giandcdalcorso11-coder/GDC-CNC-2D/documento-sessione-cnc-2d.md

# Documento di Sessione — CNC 2D Plotter

**Versione:** 115
**Ultimo aggiornamento:** 2026-11-14 15:02

## Regole di co-editing

Questo documento è scritto da **tre sessioni Claude Code in parallelo**: una sul fronte **meccanica/firmware**, una sul fronte **contenuti e serie social**, e (dal 2026-10-29) una sul fronte **stampe: i disegni e i file SVG che l'utente manda in stampa** (magneti della lavagna d'allenamento, per ora). Ogni sessione può lavorare sul proprio branch: la regola vale comunque, perché le voci si fondono. Per non perdere voci a vicenda:

1. **`git fetch` e rebase prima di scrivere, push subito dopo.** Non lasciare modifiche locali non pushate: la finestra di collisione è tutta lì.
2. **Marca la voce di storico con il fronte di lavoro**, es. `### [2026-09-26 17:48] (meccanica) …`; il fronte della terza sessione è `(stampe)`. Due sessioni diverse sono due voci diverse: la regola "una voce per sessione" non impone di fonderle.
3. **Le note dei singoli Step si appendono in fondo al proprio Step**, quindi non collidono mai finché le due sessioni lavorano su Step diversi.
4. **Se la Versione va in conflitto**, chi risolve mette `max(A, B) + 1` e tiene **entrambe** le voci, ordinate per data decrescente. Mai scartarne una.
5. Gli unici punti di contesa reali sono **le due righe di testata** e **la prima riga dopo `## Storico sessioni`**. Tutto il resto è partizionato per costruzione.

## Vision

Macchina CNC 2D per disegno/plotter, con:
- Assi X/Y motorizzati (NEMA17 modello 17HS4023 + driver A4988)
- Asse Z tramite servomotore per alzare/abbassare la penna
- Controllo firmware via ESP32 con FluidNC
- Invio G-code via Wi-Fi (WebUI di FluidNC), senza necessità di cavo USB durante il disegno
- In prospettiva, un software "stile slicer" per convertire SVG/immagini in G-code e caricarlo sulla macchina

## Pipeline

### Convenzioni valide per tutta la pipeline

**Nomi degli assi (dal 2026-10-15).** Secondo la convenzione cartesiana del
foglio, decisa dall'utente:

| Asse | Che cosa è | Sul foglio | Staffa | Motore |
|---|---|---|---|---|
| **X** | la trave del portale: ci corre sopra il carrello che porta la penna | sinistra → destra | staffa LL, 550 | **STEP D4 · DIR D26** |
| **Y** | le due rotaie di base: ci scorre sopra tutto il portale | basso → alto | staffe TT, 2 × 400 | **STEP D25 · DIR D33** |

**I pin in questa tabella sono stati corretti il 2026-10-19**, e prima di quella
data erano scambiati: vedi la nota in Step 2. I *nomi* e il loro significato
fisico non sono cambiati — la trave è sempre stata X — era sbagliato solo
l'abbinamento ai pin. Verifica a vista, se un giorno tornasse il dubbio:
**un movimento su X muove il carrello lungo la trave, non tutto il portale.**

**Attenzione leggendo il resto del documento:** tutte le voci dello storico e
tutte le note anteriori al 2026-10-15 usano la nomenclatura precedente, in cui
X e Y erano **scambiati** rispetto a questa tabella. Non sono state riscritte —
le voci passate non si toccano. Quando una nota vecchia dice "corsa X 242,475"
intende la corsa del portale sulle rotaie di base, che oggi si chiama Y.

**Nomi delle staffe (dal 2026-10-12).** **Staffa TT** = le due rotaie da 400.
**Staffa LL** = la trave del portale da 550.

**Nomi delle due applicazioni (dal 2026-10-15).** Il progetto ne ha due, con
ruoli diversi, e non si sostituiscono a vicenda:

- **GDC CNC 2D SLICER** — l'applicazione vera: la webapp dello Step 4 (`webui/`)
  più la configurazione FluidNC che la esegue (`firmware/fluidnc/`). Importa il
  disegno, genera il G-code, comanda la macchina
- **Pannello di controllo manuale GDC CNC 2D** — lo strumento di collaudo dello
  Step 1.1 (`firmware/cnc2d_dashboard/`): frecce, un giro di pignone, slider del
  servo, log, OTA. Serve a montare e diagnosticare, non a disegnare

La cartella e il file dello sketch restano `cnc2d_dashboard`: l'IDE Arduino
esige che cartella e sketch abbiano lo stesso nome e non accetta spazi, quindi
il nome esteso vive nel titolo della pagina e nei README, non nel filesystem.

**Come si provano i controlli (dal 2026-11-02).** *Un controllo va provato
rompendo il codice di proposito.* Se mutando la riga che quel controllo
dovrebbe proteggere il controllo non si accende, non è un controllo: è una
decorazione, e si scopre il giorno in cui serviva. Lo strumento è
`webui/tools/rompi.py`, che muta un sorgente per volta, ricompone la pagina,
lancia il collaudo e pretende la riga KO giusta. La regola si è precisata tre
volte, e le tre precisazioni valgono quanto la regola:

- **[2026-11-03] Anche le mutazioni invecchiano.** Quando il difetto che una
  mutazione simulava diventa il comportamento giusto, si *toglie* la mutazione
  e se ne scrive una che rompe la cosa nuova. Non si piega il controllo.
- **[2026-11-07] Una mutazione può toccare più punti.** Quando la cosa da
  rompere è difesa in due posti che devono dire la stessa cosa, romperne uno
  solo lascia il programma corretto: simula un difetto che non è un difetto.
- **[2026-11-07] Una mutazione che non può cambiare il comportamento misura
  sé stessa, non il controllo.** Due casi visti: un difetto non raggiungibile
  (si toglie la mutazione e si scrive nel codice *perché* quella riga resta
  com'è), e un banco che non può vedere la differenza — il vetro finto del
  telecomando disegna blocchi al posto delle lettere, quindi «3» e «4» sono
  identici per costruzione, e quello che lì si può guardare è la larghezza.
- **[2026-11-08] Anche un controllo può passare guardando la cosa
  sbagliata**, ed è l'altra metà della regola: una mutazione non vista
  accusa il controllo, non sempre sé stessa. Tre casi nello stesso giorno, e
  tutti e tre davano la risposta giusta **per caso**. *Il testo che compare
  due volte:* il controllo cercava «un foglio 210 × 297 mm» in un messaggio
  che scrive la misura in due frasi, quindi passava anche cancellandone una
  — si cerca la frase intera. *La scena che si appoggia a un avanzo:* il
  disegno stava sul PRIMO foglio, e il ripiego del codice rotto era proprio
  l'angolo del primo — si sposta la scena sul secondo. *La scena dove il
  difetto non può manifestarsi:* due livelli su fogli diversi, dove la
  selezione si sostituisce comunque, quindi anche il codice rotto rispondeva
  «uno» — servono due livelli dello stesso foglio. E una quarta, sull'altro
  versante: **riscrivere l'ancora di una mutazione può svuotarla**. Quando il
  codice intorno cambia, l'ancora va rimirata sullo *stesso difetto*, non
  sulla riga più somigliante.
- **[2026-11-14] Il gesto che si prova può riparare il difetto mentre lo
  prova.** Un doppio clic sono due clic, e il PRIMO cambia lo stato: cliccando
  un foglio lo si rende quello in uso, quindi al momento della mira il foglio
  in uso *era* diventato quello del disegno e i due sistemi di riferimento
  tornavano a coincidere — la mutazione che rimetteva il difetto restava non
  vista. La scena giusta vuole il foglio del disegno **misurato**, cioè fermo,
  così il clic non lo rende quello in uso. Vale per ogni gesto composto: prima
  di scrivere la scena, chiedersi che cosa cambia il primo pezzo del gesto.
- **[2026-11-14] Una mutazione va puntata sul controllo che PUÒ vederla**, e
  non sul controllo che parla della stessa cosa. Due su tre, lo stesso giorno:
  quella sul conteggio a mano dei due clic guardava la scena del foglio
  misurato, dove il `dblclick` vero arriva comunque; quella sul guardiano
  guardava una scena con un disegno solo, dove girare «al livello di sotto»
  torna sullo stesso livello. Entrambe dicevano «non vista» accusando il
  controllo, ed entrambe avevano ragione: era l'abbinamento a essere sbagliato.
  Quando una mutazione non si vede, la prima domanda non è «il controllo è
  cieco?» ma «questa scena può manifestare questo difetto?».

**Il repository GitHub si chiama `GDC-CNC-2D`** (rinominato dall'utente il
2026-10-15; GitHub non accetta spazi nei nomi e li sostituisce con trattini).
Non ha rotto nessun link: GitHub Pages non è attivo su questo repository,
l'applicazione è servita dall'ESP32 sulla rete locale, e GitHub redirige
automaticamente il vecchio URL. L'unico modo di rompere la redirezione è
creare un giorno un altro repository chiamato `CNC-2D` sullo stesso account.

### Step 1 — Bring-up alimentazione e logica ESP32

**Stato:** completato

**Obiettivo:** ESP32 funzionante e alimentabile sia da USB che da batteria, con GPIO verificati

**Decisioni progettuali:**
- Ramo alimentazione logica (5V, ESP32) separato dal ramo 24V dei motori
- **Una spina sola per tutta la macchina: 12 V / 3 A, due 7805 indipendenti.** Supera sia il ramo a 24 V sia la batteria 18650. Il mattone (DVE DSA-36W-12, 36 W) alimenta direttamente i VMOT dei due driver e, attraverso **due L7805CV separati**, il 5 V della logica e il 5 V del servo. Il punto non è il numero di regolatori: è che **i due 5 V non si possono tirare giù a vicenda**, perché ciascuno ha 7 V di margine e oltre 60 dB di reiezione. Un interruttore unico sui 12 V, a monte di tutto. Bilancio: picco ~2,15 A sui 3 A disponibili. **Alternative scartate:** un solo regolatore condiviso (è la configurazione che ha causato il brownout del servo); uno switching LM2596 (più efficiente e sarà l'upgrade, ma non ce l'aveva e due lineari separati sono elettricamente più puliti di uno switching condiviso); alimentazione separata del servo da una seconda presa, rifiutata dall'utente — una macchina si accende con una spina
- **Il 18650 e il modulo di ricarica escono dal progetto.** Hanno fatto il loro lavoro nel bring-up dei LED. Per motori e servo non reggono: il modulo dà ~1 A dichiarato con protezione che interviene prima, mentre il solo servo chiede 700 mA di spunto (1,4 A per un MG90S) e il boost ne tira 1,6 dalla cella per darne 1 in uscita
- **La breadboard resta il circuito definitivo, ma solo per i segnali.** Decisione dell'utente, con tre eccezioni concordate: i due 7805 coi loro condensatori vanno su millefori saldata (sono la parte più calda e con più corrente, e non cambieranno mai più); il ramo 12 V di potenza va su morsetti a vite (un contatto di breadboard è dato per ~1 A e lì ne passano fino a 2); la breadboard va fissata meccanicamente e i cavi ancorati con fascette. Il motivo delle eccezioni è la vibrazione: il portale accelera a 0,3 g sulla stessa tavola, e un contatto a frizione che diventa intermittente sulla linea STEP dà **passi persi**, cioè un difetto che si va a cercare nella meccanica dove non c'è
- Batteria 18650 + modulo boost/carica 5V Type-C (supporta "discharge while charging", quindi utilizzabile anche mentre è in carica)
- Interruttore SPST inserito solo sulla linea 5V+ verso il pin VIN dell'ESP32 (non sulla batteria), per non interrompere la ricarica quando la macchina è spenta
- GND comune tra guida breadboard, modulo batteria ed ESP32, verificato in continuità

**Criterio di completamento:** LED collegato a D2 lampeggia correttamente sia alimentato da USB sia da batteria+interruttore

**Note (cronologia dello step):**
- [2026-09-19] Verificati componenti hardware (batteria NASTIMA 12V, motori 17HS4023, driver A4988, alimentatore 24V riciclato da striscia LED) tramite confronto con i link Amazon e datasheet
- [2026-09-19] Test ESP32 standalone via USB-C con sketch Blink su D2 (GPIO2) e resistenza 220 ohm — riuscito
- [2026-09-19] Aggiunto modulo batteria 18650 (boost 5V + carica Type-C) e interruttore sulla linea 5V+ verso VIN — testato e funzionante
- [2026-09-26] **L'alimentatore non è più il 24 V recuperato dalla striscia LED**, ma un DVE DSA-36W-12: **12 V, 3 A, 36 W**. Supera il dato del 2026-09-19. Nota importante sulle conseguenze: a corrente impostata uguale, **la tensione di alimentazione non cambia né la coppia né la temperatura dei motori**, perché l'A4988 è un driver a corrente controllata — la tensione decide solo quanto in fretta la corrente sale, quindi conta alle alte velocità. Bilancio a 12 V con tre motori a 0,6 A: 0,28 A ciascuno, 0,85 A in totale, ~14 W su 36 disponibili (28% della corrente). L'unico punto in cui i 12 V stringono è il collegamento di due motori in serie su un solo driver: 6,0 V dei 12 se ne vanno fra caduta resistiva, induttanza e forza controelettromotrice, contro i 3,0 V di un motore per driver

#### Step 1.1 — Dashboard web di controllo e test

**Stato:** completato

**Obiettivo:** dashboard web autonoma ospitata direttamente sull'ESP32, raggiungibile dalla rete Wi-Fi di casa, con un controllo di test sul LED e configurazione Wi-Fi senza dover ricompilare/riflashare

**Decisioni progettuali:**
- Web server nativo (`WebServer.h`, incluso nel core ESP32) invece di `ESPAsyncWebServer`, per non richiedere librerie esterne da installare
- Credenziali Wi-Fi salvate in NVS (`Preferences`) e configurabili da una tab dedicata nella dashboard; fallback automatico ad Access Point di emergenza (`CNC-2D-Setup`) se la connessione alla rete salvata fallisce, così la pagina resta sempre raggiungibile per correggerle
- mDNS (`cnc2d.local`) per raggiungere la dashboard senza dipendere dall'IP assegnato dal router
- Frecce direzionali presenti in UI ma non collegate a nessuna funzione, in previsione del controllo assi X/Y (Step 2)
- Tab "Codice" lasciata come placeholder: in futuro servirà per caricare direttamente un file G-code dal browser (non per compilare sketch — l'ESP32 non può compilare C++ da solo), da attivare dopo aver validato motori (Step 2) e servo/pen-lift (Step 3)

**Criterio di completamento:** dashboard raggiungibile da browser sulla rete di casa, pulsante centrale che accende/spegne il LED su D2 in tempo reale, funzionamento verificato sia con ESP32 alimentato da USB sia da batteria+interruttore

**Note (cronologia dello step):**
- [2026-09-19] Implementato sketch `firmware/cnc2d_dashboard/cnc2d_dashboard.ino` con web server, pagina a 3 tab (Controllo, Wi-Fi, Codice), salvataggio credenziali Wi-Fi su NVS e fallback ad AP di emergenza
- [2026-09-19] Bug: errore di compilazione "unterminated raw string" — causato da copia-incolla manuale del codice in un nuovo sketch anziché apertura diretta del file `.ino`, con probabile perdita dell'ultima riga di chiusura della stringa raw; risolto scaricando il file raw direttamente da GitHub
- [2026-09-19] Test completo riuscito: provisioning Wi-Fi di casa dalla tab dedicata, dashboard raggiungibile su `http://cnc2d.local`, LED su D2 controllato correttamente sia da alimentazione USB sia da batteria 18650+interruttore
- [2026-09-20] Aggiunti alla dashboard: 2 nuovi LED di stato (verde su D18, giallo su D19) con pulsanti dedicati Rosso/Giallo/Verde sotto le frecce (il pulsante centrale del joystick è stato disabilitato, non usa più il LED); supporto ArduinoOTA per aggiornare il firmware via Wi-Fi dopo il primo upload USB; tab "Log" che mostra in tempo reale gli stessi messaggi del Serial Monitor (utile perché il Serial Monitor via USB non è più disponibile quando si aggiorna via OTA)
- [2026-09-20] Frecce sinistra/destra collegate al motore X (STEP/DIR/ENABLE): click singolo = un passo, pressione prolungata = rotazione continua non bloccante; aggiunti pulsanti "Giro completo ←/→" (200 passi) per test rapido — dettagli del cablaggio e del debug nello Step 2
- [2026-09-20] Rifattorizzato il motore della dashboard: il movimento non è più eseguito dentro l'handler HTTP (che bloccava per 3 secondi affamando `server.handleClient()` e l'OTA) ma da una coda di passi servita in `loop()`, prima e dopo `handleClient()`; DIR impostato una sola volta a inizio movimento con tempo di assestamento invece che a ogni impulso; aggiunta rampa di accelerazione opzionale sui primi 40 passi
- [2026-09-20] Aggiunta tab "Motore": intervallo tra i passi regolabile da browser (300 µs – 200 ms), numero di passi, rampa on/off, abilitazione diretta del driver e sezione "Test pin" che forza STEP/DIR/EN a un livello fisso per poterli misurare col multimetro. Ogni movimento registra nel log i passi effettivamente emessi, così si distingue subito un problema firmware da uno elettrico
- [2026-10-12] **Bug: il servo non si muove e la scheda si spegne**
  **Sintomo:** a ogni comando del servo il LED rosso dell'ESP32 e quello del modulo di ricarica si spegnevano per un istante; il servo non si muoveva affatto. I LED comandati dalla dashboard funzionavano, quindi scheda e rete erano sane. Con l'ESP32 spostato su alimentatore da muro il sintomo cambiava: la scheda restava accesa, il servo **vibrava** e i LED del modulo batteria lampeggiavano in continuazione
  **Causa:** il servo e la logica condividevano il 5 V del modulo 18650. Lo spunto del servo (700 mA, 1,4 A per un MG90S) faceva collassare quel ramo; l'ESP32 andava in brownout e, resettandosi, smetteva di generare il PWM — quindi il servo non arrivava mai in posizione. Nella seconda configurazione il collasso restava sul solo ramo servo e si vedeva per quello che era: **protezione che scatta e riparte in ciclo** (*hiccup mode*), con il servo alimentato a singhiozzo
  **Fix applicato:** due L7805CV separati dai 12 V, uno per la logica e uno per il servo. **Confermato dall'utente: tutti i test passano.** Il percorso diagnostico è costato due giorni perché l'alimentazione era stata classificata come causa poco probabile (vedi voce di storico del 2026-10-13)
- [2026-10-13] **Mancano i condensatori ceramici e per ora si va avanti così.** Montati solo gli elettrolitici. Funziona, ma l'elettrolitico alle alte frequenze non c'è: senza un ceramico vicino ai piedini il 7805 può oscillare nei MHz, e il sintomo non è un guasto netto — è riscaldamento inspiegabile, rumore sul 5 V, qualche reset a caso. Da aggiungere: **100 nF su IN e su OUT di ogni regolatore**, più uno in parallelo ai 100 µF sul VMOT di ogni driver

### Step 2 — Bring-up driver A4988 e motori (X/Y)

**Stato:** completato

**Obiettivo:** un motore NEMA17 pilotato correttamente da un driver A4988 tramite ESP32, poi due motori in parallelo

**Decisioni progettuali:**
- Vref target ~0.5-0.56V per 0.7A per fase (corrente nominale reale del 17HS4023, non 1.0A come inizialmente indicato da una fonte esterna consultata)
- Alimentazione di potenza: alimentatore switching DC **12V/3A** (DVE DSA-36W-12). Sostituisce l'alimentatore riciclato dalla striscia LED RGB, che si è rivelato inutilizzabile (vedi bug sotto). 12V sono ampiamente sufficienti per il plotter e fanno scaldare molto meno il driver rispetto a 24V
- **Condensatore elettrolitico 100 µF / 50 V obbligatorio tra VMOT e GND del driver**, il più vicino possibile al modulo: senza, i picchi induttivi generati dalle bobine a ogni commutazione distruggono l'A4988 (è la causa della perdita dei primi due moduli)
- Collaudo di accettazione di ogni nuovo modulo A4988 prima di alimentarlo: continuità tra STEP, DIR, EN e GND deve essere **muta** su tutti e tre. Venti secondi che smascherano subito un ingresso in corto
- Pin driver: STEP su D4, DIR su D26 (era D16), ENABLE su D27 (era D17) — spostati da D16/D17 per un problema di instabilità non ancora confermato con certezza (vedi bug nello storico sessioni)
- Bobine motore identificate via continuità: bobina 1 = fili rosso+blu, bobina 2 = fili nero+verde; mappate sul driver rispettivamente su 1A/1B e 2A/2B (l'assegnazione "1"/"2" rispetto ai colori è invertita rispetto al primo tentativo ma elettricamente corretta, non causa malfunzionamenti — cambia solo il verso di rotazione)
- Alimentatore 24V riciclato da striscia LED RGB: verificato con multimetro che il filo bianco è il vero 24V+ e il filo rosso è il GND (contro-intuitivo rispetto al colore); i fili blu e verde sono ridondanti (stesso nodo del bianco) e isolati, non utilizzati
- Scheda "Nano Terminal Adapter" (pensata per Arduino Nano) riadattata come morsettiera generica per i collegamenti di potenza (24V e fili motore), sfruttando il fatto che è puramente passiva (screw terminal + header pin sullo stesso nodo) — alternativa scartata: morsetti a vite dedicati, non disponibili al momento
- Velocità di step di partenza volutamente prudente (senza rampa di accelerazione) per il primo test, da aumentare più avanti con una rampa vera

**Criterio di completamento:** rotazione controllata e affidabile di entrambi i motori tramite comandi step/dir dall'ESP32

**Note (cronologia dello step):**
- [2026-09-20] Cablaggio completo del driver A4988 (logica + potenza) e del motore X, con verifica pin ENABLE tramite conteggio sull'etichettatura reale del modulo (foto)
- [2026-09-20] Bug: primo driver A4988 non muoveva il motore
  Sintomo: nessuna reazione del motore a "Giro completo" né alle frecce, solo un leggero ronzio; bloccato con forza al tatto (normale per uno stepper abilitato, non diagnostico da solo)
  Causa: sospetto danneggiamento del chip driver (probabile durante le prove di cablaggio in tensione) — tutti i controlli di continuità su STEP/DIR/ENABLE/VDD/RESET-SLEEP/VMOT/GND risultati corretti
  Fix applicato: sostituito con un secondo modulo A4988 di scorta — con il nuovo modulo il motore ha iniziato a muoversi (parzialmente), confermando che il primo era guasto
- [2026-09-20] Bug: Vref bloccato a 0,20V sul secondo modulo, il potenziometro sembrava non avere effetto
  Sintomo: valore instabile e comunque fermo a 0,20V (target 0,50–0,56V) girando il trimmer
  Causa: misura instabile a causa del motore collegato durante la prova (rumore/carico sul riferimento)
  Fix applicato: misurato Vref a motore scollegato — tarato correttamente a 0,55V
- [2026-09-20] Bug: il motore gira solo con passi singoli, non con pressione prolungata né con "Giro completo"
  Sintomo: ogni click singolo produce un piccolo movimento pulito senza perdere passi; in sequenza continua il motore non si muove (con solo un leggero ronzio) oppure avanza a scatti di circa 1/5 di giro senza completare la rotazione
  Causa: individuata con un test del "wiggle" — muovendo il filo che collega ENABLE (D17) durante il funzionamento, il motore si mette a girare; il problema persiste anche sostituendo il filo con uno nuovo o cambiando i fori della breadboard, e la continuità elettrica su quel filo risulta comunque corretta a riposo. Causa non ancora confermata con certezza: si sospetta un comportamento specifico dei pin GPIO16/GPIO17 (usati per DIR/ENABLE), che su alcune varianti di modulo ESP32 con PSRAM (WROVER) sono riservati e non utilizzabili come GPIO liberi — dalla foto del modulo (etichettato solo "ESP-32", nessuna scritta "WROVER" visibile) non è stato possibile confermare con certezza se questo sia il caso
  Fix applicato: non ancora confermato — spostati DIR (D16→D26) ed ENABLE (D17→D27) su pin sicuramente liberi da questo vincolo su qualunque variante ESP32; il test dopo lo spostamento non è ancora stato riportato a fine sessione — **da riprendere nella prossima sessione**
- [2026-09-20] Il bug sopra è stato **risolto**: lo spostamento su D26/D27 non c'entrava nulla e l'ipotesi PSRAM/WROVER era sbagliata. La causa reale era l'alimentatore di potenza (vedi bug successivo). I pin sono stati comunque lasciati su D26/D27, che vanno benissimo
- [2026-09-20] Bug: alimentatore di potenza inutilizzabile — **causa radice di tutta la sessione**
  Sintomo: tensione su VMOT del driver oscillante tra 1 V e 20 V invece che ferma; coppia di tenuta debolissima (l'albero si girava con due dita, mentre a 0,69 A/fase dovrebbe essere immobile); passi singoli occasionalmente corretti, rotazione continua mai
  Causa: l'alimentatore riciclato è un **controller per strisce LED RGB**, non un alimentatore DC. Dei 4 fili, il bianco è il +24V comune e rosso/verde/blu sono le tre uscite di canale, cioè MOSFET pilotati in PWM. Usare il filo rosso come massa significava alimentare il driver attraverso un interruttore che si apriva e chiudeva continuamente. Verificato misurando sotto carico su tutti e tre i canali: instabili tutti
  Fix applicato: sostituito con un alimentatore switching DC 12V/3A, misurato stabile a 12,2 V. **Confermato**
- [2026-09-20] Bug: secondo driver A4988 con ingresso STEP in corto verso massa
  Sintomo: dopo aver risolto l'alimentazione, l'albero era finalmente duro e il test ENABLE rispondeva, ma nessun comando produceva movimento e il motore restava in silenzio assoluto. Misurando il pin STEP sul driver si leggeva sempre 0 V pur avendo continuità verso D4
  Causa: individuata dividendo il nodo STEP in due metà e misurandole separatamente — lato ESP32 muto (GPIO4 sano), lato driver in corto a 0,2 Ω, e sfilando il modulo la breadboard tornava muta. L'ingresso STEP era quindi in corto **dentro il chip**, inchiodato a 0 V. Danno provocato dallo stesso alimentatore RGB
  Fix applicato: sostituito con il terzo modulo A4988, collaudato prima dell'installazione con il test di continuità STEP/DIR/EN verso GND. **Confermato**
- [2026-09-20] Motore X funzionante: Vref tarato a 0,54 V sul nuovo modulo, test ENABLE corretto (albero bloccato con spunta, libero senza) e movimento comandato dalla dashboard riuscito
- [2026-09-21] Sweep di velocità completato su tutta la gamma disponibile fino a 500 passi/s: nessuna banda di risonanza, nessun microstepping necessario per la stabilità
- [2026-09-21] Secondo asse cablato: driver Y con STEP su D25 e DIR su D33, ENABLE condiviso con X su D27. Al primo avvio il motore Y girava da solo senza controllo — causa: D25/D33 non erano ancora configurati come uscite nel firmware e, restando ingressi flottanti, raccoglievano rumore che il driver interpretava come impulsi di STEP. Risolto portando i pin STEP a livello basso come prima istruzione di `setup()`
- [2026-09-21] **Step chiuso:** entrambi gli assi pilotati correttamente, singolarmente e in contemporanea
- [2026-10-12] **Microstep confermati 1/16 da un dato dell'utente**, non più per ipotesi: MS1, MS2 e MS3 sono ponticellati insieme e portati a VCC, e sulla tabella dell'A4988 tutti e tre alti = sedicesimo di passo. Quindi **33,953 passi/mm** è il numero vero, e il default della dashboard era già giusto
- [2026-10-12] **Dashboard riscritta per la trasmissione reale.** Tre cambiamenti strutturali: (a) i passi non escono più da `loop()` ma da un **timer hardware a 20 kHz** con accumulatore a virgola fissa — con i microstep attivi la frequenza sale a qualche migliaio di impulsi al secondo e `server.handleClient()` può bloccare il loop per centinaia di millisecondi, cioè buchi nel treno di impulsi; (b) l'interfaccia parla in **millimetri** (velocità 1÷100 mm/s, distanza in mm) invece che in passi, e il pulsante "360°" diventa "1 giro" = 94,2478 mm calcolati dai microstep impostati; (c) due pulsanti eseguono **quadrato da 40 mm e cerchio R20** come macchina a stati non bloccante, movimenti di penna compresi, replicando i file in `gcode/test/`. Aggiunto anche uno slider dell'angolo servo dal vivo nella tab Controllo
- [2026-10-12] **Bug: lo sketch non compila, "variable or field 'setDir' declared void"**
  **Sintomo:** errori a catena su tutte le funzioni che prendono `Motor&` o `DemoStep&`, indicando righe di definizione scritte correttamente e con la struct dichiarata cinquanta righe più su
  **Causa:** l'IDE Arduino genera da solo i prototipi di tutte le funzioni e li inserisce **subito prima della prima funzione del file**, con una direttiva `#line` che fa riportare l'errore alla riga della definizione originale. Spostando le costanti della trasmissione in cima, la prima funzione era diventata `stepsPerMm()`, che sta sopra `struct Motor`: i prototipi generati nominavano un tipo non ancora dichiarato. Nelle versioni precedenti funzionava **per caso**, perché la prima funzione era `logMsg()`, che sta sotto la struct
  **Fix applicato:** `Motor` e `DemoStep` spostate in una sezione "Tipi" in cima al file, prima di qualunque funzione, col commento che spiega perché non stanno vicino al codice che le usa. **Confermato: compila e gira.** Il controllo di sintassi fatto qui con g++ non poteva vedere l'errore per costruzione, perché g++ non inietta prototipi — il controllo è stato esteso emulando quel passaggio, e validato al contrario facendogli riprodurre l'errore sulla versione vecchia
- [2026-10-12] **Rampa del servo in firmware** (`servoGoTo` + `serviceServo`): invece di saltare all'angolo richiesto il servo ci arriva di N gradi ogni 10 ms, con N impostabile da 0 (salto secco) a 10. Serve contro il brownout — un servo che vede un errore grande parte alla corrente di stallo — ma **non sostituisce l'alimentazione**: abbassa il picco, non il consumo totale. Come diagnosi era decisiva, come cura no, ed è andata così. Le prove d'insieme ora aspettano che la penna sia **arrivata** invece di un ritardo fisso
- [2026-10-19] **BUG MIO: i pin dei due assi erano scambiati dal 2026-10-15, e l'ho scoperto solo perché l'utente ha provato le frecce.**

  **Sintomo:** con la pulsantiera della dashboard, le frecce destra/sinistra muovevano la testina **in alto e in basso** sul foglio, e le frecce su/giù la muovevano **a destra e sinistra**. La mappatura tastiera→asse è giusta (←→ chiamano `x`, ↑↓ chiamano `y`): sbagliato era quale motore fosse `x`.
  **Causa:** il 2026-10-15, applicando il rinominamento degli assi chiesto dall'utente, ho scambiato i quattro `#define` dei pin. Ma andavano sistemati i **nomi**, non l'abbinamento nome↔pin, che era già giusto. All'origine c'è una mia descrizione sbagliata: avevo scritto che "il driver su GPIO 4/26 è quello del portale e quello su 25/33 è quello della trave", quando è il contrario, e poi ho "corretto" i pin per farli combaciare con la descrizione sbagliata. L'utente me l'aveva anche detto, nello stesso messaggio del 2026-10-15: *"non è necessario che cambi nulla nel firmware vecchio, le 4 frecce spostano i carrelli nella direzione corretta"*. Non ne ho tenuto conto.
  **Fix applicato:** `STEP_X_PIN`/`DIR_X_PIN` tornano a D4/D26 e `STEP_Y_PIN`/`DIR_Y_PIN` a D25/D33, nella dashboard, in `cnc2d-config.yaml` e nelle etichette dell'interfaccia. Corretta anche la tabella delle convenzioni in cima a questo documento. **Verificato che compila, non ancora provato sulla macchina**: la conferma è che la freccia destra muova il carrello lungo la trave.
  **Nota sul tempismo:** le chiavi NVS (`invX`, `feedX`, `rampX`, `mmRevX`…) sono legate al **nome** dell'asse, quindi questo scambio le ri-punta sull'altro motore. Capita nel momento più economico possibile — niente è ancora tarato e i due assi hanno gli stessi valori di default — ma dopo il flash vanno ricontrollate le spunte "inverti direzione" e le velocità per asse.

- [2026-10-19] **La dashboard misura: posizione per asse e taratura del rapporto per asse.** Due aggiunte, chieste dall'utente per poter fare le misure degli assi **oggi**, senza aspettare il modulo penna — osservazione sua e giusta: i pignoni sulle cremagliere sono definitivi, quindi corsa e rapporto non cambiano più. (a) **Posizione**: `posSteps` per asse, contato nell'ISR col segno della direzione *logica* (quella delle frecce, non del livello del pin DIR, così la freccia destra fa salire il numero anche con `invert` attivo), tenuto in passi e non in millimetri perché un accumulatore in float perderebbe risoluzione dopo qualche migliaio di passi. Mostrato in mm in un riquadro nella tab Controllo con tre pulsanti di azzeramento. Il segno si imposta **dentro la sezione critica** di `startMoveSteps` e non in `setDir()`: su un asse in rotazione continua, fra `setDir()` e la sezione critica l'ISR conterebbe qualche passo col segno vecchio. (b) **Taratura**: `mmPerRev` diventa un campo per asse, salvato in NVS (`mmRevX`/`mmRevY`), con una rotta che lo ricava da comandato/misurato. Rifiuta risultati fuori da 60÷130 mm/giro, perché a quel punto non è un ritiro di stampa ma un errore di battitura, e azzera la posizione dopo il salvataggio, perché contava in passi col rapporto vecchio
- [2026-10-19] **`stepsPerMm()` non esiste più come valore globale**: è `stepsPerMm(m)`, una per asse. Chiudeva un debito aperto il 2026-10-15 ("due passi/mm, uno per asse, non uno globale"), e toccava sei punti del codice — fra cui `demoGoTo`, che ora converte i due assi separatamente, altrimenti il quadrato di prova uscirebbe rettangolo appena i due rapporti divergono. Verificato con la compilazione sintattica (il compilatore trova tutti i siti di chiamata per costruzione: zero errori = zero siti dimenticati). **Non provato sulla macchina**
- [2026-10-19] **La taratura del rapporto si fa disegnando, non misurando il movimento del carrello.** Obiezione dell'utente, ed è fondata: inseguire un carrello col calibro contro un riferimento improvvisato dà due o tre decimi di incertezza, cioè proprio l'ordine di grandezza da misurare, mentre una linea disegnata sta ferma, è piana e il calibro ci appoggia le ganasce come vuole lui. *Annulla l'ordine "prima il rapporto, poi la corsa" scritto poche ore prima*: le corse si fanno col DRO adesso, il rapporto si fa col modulo penna montato
- [2026-10-19] **Perché serve comunque un metro esterno, e il DRO non basta mai.** `corsa letta = passi / 33,953` e `passi = denti percorsi × 20`, quindi `corsa letta = denti percorsi × 4,71239` **sempre**, qualunque sia il passo vero della cremagliera. Il ritiro di stampa si cancella per costruzione: la macchina conta denti e li converte col passo nominale. Nessuna misura fatta *dentro* la macchina può rivelare l'errore di scala
- [2026-10-19] **Il metodo per cancellare la larghezza del tratto:** si disegnano due linee parallele a interasse comandato 100 mm (che sta in un calibro da 150), si misura **esterno-esterno** `E` e **interno-interno** `I`, e l'interasse vero è `(E + I) / 2` — la larghezza del pennarello si elide esattamente perché una lettura la somma e l'altra la sottrae. A ±0,05 mm di lettura su 100 mm comandati l'incertezza è lo 0,05%
- [2026-10-19] **Alternativa statica, se servisse un numero prima della penna:** `mm per giro = 20 × passo della cremagliera`, **esattamente** — ogni ingranamento avanza di un passo di cremagliera e il ritiro del pignone non c'entra. Si misura il passo da fermo col metodo delle due spine già scritto in `misure/primo-asse.md`: su 30 passi (141 mm) l'incertezza è lo 0,035%. Limite: la cremagliera Y è in due pezzi giuntati, quindi la misura dà il passo *locale* — che per i passi/mm è il numero giusto, perché la giunzione aggiunge uno scalino di posizione e non un errore di scala
- [2026-10-13] **I motori rallentano mentre si muove il servo, e non è un problema.** Lo stack Wi-Fi maschera le interruzioni per brevi istanti durante il traffico HTTP, quindi qualche tick del timer salta. Ma il contatore dei passi scala **solo quando un impulso esce davvero**: un tick saltato allunga il tempo, non toglie un passo. **Costa tempo, non posizione** — e quindi non invalida la taratura dei passi/mm, che si misura in distanza. Sparisce comunque da sé: nella macchina vera la penna si muove solo a carrelli fermi, ed è il G-code a imporlo

### Step 3 — Configurazione FluidNC

**Stato:** **completato** (riconciliato il 2026-11-08). La macchina esegue e disegna, anche a lungo: versi dei due assi corretti, quote Z negative verificate, origine manuale rodata, programmi caricati e lanciati. Il criterio — quadrato e cerchio col movimento coordinato dei due assi — è passato da settimane. Le due cose che tenevano aperto questo step non ci sono più: il **blocco delle stampe lunghe** è curato dallo streaming riga per riga del SLICER sul WebSocket (dal 2026-10-25; la vecchia regola «i lunghi si lanciano dalla seriale» era un rimedio, e non serve più), e **`max_rate_mm_per_min`**, segnato il 2026-10-19 come «da rivedere al rialzo» perché valeva 2000, nel `config.yaml` è **8000**. `soft_limits: false` non è una dimenticanza ma la conseguenza dell'azzeramento manuale (nessun finecorsa), scritta in `firmware/fluidnc/README.md`: la protezione dall'uscita dall'area è a carico dell'interfaccia

**Obiettivo:** FluidNC installato e configurato come firmware definitivo della macchina, con movimento coordinato X/Y e pen-lift sul servo

**Decisioni progettuali:**
- **FluidNC è il firmware definitivo**, lo sketch `cnc2d_dashboard` retrocede a strumento di collaudo hardware. Motivo: interpolazione coordinata, pianificazione dell'accelerazione fra segmenti e interpretazione del G-code sono settimane di lavoro già risolte e collaudate su migliaia di macchine
- **Pen-lift come asse Z vero** tramite il tipo motore `rc_servo`, non tramite l'uscita PWM dello spindle con M3/M5. Supera la decisione originale dello Step 3: trattare la penna come un asse permette al generatore di G-code di gestirla come un movimento qualsiasi
- **Microstepping 1/16** (MS1/MS2/MS3 a VDD su entrambi i driver): a passo intero la risoluzione sarebbe di circa 0,2 mm per passo, uno scalino visibile a occhio sul tratto. A 1/16 si scende attorno ai 0,02 mm. Il valore esatto di `steps_per_mm` dipende dal pignone scelto (vedi Step 5) e va comunque tarato sulla macchina
- **Nessun azzeramento automatico**: niente finecorsa di riferimento, l'origine si imposta a mano con `G92 X0 Y0`. Conseguenza: `soft_limits` resta disattivo, perché FluidNC lo consente solo su macchina azzerata, e la protezione contro le uscite dall'area passa all'interfaccia web
- **Driver mai disabilitati** (`idle_ms: 255`): con l'azzeramento manuale, un asse che si ammorbidisce e viene spostato a mano farebbe perdere la posizione senza che nessuno se ne accorga. Annulla l'idea, discussa e poi scartata, di un auto-spegnimento dei driver dopo inattività
- **Due pulsanti di emergenza** su D13/D14 nell'angolo in basso a sinistra, configurati come finecorsa rigidi: in teoria non vengono premuti mai, se succede FluidNC ferma tutto e va in allarme. Cablati normalmente aperti verso massa — accettabile per un backstop, da rivedere con microswitch veri
- **LED di stato come `user_outputs`**, comandati dall'interfaccia web con M62/M63: verde = tutto bene, giallo = attenzione (non calibrato, posizione non attendibile, in pausa), rosso = errore
- **Azzeramento sui due pulsanti d'angolo, `soft_limits` attivi e `must_home` vero.** Supera la decisione "nessun azzeramento automatico" presa il 2026-09-21. I due pulsanti su D13/D14 esistono già e sono cablati: aggiungendo un blocco `homing` per asse diventano **anche** riferimenti di azzeramento, e questo sblocca `soft_limits`, cioè il **rifiuto dei movimenti fuori area nel pianificatore** invece che nell'interfaccia. Costo in componenti: zero, è una modifica al YAML. Il motivo per cui conta: un limite che vive solo nella UI non è una protezione ma un suggerimento — un comando battuto a mano nella console di FluidNC, un file malformato o un bug nel generatore lo scavalcano. La ripetibilità di un pulsante a cupola è scarsa (±1 mm), ma per la **sicurezza** basta che sia conservativo, non preciso: la dispersione sposta il disegno sul foglio, il margine copre l'incidente. Microswitch veri (±0,03) restano l'upgrade
- **I limiti stanno in due posti diversi perché sono due cose diverse.** Le **corse meccaniche** sono proprietà della macchina e vivono in FluidNC (`max_travel_mm`); il **foglio** è proprietà del lavoro e vive nell'app (`paper` + `sheetOrigin`); il **margine di sicurezza** è un numero proprio, esplicito ed editabile, e il limite effettivo (`corsa − margine`) è calcolato e mostrato, mai salvato. Applicazione della regola già scritta in `webui/js/settings.js`: "due posti in cui scrivere lo stesso numero sono due posti che prima o poi si contraddicono". Azzerando in un angolo basta **un numero per asse** invece di min e max, che è anche la convenzione di FluidNC
- **Il riferimento va sul metallo, il margine nel software.** Parcheggiare "a circa 2÷3 cm dal fondo" a occhio fa diventare l'errore di parcheggio un errore di margine: si crede di essere a 25 mm e si è a 12. Si va in battuta su qualcosa di fisico (errore zero per definizione) e il margine lo sottrae il firmware. Corollario: **i limiti sopravvivono al riavvio, il riferimento no** — un passo-passo senza encoder non può sapere se qualcuno ha spostato il carrello mentre era spento. Serve uno stato `NON AZZERATA` in cui sono permessi solo jog relativi a passo limitato, e nessun movimento assoluto né esecuzione di file

**Criterio di completamento:** la macchina disegna un quadrato e un cerchio con movimento coordinato dei due assi, verificabile a vista sui motori anche senza struttura montata

**Note (cronologia dello step):**
- [2026-09-21] Scritta la configurazione di partenza `firmware/fluidnc/cnc2d-config.yaml` con la mappa dei pin già validata. Restano da tarare `steps_per_mm`, `max_travel_mm` e gli estremi dell'impulso del servo, tutti dipendenti dalla meccanica
- [2026-09-21] Installazione FluidNC avviata dal web installer (`installer.fluidnc.com`, richiede Chrome o Edge perché usa WebSerial). Scelte: versione **v4.1.0** (ultima non pre-release), processore **esp32** (DevKit WROOM-32 a 30 pin), variante **wifi** (l'unica con WebUI), tipo **fresh-install**, interfaccia **WebUI-2** — scelta fra le tre disponibili perché è quella su cui è costruita la documentazione del wiki, e se ne può installare una sola
- [2026-09-21] Da verificare alla prima accensione: la configurazione è stata scritta sullo schema FluidNC 3.x, mentre la versione installata è la 4.1.0. Eventuali nomi di campo cambiati vengono segnalati dal validatore all'avvio
- [2026-09-21] **Lo schema 4.1.0 ha accettato la configurazione scritta sul 3.x senza una sola modifica.** Il dubbio segnalato nella nota precedente è risolto: nessun nome di campo è cambiato fra le due versioni per i costrutti che usiamo
- [2026-09-21] Attivazione della configurazione: il pulsante "Seleziona configurazione" del browser dei file non ha avuto effetto, si è dovuto usare `$Config/Filename=cnc2d-config.yaml` dal terminale. Il comando di modifica a runtime `$/axes/shared_stepper_disable_pin=...` non restituisce nulla sulla 4.1.0, quindi le correzioni alla configurazione si applicano ricaricando il file e riavviando con `$Bye`
- [2026-09-21] WiFi configurato in modalità STA, hostname `cnc2d`, raggiungibile su `http://cnc2d.local` e `http://192.168.1.11`. Da qui in avanti l'installer non serve più: si lavora dalla WebUI-2
- [2026-09-21] LED verificati funzionanti con `M62 P0/P1/P2` e `M63 P0/P1/P2` (P0 verde gpio.18, P1 giallo gpio.19, P2 rosso gpio.2). La variante immediata M64/M65 non è stata necessaria. Il canale per legare le spie allo stato della macchina è quindi disponibile
- [2026-09-21] Microstepping 1/16 verificato su entrambi gli assi: 40 mm comandati (3200 microscatti con `steps_per_mm: 80`) producono un giro esatto dell'albero. A passo intero ne avrebbero prodotti sedici, quindi il test è inequivocabile a occhio. Ponticelli realizzati a catena RST→MS3→MS2→MS1, sfruttando il fatto che RST è già a VDD ed è adiacente a MS3: tre ponticelli cortissimi per driver, nessun filo lungo
- [2026-09-21] **Step completato**: quadrato da 40 mm e cerchio da raggio 20 mm eseguiti correttamente, con ritorno alle coordinate di partenza. Il criterio di completamento è soddisfatto
- [2026-10-06] **`steps_per_mm` nella configurazione è sbagliato di 2,36×, ed è il primo numero da correggere.** `cnc2d-config.yaml` porta ancora `steps_per_mm: 80` con il commento "vale per cinghia GT2 + puleggia 20 denti". La macchina non ha più cinghie: con pignone e cremagliera m1.5 z=20 il giro vale `π · m · z = 94,2478` mm (= 20 denti × passo 4,7124), e con 200 passi × 16 microstep fa **33,953 passi/mm**. Finché quel numero è sbagliato ogni limite inserito è sbagliato dello stesso fattore — si scrive "300 mm di corsa" e la macchina ne percorre 707 — e nessun pannello può intercettarlo, perché il pannello parla in mm e il mm è falso. Il criterio di completamento dello step resta soddisfatto (quadrato e cerchio verificati a vista sui motori), ma le quote erano 2,36× quelle comandate
- [2026-10-19] **`steps_per_mm` corretto nel file: 80 → 33,953.** Il bug era registrato il 2026-10-06 e il numero giusto era già scritto in quella nota; non è stato trovato ora, è stato finalmente applicato. Nel frattempo la dashboard usava il valore giusto (`stepsPerMm()` lo calcola da `MM_PER_REV = π·1,5·20`), quindi le prove di movimento riuscite non lo hanno mai esercitato: il numero sbagliato stava solo nel ramo FluidNC, che non è mai partito. Aggiunto nel file il perché, le varianti per 1/8 e 1/32, e il fatto che dopo la taratura X e Y **non** saranno uguali
- [2026-10-19] **I finecorsa non sono montati, e non si montano per ora** (informazione dell'utente). Questo **rimanda la decisione sull'azzeramento** presa in precedenza: niente blocco `homing:`, `must_home` resta falso, `soft_limits` resta falso. **Discrepanza da segnalare:** la nota del 2026-09-21 diceva "due pulsanti di emergenza su D13/D14 ... cablati normalmente aperti verso massa", quindi il documento li dava per esistenti. Non lo sono. La nota vecchia resta come è, questa la corregge
- [2026-10-19] **Tolti dal file i due `limit_neg_pin` e messo `hard_limits: false`.** Dichiarare un ingresso di finecorsa su un pin senza niente attaccato è **peggio** che non dichiararlo: il pull-up interno dell'ESP32 è da decine di kΩ, quindi il pin resta in alta impedenza e un disturbo captato dai cavi dei motori può farlo leggere come premuto. Sintomo che si sarebbe visto: allarme e stop a metà disegno, senza causa apparente e non riproducibile. Le righe sono commentate nel file, con scritto cosa riattivare il giorno che i microswitch arrivano
- [2026-10-19] **CORSE DEFINITIVE, stabilite dall'utente: X 257,532 e Y 243,041.** Lo scarto di 5 mm fra le due tornate su Y non era imbardata del portale: l'utente era stato **volutamente più conservativo** nella seconda. L'ipotesi dell'imbardata che avevo avanzato è quindi da ritirare — resta un'ipotesi aperta per il test delle diagonali, ma qui non c'entrava. Sono **misure di estremo**, prese per sapere dove non andare, e l'uso previsto sta ben dentro con margini abbondanti: non vanno ritoccate quando il rapporto sarà tarato
- [2026-10-19] **Controprova geometrica delle corse, e torna.** La previsione del 2026-09-26, calcolata dai denti delle cremagliere per il passo nominale, dava 256,613 per il carrello sulla trave e 242,475 per il portale sulle rotaie. Misurate: 257,532 e 243,041, cioè **+0,36% e +0,23%**. Due strade indipendenti che convergono entro quattro decimi di percento
- [2026-10-19] **L'A4 resta fuori, e l'utente conferma che non è un requisito** ("lavoreremo con dei margini abbondanti"). Conferma la decisione del 2026-09-26. Con 257,5 × 243,0 mancano 54 mm su Y per l'A4 verticale e 39,5 su X per l'orizzontale; l'A5 ci sta comodo in entrambi gli orientamenti anche con 5 mm di margine per lato (area utile 247,5 × 233,0). **La macchina è una A5**, e i preset del foglio vanno progettati così
- [2026-10-19] **Corse rimisurate dopo la correzione dei pin, e la ripetibilità dei due assi è molto diversa.** Seconda tornata: **X 257,532** e **Y 243,041**. Contro la prima: X scarta di **−1,090 mm (−0,42%, 37 passi)**, Y di **−5,007 mm (−2,02%, 170 passi)**. Entrambe più corte della prima volta, il che è il verso atteso: il contatore conta i passi **comandati**, quindi spingere contro il fine corsa gonfia il numero (il motore slitta, il contatore no), e la prima tornata era quella esplorativa. Si tengono quindi le **minori**, che sono anche le conservative: sovrastimare una corsa è l'errore pericoloso. **Ma il 2% su Y resta troppo**, e c'è un'ipotesi specifica: Y è il portale su **due rotaie con un motore solo da un lato**, quindi può imbardare, e il punto in cui "arriva in fondo" dipende da quanto è storto quando ci arriva. X, che è un carrello su una trave sola, non ha niente da storcere — ed è l'asse che ripete entro il millimetro. Se l'ipotesi regge, è lo stesso difetto che si misurerà col test delle due diagonali
- [2026-10-19] **CONSEGUENZA DA SAPERE SUBITO: l'A4 non ci sta, in nessun orientamento.** Con 257,5 × 243,0 di corsa: A4 verticale (210 × 297) manca di **54 mm su Y**, A4 orizzontale (297 × 210) manca di **39,5 mm su X**. **L'A5 ci sta comodo in entrambi gli orientamenti**, anche togliendo 5 mm di margine per lato (area utile 247,5 × 233,0). Dove sarebbe l'eventuale recupero: X consuma **292,5 mm** di una trave da 550, Y solo **157 mm** di rotaie da 400 — quindi i 39,5 mm che servono all'A4 orizzontale andrebbero cercati sull'asse X, guardando cosa occupa quei 292 mm. Da decidere se vale la pena: l'alternativa è prendere atto che la macchina è una A5, e progettare la tab Impostazioni e i preset del foglio di conseguenza
- [2026-10-19] **PRIME CORSE MISURATE sulla macchina montata, col nuovo DRO della dashboard: 248,048 mm e 258,622 mm.** **Attenzione all'attribuzione:** sono state misurate *prima* della correzione dei pin, quindi quello che il pannello chiamava X era il motore D25/D33, cioè il portale sulle rotaie, che adesso si chiama Y. I due numeri vanno quindi letti **scambiati**: **corsa X (carrello sulla trave) = 258,622** e **corsa Y (portale sulle rotaie) = 248,048**. Il che torna anche fisicamente: la trave è tagliata a 550 e dà più corsa delle rotaie da 400. Prima della correzione sembrava il contrario, ed era un indizio che non avevo raccolto. Misurate portando ciascun asse a un estremo, azzerando, e andando all'altro estremo (entrambe negative perché il verso percorso era quello negativo; conta il modulo). **Sono provvisorie**: il rapporto non è ancora tarato, quindi sono calcolate col nominale 33,953 passi/mm. Non vanno rifatte, però — l'errore è puramente moltiplicativo, quindi basterà riscalarle per `mmPerRev_tarato / 94,2478` quando la taratura ci sarà. In passi sono 8781 sulla trave e 8422 sulle rotaie, e quelli non cambiano qualunque cosa succeda ai nomi
- [2026-10-19] **`max_rate_mm_per_min` alzato da 2000 a 8000 su X e Y**, conseguenza del rapporto corretto: il 2000 era 2667 microstep/s con 80 passi/mm, ma con 33,953 sono 1132, un settimo di quello che il motore regge (500 passi interi/s = 8000 microstep/s = 235 mm/s ≈ 14100 mm/min). È un **tetto**, non una velocità di lavoro — quella la decide la F del G-code — quindi alzarlo non comporta rischio. **L'accelerazione resta 200** di proposito: agisce su ogni movimento, è quella che scuote il portale, e va alzata per prove successive solo col modulo penna montato, perché è lo sbalzo del modulo a decidere quanta imbardata genera uno strappo
- [2026-10-19] **Senza finecorsa non esiste un riferimento macchina, quindi non esiste protezione sui limiti.** Va detto esplicitamente perché è il costo della scelta: `G92` definisce un'origine di *lavoro*, non un riferimento, e non sopravvive a un riavvio né a un reset. L'unica protezione che resta è il **controllo dell'ingombro del disegno** fatto dall'interfaccia prima di partire. Corollario già scritto il 2026-10-06 e che qui diventa operativo: serve uno stato **NON AZZERATA** in cui l'app permette solo jog relativi a passo limitato e rifiuta di eseguire un programma
- [2026-10-19] **Il file non porta la decisione sull'azzeramento.** `soft_limits: false`, `must_home: false` e nessun blocco `homing:`, mentre la decisione presa dopo dice il contrario (azzeramento sui due pulsanti d'angolo, `soft_limits` attivi, `must_home` vero). È lavoro di solo YAML, non serve la macchina: va fatto prima di accendere FluidNC, altrimenti il primo movimento avviene senza la protezione che la decisione prevedeva
- [2026-10-19] **`max_rate_mm_per_min: 2000` è da rivedere al rialzo**, conseguenza del rapporto corretto: con 33,953 passi/mm sono 1132 microstep/s, contro i ~8000 che il motore ha dimostrato di reggere. Non è un bug, è un limite lasciato dal rapporto sbagliato
- [2026-10-19] **Nota di metodo per la tab Impostazioni, dal nostro stesso collaudo del 2026-09-21:** su FluidNC 4.1.0 il comando di modifica a runtime (`$/axes/...=`) **non restituisce nulla** e non ha effetto; quello che funziona è ricaricare il file e riavviare con `$Bye`. Confermato indirettamente dalla documentazione FluidNC, secondo cui le modifiche `$` vivono solo in memoria volatile e vanno scritte con `$CD=config.yaml` per sopravvivere al riavvio, e secondo cui le definizioni dei pin richiedono comunque un riavvio. Conseguenza di progetto: una tab Impostazioni che scrive nella macchina deve **generare il file e caricarlo**, non toccare le impostazioni a runtime
- [2026-10-06] Conseguenze collaterali del rapporto vero: risoluzione **0,0295 mm per microstep** (il gioco di 0,235 è 8× il passo, quindi è il gioco a dominare, non la risoluzione) e `max_rate_mm_per_min: 2000` corrisponde ora a 1132 microstep/s invece di 2667, cioè **un settimo** di quello che la meccanica regge (il motore è validato a 500 passi interi/s ≈ 235 mm/s). Verifica del rapporto: `G91 G0 X100`, misurare col calibro, correggere in proporzione
- [2026-10-22] **FluidNC 4.1.1 installata sulla macchina definitiva** e configurazione verificata con `$CD` chiave per chiave: nessuna ignorata. Rete STA, `cnc2d.local`, 192.168.1.14. **Tre scoperte ai primi comandi veri.** (a) Il servo non si muoveva: `RcServo` mappa la posizione MACCHINA e tronca fuori dai limiti dell'asse, e senza homing FluidNC dichiara la corsa in negativo — `Axis Z (-21.281, 0.010)` — quindi tutte le quote positive uscivano a 1500 µs. Confermato con `G0 Z-3`, che muove. La Z va usata in negativo: Z0 = tappo, Z−21.271 = contatto. (b) **I due assi andavano al contrario tutti e due**: invertite le spunte nel profilo, da riprovare. (c) Il flash a 921600 si interrompe sul CH340: 115200.
- [2026-10-23] **Le tre cose del giorno prima sono chiuse, e se ne apre una più grossa.** Quote Z negative in produzione e verificate sulla macchina (Z0, Z−18.326, Z−21.271 tutte raggiunte); versi dei due assi riprovati con quattro jog da 25 mm, **giusti**. Risolto anche «Upload filesystem inaccessible», che non era un guasto: le rotte della WebUI sono separate — `/files` è la flash, `/upload` è la SD — e l'upload finiva sulla SD inesistente. Si carica con `curl -T http://IP/flash/nome`, perché la flash è montata in WebDAV. **Ma due stampe lunghe si sono bloccate a metà** rendendo irraggiungibile la WebUI: la casella comandi crea un canale per ogni comando e `$LocalFS/Run` se lo tiene per tutta la durata del job, quindi la connessione HTTP del browser resta aperta per minuti. Da provare lanciando dalla seriale USB, che è insieme prova e rimedio.
- [2026-10-24] **Il blocco delle stampe lunghe è confermato, ed è il canale HTTP.** L'intreccio, fermatosi due volte su due lanciato dalla WebUI, lanciato dalla **seriale USB** a scheda del browser chiusa è arrivato in fondo: sette minuti, nessun reset. Una variabile sola cambiata. Da qui la regola operativa — **i disegni lunghi si lanciano dalla seriale** — e la conferma che lo streaming riga per riga del SLICER non è solo comodità. Procedura provata: browser chiuso, USB collegata a macchina spenta, 12 V riaccesi, monitor seriale a 115200 con fine riga «New Line», `$I` per verificare, `$LocalFS/List`, `$MD`, battuta, `G92 X0 Y0`, `G90 G0 X5 Y5 F1000`, penna, foglio, `$LocalFS/Run=<file>`. **Nota pratica sulla flash:** prima di caricare serve spazio vero, perché il gestore di upload tiene da parte una riserva — 20 KB liberi non bastano per un file da 19,5 KB.
- [2026-10-24] **Il WebSocket di FluidNC è un canale di comando a tutti gli effetti**, e da oggi è quello che usa il nostro programma. Letto nel sorgente: `WSChannel.cpp` mette i frame in arrivo in `push()` e registra il canale in `allChannels` come la UART; `WebUIServer.cpp` lo monta sulla radice. Nessun controllo dell'header `Origin` — i WebSocket non passano per il CORS — quindi la pagina parla con la macchina anche servita da altrove. Provato sulla macchina: collegamento, jog, homing, spostamento a coordinate. È la stessa cura del blocco delle stampe lunghe, vista dal lato del firmware: un canale solo che non si disconnette, invece di uno nuovo per comando.

### Step 4 — GDC CNC 2D SLICER (interfaccia web e generazione G-code)

**Stato:** in corso — **l'applicazione stampa, compone e disegna.** Oltre a mandare il programma (2026-10-25 mattina), regge **più SVG sullo stesso foglio** come livelli ordinati con i **cambi penna** fra l'uno e l'altro, e ha un **editor** con cui modificare e creare tracciati — nodi, maniglie, linee, rettangoli, cerchi, testi, taglio, curve, magneti, griglia, selezione multipla e annulla. Dal 2026-10-26 **un file si apre in un livello per tinta** (ogni colore di bordo e ogni colore di riempimento), le tinte piene spente ma recuperabili: l'importatore non butta più via geometria in silenzio. L'elenco dei livelli è comandabile — occhio, trascinamento per l'ordine, cambio penna sulla riga, selezione multipla, etichetta «edit» — e il riquadro sul foglio lavora su più livelli insieme e ruota senza perdere la collocazione. **Deciso il 2026-10-25: la pagina NON va sull'ESP32**, resta sul PC; cade con questo il tetto dei 113 kB che vincolava ogni aggiunta, e la WebUI di FluidNC resta come rete di sicurezza. Dal 2026-10-26 l’editor sceglie il **singolo tratto** fra due nodi invece della polilinea intera, ha **i suoi livelli** e somma i tratti con Ctrl, e il **cambio penna** è la procedura in sei passi che l’utente aveva in mente. La pagina porta **il numero di versione accanto al titolo**, contato dai commit. Dal 2026-10-27 i **tratti doppi non arrivano alla penna**, il **lavoro si salva in un SVG** che la pagina sa riaprire dov'era, e il tastierino ha i **punti limite della corsa** con le frecce che si fermano un millimetro prima del fine corsa; dal 2026-10-28 un tratto si **taglia e si incolla in un altro livello** senza muoversi di un millimetro sul foglio, e la pagina **parla col telecomando** (Step 9). Dal 2026-10-31 **cambiare foglio non rifà la collocazione dei disegni**: le sposta tutte della stessa quantità, cioè il foglio cresce o si stringe attorno al proprio centro; la **scala vale per tutti i livelli scelti** se si accende la spunta; e un **livello nuovo si crea dall'editor**, per staccare un pezzo di un disegno importato e lavorarci da solo. Dal 2026-11-01 il **telecomando ha una scheda sua** nelle impostazioni, con le prove delle schermate e la spia del dialogo, utilizzabili **solo in modalità finta**. Quello che manca è scritto nelle note

 Il 2026-11-02 l'editor prende due strumenti che mancavano — il **selettore specifico** (lazo che taglia sul bordo) e lo **specchio** —, il marchio della macchina entra nell'intestazione e nel foglio, e la **fine di una stampa** smette di essere una bugia: «fine» aspetta che la macchina si fermi davvero, una stampa fermata diventa uno stato suo, e il racconto scade.

 Il 2026-11-07 **sul piano ci stanno più fogli**, ed è il cambiamento più grosso dai livelli in poi: si aggiungono dalla colonna, si trascinano sul piano e **si agganciano l'uno all'altro** con i magneti, ogni livello sta su UN foglio, l'elenco dei livelli è diviso per foglio e si trascina da un gruppo all'altro. Si stampa su tutti in un colpo, scegliendo se andare **per penna** o **per foglio**; i popup di inizio stampa chiedono un angolo per ogni foglio che sta per conto suo e uno solo per i gruppi accostati; la tab «In stampa» disegna il piano intero e il telecomando dice **«foglio 3 di 9»**. Vedi lo Step 12.

 Il 2026-11-06 **due progetti salvati si possono unire**: riaprirne uno con del lavoro già sul foglio non lo sostituisce più d'ufficio, chiede, e fra le strade c'è **«aggiungi i livelli»** — con le forme intere, cioè le curve ancora curve. Quello che di questa cosa resta aperto è lo Step 11.

 Il 2026-11-03 l'anteprima smette di essere un disegno e comincia a somigliare al foglio: la **carta ha un colore** (sei carte per nome più il selettore, per misura di foglio e non per profilo) e ogni livello ha lo **spessore del tratto** in millimetri veri, scelto da un trattino accanto al pallino della penna. Nella stessa giornata: la **punta della penna nuova si ritrova** al cambio penna con un `G92`, perché due penne non hanno la punta nello stesso posto; nasce la tab **«In stampa»**, che racconta una stampa mentre succede e resta a raccontarla dopo; e **una penna diventa un colore E uno spessore**, con tutti gli avvisi dei cambi penna rifatti su quella chiave più uno nuovo — la fermata che manca.

**Obiettivo:** un'unica pagina web da cui caricare un disegno, vederne l'anteprima sul foglio, generare il G-code e mandarlo in esecuzione

**Decisioni progettuali:**
- **Tutta l'elaborazione nel browser, l'ESP32 solo esegue.** L'ESP32 ha circa 300 KB di RAM utilizzabile: vettorializzare un'immagine e generare G-code è fuori portata. Il browser produce il file, l'ESP32 lo conserva ed esegue — così il disegno prosegue anche se si chiude il portatile o cade il Wi-Fi
- **Vettorializzazione con algoritmi deterministici** (Potrace o equivalente in JavaScript), non con un modello generativo. Alternativa scartata: passare l'immagine a un AI esterna con prompt da copiare e incollare — un modello linguistico non ricalca un'immagine, inventa percorsi plausibili, diversi a ogni tentativo e senza controllo su dove passa la penna. L'AI resta utile a monte, per preparare il soggetto come disegno a tratto
- **Si parte dall'SVG e basta.** I percorsi sono già vettoriali, non serve tracciamento: è il caso d'uso più frequente e costa una frazione del lavoro. Line art e planimetrie (soglia + tracciamento) vengono dopo. Le foto richiedono algoritmi dedicati — stippling, campi di flusso, retinatura — e sono un progetto a sé
- **Interfaccia servita dall'ESP32 come file separati**, non più come stringa dentro lo sketch: il codice resta leggibile e l'interfaccia si aggiorna dal browser senza ricompilare
- **Layout**: colonna menu a sinistra, foglio centrale con formati A4/A5/A6 e dimensioni modificabili, drop box con anteprima, colonna a destra per scorrere l'anteprima del movimento — che durante il disegno vero diventa indicatore di avanzamento. Tab separate per log e impostazioni
- L'anteprima distingue **tratti disegnati e spostamenti a vuoto** con colori diversi: vedere gli spostamenti a vuoto è il modo per accorgersi che il disegno è ordinato male
- **L'interfaccia dovrà essere servita dall'ESP32 per comandare la macchina.** FluidNC espone il suo HTTP senza intestazioni CORS, e una pagina in HTTPS non può comunque interrogare un dispositivo in HTTP semplice: online-ovunque più comando diretto è una combinazione che il browser vieta. Conseguenza operativa: niente framework, niente librerie, niente processo di build, perché la pagina deve stare nella memoria dell'ESP32
- **Il calcolo resta nel browser anche quando la pagina è servita dall'ESP32.** Il microcontrollore consegna il file, il processore del PC o del telefono fa il lavoro. L'ottimizzazione del percorso del logo di prova ha impiegato 1 ms
- **Il criterio dell'ottimizzazione è il tempo, non la distanza.** Un'alzata di penna costa circa mezzo secondo fra movimento del servo e assestamento; cinquanta millimetri di spostamento a 2000 mm/min ne costano uno e mezzo. Saldare i tratti contigui vale quindi più che accorciare gli spostamenti, e viene prima nella catena
- **Modalità finta sempre disponibile**: l'interfaccia simula le risposte della macchina, così ci si lavora senza accendere nulla — che è la maggior parte del tempo
- **Il nome è GDC CNC 2D SLICER** (deciso dall'utente il 2026-10-15). Regge il confronto con quello che l'applicazione fa davvero: non è solo una pulsantiera, converte un disegno in percorsi utensile — che è esattamente il lavoro di uno slicer, con la differenza che il risultato è piano invece che a strati
- **La tab Impostazioni è l'unica fonte di verità dei numeri della macchina** (deciso il 2026-10-15). Oggi gli stessi valori vivono in tre posti che non si parlano: i `#define` del firmware della dashboard, il `cnc2d-config.yaml` di FluidNC e i default dell'anteprima nel browser. Finché è così, tarare la macchina vuol dire ricordarsi di cambiare lo stesso numero tre volte, e il giorno che se ne dimentica uno l'anteprima mostra un disegno che la macchina non fa. La tab deve **contenere i valori, salvarli e poterli esportare**, e anteprima, generatore di G-code e macchina devono leggerli tutti da lì
- **Due passi/mm, uno per asse, non uno globale** (2026-10-15). Le due cremagliere sono stampate separatamente e si sono ritirate di quantità diverse: un valore solo fa uscire i quadrati rettangoli. Oggi il firmware della dashboard ne ha uno solo, calcolato da `MM_PER_REV`; FluidNC li ha già separati per asse

- **Il pannello di controllo manuale entra nel GDC CNC 2D SLICER come sezione di prima classe** (richiesta dell'utente, 2026-10-19). Non è una comodità: senza finecorsa è **l'unico modo** di stabilire un'origine, e tutte le misurazioni di taratura passano da lì. Scritto una volta e mostrato in due posti — una tab dedicata per le sessioni di misura, e lo stesso componente incorporato nei popup di inizio stampa — altrimenti le due copie divergono. Nella tab Disegno l'impalcatura esiste già (`webui/js/jog.js`: pad di jog, selettore del passo, "Imposta origine qui", penna su/giù, STOP), tutta disabilitata, più due pulsanti d'angolo che sono segnaposto
- **Profilo macchina salvabile, sul modello dei profili di stampa** (richiesta dell'utente, 2026-10-19). Il profilo tiene tutto ciò che è proprietà della macchina e si misura una volta: passi/mm per asse, corse, velocità e accelerazioni, inversioni, margine di sicurezza, estremi dell'impulso del servo più i quattro angoli, offset utensile. È il profilo il documento sorgente, e `config.yaml` è il suo **prodotto**: così resta un solo posto in cui si scrive, coerente con la decisione del 2026-10-15
- **Le due misure di inizio stampa non entrano mai nel profilo come default.** L'origine XY e l'altezza di appoggio della penna sono misure *del momento*: dipendono da dove è appoggiato il foglio e da quanto è spesso. Salvarle come default significa, dopo un riavvio, fidarsi di un'origine che non vale più — ed è il modo classico di mandare il carrello contro il telaio. Si conservano come **"ultimo valore usato"**, mostrato nel popup come suggerimento, mai applicato da solo
- **"Imposta origine qui" e "registra questa misura" sono due pulsanti diversi.** Il primo è `G92 X0 Y0`, un atto di inizio stampa. Il secondo prende la lettura corrente del DRO e la scrive in un **campo preciso** del profilo (corsa X, corsa Y, offset utensile...), quindi vive accanto a quel campo nelle impostazioni, non accanto al pad di jog. Nella richiesta dell'utente erano un pulsante solo
- **Differenza con i profili di Bambu Studio, e conta:** una Bambu all'accensione sa dove si trova, perché ha i finecorsa. Questa macchina non lo sa. Il profilo può quindi contenere tutto **tranne la posizione**, ed è esattamente il motivo per cui i due popup di inizio stampa esistono e non si possono ottimizzare via

**Che cosa deve contenere la tab Impostazioni** (lista di lavoro, da completare
mano a mano che le misure arrivano):

| Gruppo | Valori |
|---|---|
| Trasmissione | passi/mm **per asse**, microstep impostati sui ponticelli, inversione di direzione per asse |
| Corse | corsa utile per asse (`max_travel_mm`), origine dell'area di disegno, posizione e formato del foglio nel piano |
| Dinamica | velocità massima e accelerazione per asse, velocità di disegno distinta da quella di spostamento a vuoto |
| Penna | **angolo di battuta** (cuscinetti in fondo ai blocchi inferiori: limite meccanico, il software non scende sotto), **angolo penna appoggiata** (sopra la battuta; è anche l'angolo a cui tenere il servo mentre si infila e si stringe la penna), **angolo penna alzata** (sopra l'appoggio), **angolo di battuta alta** (secondo limite meccanico), raggio del pignone del servo (18,750 → 0,32725 mm/grado, per inserire alzata e appoggio in millimetri invece che in gradi), verso di rotazione, passo della rampa del servo, pausa dopo ogni su/giù (150÷250 ms) |
| Utensile | offset della punta rispetto al riferimento del carrello (X e Y), altezza del piano carta |
| Compensazioni | gioco d'ingranamento per asse, se si deciderà di compensarlo |

**Criterio di completamento:** caricare un SVG, vederlo posizionato nel foglio, generare il G-code e farlo eseguire alla macchina

**Note (cronologia dello step):**
- [2026-11-07] **Il foglio era una parola sola per due cose, e da oggi non lo è più.** «Il foglio» voleva dire insieme *il rettangolo sul piano* e *il sistema di riferimento in cui stanno i numeri dei livelli*: finché ce n'era uno, le due cose coincidevano e nessuno doveva distinguerle. Il lavoro dello Step 12 è, in sostanza, averle separate — e il punto fortunato è che la conversione da coordinate del foglio a coordinate macchina stava **già in un posto solo**: bastava che l'angolo da sommare non fosse più sempre lo stesso.
- [2026-11-07] **L'elenco dei livelli è diviso per foglio, e i livelli di uno stesso foglio stanno insieme.** Non è presentazione: l'ordine dell'elenco *è* l'ordine di stampa, e tenerli sparsi vorrebbe dire una stampa che salta da un foglio all'altro e torna indietro. Trascinando un livello sotto l'intestazione di un altro foglio, ci va: è la strada per rimediare a «l'ho caricato sul foglio sbagliato» senza ricaricare niente.
- [2026-11-07] **L'editor mostra solo i livelli del foglio in uso**, e il suo sfondo non attraversa più i fogli. Quella non era una comodità ma un difetto: `daFoglio` porta i tratti nelle coordinate del livello che si modifica, quindi un disegno di un ALTRO foglio finiva disegnato sopra a questo alla distanza sbagliata, come se fosse sulla stessa carta — uno sfondo che dice una cosa falsa proprio mentre lo si usa per mirare.
- [2026-11-06] **Un progetto salvato si riapre in due modi, e prima ce n'era uno solo.** Riaprire un `.cnc2d.svg` azzerava l'elenco dei livelli: era di proposito — «un progetto non si importa, si riprende» — e giusto per riprendere la giornata di ieri, sbagliato per chi tiene da parte dei pezzi e ne vuole da due file. La domanda c'era già, ma era un `window.confirm`: **due pulsanti, quindi due strade**, e la terza non c'entrava. Adesso è una finestrella sua con *Annulla / Sostituisci tutto / Aggiungi i livelli*, e aggiungendo arrivano le **forme** — curve, nomi, penne, spessori, rotazioni, ritagli — non i tracciati.
- [2026-11-06] **Perché le forme contano più di tutto il resto.** Lo stesso file, riaperto come un SVG qualunque (togliendo il `<metadata>` a mano), si sarebbe potuto accostare fin dal primo giorno: nel file c'è un `<g>` per livello. Ma i tracciati disegnati lì dentro sono **polilinee già appiattite**, quindi la curva sarebbe tornata una spezzata e l'editor non l'avrebbe più ricurvata, e nome, penna e spessore sarebbero spariti. È il motivo per cui «aggiungi» passa dal `<metadata>` e non dall'importatore.
- [2026-11-06] **La coda, che non era un dettaglio.** I file arrivano a mazzo: due trascinati insieme sono due `FileReader` che finiscono quando finiscono. Aprire la seconda finestrella sopra la prima avrebbe perso una scelta **senza dirlo** — il secondo progetto sparito e nessuno che sa perché. Si chiede uno per volta, e mentre si sceglie si vede scritto che ce n'è un altro in attesa.
- [2026-11-02] **Il selettore specifico (il lazo), e perché il taglio è tutto.** Si cerchia a mano libera e si prende solo quello che resta dentro, **tagliando le spezzate sul bordo**. Senza il taglio non servirebbe a niente: su un disegno importato una «linea» non esiste — una campitura a onde è **un** tracciato con decine di migliaia di nodi — e portarne via un pezzo con Scegli e Ctrl+X vuol dire cliccare tratto per tratto per mezz'ora; il rettangolo di selezione prende le **forme** che tocca, cioè tutta la campitura. Il taglio è sul bordo vero: intersezione esatta sui tratti dritti, bisezione sul parametro per le curve, e le due metà ricavate con de Casteljau così la curva non si storce proprio dove la si taglia. Misurato: nodi nuovi a **tre centesimi di micron** dal bordo, curva tagliata che si discosta al massimo di **7 micron**.
- [2026-11-02] **E il costo non era dove pensavo.** Il lazo su sessantamila tratti costava 1714 ms, di cui **1556 di sola rigenerazione** e 126 di geometria vera. Ma il lazo **non cambia il disegno** — sposta solo dove stanno i nodi, che cadono sulla linea che c'era già — quindi le polilinee in cassa restano valide e `Artwork.rigenera()` si salta: **181 ms**. Avevo scritto che il filtro delle scatole era «quello che rende la cosa possibile»: misurandolo vale il 12%, e il commento è stato corretto, perché scritto così avrebbe mandato chi un giorno vuole velocizzare quel codice a guardare nel posto sbagliato.
- [2026-11-02] **Lo specchio, e perché non è una rotazione.** Ribalta quello che è scelto attorno alla riga di mezzo della selezione, così si gira senza spostarsi. Una lettera **ruotata** resta leggibile al contrario, una lettera **ribaltata** è l'immagine allo specchio: le due cose coincidono solo per le figure simmetriche. Un testo ribaltato **smette di essere un testo** — la forma `testo` tiene la parola e l'altezza, e da quelle le lettere si ricostruiscono dritte ogni volta, quindi non c'è posto dove scrivere «ma rovesciata» — e diventa tracciati, una volta sola e dicendolo nel registro.
- [2026-11-02] **Bug: il testo usciva rovesciato.** *Sintomo:* una parola inserita con lo strumento Testo usciva **rovesciata**, e girandola di mezzo giro non si raddrizzava. *Causa:* accertata — `FontTratto` ha l'origine in basso e la lettera che cresce verso l'alto, mentre da `appiattisci()` in poi la y va in giù; il commento vecchio diceva che «chi usa il risultato lo ribalta come ribalta tutto il resto», e non era vero, perché `toRect` ribalta **una volta sola**. Rovesciata e non ruotata: ecco perché ruotarla non bastava. *Fix:* la y si ribalta dove la lettera nasce. Misurato sulla pagina costruita: una «L» alta 10 mm sulla riga di base occupa da −10 a 0, piede largo 6 mm in basso.
- [2026-11-02] **L'importatore: i magazzini non si disegnano, le maschere sì.** Quello che sta in `<defs>`, `<symbol>`, `<marker>`, `<pattern>` o in un gradiente **non è nel disegno**: si vede solo dove qualcos'altro lo richiama. Ma **una maschera non è un magazzino** — il suo contenuto non è inchiostro, però dice *dove* il disegno si vede, e i suoi contorni sono bordi del risultato finale, che per una penna è esattamente la cosa da disegnare. Decide il più vicino dei due, così una maschera dentro a `<defs>` (quasi tutte) resta una maschera. Il rettangolo di fondo lo scartava già la regola degli sfondi: l'avevo dato per scontato al contrario, e la prova l'ha mostrato.
- [2026-11-02] **La fine di una stampa, dal lato del SLICER.** «Fine» voleva dire «ho consegnato l'ultima riga», non «ho finito»: la macchina ha un pianificatore, quindi il telecomando suonava la fine mentre la penna stava ancora tracciando. Adesso consegna e fine sono due momenti, e si aspetta che la macchina dica `Idle` (con un'uscita di sicurezza a due minuti). Fermare una stampa dà lo stato **`fermata`** invece di `fermo`: prima erano la stessa cosa, e sul vetro «una macchina accesa che non ha mai stampato» e «una stampa che hai fermato tu» erano la stessa schermata.
- [2026-09-24] Costruita l'impalcatura completa (`webui/`, dodici file): tre colonne, tab Disegno/Log/Impostazioni, foglio con formati, cursore verticale per scorrere l'anteprima del percorso
- [2026-09-24] Rifatta l'area centrale: il riquadro è ora **il piano della macchina**, fisso, con reticolo da 10 mm e lo zero macchina marcato; il foglio è un rettangolo disegnato dentro, trascinabile col puntatore, e il suo bordo diventa rosso quando esce dall'area. Il disegno è tenuto in coordinate del foglio, quindi lo segue per costruzione
- [2026-09-24] Importazione SVG funzionante: l'appiattimento delle curve lo fa il browser campionando `getPointAtLength` per lunghezza d'arco, e lo stesso campionamento riconosce i sotto-tracciati (due campioni non possono distare più del passo, quindi un salto più lungo è uno stacco di penna dentro lo stesso elemento — il foro di una "o")
- [2026-09-24] Ottimizzazione e G-code funzionanti. Sul logo dell'utente: 11 tratti, 294 punti, spostamenti da 769 a 424 mm, circa 1 min 15 s stimati, calcolo in 1 ms. La stima del tempo usa un profilo trapezoidale per polilinea, perché il look-ahead di FluidNC mantiene la velocità fra segmenti consecutivi
- [2026-09-24] Resta da fare: invio del programma alla macchina, avanzamento in tempo reale, caricamento della pagina sull'ESP32, conversione da fotografia a tracciato
- [2026-10-15] **Battezzata GDC CNC 2D SLICER** su proposta dell'utente, e stabilito che la tab Impostazioni va riprogettata bene prima di riprendere il resto: è lì che finiranno tutte le misure di taratura, e progettarla male significa doverla rifare dopo averci messo dentro i numeri
- [2026-10-15] Registrato che **il firmware della dashboard espone un solo passi/mm** per entrambi gli assi (`stepsPerMm()`, calcolato da `MM_PER_REV`): va separato per asse prima della taratura
- [2026-10-20] **Nomenclatura concordata con l'utente prima di scrivere il codice**, e messa in `misure/impostazioni-glossario.md`. Due profili (macchina e stampa), «mm per giro ingranaggio» per asse, corsa totale / corsa percorribile / margine di sicurezza come tre parole distinte, «punto ai blocchi» e «punto home», «altezza di contatto col foglio». Il glossario si cambia **prima** del codice
- [2026-10-20] **Tab Impostazioni ricostruita** sul modello del profilo: binding per percorso (`data-bind`), etichette di provenienza su ogni campo, generatore di `config.yaml`, esportazione e importazione JSON, taratura del rapporto da una figura disegnata
- [2026-10-20] **Pannello manuale scritto come componente** (`webui/js/panel.js`) e montato in tre posti, come previsto dalla decisione del 2026-10-19. Verificato sulla documentazione FluidNC: `$MD` libera i motori, e **non esiste un comando per riaccenderli** — li riaccende il primo movimento. Conseguenza di progetto: «Homing completato» manda un jog da 0,01 mm e subito dopo `G92`, in quest'ordine
- [2026-10-20] **Tre popup di inizio stampa** (`webui/js/popup.js`), ognuno col suo blocco e col motivo scritto. Il programma si **rigenera dopo il terzo**, perché l'origine del foglio sposta le coordinate e l'altezza di contatto sposta la Z
- [2026-10-20] **La pausa della penna è arrivata nel G-code.** Il numero stava nel profilo dal 19 e il generatore non lo usava
- [2026-10-20] **Resta da fare:** invio del programma alla macchina, caricamento della pagina sull'ESP32, conversione da fotografia a tracciato. L'invio si scrive quando FluidNC sarà acceso: scriverlo adesso sarebbe codice di rete non collaudato su un protocollo mai visto rispondere
- [2026-10-20] **IDEA PARCHEGGIATA — compensare il fuori-piano via software**, proposta dall'utente: una mappa del piano presa con la penna, e il generatore che ritocca la Z punto per punto, come il mesh bed levelling delle stampanti 3D. Non si fa adesso, si decide **dopo la stampa di collaudo**, ma va ricordata perché l'alternativa è rifare il piano. Due cose da sapere quando ci si torna: (1) **i dati li raccoglie già la prova 11** del disegno di collaudo, i nove nodi a gradini *sono* la mappa, basta trascriverli; (2) **la soglia che decide è la banda morta del servo, 0,295 mm** — la compensazione può muovere la penna solo a scatti di circa tre decimi, quindi sotto 0,3 mm di fuori-piano è inutile, fra 0,5 e 1 mm è grossolana, oltre il millimetro è la strada giusta
- [2026-10-19] **Procedura di accensione e taratura scritta per intero** in `misure/accensione-e-taratura.md`, su richiesta dell'utente. Due fasi distinte: **Fase A** (una volta, produce il profilo macchina) e **Fase B** (ogni stampa). Apre con una tabella di cosa esiste davvero oggi, perché è una procedura di arrivo e seguirla adesso non funzionerebbe. Tre cose emerse scrivendola, tutte nuove:
  1. **I tre angoli del servo si rilevano con la dashboard, prima di flashare FluidNC**, e non dopo: la dashboard ha lo slider, lo stato `free` all'accensione e la rampa di avvicinamento, FluidNC nessuno dei tre. Flashare FluidNC cancella la dashboard, quindi l'ordine non è reversibile a costo zero.
  2. **Al primo avvio di FluidNC la penna va togliersi dai morsetti.** FluidNC porta l'asse Z alla posizione zero all'avvio, e con la mappatura prevista lo zero è *penna appoggiata*: con la penna montata la punta scende a premere sul piano. Da osservare al primo avvio; se il movimento è brusco si invertono `min_pulse_us` e `max_pulse_us` così lo zero diventa la posizione alzata e l'avvio è sempre nella direzione innocua.
  3. **L'offset utensile resta a zero, e non è una dimenticanza:** l'origine si imposta portando *la punta della penna* sul punto, quindi l'offset fra riferimento del carrello e punta è già assorbito. Servirebbe solo se i limiti fossero riferiti al carrello, e i limiti sono disattivati. Annulla il requisito "offset utensile nel modello dati, a zero" dello Step 6 come cosa da misurare: resta come campo, ma non c'è niente da metterci finché l'origine la dà la punta
- [2026-10-19] **Per l'asse Z del servo, `max_travel_mm` va messo all'alzata reale in mm** (2÷3), non a 10: così `Z0` è l'appoggio e `Z3` l'alzata, e Z è in millimetri veri di penna invece che in unità arbitrarie. L'angolo di **battuta** non entra nel YAML — vive nel profilo del SLICER come limite, e serve a una cosa sola: il software non deve mai poter comandare una Z che lo raggiunga
- [2026-10-19] **Scritto il modello del profilo, `webui/js/profile.js`.** È lo scheletro su cui poggiano sia il pannello manuale sia la tab Impostazioni, e la decisione del 2026-10-15 ("la tab è l'unica fonte di verità") diventa codice: il profilo è il documento sorgente e `config.yaml` si **genera** da lui con `toYaml()`. Scelte di struttura degne di nota:
  - **`null` non è zero.** I tre angoli del servo partono a `null`, che vuol dire "non ancora misurato": `verifica()` si rifiuta di dare il via libera finché ce n'è uno in giro, invece di far finta che valga zero
  - **Niente valori derivati salvati.** Passi/mm, limiti di lavoro, mm/grado e alzata in mm si ricalcolano sempre dai dati grezzi. Un numero calcolato e poi salvato è un numero che un giorno non corrisponderà più a quello da cui era stato calcolato
  - **La mappa dei pin è una costante del generatore, non un campo.** È cablaggio, non taratura, e un campo modificabile per i pin è solo un modo per rompersi la macchina da un menu — tanto più dopo averli sbagliati davvero stamattina
  - **`fondi()` al caricamento**: il salvato si fonde sui valori di partenza invece di sostituirli, così un profilo salvato con una versione vecchia non lascia campi `undefined` quando il modello cresce
  - **`verifica()` non torna un booleano** ma l'elenco di cosa manca, con gravità: chi lo legge deve poter dire all'utente *che cosa* blocca
  - **`stanoDentro()` vive nel profilo**, non dentro un pulsante: senza finecorsa è l'unica protezione contro un movimento fuori area, e deve essere un posto solo
- [2026-10-19] **Collegata l'area di lavoro al profilo.** `State.data.area` non è più il 300 × 300 inventato ma `Profile.areaUtile()`, cioè corsa meno margine: con i numeri misurati oggi fa **249,5 × 235,0**. Anche i due campi dell'area nella tab Impostazioni ora scrivono nel profilo invece di tenerne una copia — spariranno quando la tab sarà riprogettata, perché corsa e margine vanno inseriti separati, essendo due cose diverse
- [2026-10-19] **Margine di sicurezza messo a 8 mm per asse** nei valori di partenza, non 5: deve coprire l'errore di parcheggio dell'origine manuale, che a occhio vale qualche millimetro. Scenderà quando ci sarà un riferimento fisico o i finecorsa
- [2026-10-19] **La granularità del servo e il gioco della cremagliera sono la stessa cifra, ed è il motivo per cui il pen-lift funziona.** La banda morta di un SG90 è ~10 µs su 2000 µs per 180°, cioè 0,9°, che a raggio 18,750 vale **0,295 mm** alla punta. Il gioco d'ingranamento della coppia è **0,30 mm**. Coincidono: la penna galleggia sul proprio peso esattamente dentro l'intervallo che il servo non sa risolvere. Conseguenza pratica: **non ha senso stringere uno dei due senza l'altro**, e il gioco della cremagliera va lasciato dov'è
- [2026-10-19] **Terzo popup: "inizio foglio", dopo quello dell'altezza penna** (richiesta dell'utente). I tre popup fanno tre cose diverse e tenerli distinti conta, perché il primo e il terzo sembrano lo stesso gesto fatto due volte: il **popup 1** fissa l'origine macchina, un punto prestabilito sempre lo stesso, che dà senso alle coordinate e ai limiti e sparisce il giorno dei finecorsa; il **popup 2** trova la quota di appoggio su *questa* carta; il **popup 3** dice dove è appoggiato il foglio *questa volta*, in coordinate macchina. Il terzo è anche quello che rende vera l'unica protezione disponibile senza finecorsa: sapendo dove è il foglio davvero, il controllo dell'ingombro si fa sulla posizione reale invece che su una presunta. E l'ordine chiesto dall'utente (altezza penna prima dell'inizio foglio) ha un vantaggio concreto: cercando l'angolo del foglio la quota di appoggio è già nota, quindi si può abbassare un attimo e farsi confermare da un puntino
- [2026-10-19] **Il margine di sicurezza nel profilo deve coprire l'errore di parcheggio dell'origine**, non essere un numero di comodo: con un parcheggio a occhio di ±5 mm, un margine di 5 mm non protegge niente. Il modo per stringerlo non è essere più precisi a occhio, è dare al parcheggio un **riferimento fisico** — un blocchetto stampato avvitato alla base contro cui il carrello va in battuta, errore zero per definizione. È l'alternativa economica ai microswitch e si può fare in qualunque momento
- [2026-10-19] **Il flusso di inizio stampa, definito dall'utente:** accendi → *slice* → controllo → *stampa* → popup con il pannello manuale per portare la punta sul punto di origine → "homing completato" → popup con il pannello manuale per portare la punta all'altezza di appoggio → "altezza penna completato" → parte la stampa. Approvato nella sostanza, con tre correzioni: (1) il popup XY deve **alzare la penna prima** di abilitare il jog, altrimenti si trascina la punta sul foglio per tutto il posizionamento; (2) dopo "altezza penna completato" l'app deve **alzare subito**, perché quel popup finisce con la punta che tocca; (3) il programma deve cominciare con alza → vai al primo punto → abbassa, altrimenti traccia una riga dall'origine all'inizio del disegno
- [2026-10-19] **Il punto di origine manuale è un'origine di lavoro, non un riferimento macchina**, e i limiti non vanno agganciati a lui. La frase "da quel punto si setta tutta la macchina" è la trappola che il documento aveva già descritto il 2026-10-06 ("si crede di essere a 25 mm e si è a 12"): la ripetibilità di un posizionamento a occhio è di qualche millimetro, e se i limiti sono riferiti a lui l'errore di parcheggio diventa errore di limite. Per **dove cade il disegno sul foglio** qualche millimetro va benissimo, perché la posizione del foglio è comunque arbitraria. Quindi: origine manuale sì, limiti agganciati a lei no
- [2026-10-17] **Il gruppo Penna della tab Impostazioni diventa quattro angoli più una conversione**, su richiesta dell'utente. Il valore che mancava è l'**angolo di battuta**, cioè quello a cui i cuscinetti arrivano in fondo ai blocchi inferiori: è un limite meccanico, non una preferenza, e il software non deve poter scendere sotto. Sopra c'è l'angolo di appoggio — che è anche quello a cui tenere il servo mentre si infila la penna e si stringono i morsetti, perché è la stessa posizione — e sopra ancora quello di penna alzata. Aggiunta mia: serve anche la **battuta alta**, perché la pista è limitata dalle due parti (15,350 di salita contro 11,000 di discesa), e serve il **raggio del pignone** come unico parametro di conversione, così alzata e appoggio si inseriscono in millimetri e la pagina li traduce in gradi (0,32725 mm/grado a r = 18,750). Senza quel campo ogni numero della sezione penna è in gradi e nessuno è leggibile
- [2026-10-21] **Disegno di collaudo** (`webui/tools/test-macchina.js` e `font-tratto.js`): una stampa su 246 × 233 mm con **undici prove in riquadri numerati**, dalla scala per asse all'ortogonalità al gioco al livello del piano, più ripetibilità e velocità. Genera SVG per guardare o G-code per stampare, e il G-code vero si produce **dopo** la taratura della penna, coi numeri veri. Come si legge sta in `misure/disegno-di-collaudo.md`, prova per prova e con l'ordine di lettura — livello e stacchi per primi, perché se il piano è storto tutto il resto è misurato male
- [2026-10-22] **I programmi devono stare in 64 kB**, ed è il browser dei file di FluidNC a dirlo: la partizione LittleFS è 192 kB e `index.html.gz` della WebUI ne occupa 111. Il collaudo scritto per esteso ne occupava 69 e non ci sarebbe entrato. I due generatori emettono ora **G-code modale** — solo quello che cambia — e il collaudo passa a 44.633 byte, con il percorso verificato stato per stato (2994, zero differenze). Stesso conto per l'autonomia del SLICER: **66 kB compressi contro 64 liberi**, quindi ospitarlo chiede un file unico e la rimozione della WebUI di FluidNC.
- [2026-10-23] **Il generatore produce finalmente quote che la macchina esegue.** La convenzione Z vive in un punto solo (`Profile.zDaGradi()`) e la prendono tutti; i programmi finiscono al **punto home** e non più addosso ai blocchi, che è il difetto che il profilo avvertiva da sempre nel commento di `puntoHome`. Soppresse le righe di sola velocità che non muovono niente. Nati cinque generatori nuovi — cornice dell'area utile (con la procedura della penna dentro il file, via `M0`), prova geometrica, vortice, riempimenti, intreccio — e tutti i file rigenerati. **Il conto sull'ospitare il SLICER è stato rifatto sul sorgente e la conclusione si è irrigidita:** in tutto il server web di FluidNC non c'è una sola intestazione CORS, quindi la pagina **deve** essere servita dall'ESP32, non è una preferenza. Il nostro bundle gzippato è 62.539 byte contro i 111.625 della WebUI: togliendola restano ~113 kB liberi invece di 64.
- [2026-10-24] **L'invio del programma non è più solo una comodità: è la cura di un guasto.** Confermato sulla macchina che il blocco delle stampe lunghe nasce dal canale HTTP che `$LocalFS/Run` si tiene aperto per l'intera durata del job (vedi Step 3). Mandando il G-code **riga per riga** quel canale non esiste: non c'è niente che debba restare appeso per venti minuti. Conseguenza sul progetto dell'invio: lo stato della stampa va ricostruito dal nostro lato contando le righe accettate, non chiedendolo a un comando che blocca, e serve una coda con controllo di flusso sugli `ok` invece di un'unica richiesta lunga.
- [2026-10-24] **L'invio esiste, e il programma è diventato l'interfaccia della macchina.** `sender.js` manda il G-code riga per riga su un WebSocket solo, con al più 16 righe non confermate in volo: il freno è l'`ok`, che FluidNC manda quando la riga è entrata nel pianificatore. Non send-and-wait, che lascerebbe il pianificatore vuoto e la macchina a scatti; non tutto insieme, che riempirebbe la memoria della scheda — il lato in ingresso di quel socket non ha né limite né contropressione. L'interruzione **non è un reset**: accoda alzata e ritorno a casa, così il `G92` sopravvive. Attorno all'invio, la giornata di interfaccia: tastierino a otto direzioni con le quote della penna al centro, fogli personalizzati, fogli più grandi della corsa, rotella sul piano, la tavola di legno disegnata e misurata, colonne ridimensionabili. **Provato sulla macchina:** collegamento, jog, homing, vai al punto. **Non ancora provato:** un programma intero. Prove da 230 a 389 asserzioni.
- [2026-10-24] **L'editor SVG è in pipeline ma non costruito, e c'è una precondizione da sapere prima di cominciarlo:** `SvgImport.parse` appiattisce le curve in polilinee al caricamento, quindi su un disegno importato non esiste più nessuna Bézier a cui attaccare una maniglia. Il primo pezzo di lavoro è un modello di tracciato che TIENE le curve e le appiattisce solo in uscita verso il G-code. Direzione scelta: **modificare prima di creare**.
- [2026-10-25] **Il SLICER ha stampato.** Intreccio all'80 % su foglio 270 × 255, cornice **191,7 × 187,7 mm misurata contro 191,7 × 187,7 previsti**: la catena scala → riadattamento al foglio → G-code non distorce niente, e il criterio del millimetro regge anche passando dall'app. Movimento **continuo**, nessuna esitazione fra un segmento e l'altro: la finestra da 16 righe non lascia a secco il pianificatore e non si tocca. Stima del tempo accettata dall'utente senza cronometro, quindi resta com'è.
- [2026-10-25] **Interruzione e pausa provate sulla macchina, e sono due strumenti diversi.** Lo stop alza la penna, torna a casa e **non perde l'origine** — verificato subito dopo con «vai al punto», che è la prova vera che il `G92` è sopravvissuto. Ha però una latenza: fino a 16 righe sono già nella scheda quando si preme, e il pianificatore si consuma, non si svuota. Nell'intreccio il segmento medio è **8,17 mm** e il mediano **2,71**, quindi fra 4 e 13 cm di inchiostro, **2÷6 secondi** a 1200 mm/min. Accorciarla vorrebbe dire un soft reset, che cancella il `G92`: non si fa. La **pausa** invece è immediata e lascia la penna appoggiata, ed è esattamente quello che serve per il cambio penna.
- [2026-10-25] **L'anteprima cambia dopo «prepara», ed è voluto.** Prima mostra i tracciati nell'ordine del file; `prepare()` fa girare l'ottimizzatore (scarta i doppioni, salda i tratti contigui, riordina) e **riscrive `State.data.art` col percorso ottimizzato**. Da quel momento piano e cursore mostrano quello che la macchina farà davvero: l'inchiostro è identico, l'ordine e gli spostamenti a vuoto no. Un'anteprima che restasse quella di prima sarebbe una bugia proprio nel momento in cui si guarda per decidere se partire.
- [2026-10-25] **RICHIESTA UTENTE — pausa programmata per il cambio penna**, per disegni a più colori. Progetto abbozzato, non costruito: i punti di pausa si segnano **sull'anteprima dopo la preparazione**, e devono poter cadere solo **al confine fra due tracciati**, mai a metà di un tratto. Il motivo è che lì il programma ha già la sequenza giusta — alza, pausa, sposta, abbassa — quindi non c'è nessuno stato da ripristinare alla ripresa: senza quel vincolo bisognerebbe ricordare e rifare posizione e quota prima di riprendere, e un cambio penna a punta abbassata lascia comunque una macchia. Il marcatore va onorato dal **Sender**, non da un `M0` del firmware: così la pausa può alzare la penna e portarla in un punto comodo, e la ripresa è un pulsante dell'interfaccia.
- [2026-10-25] **Il peso della pagina è diventato un vincolo da sorvegliare:** 97.126 byte compressi contro ~113 kB liberi sull'ESP32. Sedici kilobyte di margine, e l'editor SVG è la cosa più grossa che resta da scrivere. La decisione su **dove vive la pagina** va presa prima dell'editor, non dopo: o si divide il bundle e si carica l'editor a richiesta, o sull'ESP32 va solo la parte che comanda la macchina e l'editor resta sul PC.
- [2026-10-25] **La pausa per il cambio penna.** Si segna col cursore dell'anteprima, dopo la preparazione, e si ferma **solo al confine fra due tratti**, mai a metà di uno: lì il programma ha già fatto alza → sposta → abbassa, quindi alla ripresa non c'è nessuno stato da ricostruire — e cambiare penna con la punta appoggiata lascerebbe comunque una macchia. Il segno è un commento `;PAUSA` che **la macchina non vede**: lo riconosce il Sender, quindi lo stesso file resta eseguibile da chi di queste pause non sa niente. Il generatore, dopo ogni segno, **azzera lo stato modale**: senza, una riga come «X120» — che in G-code vuol dire «Y resta dov'è» — avrebbe ripreso da una Y cambiata nel frattempo, e il disegno sarebbe proseguito a qualche centimetro di distanza.
- [2026-10-25] **Otto maniglie e il taglio col tasto destro.** Ai quattro angoli si aggiungono i punti di mezzo dei lati, per deformare lungo un asse solo. Il **ritaglio è un rettangolo a parte** dentro a quello del disegno: `box` dice quanto è grande, il ritaglio quanto se ne vede, e tenendoli separati ritirando la maniglia il disegno torna fuori — non è mai stato cancellato, solo nascosto. Il taglio vero lo fa Liang-Barsky segmento per segmento, e un tratto che esce e rientra si spezza in due, che è giusto: sono alzate di penna vere.
- [2026-10-25] **Lo zero e il punto home segnati sul piano**, perché a cinque millimetri si confondono e il foglio si posiziona rispetto a tutti e due. Scoperto nel farlo che **il pallino rosso che sembrava lo zero era la penna dell'anteprima**, parcheggiata a 0,0 quando non c'è percorso: due cose diverse nello stesso posto e dello stesso colore. Verificato col collaudo, non a occhio, che lo zero dei righelli e lo zero macchina cadono sullo **stesso pixel**, adattati e ingranditi.
- [2026-10-25] **I LIVELLI.** Non c'è più un disegno: c'è un elenco di livelli, ognuno col suo rettangolo, rotazione e ritaglio. **L'ordine è la sequenza della stampa**, e l'unità con cui si ragiona di penne: un livello si disegna tutto di fila, e fra uno e l'altro ci si ferma. L'ottimizzazione ha tre ambiti — tutto / per livello / niente — con «per livello» predefinito; con «tutto» i cambi penna vengono tolti e il registro lo dice, invece di stampare in silenzio qualcosa di diverso da quello che si vede.
- [2026-10-25] **Le curve restano curve.** `svgpath.js` legge l'attributo `d` comando per comando e ne escono nodi con le maniglie; `tracciato.js` è il modello, e `SvgImport.parse` è diventato `appiattisciTutte(parseForme())`. L'appiattimento è l'ultimo passo invece del primo, ed è quello che rende possibile modificare una curva importata. **Chiude la precondizione segnata il 2026-10-24.**
- [2026-10-25] **L'editor esiste.** Sei strumenti, nodi e maniglie trascinabili, doppio clic per passare da spigolo a curva, taglio, testi che restano testi. **La y va in giù** come in un file SVG, perché è quel file che si sta modificando; il ribaltamento resta uno solo, in `toRect`. **La tela non ha formato né dimensioni**: quanto diventa grande il disegno lo decidono le maniglie sul foglio. E modificare una forma **non sposta il disegno sul foglio**: si tiene fermo il legame fra le due coordinate e il rettangolo si adegua, se no spostare un nodo rimpicciolirebbe tutto il resto.
- [2026-10-25] **Magneti e annulla.** Tre aiuti in ordine di forza — nodo vicino, angolo entro sei gradi da un multiplo di 45, allineamento in x o y — con Alt per spegnerli un gesto e Shift per forzare l'angolo. L'annulla è una **pila di istantanee**, con una fotografia per gesto e il rettangolo del livello dentro all'istantanea.
- [2026-10-25] **Quello che all'editor manca ancora**, per quando ci si torna: selezione multipla, agganci a una griglia, e la conversione di un segmento dritto in curva senza passare dal nodo. Un tratto importato dai nostri file **non ha curve** perché i file sono fatti di polilinee: le maniglie si mettono col doppio clic. Su un SVG preso dal web le curve ci sono già.

- [2026-10-26] **I quattro angoli del foglio e il punto home sul tastierino**, con la penna che **si alza prima di partire**: questi pulsanti si premono per guardare dove sta il foglio, e un traverso da duecento millimetri con la punta appoggiata lascia una riga dritta in mezzo al disegno. Un punto fuori corsa spegne il suo pulsante e dice di quanto, perché senza finecorsa non c'è nient'altro che fermi il carrello. Gli angoli sono quattro e non tre: tutti e quattro sono **punti limite**, mentre il punto home non lo è — distinzione dell'utente, che ha corretto la mia.
- [2026-10-26] **Il tastierino è fatto di quadrati concentrici**: 5 × 5 di caselle quadrate con un 3 × 3 al centro, stesso passo e stesso vuoto, quindi concentrici per costruzione e non per aggiustamento (misurato: 300 × 300 e 171 × 171). I quattro angoli del foglio stanno **sul giro**, ognuno dalla parte sua: quello dell'angolo in alto a destra in alto a destra. La posizione diventa l'informazione, come il pallino nel rettangolino e le tacche delle quote. I segni delle tre quote sono una penna che scende verso la riga del piano: la tacca di prima diceva l'altezza ma non di che cosa.
- [2026-10-26] **L'editor ha chiuso le tre cose che mancavano**: selezione multipla (rettangolo e Shift+clic, spostamento e Canc sul gruppo), **griglia in millimetri del foglio** — convertiti con la scala del livello, perché le unità di un file possono valere un millimetro come un metro — e strumento **Curva**, che piega un tratto senza passare dal nodo. Un segmento dritto **è già** una cubica con le maniglie a un terzo e due terzi della corda: scriverle non sposta niente, e da lì il tratto segue il dito. Fra tutte le coppie di maniglie che portano il punto dove lo si tira si prende quella che le sposta di meno.
- [2026-10-26] **La griglia è un interruttore suo, separato dai magneti, e non ha tolleranza.** Accesa, il punto va sempre sull'incrocio più vicino: una griglia che aggancia solo quando le passi vicino lascia i punti in mezzo, cioè non è una griglia. Su una tela vuota la scala non esiste e un'unità vale un millimetro; dalla seconda forma in poi i millimetri sono quelli veri.
- [2026-10-26] **UN LIVELLO PER TINTA.** Si butta via solo lo sfondo — la forma senza bordo che copre tutta la tela —; tutto il resto entra diviso per colore di bordo o di riempimento, un livello per ciascuno. Le tinte piene di un file che ha anche dei bordi **nascono spente**, quindi il risultato di partenza è identico a prima, ma quello che prima spariva in silenzio adesso sta nell'elenco con il suo occhio. I livelli di uno stesso file **si adattano insieme**: il rettangolo si calcola sul disegno intero e si ritaglia per ciascuno, se no le facce di un cubo verrebbero scalate diversamente dai suoi spigoli. **Chiude il difetto che la regola del bordo introduceva il 2026-10-25.**
- [2026-10-26] **L'elenco dei livelli è diventato comandabile.** Occhio e occhio sbarrato (un pallino non dice «visibile»: lo dice solo a chi lo sa già), tre lineette da trascinare con l'ordine che cambia davvero mentre si muove, cambio penna cliccabile dalla riga, spunta di selezione che **commuta** — quindi si può arrivare a non aver scelto niente, e il pulsante torna a dire «Crea» —, doppio clic che apre il riquadro sul foglio, etichetta **edit** sui livelli toccati nell'editor. L'etichetta **confronta e non annulla**: mostra com'era prima e rimette le modifiche, e la fotografia si prende al primo gesto, una volta sola.
- [2026-10-26] **Il riquadro lavora su più livelli e ruota senza perdere niente.** Con più livelli scelti è l'unione dei loro rettangoli e le modifiche si distribuiscono in proporzione, quindi i rapporti fra i disegni restano. Scala e rotazione restano del livello principale: ruotare un gruppo attorno a un centro comune non è ruotare, è ruotare *e spostare*. Quattro **maniglie di rotazione** agli angoli, tonde e fuori dal riquadro perché la forma dica il gesto, con scatto ogni quindici gradi. **Rotazione non distruttiva**: restano fermi centro e scala, i due fattori si scambiano a un quarto di giro e il ritaglio gira insieme.
- [2026-10-26] **Caduto il tetto dei kilobyte, cadono le rinunce che lo servivano:** `build.py` metteva fuori il disegno di esempio a ogni compilazione, e adesso lo tiene; per la scheda resta `--leggero`. La pagina è **505.357 byte** in un file solo. Collaudata **sul file unico** e non più solo sui sorgenti (`dist-test.js`): si apre, carica, genera, apre l'editor.
- [2026-10-26] **Quello che all'editor manca ancora:** niente di quanto era segnato il 25 — selezione multipla, griglia e curve ci sono. Resta da capire, quando servirà, se un comando «separa in segmenti» serve davvero: l'ottimizzatore ricuce le polilinee contigue (152 tracciati dell'isometrico diventano 13 tratti di penna), quindi separare non costa alzate di penna, ma **non toglie i doppioni** — `dedupe` gira prima di `join` e un poligono chiuso non ha la stessa chiave di quattro segmenti separati. Misurato: accendendo anche il livello di occlusione dell'isometrico i tratti passano da 26 a 52.

- [2026-10-26] **Il cambio penna è due popup e nessun conto.** La procedura è quella dettata dall'utente: la macchina arriva al segno, mette la penna in **tappo** e va a **home**; primo popup, «togli la penna»; il servo scende alla **quota di contatto**; secondo popup, «monta la penna nuova» con i due pulsanti «alzata» e «contatto» per provarla e il pulsante che riprende. La versione precedente, scritta la mattina, **rimisurava la quota di contatto della penna nuova e spostava di conseguenza tutte le Z rimaste** nel programma: venticinque righe di aritmetica **cancellate**, perché montando la penna *alla quota che il programma usa già* non c'è più niente da correggere. È la penna che si adatta al programma, non il programma alla penna — e il conto che chiude la questione è che la banda morta del servo (0,9°) vale **0,29 mm** alla punta, mentre la differenza di spessore fra due fogli sta sotto il decimo: si stava correggendo una cosa più piccola di quello che la macchina sa fare.
- [2026-10-26] **«Scegli» prende il tratto, non la linea.** Un clic seleziona **il segmento fra due nodi** e Canc toglie quello: è la richiesta dell'utente dopo aver ripulito a mano un livello dell'isometrico, dove per cancellare un lato bisognava prima spezzare la polilinea aggiungendo due nodi. Togliere un tratto da un percorso chiuso lo riapre dal primo segmento rimosso, così non resta un anello che si richiude da solo. **Ctrl somma i tratti** (ricliccandone uno lo rimette fuori) e un Canc li toglie tutti insieme: dieci linee, un tasto.
- [2026-10-26] **L'editor ha i livelli.** Striscia con occhio e riga selezionabile, come nella tab del foglio: si lavora su un livello per volta e gli altri si vedono in trasparenza sotto o si spengono. Senza, portando un file in due tinte nell'editor si poteva modificare solo la tinta attiva — ed era il caso vero, perché l'isometrico sono due livelli da ripulire. **L'annulla è per livello**, non globale: una pila di istantanee per ciascuno, se no tornare indietro su un livello disfaceva il lavoro fatto sull'altro.
- [2026-10-26] **Quattro cose trovate usando il programma, non provandolo.** (1) Il nodo nuovo cadeva **sulla linea sotto** invece che su quella scelta: dove due linee si incrociano la più vicina cambia a ogni pixel, quindi la selezione è diventata **appiccicosa** — se il clic è ancora entro il raggio di presa, resta scelto il tratto che era scelto. (2) Il nodo troppo vicino a un capo creava un **segmento da un pelo**: entro quattro pixel dal capo non si inserisce più niente. (3) Due **Ctrl+clic** di fila valevano un doppio clic, quindi inserivano un nodo e azzeravano il gruppo — la stessa trappola già chiusa per Shift il giorno prima, riaperta dal tasto nuovo. (4) **L'occhio non spegneva il livello attivo**, per una scelta mia: l'utente ha dato il controesempio che la smonta («se li oscuro tutti e cambio livello comunque vedo quello in cui sono»), quindi adesso lo spegne e un livello spento non si può nemmeno scegliere.
- [2026-10-27] **Il numero di versione è contato, non incrementato.** Accanto al titolo c'è il numero della pagina, e `tools/versione.py` lo ricava da `git log -- webui/` + 1 a ogni compilazione: un numero scritto a mano prima o poi non viene aggiornato, e allora **dice una cosa falsa invece di non dire niente**. Alla domanda «quante versioni abbiamo cambiato in tutto?» la risposta non era da inventare: era nel registro. Oggi la pagina è la **70**, 539.766 byte in un file solo.
- [2026-10-27] **I quattro pulsanti del tastierino sono i PUNTI LIMITE DELLA CORSA, non gli angoli del foglio.** *Supera la decisione del 2026-10-26* — col foglio vero dell'utente (270 × 255 a X −14 Y −9, cioè più grande della campata) gli spigoli della carta stanno fuori corsa e **tutti e quattro i pulsanti erano spenti, sempre**: non per un numero sbagliato, ma perché puntavano alla cosa sbagliata. Si premono per vedere **dove arriva la macchina**, e la macchina ci arriva anche quando sul piano non c'è nessun foglio: adesso dipendono solo dalla corsa, cioè dal profilo. Spostare la carta non li muove di un millimetro, e a muoverli è il margine di sicurezza.
- [2026-10-27] **Il bordo di rispetto del movimento a mano: un millimetro.** I punti limite ci si appoggiano sopra (il basso a sinistra è **1,1** e non 0,0) e **le frecce non lo scavalcano**. Un millimetro sono trentaquattro passi di motore: abbastanza da non arrivarci per arrotondamento, abbastanza poco da non togliere area che serva. Il confronto è con la **partenza** e non in assoluto: se il carrello si trova già oltre — dopo una stampa che usa tutta l'area — le frecce che riportano dentro devono funzionare, se no si resta chiusi fuori. **Non vale per la stampa**, che ha il suo margine nel profilo macchina: sommarli vorrebbe dire togliere due volte lo stesso millimetro.
- [2026-10-27] **Dentro ai rettangolini dei punti limite i due numeri hanno il nome dell'asse.** Erano due cifre incolonnate, e due cifre incolonnate non dicono quale delle due è la X: si poteva solo indovinarlo dall'ordine.
- [2026-10-27] **I tratti doppi non arrivano alla penna.** Due facce adiacenti hanno lo spigolo in comune e nel file è disegnato **due volte**: la penna ci passava sopra due volte, e si vedeva sulla carta. Si tolgono **sul foglio e in millimetri** — tolleranza **0,05 mm**, che è un ottavo della punta di una penna — dopo il ritaglio e a ogni refit, quindi vale anche per quello che si disegna nell'editor. I capi si **appaiano** invece di confrontarli per uguaglianza: lo stesso punto arrivato da due strade differisce nell'ultima cifra. **Il confine, dichiarato:** toglie il doppio *esatto*, non le sovrapposizioni parziali, e la fusione è **per livello** — lo stesso segmento in due livelli resta disegnato due volte, perché sono due penne.
- [2026-10-27] **Il popup del cambio penna si apre da sé.** Prima bisognava premere **Riprendi** — cioè un pulsante che dice di riprendere — sperando che invece si fermasse e chiedesse: alla prima stampa a due colori vera l'utente l'ha premuto con la paura che la stampa ripartisse saltando la procedura. Un pulsante che per essere premuto ha bisogno di sapere che non fa quello che c'è scritto è scritto male. «Più tardi» resta più tardi (non si riapre al respiro dopo) e Riprendi lo riapre. In più il primo passo **aspetta che la testina sia ferma**: quando la finestra compare la macchina ha ancora in coda l'alzata al tappo e il ritorno a casa, e sono i secondi in cui uno allunga la mano.
- [2026-10-27] **Il lavoro si salva: `webui/js/progetto.js`.** Un SVG con dentro due cose diverse — il **disegno** come tracciati veri in millimetri del foglio, che qualunque programma apre, e lo **stato** in `<metadata>`: forme con le loro curve, livelli, occhi, cambi penna, rotazioni, ritagli, foglio. Riaprendolo qui vince `<metadata>`: i tracciati sono un prodotto, e rileggerli vorrebbe dire tornare a segmenti dritti, cioè perdere proprio la parte che si era salvata. **Non ci vanno** i cambi penna messi a mano (sono indici dentro al percorso ottimizzato, e il percorso si ricalcola) né l'angolo del foglio quando è già stato misurato oggi: una misura non si sovrascrive con un'ipotesi scritta in un file.
- [2026-10-28] **Taglia, copia e incolla fra livelli** (`Ctrl+X`, `Ctrl+C`, `Ctrl+V`, più tre pulsanti). Serve a rimettere una linea nel **livello giusto**: l'importazione divide per tinta, e la tinta è il modo in cui chi ha fatto il file ha detto cosa va insieme — non sempre è il modo in cui lo si vuole disegnare. Sul foglio non si muove niente: cambia solo la penna. Ogni livello ha le sue coordinate, quindi la conversione passa per il foglio — mappa di chi dà, inversa di chi riceve, rotazione e ribaltamento della y compresi — scritte come una matrice sola, perché una matrice si inverte e una catena di passi no. I tratti che si toccano **restano attaccati**: dieci tratti di fila sono una polilinea, non dieci alzate di penna. Lo strumento che divide un tratto in due si chiama adesso **Spezza**: due «Taglia» nella stessa barra sarebbero stati due comandi diversi con lo stesso nome.
- [2026-10-28] **Gli appunti si portano dietro la MAPPA, non l'id del livello.** È la differenza che è costata un'ora: chi copia prende le forme in *quelle* coordinate, e un attimo dopo il livello può averne altre — basta il taglio stesso, perché togliendo un tratto a una L resta una riga verticale, che un ingombro largo non ce l'ha più e la cui mappa non è più quella con cui le forme erano state lette. Tenendo l'id, il tratto rientrava **lungo 50 mm invece di 136**. L'ha trovato il collaudo, che confronta i millimetri sul foglio invece di contare i tracciati.
- [2026-10-29] **Il colore della penna viaggia dentro al programma.** Il SLICER sapeva con che colore è disegnato ogni livello e non lo diceva a nessuno: al cambio penna la domanda «quale monto?» aveva la risposta solo nella testa di chi guardava l'elenco. Non bastava spedirlo al telecomando, perché un programma **salvato e riaperto un altro giorno** non se lo sarebbe portato dietro: sta nel G-code, in un commento `;PENNA <colore> <nome del livello>` scritto all'inizio di ogni livello, che il Sender legge come legge già `;PAUSA`. Per la macchina è un commento, quindi il file resta eseguibile da chiunque. **Sta prima della pausa, non dopo**: al cambio il Sender si ferma sul segno e non legge più niente, quindi un colore scritto dopo arriverebbe solo alla ripresa, cioè quando non serve più. Si vede in tre posti: il **pallino nell'elenco dei livelli**, la **riga in cima al secondo passo** del cambio penna, e il campo `penna` nel messaggio. Il colore non diventa un dato a parte: si **ricava dalle tinte delle forme contandole**, perché taglia-e-incolla fra livelli può avercene portata dentro un'altra, e una copia sarebbe un secondo posto dove sta la stessa cosa. Un livello disegnato a mano non ha tinta: lì il colore è **null** e non si mostra niente, che è meglio di un nero inventato — vorrebbe dire «monta la penna nera».
- [2026-10-29] **Le penne si vedono anche nel SLICER.** I tratti sul foglio hanno il colore della loro penna (gli spostamenti a penna alzata no: non sono inchiostro), e l'elenco dei livelli avverte quando l'ordine costa fermate inutili. Nero, rosso, nero vuol dire due cambi penna; nero, nero, rosso ne vuole uno e disegna le stesse righe: si contano i **blocchi di colore** e si dice quante fermate si risparmierebbero avvicinando i livelli della stessa penna. **Il riordino lo fa l'utente trascinando**, perché l'ordine decide anche che cosa finisce sopra a che cosa. C'è anche il rovescio — una fermata messa *fra* due livelli della stessa penna è una fermata per montare la penna che c'è già — e le due cose si inseguono: avvicinando i due neri, la fermata in mezzo diventa inutile e l'avviso cambia da solo. **Difetto mio, trovato guardando e non leggendo il collaudo:** il colore era scritto come attributo `stroke`, che *perde* contro la regola CSS della classe — l'attributo giusto nell'HTML e i tratti grigi sullo schermo. Adesso è uno stile, e il collaudo guarda il **colore calcolato** invece dell'attributo.
- [2026-10-31] **La penna di un livello si sceglie, non si deduce soltanto.** Il colore era *solo* la tinta delle forme, e il commento diceva che tenerne una copia vorrebbe dire averne due che a un certo punto non coincidono più. Resta vero, ed è per questo che la scelta non sostituisce la tinta ma la **copre**: la tinta del file resta intatta e togliere la scelta la fa riapparire. Serve perché il colore con cui un disegno è stato fatto e la penna con cui lo si stampa sono due cose diverse — un logo nero si può voler stampare in rosso — e perché un livello disegnato a mano non aveva nessuna tinta né modo di dargliene una. Si sceglie dal **pallino**, che adesso c'è sempre, anche vuoto: passandoci sopra esce la tavolozza con le penne in cassetto più un «+». Il selettore ha **tre cursori** e non solo l'arcobaleno, perché il grigio — che è una delle quattro penne — dall'arcobaleno non esce: è una tinta qualunque con la vivezza a zero. Il cassetto sta nel browser come l'indirizzo del telecomando (sono le penne di chi stampa, non della macchina); la scelta per livello sta nel progetto, perché è del disegno. E al cambio penna la finestra la chiama **col nome che le hai dato**: «monta la rossa» si capisce senza guardare, «#c8102e» no. `tavolozza-test.js`, 23 asserzioni.
- [2026-10-29] **Il pulsante del disegno di prova è diventato «Inserisci il logo GDC Stuff»**, su richiesta dell'utente: non è una prova, è il logo che mette davvero nelle stampe, e chiamarlo «esempio» diceva una cosa falsa su cosa fa. Sta dentro a una riga perché quando ci sarà il logo della macchina gliene nasce uno accanto.
- [2026-10-31] **Cambiare foglio smontava il disegno.** L'utente aveva disegnato il biglietto su un A5 perché le misure del foglio vero non si sapevano ancora; misurate e scelte, il disegno «si è deformato». Non era un errore di calcolo: il gestore del cambio foglio **buttava via rettangolo e ritaglio di ogni livello**, e il ricalcolo senza rettangolo ne rifà uno adattando il livello al foglio **ognuno per conto suo** — due livelli larghi diversi tornano larghi uguali, ogni pezzo torna in mezzo al foglio, e la composizione, che è l'unica cosa costruita a mano, sparisce. Era scritto come una scelta («i rettangoli erano misurati su un foglio che non c'è più») ma erano misurati in **millimetri**, e un millimetro vale un millimetro anche sul foglio nuovo. Adesso tutte le collocazioni si spostano della **stessa quantità**, metà della differenza fra i due fogli: una traslazione rigida, quindi taglie, proporzioni, rotazioni, ritagli e distanze reciproche restano al millesimo. Adattare al foglio nuovo resta un **gesto** — campo Scala o riquadro — perché farlo da soli vuol dire farlo anche quando non si vuole. Con lo stesso cambio cade un guaio che nessuno aveva visto: lo stesso segnale arriva anche quando cambia solo l'**area percorribile**, quindi toccare un margine della macchina in Impostazioni rifaceva da zero la collocazione di tutti i livelli. `cambio-test.js`, 32 asserzioni, provate anche contro il codice di prima.
- [2026-10-31] **La scala di più livelli, e un livello nuovo dall'editor.** Con più livelli scelti il campo Scala parlava solo del principale: con la spunta «scala i livelli scelti insieme» vale per tutti e scala il **gruppo** — il rettangolo che li contiene si stringe attorno al proprio centro e ognuno ci resta dentro nella stessa frazione di prima. Scalare ogni livello della stessa percentuale ma attorno al *proprio* centro (la cosa che sembra uguale) li allontanerebbe l'uno dall'altro. La **rotazione** resta di un livello solo anche con la spunta: ruotare il gruppo vorrebbe dire ruotare ogni disegno attorno a un centro che non è il suo. E «**+ livello nuovo**» nell'editor fa un livello vuoto che **copia la mappa** di quello che si sta modificando: senza, l'editor non avrebbe coordinate in cui disegnare dietro gli altri livelli e la tela resterebbe vuota proprio mentre si guarda dove incollare. Serve a staccare un pezzo di un disegno importato — i testi di un biglietto — per lavorarci da solo.
- [2026-11-03] **Il colore della carta e lo spessore del tratto: l'anteprima somiglia al foglio.** Un disegno guardato su carta bianca immaginaria, tutto a tratto sottile, non dice se il tratteggio si impasterà col pennarello né se la penna nera si vedrà sul cartoncino nero: lo dice la stampa, venti minuti dopo. La **carta** si sceglie nella stessa finestrella del nome e delle misure, e sta accanto ai formati nel profilo — non dentro al profilo di stampa — perché è una proprietà della risma che hai in casa: cambiare profilo non fa diventare bianco il cartoncino nero. È un **elenco e non una mappa** perché `fondi()` ricopia solo le chiavi che conosce già, e una mappa libera sarebbe tornata vuota al primo caricamento; la chiave è la **misura ordinata**, così vale anche per A4, A5 e A6 — che un record non ce l'hanno, sono costanti del mondo — e un foglio girato per il lungo resta lo stesso foglio. Un foglio scuro prende il **bordo chiaro**: su un piano `#171b22` un cartoncino nero senza bordo non è un foglio, è un'assenza. Lo **spessore** è per livello, con spessori nominati e salvabili come le penne (*fine, tratto pen, indelebile, pennarello*) e i millimetri scritti, perché sulla penna c'è stampato un numero e il gesto è cercare quello. Dentro all'SVG si disegna in millimetri, quindi `stroke-width: 0,8` **è** una riga larga 0,8 mm sulla carta.
- [2026-11-03] **Una penna che non si distingue dalla carta non è un difetto dell'anteprima: è una stampa che esce vuota.** L'elenco dei livelli lo dice, col contrasto WCAG sotto 1,6. Succede davvero — nero su cartoncino nero, bianco su carta bianca — e si scopre dopo venti minuti di macchina se nessuno lo dice prima.
- [2026-11-03] **La tab «In stampa»: il racconto di una stampa, che resta.** Nasce da sola quando parte una stampa, ci si va sopra subito, e a differenza delle altre **si può chiudere** — non è una parte del programma, è il racconto di UNA stampa, e di stampe se ne fanno tante. Dentro: il percorso che avanza sul foglio (grigio il da fare, azzurro il fatto, tratteggiati gli spostamenti, un pallino dove sta la punta), la **riga di G-code in corso** con nove righe prima e nove dopo, i cambi penna segnati dove cadono, e il registro di quella stampa. Finita, la × si accende e la linguetta prende un pallino verde, ambra o rosso. Oltre sei, la più vecchia se ne va. **Ogni tab si porta via una copia della sua stampa** — programma, foglio, carta, colori — ed è la decisione che fa funzionare il resto: leggendo lo stato vivo basterebbe caricare un altro disegno per riscrivere la storia di una stampa già fatta, e una tab aperta diventerebbe un racconto falso, credibile per giunta. Il **percorso si ricava dal G-code** e non dal disegno sul foglio: è quello che la macchina ha davvero ricevuto, ottimizzatore compreso, e ogni tratto sa da quale riga viene, quindi «a che punto siamo» è una corrispondenza esatta invece di una proporzione.
- [2026-11-03] **Una penna è un colore E uno spessore, e il terzo avviso non c'era.** Finché lo spessore non esisteva, «stessa penna?» si rispondeva col colore; dal giorno dopo quella risposta è sbagliata nel verso peggiore — diceva «questa fermata è inutile, toglila» di una fermata che serve. L'identità è `colore|spessore` e da lì passano tutti gli avvisi. Scavando è venuto fuori che **il caso più caro non lo segnalava nessuno**: due livelli di seguito che vogliono penne diverse e nessuna fermata in mezzo. La macchina tira dritto e il secondo livello esce con la penna del primo — un foglio intero sbagliato, scoperto a stampa finita. Valeva già per i colori; con lo spessore i modi di cascarci raddoppiano. Adesso lo dice, dice **perché** («cambia lo spessore»), e accende il simbolo della penna **sulla riga dove la fermata va messa**: con dodici livelli, sapere che ne manca una senza sapere quale è un lavoro. La fermata non si mette da soli, perché l'ordine dei livelli decide anche cosa finisce sopra a cosa. Lo spessore viaggia anche nel commento `;PENNA` del programma: «monta la nera» non è una risposta se di nere ne hai due.
- [2026-11-08] **L'editor impara a ruotare e a ingrandire**, chiesto dall'operatore. Nella tab Disegno si faceva già, col riquadro sul foglio, ma quello lavora su **livelli interi**: qui serve girare una freccia e basta. Sono lo stesso gesto dello specchio con un'altra matrice, e come lui lavorano **attorno al centro di quello che è scelto**, così la cosa resta dov'è. Il verso: le coordinate di un livello sono quelle del file da cui viene, cioè di un SVG — la y cresce verso il **basso** — quindi un angolo positivo gira in senso **orario**, ed è quello che dice il campo. Un **testo ingrandito resta un testo** (l'altezza è un numero che la forma tiene), **ruotato diventa tracciati** (una parola storta non si può scrivere da nessuna parte): la stessa regola dello specchio. Un giro intero, il 100% e lo zero non fanno niente e non sporcano la pila dell'annulla.
- [2026-11-08] **La fermata che manca si segna col quadratino, non colorando la matita.** Detto dall'operatore: «colorando la matita mi confonde e non capisco se è già attiva o meno». Aveva ragione, e il difetto era nel disegno dell'avviso: «la stampa si ferma qui» e «qui dovrebbe fermarsi e non si ferma» sono due cose **opposte**, e portavano tutt'e due il giallo — l'unica differenza era un anello da un pixel, che l'occhio legge dopo il colore. Adesso il giallo sulla matita vuol dire una cosa sola: la fermata c'è. Il banco guardava solo la *classe* CSS e questa regressione non l'avrebbe vista: adesso legge i colori veri (`getComputedStyle`) e pretende che i due stati **differiscano per il colore della matita**, non per il contorno.
- [2026-11-08] **I nomi si possono scrivere**, livelli e fogli, chiesto dall'operatore. Li metteva il programma — «antei.svg · tratto #1f4fa8», «Personalizzato» — e con diciotto livelli su nove magneti non dicono più niente. Il nome del foglio **esce dalla pagina**: sta nell'intestazione dei livelli, nel marcatore `;FOGLIO n/N nome` del programma e sul vetro del telecomando, cioè è l'unico modo di sapere a stampa iniziata su quale pezzo di carta va la penna.
- [2026-11-03] **Un difetto vecchio di quattro giorni, trovato lavorando accanto.** Il segno azzurro di «questo pezzo l'ha già fatto» nell'anteprima non si vedeva più **da quando i livelli hanno una penna** (2026-10-29): il colore si scrive come stile sulla riga — deve farlo, se no la regola `.trace-draw` vince e i tratti restano grigi — e uno stile sulla riga batte qualsiasi regola del foglio di stile. Coloriva solo i livelli senza tinta, cioè quelli disegnati a mano, cioè quasi mai: per questo era passato inosservato per quattro giorni.

- [2026-11-01] **Il telecomando ha una scheda sua nelle impostazioni**, invece di stare sparso dentro a «Connessione»: è una scatola a parte, con una rete sua, un collaudo suo e modi suoi di rompersi. Dentro, oltre alla prova in bianco: **una schermata per volta**, dieci pulsanti che mandano uno stato e lo **tengono fermo** finché non ne premi un altro — guardare una schermata con la recita voleva dire aspettare il momento giusto e fotografarlo — e la **spia del dialogo**, una spunta che scrive nel registro ogni messaggio che esce (→) e ogni risposta che torna (←), spenta di suo perché a stampa in corso sono due e mezzo al secondo. Un tasto premuto mentre una schermata è ferma **non fa niente e finisce nel registro**: è il modo di provare un pad per volta. Trovati e chiusi due buchi per strada: una **stampa vera non spegneva la prova** (il controllo si faceva solo premendo, e se la stampa partiva dopo il vetro restava a recitare), e il **campo dell'indirizzo restava vuoto all'avvio** con scritto «Collegato» due righe sotto, perché le impostazioni si accendono prima del telecomando.
- [2026-11-08] **«Da fotografia a tracciato» esce da questo step** (decisione dell'utente). Non si costruisce nel SLICER: la trasformazione la fa il fronte stampe, in chat, con codice deterministico scritto per il caso — due tipologie già stabilite, la foto tracciata (la coppia sulla spiaggia) e i contorni ricavati da file 3D (cane, ragazzi, angioletti). Il flusso che l'utente vuole è quello: dai il file, dici la tipologia, ne crei altre quando servono. *Resta vera la decisione del 2026-09: algoritmi deterministici, mai un modello generativo — un modello non ricalca, inventa percorsi plausibili.* Quello che invece varrebbe la pena portare nel SLICER è il **giudizio**, non la trasformazione: un controllo «si vedrà?» che prima di stampare dica dove il disegno è più fine della penna che ci monti — tratti più vicini della larghezza del pennarello, che sulla carta diventano una macchia sola. È il guaio già preso due volte (vedi Step 10, 2026-11-05: l'indelebile da 1,5 mm che impastava le lettere), e si può fare solo dove vive la larghezza della penna. Proposto, non ancora chiesto.
- [2026-11-08] **L'interfaccia per schermi piccoli è un lavoro dichiarato**, non un dettaglio di stile: la pagina è disegnata per uno schermo largo, e il giorno in cui il telecomando la servirà da un indirizzo solo (Step 13) un telefono la aprirà senza poterla usare. Sta qui perché è lavoro sul SLICER, ma dipende dallo Step 13 e va dopo.
- [2026-11-09] **Un cursore che mostra il valore sbagliato non è un difetto di presentazione: è un comando che non si può più dare.** Il cursore del volume del telecomando si costruisce in `Settings.init()`, che gira PRIMA di `Telecomando.init()`: leggeva il valore predefinito (10) mentre in vigore c'era il 2 salvato giorni prima. E rimetterlo a 10 non mandava niente, perché a 10 ci era già. Adesso il volume viaggia nel segnale `telecomando` e il cursore lo segue, quindi l'ordine dei moduli non c'entra più; e la risposta del telecomando — che il volume vero lo rimanda da sempre — adesso viene letta, e quando i due numeri non coincidono la nota sotto al cursore lo dice. Conseguenze: vedi la voce del 2026-11-09, perché quel 2 teneva il telecomando su una strada che lo piantava a ogni stampa.
- [2026-11-08] **La scheda dei fogli rifatta, e i fogli vuoti nell'elenco.** Due cose chieste dall'utente usando il programma. (1) In cima stanno i **preset** — un elenco di misure che si hanno in casa — e premerne uno **aggiunge** un foglio invece di cambiare le misure di quello in uso: il difetto vero era che un preset premuto con un disegno già sopra cambiava la carta sotto ai piedi. Le due caselle delle misure salgono accanto ai preset col «+» di fianco, e il «+» è uno solo: salva il preset se quelle misure non ce l'hanno già, e aggiunge comunque il foglio. Ogni foglio del piano porta i due comandi dei preset — matita (nome, misure, carta) e cestino — al posto della crocetta sul fianco. (2) **Un foglio senza disegni sopra adesso sta nell'elenco**, segnato vuoto: l'elenco è fatto di FOGLI e non più di livelli con un'intestazione quando il foglio cambia, e il foglio vuoto è esattamente quello su cui si vuole trascinare un livello. Di conseguenza: lasciando sotto a tutto si legge la riga e non l'ultimo livello (se no il livello tornava indietro), e l'elenco si rifà a ogni segnale `fogli` — prima un foglio aggiunto compariva solo al gesto successivo.
- [2026-11-11] **Due difetti nella MIRA del piano e nella spunta dei livelli, diagnosticati e rimandati** su decisione dell'utente («aspettiamo anche per queste modifiche»): si aggiusteranno insieme ai riempimenti dello Step 14. L'utente li ha descritti usando il programma: «ogni tanto non prendo la forma», e «la spunta ogni tanto deseleziona quella precedente e ogni tanto le seleziona entrambe». **(1) La mira è nel sistema di riferimento sbagliato.** `quale(p)` in `artwork.js` confronta il punto col `box` di ogni livello, che è in millimetri del SUO foglio, ma il punto arriva da `paper.js` misurato dall'angolo del foglio **in uso**: con più fogli sul piano la mira è spostata della distanza fra i due angoli. Provato al banco — due fogli, il disegno sul secondo, il primo in uso, doppio clic esattamente al centro del disegno: la funzione risponde `null`, non prende niente; nel sistema del suo foglio risponde correttamente. Quando i fogli sono vicini a volte prende la cosa giusta per caso. **È lo stesso errore corretto nell'anteprima il 2026-11-08** (`artFoglio`, i disegni che seguivano il clic): nell'anteprima è stato visto perché si guarda, nella mira è sopravvissuto perché nessuno l'aveva guardata. **(2) La mira guarda il rettangolo, non l'inchiostro:** un clic nel vuoto dentro al rettangolo prende il disegno, e il rettangolo di un disegno grande ruba il clic a quello piccolo che sta sotto (il piccolo si raggiunge solo ripetendo il doppio clic nello stesso punto, dal secondo in poi). **(3) La spunta non ha difetti, ha una regola muta:** commuta, e un livello di un ALTRO foglio fa ricominciare la scelta da lì — provato — perché una selezione a cavallo di due fogli non ha un rettangolo in comune (regola del 2026-11-07, da tenere). Manca solo che venga detto. Contorno stretto di gesti: la spunta è **18 × 18 px**, il nome — che sostituisce la scelta per disegno — sta 33 px più in là, e un doppio clic sulla riga sostituisce la scelta e apre il riquadro. **Le correzioni proposte:** la mira prende millimetri del PIANO e sottrae l'angolo di ogni livello; fra i livelli il cui rettangolo contiene il punto vince quello con un tratto entro un paio di millimetri (costanti in pixel di schermo), col ripiego di oggi se nessuno è vicino; e il cambio di foglio si dice, col quadratino dei livelli di altri fogli segnato in modo diverso.

- [2026-11-12] **Chiesto dall'utente: un menù «disegni recenti» e un salvataggio automatico che non si perde.** Oggi un disegno non salvato muore con la pagina, e il salvataggio esplicito (`progetto.js`) non permette nemmeno di **cambiare il nome** del file mentre si salva: il nome esce da `State.data.artName`. La richiesta è un menù in alto a sinistra nella sezione Disegno con le ultime cose costruite, alimentato da un salvataggio automatico temporaneo, raggiungibile **da ogni dispositivo** attraverso la SD del telecomando. **Il disegno proposto (da confermare nei numeri):** (1) non «alla chiusura della pagina» ma **continuo**, perché alla chiusura il browser non garantisce niente — `beforeunload` non può fare una richiesta di rete affidabile, `sendBeacon` è un colpo solo senza risposta, e una scheda uccisa dal sistema non manda alcun evento; (2) **due livelli**: IndexedDB in locale, immediato e sempre disponibile anche col telecomando spento (non `localStorage`: 5 MB e sole stringhe), e la **SD** per la copia condivisa, spinta con ritmo lento e **mai durante una stampa** — la SPI è divisa col vetro; (3) **venti slot** come regola principale più un taglio a **30 giorni**, perché la cosa da proteggere non è lo spazio (20 recuperi da 300 kB sono 6 MB su 32 GB) ma la leggibilità del menù e il numero di scritture sulla scheda; (4) **un recupero per sessione di lavoro**, non uno ogni trenta secondi: lo slot si riusa e se ne apre uno nuovo al ricaricamento della pagina, al caricamento di un file nuovo o dopo una pausa lunga — senza questa regola venti slot diventano venti copie della stessa cosa; (5) **recuperi e progetti restano due cose diverse** e nel menù stanno in due gruppi: i recuperi sono automatici, scadono e si sovrascrivono, i progetti li salva l'utente con un nome e non scadono. **Il livello locale, il menù e il rinomina al salvataggio non hanno bisogno della scheda**: si possono fare e provare al banco prima del 23 novembre. Il secondo livello e il «da ogni dispositivo» dipendono dal passo 3 del lavoro 1 dello Step 13.

- [2026-11-12] **Serve un avviso quando un dispositivo usa i numeri di fabbrica, e oggi non c'è.** Conseguenza della domanda sull'iPad (vedi Step 13): `Profile.load()` parte dai valori compilati nella pagina e ci fonde sopra `localStorage`, quindi su un dispositivo nuovo il profilo **sembra** a posto — i campi sono pieni, i numeri sono plausibili perché sono le misure vere del build — ma può non essere quello in vigore sul PC. Il più insidioso è l'**alzata della penna**, che viene dagli angoli del servo nel profilo: un'alzata più piccola del vero vuol dire la punta che striscia sul foglio durante gli spostamenti, e lo si scopre sulla carta. **Avviso proposto, proporzionato:** una fascia alla prima apertura su un dispositivo che non ha mai avuto un profilo suo («questo dispositivo usa i numeri di fabbrica della pagina, misurati il …») con un pulsante solo, *prendi il profilo dalla macchina*; una riga nei popup di inizio stampa che dice quale profilo è in uso e di quando è; e un avviso quando il profilo del dispositivo e quello sulla scheda **differiscono**, dicendo in quali campi. Niente blocchi: i tre popup già chiedono le misure del giorno.

- [2026-11-13] **Che cosa del lavoro «stampe» ha senso portare nello SLICER, e che cosa no.** Domanda dell'utente dopo il mese di lavoro sul fronte stampe (Step 16). **I motori non ci vanno:** sono Python con `numpy` e `Pillow`, lo SLICER è una pagina che gira da `file://` senza server e il telecomando è un SAMD21 con 32 kB di RAM — portarli in JS non è integrare, è riscriverli peggio; e lo esclude già la decisione del 2026-11-08 («da fotografia a tracciato esce da questo step»). **Quello che invece si integra, perché i due pezzi sono già fatti per darsi la mano:** `penne.json` dichiara che *il colore è l'identificativo del livello nello SLICER*, l'uscita è un SVG in millimetri con un `<g>` per colore (cioè quello che «un livello per tinta» importa senza una piega), `controlla.py` **legge già i file salvati dallo SLICER**, e il motore delle stampe **dipende** da `webui/js/font-tratto.js` — la dipendenza corre nel verso opposto. Quattro cose in ordine di valore: **(1)** i controlli di `controlla.py` — sovrapposizione **1,8×** di inchiostro su area e segmenti sotto **0,15 mm** — da portare nello SLICER **insieme ai riempimenti**, perché 1,8× *è* la versione misurabile del passo del tratteggio e arriva già tarata su sette livelli di dettaglio (il report segnala da sé «Layer massimo: 3,3×»); **(2)** una penna sola per i due, `penne.json` letto dallo SLICER e messo sulla scheda accanto al profilo, con la stessa regola — la macchina tiene la copia, il PC resta il padrone; **(3)** il catalogo come **cartella di disegni sulla SD**, che è il passo 2 del lavoro 1 dello Step 13 già previsto: gli SVG delle stampe *sono* quella cartella, col loro `scheda.json` e `report.txt`; **(4)** la **provenienza** che viaggia col disegno, così aprendo un file generato lo SLICER dice «Layer, dettaglio massimo, sovrapposizione 3,3×» invece di «file.svg, 12 livelli». **Lo strumento a pagina resta dov'è** (pagina più server Python locale: lo SLICER non ha un server da chiamare e il telecomando non fa girare Python).
- [2026-11-13] **Il collegamento allo strumento stampe va in «dove trovare disegni»** (`sorgenti.js`), chiesto dall'utente: è il posto giusto, quell'elenco è nato per crescere. Tre cose da fare bene, non una riga: **(a)** va in `DI_SERIE` come secondo collegamento di serie accanto a Book of Shapes, con un **nome suo** — `aggiungendolo a mano l'elenco lo chiamerebbe «127.0.0.1»`, perché il nome lo ricava dall'hostname; **(b)** non è un segnalibro ma **un programma sul PC**, quindi va marcato come tale e l'indirizzo deve essere **modificabile** come quello del telecomando: `127.0.0.1` vuol dire «questo dispositivo», e dall'iPad porterebbe a sé stesso — lo strumento si apre a tutta la rete con `--host 0.0.0.0`; **(c)** accanto al collegamento ci va il comando per avviarlo, copiabile, perché il link funziona solo mentre il serverino gira. **Da sapere:** oggi incollarlo senza schema non funziona — `aggiungi()` forza `https://` e lo strumento parla `http`; scritto per esteso `http://127.0.0.1:8765` funziona già. Una spia «risponde / non risponde» è possibile solo se il server dello strumento manda un header `Access-Control-Allow-Origin`: senza, il browser blocca la prova. La farei **dopo**, se la mancanza dà fastidio.

- [2026-11-13] **Avviare lo strumento da un pulsante: no. Aprire il risultato nello SLICER: sì.** Due domande dell'utente sul collegamento allo strumento. **(1) Un pulsante che AVVII il serverino non si può fare:** una pagina web non lancia programmi sul computer, e non è una mancanza da aggirare — è il confine che impedisce a qualunque pagina di farlo. Le tre strade vere, in ordine di valore: **avvio automatico al login** (così il link funziona sempre e la domanda sparisce), un **file da doppio clic** (`.bat` su Windows, `.command` su Mac) che lo avvia e apre il browser, e — scartata perché sproporzionata — uno **schema URL registrato** (tipo `cnc2d://`), che funziona ma vuole installare roba nel sistema. In più, lo SLICER può **dire se è acceso**: `/api/ping` esiste già, basta l'header CORS. **(2) «Apri nello SLICER» dal riquadro dei download si può, in due modi**, e nessuno dei due è grosso. *Lo strumento spinge:* la pagina dello strumento, aperta DAL collegamento, ha `window.opener` e può passare l'SVG allo SLICER con un `postMessage` — e qui c'è il dettaglio che conta: il collegamento oggi porta `rel="noopener noreferrer"`, che per un sito esterno è giusto e va tenuto, e per questo collegamento solo va togliere. *Lo SLICER tira:* `/api/job/<id>/svg` esiste già e `invia()` accetta header aggiuntivi, quindi **una riga** di `Access-Control-Allow-Origin` sul server dello strumento basta perché lo SLICER si prenda da sé l'ultimo lavoro — e allora può anche mostrare un elenco «ultimi disegni dallo strumento», che è parente del menù «disegni recenti». **Preferirei il secondo**, col primo in aggiunta se viene gratis: funziona anche se le due schede sono state aperte per conto loro, e porta l'elenco invece del solo ultimo file. Resta da sapere **su quale sistema** gira il PC dell'utente, perché il file da doppio clic e l'avvio al login si scrivono diversi.

- [2026-11-13] **L'idea dell'utente: lo SLICER consegna l'avviatore, e «apri file» del browser lo esegue.** Si può, ed è la cosa più vicina al pulsante che chiedeva: la pagina non lancia niente — genera un file e lo scarica, come fa già col progetto salvato — e a eseguirlo è il comando *apri* del browser, cioè un click dell'utente. Il confine resta dov'era. **Due cose buone:** il file non ha dipendenze (è testo), e la pagina può scriverci dentro il **percorso giusto**, perché da `file://` conosce il proprio indirizzo e da lì ricava dov'è il repository — un avviatore generato è quindi corretto senza che l'utente scriva niente. **Due cose da dire:** un `.bat` è un eseguibile, quindi il browser avvisa («potrebbe essere dannoso») e va tenuto a mano la prima volta; e scaricarlo **ogni volta** sarebbe peggio di una scorciatoia sul desktop — i Download si riempirebbero di copie e si prenderebbe l'abitudine di passare sopra agli avvisi sui `.bat`, che è un'abitudine da non prendere. **Quindi si usa una volta:** un pulsante «Scarica l'avviatore», il file va sul desktop o — meglio — nella cartella di avvio automatico (`shell:startup` su Windows), e da quel momento lo strumento c'è sempre e il collegamento funziona sempre. **Differenza fra i sistemi, da non scoprire dopo:** su Windows il `.bat` scaricato si esegue; su macOS un `.command` scaricato **arriva senza il permesso di esecuzione**, quindi lì il trucco non funziona e la strada è un'altra (LaunchAgent o una piccola app). Serve sapere su che sistema sta il PC dell'utente.

- [2026-11-13] **Il PC è Windows, e l'avvio automatico è stato rifiutato dall'utente.** Sua proposta: scaricare l'avviatore una volta, lasciarlo nei Download, e avere nello SLICER un pulsante che **filtri i Download** e proponga solo quel file da avviare. **Non si può, e il motivo è lo stesso muro di prima spostato di un passo:** una pagina non può leggere né elencare una cartella del computer, e il selettore di file — che pure si apre filtrato su `.bat` — restituisce alla pagina il **contenuto** del file, non il potere di eseguirlo. Scegliere un `.bat` in una pagina web vuol dire leggerlo, non lanciarlo. **Quello che invece dà la stessa ergonomia:** l'elenco dei download del browser **conserva la voce**, quindi si scarica una volta e da lì in poi `Ctrl+J` e un click sul nome del file lo avviano — due click, nessuna copia nuova, nessun avvio automatico. Lo SLICER non può portarci da sé (le pagine non possono aprire indirizzi `chrome://`), quindi il suo compito resta consegnare il file la prima volta e scrivere accanto al collegamento che poi è `Ctrl+J`. **Alternativa con meno click, se si rinuncia a «tutto dallo SLICER»:** una scorciatoia all'avviatore **appuntata sulla barra delle applicazioni** — un click, sempre lì, nessun avvio automatico. Da scegliere con l'utente; in entrambi i casi la **spia** accanto al collegamento resta utile, perché dice se c'è bisogno di avviarlo.

- [2026-11-13] **La strada scelta dall'utente, e i quattro pezzi da costruire.** Approvato il giro: pulsante che consegna l'avviatore (una volta), `Ctrl+J` per avviarlo (ogni volta), collegamento allo strumento, «Apri nello SLICER» per il risultato. Serve: **(1)** la voce «Strumento stampe» in `sorgenti.js` con indirizzo modificabile e **spia** acceso/spento, **(2)** il pulsante **«Scarica l'avviatore»**, che genera il `.bat` col percorso ricavato da `location.href`, **(3)** una riga di `Access-Control-Allow-Origin` in `invia()` di `strumento.py` — serve sia alla spia (`/api/ping`) sia al prelievo del risultato (`/api/job/<id>/svg`) —, **(4)** il pulsante «Apri nello SLICER» nel riquadro dei download dello strumento. **Due dettagli operativi da non scoprire sul campo:** il `.bat` apre una finestrella di console che **deve restare aperta** (chiuderla spegne lo strumento) e conviene farla partire **ridotta a icona**; e il percorso dentro l'avviatore è scritto una volta sola, quindi **se la cartella del progetto si sposta l'avviatore va riscaricato** — il pulsante lo rigenera aggiornato, ed è un motivo in più per tenerlo in pagina invece di darlo una volta e dimenticarsene.

- [2026-11-14] **L'avviso dei numeri di fabbrica c'è, e dice anche perché importa.** Fatta la prima metà dell'avviso proposto il 2026-11-12: la pagina adesso **distingue** un dispositivo che ha un profilo suo da uno che sta usando i numeri compilati nel file, e lo dice nei posti in cui un profilo sbagliato fa danno. `Profile` tiene un solo dato nuovo — se in memoria c'era un profilo di questo dispositivo — più la data delle misure di fabbrica (`MISURE_DI_FABBRICA`, oggi il 2026-10-24, lo zero della tavola) e **una sola frase**, `provenienza()`: le tre interfacce la mostrano, nessuna se la riscrive, perché tre copie della stessa frase divergono al primo ripensamento. I tre posti: una **fascia** sotto le tab alla prima apertura, col pulsante che porta nelle impostazioni (dove il profilo si importa) e una × che non si ricorda — un avviso di sicurezza che si spegne per sempre al primo clic si spegne il primo giorno; una **voce nella verifica** delle impostazioni, come **avviso e non blocco**, perché da un dispositivo di fabbrica si stampa — i tre popup chiedono comunque le misure del giorno —, e farne un blocco vorrebbe dire rendere impossibile stampare dall'iPad; e una **riga in ognuno dei tre popup di inizio stampa**, che è l'ultimo momento utile prima che la penna scenda, in giallo quando i numeri sono quelli di fabbrica. Il testo nomina **l'alzata della penna**: fra i numeri del profilo è quello che fa danno in silenzio, e una fascia che dicesse solo «profilo di fabbrica» non spiegherebbe a nessuno perché dovrebbe importargli. **Resta fuori** il terzo pezzo della proposta — il confronto fra il profilo del dispositivo e quello **sulla scheda**, campo per campo — che ha bisogno della SD (Step 13), e con esso il pulsante *prendi il profilo dalla macchina*: finché la scheda non c'è, il pulsante della fascia porta all'importazione da file, che è la strada che funziona oggi. Banco nuovo: `webui/tools/prova-profilo.js`, 19 controlli, e **otto mutazioni** in `rompi.py` (da 238 a 246) tutte viste — compresa quella che trasforma l'avviso in blocco, che è il modo in cui questa cosa potrebbe peggiorare la vita invece di migliorarla.

- [2026-11-14] **L'adattamento al dito, prima parte: la pinzata e i bersagli.** Chiesto dall'utente di anticiparlo ai riempimenti, e la ragione è buona: il gesto del tocco è un **ingresso** del disegno dei riempimenti — «il mouse anticipa il riempimento» su un touch non esiste —, quindi deciderlo prima costa mezza riga e deciderlo dopo costa un rifacimento. **Che cosa mancava davvero** (guardato, non ricordato): il layout si riorganizza già da solo e i gesti sono già scritti con i pointer event, quindi trascinare un foglio o un livello **funziona già col dito**; mancano invece la **pinzata** (il piano e la tela si ingrandivano solo con la rotella, che su un tablet non c'è), i **bersagli da dito** (il quadratino di un livello è 18 × 18 px), le alternative a **Ctrl/Shift** (15 punti fra `editor.js` e `selezione.js`) e al **tasto destro**, e le **34 regole di `:hover`**, cioè informazioni che col dito non compaiono mai. **Fatto oggi:** la pinzata, in un modulo solo (`webui/js/tocco.js`) usato dal piano e dalla tela, perché l'aritmetica dell'ancoraggio sbagliata non si vede subito — si vede che il disegno «scappa» mentre si allargano le dita — e due copie divergono alla prima correzione; i bersagli a **40 px** sotto `pointer: coarse`, che è la domanda giusta (un iPad da tredici pollici è larghissimo e resta un dito) e non la larghezza della finestra; e il passaggio del mouse che col dito diventa `:active`. **Due cose imparate rompendo:** gli eventi del tocco arrivano **un dito alla volta**, quindi una pinzata fondata al primo movimento misura un dito già partito e uno ancora fermo — mezzo passo, che ingrandendo di tre volte diventa i dieci pixel di cui il disegno scappa; e il conto va tenuto **assoluto** sull'inizio del gesto, così due dita che tornano dov'erano riportano il disegno esattamente dov'era. Il verso della y non è scritto da nessuna parte nel modulo: si **misura**, chiedendo due punti alla mappa di chi chiama — ed è il motivo per cui ce n'è uno solo per il piano (y in su) e la tela (y in giù). Banco nuovo `webui/tools/prova-tocco.js`, **12 controlli** col tocco emulato davvero via CDP, e **dieci mutazioni** in `rompi.py` (da 246 a 256) tutte viste. **Poi, dopo la prova dell'utente:** le **proporzioni** del riquadro diventano una spunta che Shift capovolge (erano solo Shift, cioè niente su un tablet), e ogni maniglia d'angolo prende una **presa trasparente da 30 px** sotto al quadratino visibile da 9, perché col dito quei nove pixel non si prendono. **Poi, lo stesso giorno:** i due ultimi comandi che vivevano solo in un tasto — i **magneti fra i fogli** (spunta nella colonna, Alt la capovolge) e **«Somma»** nell'editor (interruttore nella barra, Ctrl lo capovolge). **Resta della parte (a):** le informazioni affidate al solo passaggio del mouse, e il giro delle **schermate strette** (il telefono), che è impaginazione e non gesti.

### Step 5 — Struttura meccanica

**Stato:** **completato nella struttura** (2026-10-15), con **una cosa aperta** che non la ferma: una **planarità da sorvegliare** sotto la staffa TT di sinistra. (L'altra, l'area ristretta del 2026-10-23 — il pignone del carrello X tocca la cremagliera dell'asse Y sul lato destro prima della fine corsa, e X perde 10 mm prudenziali sui 5 misurati: 251,232 × 236,064 → **241,232 × 236,064** — **si è chiusa il 2026-11-12 per decisione dell'utente, che si tiene i dieci millimetri**: spostare la cremagliera guasterebbe la simmetria della macchina. Non è un lavoro rimandato, è un lavoro che non si fa: **241,232 × 236,064 è l'area definitiva**, ed è il motivo per cui nove magneti 75 × 75 ci stanno per un pelo e un A4 non ci sta.) Il **gioco** del criterio l'utente lo dà per misurato e buono (confermato il 2026-11-08); nel profilo resta come numero di sola lettura che spiega gli artefatti

**Obiettivo:** struttura a portale che porta la penna su un'area di **circa 242 × 256 mm**, con entrambi gli assi motorizzati e il pen-lift solidale al carrello Y. *(Formato ridimensionato il 2026-10-06: l'obiettivo originale era "tutta l'area di un foglio A4 in orizzontale", ma con cremagliere in un pezzo solo il lato da 297 non entra su nessuno dei due assi — il massimo raggiungibile è 281,6 × 292,8. L'area è equivalente a un A4, la forma è quadrata. Un A4 vero richiede una cremagliera giuntata.)*

**Decisioni progettuali:**
- **Trasmissione a cremagliera e pignone**, non a cinghia. Motivo: si stampa in 3D a costo quasi nullo, mentre le cinghie richiedono cinghia, pulegge e tenditori acquistati. Alternativa scartata: cinghia GT2, che avrebbe gioco quasi nullo e motori fissi — resta la via di ripiego se il gioco della cremagliera risultasse ingestibile, e non richiederebbe di rifare la struttura ma solo i supporti dei motori
- **Motore solidale al carrello**, conseguenza intrinseca della cremagliera: per tenere il motore fermo dovrebbe muoversi la cremagliera, raddoppiando lo spazio necessario. Comporta ~300 g di massa mobile in più sull'asse X, da compensare con velocità moderate
- **Gioco gestito assottigliando il dente della cremagliera di 0,2 mm, non con un precarico a molla.** Supera la decisione del precarico a molla: il gioco effettivo si regola con la profondità di ingranamento (per una cremagliera `j = 2·Δc·tan20°`, quindi 0,2747 mm di avvicinamento azzerano lo 0,2), e il metodo pratico è la striscia di carta da 0,10 mm nel punto più stretto. Una molla avrebbe aggiunto un grado di libertà su un carrello che ne ha già abbastanza. Impostazione precedente: precarico a molla del pignone contro la cremagliera: il motore non è fissato rigido ma su una piastrina che oscilla attorno a un perno, tirata verso i denti da una molla. È la contromisura al gioco fra denti stampati, che su un plotter — che inverte direzione a ogni segmento — si tradurrebbe in contorni che non chiudono e tratti sdoppiati
- **Due vincoli a livelli diversi**: il carrello è catturato dalla guida e non può sollevarsi, il motore resta libero di flottare sul carrello. I due vincoli agiscono su corpi diversi e non si annullano a vicenda
- **Cuscinetti 608ZZ (8 × 22 × 7) per la pinza sui labbri, MR63 (3 × 6 × 2,5) per la guida laterale.** Supera la scelta dei 623ZZ del 2026-09-25: i 608 erano già in casa, e il profilo reale acquistato ha labbri sporgenti che si prestano a essere pinzati da una ruota sopra e una sotto. Otto 608 (due per stazione, due stazioni per fianco) più quattro MR63 dentro il canale. La pressione di contatto di un 608 a 3 N è 27 MPa contro i 150 a cui cede l'alluminio: margine 5×. Impostazione precedente, mantenuta come principio: cuscinetti 623ZZ (3 × 10 × 4) che rotolano su guide metalliche, non cuscinetti lineari su barre tonde. Il diametro è scelto sulla pressione di contatto: a 3 N un Ø10 preme sull'alluminio con 53 MPa contro i 27 di un 608 e gli 86 di un MR62, e l'alluminio cede attorno ai 150. Il foro da 3 mm è M3, **la stessa vite di tutto il resto della macchina** — motore, cremagliera, regolazioni. Le superfici di rotolamento devono essere metallo: l'anello esterno è acciaio temprato e in poche ore scava un solco nella plastica stampata
- **Ruote impilate a coppie, non sfalsate**, possibile perché due Ø10 stanno in 20 mm. La ruota di sopra e quella di sotto pinzano lo stesso punto del canale, quindi la regolazione è diretta invece che a distanza
- **Regolazione con asole M3, non con eccentrici.** Un eccentrico da mezzo millimetro di offset copre un millimetro di corsa; il gioco da recuperare può essere di due o tre. L'asola dà tutta la corsa che serve e usa M3 invece di M8
- **Perni stampati Ø3 per le ruote fisse, viti M3 con tratto liscio per quelle regolabili.** Il conto sul perno stampato dà 5,7 MPa contro i 50 del PLA. Il cuscinetto non deve mai girare sulle creste di un filetto: appoggia su tre punti e balla
- **Un profilo unico a U al posto di due staffe separate.** Le due pareti di un estruso sono parallele per costruzione, mentre due staffe avvitate a mano divergono di qualche decimo lungo la corsa. Questo toglie alla radice il problema dell'iper-vincolo, e sull'asse X rende superflua la regola della guida maestra qui sotto — che resta però valida sull'asse Y, dove le due guide sono per forza pezzi distinti a distanza di 385 mm
- **Una guida comanda, l'altra sostiene** (vale sull'asse Y, dove le guide restano due pezzi separati). La maestra vincola quota verticale, beccheggio, posizione laterale e imbardata; la secondaria vincola solo il rollio e resta libera lateralmente. Due guide montate a mano sul legno non sono mai parallele entro un decimo, e se entrambe vincolassero il laterale quell'errore diventerebbe attrito variabile lungo la corsa — il tipo di errore che non si riesce nemmeno a compensare
- **Un eccentrico per carrello**, sul cuscinetto laterale di contrasto: stampando non si azzecca mai il gioco al primo colpo. Il gioco verticale si regola invece con le asole dei profili superiori, che agiscono su tutta la lunghezza in una volta sola
- **Motore, pignone con cremagliera e cuscinetti occupano bande laterali distinte.** Il corpo del motore è 42 mm e scende quindi 21 mm sotto l'asse, mentre la cremagliera arriva a 15 mm sotto: si sovrappongono in altezza e devono per forza stare affiancati. Circa 110 mm di larghezza complessiva del carrello. Conseguenza: la flangia di fissaggio della cremagliera va su un lato solo, quello opposto al motore
- **Formato A4 in orizzontale**, corsa X ~230 mm (cremagliera da 59 denti, corsa utile ~250) e corsa Y ~317 mm. Supera il formato A5 del 2026-09-21: l'A4 in orizzontale copre l'A4 senza bisogno della corsa X da 317, perché il disegno si ruota di 90° nel software. Il vincolo che teneva la macchina piccola era la massa mobile, e si è rivelato inesistente (tetto 3410 g contro ~1150 stimati). Impostazione precedente: formato massimo A5, corse utili 200 mm su X e 300 mm su Y; un portale corto riduce anche la tendenza del ponte a mettersi di traverso, essendo spinto da un lato solo
- **Ponte in alluminio rigido**: un ponte che non flette non può sbandare
- **Base in compensato da 10 mm, 385 × 455 mm** (acquistata). Rigida e pesante: la massa assorbe le vibrazioni invece di trasmetterle alla penna. Supera l'indicazione precedente dell'MDF da 15-18 mm, scelta prima di sapere cosa si trovasse
- **Ogni millimetro di lunghezza del carrello è un millimetro di corsa in meno**, mentre la larghezza trasversale non costa corsa. Le due dimensioni vanno quindi trattate in modo diverso: stringere in larghezza quanto si vuole, non accorciare lungo la corsa per guadagnare foglio che non serve
- **Pignone modulo 1,5 con 20 denti, tutto stampato in PLA+.** Diametro primitivo 30 mm, 33,95 passi/mm, risoluzione 0,029 mm. La risoluzione non è il fattore limitante — l'errore reale della macchina sarà attorno ai 0,2 mm, dieci volte tanto — quindi quel margine conviene spenderlo in robustezza del dente
- **La compensazione dimensionale sta nello slicer, non nei modelli** (`X-Y contour compensation` a circa −0,10, `hole compensation` a 0). È una proprietà della stampante, non del pezzo: nel modello andrebbe replicata su pignone e cremagliera e si sommerebbe a quella dello slicer
- **Foro sagomato sull'albero, senza grano, da verificare sul campo.** Il calcolo dà 0,6 MPa contro i circa 50 a cui cede il PLA, quindi la coppia non è un problema; i rischi veri sono lo sfilamento assiale e l'arrotondamento dello spigolo del piatto dopo migliaia di inversioni. Verifica prevista: una riga di pennarello che attraversa pignone e albero, controllata dopo un'ora di movimento
- **Cavi mobili da progettare subito**: sette fili fra motore X e servo seguono il carrello per migliaia di cicli, servono catena portacavi o ansa flessibile
- **Motore dell'asse Y sotto la trave, a cavallo dell'anima.** La gabbia del motore è centrata sul piano dell'anima (interno Y da −6,750 a +17,250), quindi il corpo può stare solo sotto il bordo inferiore dell'anima: la quota dell'asse non è un parametro libero, è una conseguenza. Alternative verificate e scartate: **motore sopra il carrello** (costa 44 mm di franco verticale alla macchina, perché il punto più basso passerebbe da −7 a −51 — ma il modulo penna verrebbe più corto, quindi il conto vero è quasi in pari e ha deciso la comodità di attacco del modulo punta); **motore tutto fuori sul lato −Y** con la cremagliera direttamente sotto l'ala, che geometricamente funziona ma porta il baricentro a Y ≈ −37, fuori dalla carreggiata, e l'ala finisce a −42,05 quindi non c'è dove allargare l'appoggio. **Conseguenza accettata: la cremagliera non può stare sull'ala della trave, deve scendere su una base alta ~44 mm**
- **Anti-sollevamento sul bordo inferiore dell'anima, non sotto l'ala.** Due MR63 ad asse Y spingono verso l'alto contro il bordo inferiore dell'anima. Alternativa scartata: una seconda coppia di 608 sotto l'ala, che avrebbe leva migliore (Y −19,45 invece di Y 0) ma cadrebbe esattamente dove scende la cremagliera. Il carico lo giustifica: la forza tangenziale agisce sul punto primitivo a Z −20,881 mentre l'attrito che la contrasta agisce sui 608 a Z 23,500, cioè **44,381 mm di braccio** scaricati sui 60 mm di passo perni — a stallo sono ±5,4 N contro 2,15 N di peso per stazione, e una stazione si stacca
- **Un solo lato dell'asse X motorizzato, l'altro folle.** Il secondo carrello è lo stesso pezzo specchiato a X = 0, con la sede motore predisposta ma vuota. Il conto che ha deciso: con spinta da un solo lato l'estremità libera ritarda della propria deflessione elastica, `EI ≈ 2,6·10⁹ N·mm²` per la sezione a T, e a 0,3 g fa **3÷9 µm con trave da 430** (50÷150 con 1002). Contro i **235 µm di gioco** dell'ingranamento e i **0,83 mrad** di imbardata per carrello: 25÷80 volte meno, e motorizzare il secondo lato non tocca nessuno dei due. E la forza non è mai stata il problema: il pancake dà 8,67 N sul raggio 15,000, cioè **0,86÷1,1 g** di accelerazione disponibile, mentre la configurazione ne chiede 0,02 — **40×** di margine. Se il portale farà fatica sarà sovravincolo o attrito, non coppia. Alternative scartate: un motore con albero di collegamento fra i due lati (squadratura perfetta, meccanica complicata); due motori in serie su un driver (sincronismo garantito ma induttanza doppia); due motori in parallelo (ripartizione di corrente non garantita); due driver con squadratura in firmware (serve un driver libero e una routine). **Da rivedere se:** la spinta a mano sul lato folle varia di più del doppio lungo la corsa (sovravincolo) o è uniformemente oltre ~3 N (precarico dei cuscinetti)
- **Fisso e flottante sul montaggio della trave Y, con i due gradi di libertà in direzioni diverse.** Due staffe che stringono rigidamente le due estremità sovravincolano il portale: il non-parallelismo fra le rotaie diventa precarico, e il sintomo è attrito che cambia lungo la corsa — cioè esattamente quello che farebbe dire "serve il secondo motore". Lato motorizzato = fisso, vincola tutto. Lato folle = **scorrimento lungo l'asse della trave** (permanente, assorbe il non-parallelismo) **più registrazione di squadratura in direzione di corsa** (bloccabile). Le due direzioni non vanno confuse: nel giunto a guance con viti ad asse Y il gioco dei fori Ø4,600 registra in X e in Z, **non** in Y, e Y è la direzione della squadratura — quindi serve l'asola larga con grani laterali sul lato folle
- **La trave Y appoggia sotto l'ala, non sotto l'anima, e il serraggio è nello stesso punto dell'appoggio.** Le viti stanno nell'ala: se si appoggiasse l'anima sul piano e si tirasse l'ala in basso con le viti, si piegherebbe una lamina da 1,500 proprio dove corrono i 608. Corollario costruttivo: il piano che porta le nervature sta **0,500 sotto** il fondo dell'anima, perché non deve toccare — due appoggi in serie dovrebbero essere complanari e non lo saranno
- **Il vuoto dietro al motore si chiude, non si riempie di niente — e il motore si cambia smontando la trave.** Scelta fra accessibilità e piano d'appoggio: il piano lavora ogni secondo che la macchina gira, il motore si cambia forse una volta in due anni. Supera l'indicazione data poche ore prima di tenere il vuoto libero come via d'uscita del motore, che era incompatibile con il piano d'appoggio. Nota tecnica che smonta mezzo argomento: su un pezzo stampato **lo slicer svuota comunque**, quindi un blocco modellato pieno a 15% di infill fa ~37 g contro i ~35 di una scatola progettata a pareti da 4 mm. Il cuneo autoportante a ~27° dalla verticale che è stato scelto è meglio di entrambi: nessun ponte da stampare, materiale dove c'è il momento
- **Formato: ~242 × 256 mm, A4 rinviato.** Le cremagliere stampate danno 242,475 (X, 59 denti) e 256,613 (Y, 62 denti) di corsa. L'**area** è quella di un A4 (62.100 contro 62.370 mm²) ma la **forma** è quadrata, quindi il lato da 297 non entra su nessuno dei due assi. E non entrerebbe nemmeno rifacendo le cremagliere finché si vogliono in un pezzo solo: il piatto da 256 in diagonale (`a + b ≤ 362,04`) ammette al massimo 292,8 di corsa in Y e 281,6 in X. **Per un A4 vero serve una cremagliera giuntata**, con il gradino di passo alla giunzione che si era deciso di evitare. Da rivedere se: il formato A4 diventa un requisito invece di un desiderio

**Criterio di completamento:** gioco misurato sotto 0,1 mm e `steps_per_mm` tarato sulla macchina reale

**Note (cronologia dello step):**
- [2026-09-21] Definito il metodo di taratura in loco, da usare a struttura montata: muovere quasi tutta la corsa (non 100 mm: l'errore di misura è sempre mezzo millimetro, quindi più lunga è la corsa più la taratura è precisa), misurare lo **spostamento del carrello** con un calibro e non la lunghezza della linea disegnata, e partire sempre nello stesso verso per non includere il gioco nella misura. Formula: `nuovi passi/mm = vecchi × comandata / misurata`
- [2026-09-21] Definita la misura del gioco: comandare +200 mm, poi −200 mm, e misurare di quanto il carrello non è tornato al punto di partenza. Sotto 0,1 mm il precarico funziona, sopra 0,3 mm va ristudiato prima di procedere
- [2026-09-24] **Primo pignone stampato e provato.** Foro sagomato disegnato con 0,2 mm di gioco: "entra a fatica ma entra", che è il risultato voluto. Stampata anche la versione a doppia elica: la dentatura è venuta pulita, quindi la stampante regge il modulo 1,5
- [2026-09-24] **Bilancio dell'errore atteso** con questa costruzione: ripetibilità ±0,1÷0,2 mm, precisione assoluta ±0,3÷0,5 mm dopo la taratura. Sotto i due decimi tutto sparisce dentro la larghezza del tratto di un pennarello. L'errore più insidioso non è il gioco ma **l'ortogonalità fra i due assi**: mezzo grado fa 1,3 mm di sbieco sull'angolo di un A5, più di tutti gli altri messi insieme. Si misura confrontando le diagonali di un quadrato disegnato, e il residuo si compensa via software
- [2026-09-24] Segmenti delle cremagliere fissati: asse X un pezzo da 53 denti (249,76 mm) in diagonale sul piatto, asse Y due pezzi da 37 denti (174,36 mm) dritti. Ogni segmento è un multiplo esatto del passo con il primo dente a mezzo passo dall'estremità, così il passo si mantiene attraverso il giunto
- [2026-09-24] Fissaggio della cremagliera: **un solo foro tondo al centro dell'intera cremagliera, asole dappertutto altrove**, una ogni 50 mm alternate sui due lati. Il PLA si dilata tre volte più del legno e su 350 mm cresce di oltre tre decimi: bloccato rigidamente in più punti si inarcherebbe, cambiando l'interasse col pignone nel mezzo della corsa
- [2026-09-24] Geometria del carrello ancora aperta: l'utente ha proposto due staffe a T affacciate avvitate al legno, con il carrello stampato in mezzo. Da chiarire se i cuscinetti appoggiano sull'ala orizzontale o sul gambo verticale. Problema già individuato: le staffe avvitate solo al piede sono mensole che flettono sotto il precarico, che inverte verso a ogni cambio di direzione — rimedio previsto, viti ogni 40-50 mm più un dorso stampato dietro la gamba verticale
- [2026-09-25] **Materiali acquistati**, e il progetto si adatta a quello che si trova in ferramenta invece del contrario: base in compensato 385 × 455 × 10; viti M3 da 10, 16 e 25 mm **con tratto liscio sotto la testa** (indispensabile per i perni dei cuscinetti); angolare forato 23,5 × 23,5 × 1,5; profilo a U 67,5 × 23,5 × 1,5
- [2026-09-25] **Il profilo a U più due angolari formano il canale chiuso già progettato**, con misure che coincidono: interno 64,5 × 22 mm, e due ruote Ø10 impilate ne occupano 20, lasciando 2 mm da recuperare con le asole. Gli angolari bullonati sopra le ali, flangia verso l'interno, lasciano una fessura centrale di 20,5 mm per il collo del carrello. Quattro superfici di rotolamento in due pezzi comprati
- [2026-09-25] **Verifica delle corse sulla base reale**: con un carrello da 90 mm restano circa 325 mm di corsa in Y e 230 in X, contro i 260 × 200 che servono per un A5 con margine. Circa 65 mm di margine in Y — abbastanza da permettersi un carrello fino a 150 mm senza perdere foglio
- [2026-09-25] Geometria del carrello X definita: il carrello abbraccia **una guida centrale sola**, che va bene perché il profilo è largo 67,5 mm. Sull'asse Y non funzionerà: il ponte è largo 385 mm e su una guida sola si metterebbe di traverso
- [2026-09-25] Da verificare con una calamita: i profili sono acciaio o alluminio. Un metro di quel profilo pesa 1,35 kg in acciaio contro 465 g in alluminio, e sul ponte mobile dell'asse X quel peso lo muove il motore a ogni riga
- [2026-09-25] **La guida va rialzata dal pannello**, scoperto disegnando il CAD: le ruote inferiori sporgono sotto il profilo, quindi con la guida appoggiata direttamente al legno striscerebbero sul pannello. Serve un distanziale continuo sotto tutta la guida — non blocchetti isolati, perché il profilo da 1,5 mm flette fra un appoggio e l'altro sotto il precarico
- [2026-09-25] **Conseguenza da non dimenticare: il rialzo della guida alza tutto.** Il carrello sale, quindi sale l'asse del motore, quindi la cremagliera deve salire dello stesso identico valore perché il pignone continui a ingranare. La relazione resta `fondo cremagliera = asse motore − 26,875`: se si rialza la guida di 5 mm e ci si dimentica della cremagliera, il pignone non tocca più i denti
- [2026-09-25] Il rialzo va misurato, non stimato per eccesso: ogni millimetro in più allontana la penna dal piano delle ruote e amplifica l'errore di beccheggio e rollio di circa l'1% al millimetro. Regola: sporgenza reale delle ruote più 2 mm di franco
- [2026-09-26] **Sezione reale del binario ricavata dallo STEP**, e non è un U come si pensava: è un profilo a cappello, 66,4 largo × 23,2 alto, scatola centrale 23,7, canale interno 20,0 × 21,9, fondo e labbri 1,3 mm, pareti 1,85. I labbri sporgono in fuori da X 11,85 a 33,2: sono loro la superficie di rotolamento, pinzata fra un 608 sopra e uno sotto
- [2026-09-26] **Architettura del carrello: U rovesciata che cavalca il binario.** Due fianchi verticali da 3 mm fuori dal binario (X ±35 ÷ ±38, con 1,8 mm di aria dal bordo del labbro), perni Ø8,1 con collare Ø10,1 che puntano verso l'interno, e un ponte a Z ≈ 52 che lega i fianchi al blocco centrale. Verificato sullo STEP: i fianchi sono piastre **continue su tutti gli 80 mm** da Z 10,8 a Z 34,2, quindi l'anello di forza fra perno basso e perno alto sta interamente dentro un unico pezzo di materiale, e le due stazioni sono legate rigidamente
- [2026-09-26] **L'ordine dei pezzi lungo l'asse del motore è obbligato:** corpo motore → flangia → pignone → cremagliera. L'albero esce dal lato flangia, quindi mettendo il motore fuori dai cuscinetti il pignone finirebbe dentro, dove c'è il binario. Conseguenza: il corpo del motore deve stare verso l'interno, cioè sopra il carrello, e questo fissa l'altezza minima dell'asse
- [2026-09-26] **Interasse dei 608 a 23,40 mm** (labbro 1,3 + due raggi da 11 = 23,30), cioè 0,10 mm di gioco nella pinza. Validato: mezzo carrello scorre su tutta la lunghezza in entrambi i versi. Da rifare con il carrello completo, perché con entrambi i lati montati conta la complanarità dei due labbri lungo la corsa
- [2026-09-26] **Doppia elica a 30° su pignone e cremagliera, confermata funzionante.** Verificate sullo STEP la compatibilità geometrica (stesso modulo trasversale, stesso angolo, apice a metà fascia su entrambi) e la dentatura (spessore in testa 1,065 e vano al piede 1,191 sulla cremagliera, spessore su primitiva 2,3562 nominale sul pignone: gioco totale 0,20 tutto sulla cremagliera). Prezzo della doppia elica: il pignone va centrato sull'apice della cremagliera entro **±0,17 mm**, contro i ±2 mm che darebbero i denti retti
- [2026-09-26] **Il pignone non ha vite di fermo, e va bene così.** L'accoppiamento a pressione è talmente serrato che per smontare la prova sono serviti morsetti concatenati. La vite serviva a poter *regolare* la posizione assiale per il centraggio della doppia elica, ma quella regolazione si è spostata sulla cremagliera. Da ricontrollare fra qualche settimana di funzionamento, perché il PLA sotto tensione circonferenziale si rilassa; il sintomo di uno slittamento è un disegno progressivamente sfalsato senza alcun errore segnalato
- [2026-09-26] **Alzare il piano del foglio è la leva più efficace di tutto il progetto**, non un dettaglio ergonomico. Con 0,10 mm di gioco su 60 mm di interasse ruote l'inclinazione è 1,67 mrad, e l'errore sulla punta scala linearmente con l'altezza della penna: 0,250 mm a 150 mm di sbalzo, 0,117 a 70 mm. La risoluzione della trasmissione è 0,029 mm, quindi a 150 mm l'errore geometrico è otto volte la risoluzione. Vincolo: il carrello spazza una striscia larga ±38 mm attorno all'asse del binario da Z 2,7 a Z 74, e il piano non può entrare in quel volume
- [2026-09-26] Metodo per misurare l'attrito, da usare come metrica di qualità confrontabile: cercare l'**angolo minimo a cui il carrello si muove da solo** sul binario inclinato. La tangente è il μ effettivo — 5° = 0,09 (buono), 30° = 0,58 (qualcosa striscia). Con 1,5 kg in movimento, μ 0,09 costa 20 N·mm al pignone e μ 0,58 ne costa 130, su un NEMA 17 che alle velocità di lavoro ne dà 150÷200 utili
- [2026-09-26] **Dati reali del motore** (17HS4023 iMetrx, etichetta): coppia di tenuta **130 mN·m**, corrente nominale **1,0 A/fase**, resistenza **~4,0 Ω/fase** (4,1 V a 1,0 A), peso **204 g**. È un pancake 42 × 42 × **23 mm**, non un NEMA 17 standard: circa **un terzo** della coppia di un 40 mm
- [2026-09-26] **Corrente, calore e coppia sono la stessa manopola.** La coppia scala con la corrente; la corrente che si può dare la decide il PLA della culla. Con P = 2·I²·R sui 74 cm² di superficie del motore, e tenuto conto che la culla come disegnata copre il **51%** di quella superficie: a 0,6 A la carcassa sta a **74 °C con la culla piena** e a **58 °C con la culla alleggerita**. Alleggerire la culla (nervature invece di superfici piene sul fondo e sui due fianchi) vale quindi **0,1 A di corrente in più, cioè il 13% di coppia** — non è rifinitura
- [2026-09-26] **Bilancio di coppia al punto di lavoro** (0,6 A, culla alleggerita): coppia 78 mN·m, e con il fattore 0,85 per la caduta a 21 giri/min su un raggio primitivo di 15 mm restano **4,42 N alla cremagliera**. Togliendo la quota per accelerare, l'angolo di distacco ammesso è 14° a 1,3 kg e 10° a 1,6 kg; **il target con margine 2× è sotto i 7°**. Il fattore 2 non è pignoleria: senza encoder una perdita di passo non viene segnalata da nulla e il disegno esce sbagliato da lì in poi
- [2026-09-26] **Leve in riserva se la coppia risulta stretta**, in ordine di convenienza: (1) togliere massa, che agisce su entrambi i termini; (2) accelerazione da 1000 a 400 mm/s², che restituisce 0,9 N di budget attrito e si paga solo in tempo; (3) pignone z17 invece di z20 — **+18% di forza e risoluzione da 33,95 a 39,9 passi/mm, con la stessa cremagliera** perché dipende solo dal modulo, al costo di rifare la catena delle quote (l'asse scende di 2,25 mm); (4) motore da 40 mm, che triplica la coppia per ~10 € e +140 g
- [2026-09-26] **La massa punisce due volte** (aumenta insieme l'attrito e la forza per accelerare), quindi il test della calamita sui profili pesa più di quanto sembri: la trave da 385 mm vale 174 g in alluminio contro 506 in acciaio, cioè **circa due gradi** di angolo ammesso in meno

- [2026-09-27] **Carrello X completo misurato:** angolo di distacco ~10°, moto costante su tutta la corsa ~15°, massa 290 g. Tradotto in forza sono **0,50 N e 0,76 N** contro i 4,42 N disponibili al pignone: margine 5,8×. Il μ apparente di 0,27 non descrive un attrito grande, descrive un attrito piccolo diviso per un peso ancora più piccolo
- [2026-09-27] **Il drag è attrito interno dei cuscinetti, quindi costante e non proporzionale al carico.** Otto 608ZZ con coppia di spunto 0,3÷1,0 mN·m su raggio 11 danno 0,25÷0,83 N, che copre esattamente il misurato. Conseguenza operativa: **caricando il portale il μ effettivo scende**, perché il numeratore resta fermo e il denominatore cresce. A 1,1 kg totali il μ scende da 0,27 a ~0,082
- [2026-09-27] **Test della calamita fatto: i profili NON sono magnetici, quindi alluminio.** 452 g/m sulla sezione a cappello (167 mm²), contro i 1314 g/m che avrebbe l'acciaio. Chiude il punto aperto dal 2026-09-25
- [2026-09-27] **Il tetto di massa mobile non è più un vincolo di progetto.** Con drag da rotolamento (μ 0,05) il tetto è 3410 g a 0,6 A contro i ~1150 g stimati per la macchina completa. Fra il formato più piccolo e il più grande in tabella ballavano 84 g: la massa ha smesso di essere il criterio di scelta del formato
- [2026-09-27] **Cremagliera v2 controllata sullo STEP, tre difetti trovati e corretti in v3.** (a) Due fori Ø8 passanti dall'alto tagliavano la dentatura fino in testa: a Y=0 mancavano due denti interi a X≈14 (salto di 11,551 invece di 4,712) e uno a X≈256, con la fascia portante che crollava da 17,32 a 9,32 mm; (b) restavano due schegge di dente spesse **0,030 mm**, sotto la larghezza dell'ugello, che sarebbero diventate bave dentro un vano; (c) il Ø2,5 passante avrebbe autofilettato nel PLA impedendo il serraggio, e il cono si apriva solo a Ø4,5, troppo poco per una testa svasata M3
- [2026-09-27] **Cremagliera v3 verificata pulita:** 59 denti, tutti spessi 2,1562 sulla primitiva, tutti i passi 4,7124, nessuna anomalia. Profilo confermato al centesimo a sette altezze (testa 1,0643, primitiva 2,1562, piede 3,5211, pendenza fianco 2·tan20° = 0,728). **Chevron simmetrico a ogni altezza di fascia**: le coppie ±Y danno posizioni identiche fino all'ultima cifra. Lunghezza 284,223 = 60,314 passi, avanzo 1,480 — da portare a **282,743** (60 passi esatti) perché il pezzo resti giuntabile in futuro
- [2026-09-27] **Il rettangolo ruotato a 45° sul piatto è davvero l'ottimo**, verificato: con piatto 256 e larghezza 60 il massimo è 302,04 mm esatti a 45°. Dettaglio controintuitivo da ricordare allo slicer: **ruotare poco peggiora**, fra 5° e 25° l'ingombro ammesso scende sotto i 256 mm che si avrebbero a 0°. O si va a 45 o non si ruota
- [2026-09-27] **Il riempimento non raggiunge mai i denti.** Con ugello 0,4 e 4 perimetri il dente è pieno ovunque (2,52 mm di pareti contro 2,156 di spessore sulla primitiva). Il pattern influenza solo la soletta, che regge 4,4 N su 11 viti: la scelta va fatta sulla **stabilità dimensionale**, non sulla resistenza
- [2026-09-27] **Altezza del pignone ricavata dal carrello:** i fori NEMA sono a Z 58,650 con interasse 31,00 verificato, quindi **asse pignone Z 74,150**, primitiva cremagliera Z 59,150, faccia inferiore della cremagliera Z 47,275. Equazione di vincolo della catena verticale: **D = t_binario + 59,150 − t_cremagliera**, dove D è la distanza dalla faccia inferiore della cremagliera alla primitiva (oggi 11,875). Da confermare sul pezzo reale: l'asse del motore deve venire a filo del cielo del carrello, che in CAD sta a Z 74,159
- [2026-09-27] **La catena delle quote non chiude sui nominali, e va chiusa in montaggio.** Sensibilità: 1 mm di errore in altezza = 0,728 mm di gioco, quindi il budget è ±0,275 mm. Le tolleranze reali sommano ±0,60 mm col multistrato e ±0,89 col massello — due e tre volte il budget. I contributi: taglio del legno ±0,30, **planarità del riporto su 284 mm ±0,50**, movimento stagionale ±0,05 (multistrato di costa) contro ±0,66 (massello di costa), stampa ±0,10, alluminio ±0,10
- [2026-09-27] **Il regolatore della catena verticale sono i fori Ø4,0 del motore con viti M3**: ±0,5 mm di gioco radiale, cioè ±0,364 mm di gioco d'ingranamento. Basta ad assorbire tutto quello che resta dopo aver misurato il legno
- [2026-09-27] **Architettura dell'asse Y aperta.** Frequenze proprie della trave da 437 mm con 430 g al centro: **145 Hz in verticale, 388 Hz in orizzontale** (la direzione di corsa è quella larga del profilo). Freccia 0,013 mm, e comunque **la freccia non tocca l'ingranamento** perché cremagliera e pignone stanno entrambi sulla trave e scendono insieme. La rigidezza non è un criterio di scelta del profilo
- [2026-09-27] **Il piano di simmetria della sezione azzera due errori su tre.** Con penna e pignone sull'asse dell'anima, l'imbardata non sposta la punta (una rotazione non muove ciò che sta sull'asse) e la torsione è nulla per definizione (forza sul piano di simmetria). Fuori asse si paga doppio: a 150 mm di offset sono 0,250 mm di imbardata **più** 0,209 di torsione della trave, contro uno spessore di tratto di 0,3÷0,5 mm
- [2026-09-27] **Il motore non deve contendere lo spazio alla penna nella sezione: può essere sfalsato lungo la corsa.** In sezione si sovrappongono, in pianta stanno a 40÷60 mm di distanza. Così penna, pignone e cremagliera restano tutti sul piano di simmetria
- [2026-09-27] **Un perno stampato non si può ingrossare fra due cuscinetti coassiali**, perché il cuscinetto interno si infila dalla punta e non passerebbe. La soluzione è quella già usata sull'asse X: **due tronchetti contrapposti**, uno per cuscinetto, radicati ciascuno nella propria parete. Lunghezza 8÷10 mm invece di 30, e la freccia scende col cubo: da 0,0149 a 0,0004 mm. Se invece il perno deve restare passante, va tenuto Ø8 pieno e **appoggiato a entrambe le pareti** (0,0009 mm contro 0,0149 a sbalzo, 16× in rigidezza e 4× in resistenza)
- [2026-09-27] **La resistenza dei perni stampati non è mai stata il problema:** un Ø8 a sbalzo su 30 mm rompe a 84 N e ne porta 1, coefficiente 84×. Il motivo per irrigidirli è lo **scorrimento viscoso**: il PLA sotto carico permanente triplica la freccia in un anno, quindi 0,045 mm che si presentano da soli come gioco sul labbro
- [2026-09-27] **Il profilo a cappello dell'asse X non è riutilizzabile sull'asse Y** con la conformazione scelta: è una C con le punte che formano un pezzo esterno, e i cuscinetti non possono fare il giro necessario. Cade l'ipotesi di riusare lo stesso profilo su entrambi gli assi
- [2026-09-28] **Trave Y comprata e misurata sullo STEP.** Alluminio, sezione a T asimmetrica: ala **67,100 × 1,500** (bordi a Y −42,050 e +25,050, quindi 42 mm di ala da un lato dell'anima e 25 dall'altro), anima **3,100** centrata su Y 0, altezza totale **23,500**. Due bande asolate sull'ala, a Y 11,05…15,65 e −11,75…−7,15, larghe 4,6 e piene all'82%
- [2026-09-28] **La prima cosa da verificare su un profilo asolato è dove passano i cuscinetti.** Le piste scelte (Y 18,05…25,05 e −22,95…−15,95) cadono fuori dalle bande asolate con 2,40 e 4,20 mm di margine: un 608 che passa sopra un'asola non fa rumore, fa un salto di quota che la penna disegna. Verificato anche il contrario, che serve per l'anti-sollevamento: il piano Z 0,000 della trave misura 3106,2 mm² su 1002 di lunghezza, cioè **1002 × 3,100 esatti — il bordo inferiore dell'anima è continuo, nessuna asola lo interrompe**
- [2026-09-29] **Schema di guida del carrello Y:** quattro 608 che *appoggiano* sul piano superiore dell'ala (non pinzati), due 608 sotto l'ala in anti-sollevamento, quattro MR63 che pinzano l'anima lateralmente. Il carrello poggia, non è precaricato in verticale: è lo schema giusto, e il gioco sui due inferiori non è gioco di scorrimento ma corsa prima che l'anti-sollevamento intervenga. Passo perni 60,000 come sull'asse X, carreggiata 41,000
- [2026-09-29] **Il perno superiore lungo non era un problema.** Era la preoccupazione dell'utente: un Ø8 stampato da ~52 mm che porta due cuscinetti. In realtà è appoggiato sul tetto per 29 mm al centro e a sbalzo solo 6,45 e 5,55 alle estremità: **0,26 MPa** contro i ~50 del PLA, freccia 0,0004 mm. Cade l'idea del pezzo centrale avvitato fra i cuscinetti
- [2026-09-29] **Difetto che si ripete di versione in versione: i 608 del lato +Y sono a filo esatto del bordo dell'ala** (Y 18,050…25,050 contro bordo 25,050). Il carrello trasla di 0,10 per lato col gioco dei MR63, quindi in esercizio il cuscinetto sborda e rotola sullo spigolo, che su un estruso è anche la zona con raggio di bordo e bave. La fascia pulita è larga 9,40: la posizione giusta è **17,05…24,05**. Segnalato su prova 1, 2, 3 e 4, mai corretto
- [2026-09-29] **Motore sotto o sopra: il conto non era quello che sembrava.** L'argomento dell'utente ("sopra devo alzare la penna di 5 cm") non regge sui numeri — l'attacco del modulo penna è più basso di soli 13 mm col motore sotto, ma col motore sotto tutta la macchina deve stare 19 mm più alta sulla carta, quindi il modulo penna col motore sopra viene **6 mm più corto**, non 50 più lungo. L'argomento che regge davvero è un altro, ed è migliore: **il corpo del motore è alluminio**, quindi quei millimetri di discesa non li fa un braccio stampato in PLA
- [2026-09-30] **La gabbia a cavallo dell'anima forza la quota del motore.** Interno Y da −6,750 a +17,250: il corpo può vivere solo sotto il bordo inferiore dell'anima, e il bordo superiore del motore finisce 0,35 mm sotto il piatto del carrello. Non c'è margine verso l'alto. Da qui discende tutto il resto: la cremagliera non arriva all'ala e deve scendere fino al pignone
- [2026-09-30] **Pattern dei fori motore sbagliato per tre versioni di fila:** 31,000 × **32,000** su prova 2 e 3, poi 31,000 × **31,450** su prova 4. Il NEMA 17 è 31,000 × 31,000. Con Ø4 su M3 ci sono 0,5 di raggio libero, quindi entra comunque — ma l'errore se lo mangia tutto, e proprio su **Z, che è l'asse dell'interasse**: resti senza registrazione del gioco. Su prova 4 la fila inferiore è esatta (−51,500 = −36,000 − 15,500) e **solo la fila superiore è alta di 0,450**. Il carrello X, controllato per confronto, ha 31,000 esatti: la copia non aveva portato la quota perché il carrello X ha una sola fila di due viti, non quattro
- [2026-09-30] **La doppia elica di cremagliera e pignone aveva mano opposta: non potevano ingranare.** Inseguendo un singolo dente al variare di Y, la cremagliera dà pendenza dX/dY **+0,60** e il pignone **−0,576**: stesso angolo di 30°, ma le punte delle V guardano da parti opposte e le tracce dei denti si incrociano a 60° invece di essere parallele nel punto di contatto. Verifica: 74,1 mm³ di compenetrazione che non scende sotto ~35 né ruotando il pignone, né facendolo rotolare davvero (rotazione + traslazione r·θ), né aumentando l'interasse di 0,8 mm. **La correzione è gratuita: si gira la ruota sottosopra** (essendo simmetrica rispetto al piano di mezzeria, ribaltarla inverte la mano senza spostare nient'altro) e la compenetrazione va a **0,000** con una finestra di gioco di ~0,26 mm. Ruotarla sul mozzo, che era l'istinto, cambia la fase e non la mano
- [2026-09-30] **Correzione di un errore mio sul segno dello 0,1 di aria fra cremagliera e ala.** Avevo scritto che stringendo la cremagliera contro l'ala l'ingranamento si stringe: è il contrario. Denti in giù e pignone sotto, quindi tirandola su l'interasse **aumenta** e il gioco cresce. Il margine di montaggio voluto dall'utente va nel verso giusto
- [2026-09-30] **La cremagliera Y non raggiunge le asole della trave:** il suo piano superiore va da Y −13,822 a −42,278, le asole sono a −11,750…−7,150. Vanno forati fori nuovi nell'ala, e la zona giusta è **Y −28…−38** per tre motivi che coincidono: è oltre Y −24,950 dove finisce il carrello (teste delle viti di qualsiasi altezza, montaggio dall'alto), è oltre Y −22,950 quindi fuori dalla pista dei cuscinetti 5 e 6, ed è oltre Y −27,678 dove finisce la gamba verticale, quindi le cave esagonali per i dadi sono accessibili da sotto
- [2026-10-01] **Prima stampa del carrello Y: si solleva.** Premendo con un dito sul retro del motore il carrello si alzava. Causa: niente teneva giù il lato −Y (i 608 lì sopra solo appoggiano), e qualsiasi forza applicata molto sotto l'ala genera un momento enorme. I numeri dicono che non era una sensazione: a stallo il momento di beccheggio è 324 N·mm, cioè **±5,4 N** contro 2,15 N di peso per stazione — una stazione si stacca. In marcia normale non solleva ma **dimezza il carico** su una stazione, ed è quella cedevolezza che poi esce come isteresi nel disegno
- [2026-10-01] **La nuova catena di tolleranze è il rischio principale aperto.** Il progetto dipende ormai da **tre quote della trave comprata, nessuna misurata**: spessore ala 1,500 (presa 608, gioco progettato 0,100), spessore anima 3,100 (MR63 laterali, 0,050), e la novità, **altezza totale 23,500** (MR63 anti-sollevamento, **gioco 0,000**). Prima la presa verticale lavorava su 1,5 mm di lamiera, adesso lavora su tutta l'altezza del profilo — che per di più è fatto di due profili a L imbullonati, quindi ha anche il problema che **le due gambe devono finire a filo sul bordo inferiore**, altrimenti un cuscinetto da 2,5 corre mezzo a sbalzo su un bordo da 3,1
- [2026-10-01] **Altezza della cremagliera Y fissata dalla catena:** con asse pignone a Z −36,000 e raggio operativo 15,119 (il Ø testa 33,237 dà x = +0,079), la primitiva va a **Z −20,881**, la punta del dente a **−22,381**, il dorso contro l'ala a 22,000 → **altezza totale 44,381**. Cresciuta di 7,3 mm rispetto al layout precedente, conseguenza diretta dell'aver abbassato il motore. La lama alta non preoccupa: la forza tangenziale è nel piano della lama e la doppia elica non genera spinta assiale, quindi non c'è niente che la fletta in Y
- [2026-10-01] **Lunghezza della cremagliera Y: due pezzi identici da 37 passi** (174,359 ciascuno, 348,718 totali, ~322 di corsa utile). In un pezzo solo non ci sta: servirebbero ~343 di dentatura, il piatto a 45° con larghezza 28,456 ne ammette 333,6 teorici e ~300 pratici. A 174 mm si stampano **dritti sul piatto**, niente rotazione a 45°. Due regole per il giunto: ogni pezzo multiplo esatto di 4,7124 tagliato su un confine di dente, e **il passo attraverso il giunto lo deve dare l'incastro fra i due pezzi** (maschio/femmina, stesso file) e non la foratura dell'alluminio, che vale ±0,2
- [2026-10-01] **Gioco e scorrevolezza non sono la stessa cosa, e vanno curati con strumenti diversi.** Dopo la prima stampa i giochi nominali sono stati stretti (608 da 0,150 a 0,100, MR63 laterali da 0,100 a 0,050, anti-sollevamento a 0,000). Tarare su una stampa reale è il metodo giusto, ma 0,050 è **sotto la tolleranza di stampa**: la prossima stampa può uscire con 0,15 di gioco o con 0,05 di interferenza, e in nessuno dei due casi c'è modo di aggiustare. Il rimedio al gioco è la **regolazione** (asole), non un nominale più stretto — che aggiunge precarico su tutta la corsa e lo fa pagare dove il profilo è un po' più spesso, con un punto duro. L'attrito è stato il vincolo del progetto per settimane: non va buttato via per una sensazione al tatto
- [2026-10-02] **Il raggio primitivo del pignone è 15,000, non 15,119: l'errore veniva dal bounding box.** Il Ø di testa letto dal bbox era 33,237, da cui si ricavava una correzione di profilo x = +0,079. Misurando i cilindri veri: **testa Ø33,000** (= 1,5 · (10+1) esatto) e **fondo Ø26,250** (= 1,5 · (10−1,25) esatto), cioè un ingranaggio standard senza alcuna correzione. Lo scarto del bbox è 0,1185 per lato, metà esatta di 33,237 − 33,000: su una dentatura a spina di pesce OCC circoscrive le facce NURBS con margine. Conseguenza: **l'altezza della cremagliera Y passa da 44,381 a 44,500**
- [2026-10-02] **Altezza cremagliera Y verificata in tre modi indipendenti.** (a) Catena di quote riferita all'estradosso dell'ala: `estradosso → asse pignone 59,500` (fissato dal carrello stampato), `asse → primitiva 15,000`, `primitiva → punta 1,500` → `H = 46,000 − t_ala`, cioè **44,500** con t = 1,500. (b) Il gioco di testa che ne risulta viene **0,375 = 0,25·m**, il valore normalizzato, senza averlo imposto. (c) Misura diretta sulla geometria dell'utente: ingranaggio ribaltato messo in presa, scansione di fase su un passo intero e bisezione sui bordi della finestra libera → **gioco 0,226 mm** a interasse teorico, che è lo 0,200 già presente nello spessore del dente (misurato: 2,1562 sulla primitiva contro 2,3562 nominali, passo 4,7124, ripetuto identico su 62 denti). Sensibilità misurata **0,69 mm di gioco per mm di interasse** (teoria 0,728)
- [2026-10-02] **Banda di tolleranza della cremagliera: 44,32 … 44,71**, presa forzata a 44,83. Il margine verso il grippaggio dal nominale è solo **0,33 mm**, e `dH/dt_ala = −1` esatto. La direzione della correzione non è simmetrica: **uno spessore sotto il dorso stringe**, quindi si sbaglia corto e si stringe con spessori da 0,1, mai il contrario — limare il dorso su 174 × 28 tenendolo piano è l'operazione che non si vuole fare. E il ritiro del PLA è la trappola: le due parti ritirano insieme e il modulo si auto-compensa, ma **H è riferita a una trave di alluminio che non ritira**, quindi è l'unica quota del sistema dove il ritiro non si cancella (0,4% su 44,5 = 0,18 mm, tutta la banda)
- [2026-10-02] **Orientamento di stampa della cremagliera:** dorso sul piatto e denti in su, perché in quell'orientamento **non serve nessun supporto** (la flangia parte dal piatto e finisce con la faccia rivolta in alto). Il prezzo è che la scalettatura dei layer sul fianco del dente è `h_layer · tan20°` = **0,073 mm con layer da 0,2**: è il motivo per cui un gioco nominale sotto ~0,15 non può funzionare — sarebbe più piccolo della rugosità geometrica del fianco che lo deve rispettare. Per guadagnare precisione si stampa a layer più fini (0,1 → 0,036), non si stringe l'interasse
- [2026-10-03] **Lo spessore dell'anima non va più misurato.** L'asola da 3,140 del carrello X ha accolto la trave vera, quindi l'anima è 3,10 ± poco. Una delle tre quote mai misurate si chiude per via empirica
- [2026-10-04] **Il difetto dei 608 a filo del bordo d'ala si chiude come non-problema, dopo averlo segnalato quattro volte.** Rifacendo il conto: il gioco laterale degli MR63 è 0,050, quindi nel caso peggiore il cuscinetto sborda di **0,050 su 7,000 di larghezza**, cioè lo 0,7% dell'appoggio, e il contatto di rotolamento è una linea lungo la larghezza. Non succede niente. L'insistenza era sbagliata: la nota del 2026-09-29 sopravvalutava l'effetto perché ragionava sullo spigolo senza rapportarlo al gioco che lo può raggiungere
- [2026-10-05] **L'ingombro del carrello Y lungo la trave è 116,000 per estremità, non 82,5.** Misurato montando i due solidi nello stesso sistema e cercando il primo contatto per bisezione: **px = −78,000**, con zona di contatto X −38,00…−36,00 / Z 81,65…85,93. Il contatto non è fra guance e cuscinetti, è **corpo contro corpo** — il carrello Y è largo 80 mm (±40 dal pignone) e la faccia esterna del carrello X sta a 38 dal suo asse rotaia. La stima precedente contava solo le guance (49,5) e i cuscinetti laterali (33,0) e ignorava le due gabbie motore. È il numero che ha spostato la trave da 430 a 550
- [2026-10-05] **La trave Y va a 550, e la ragione non è solo il minimo.** Corsa utile = `L − 2·116 − 2·g`: a 430 sarebbero 188 (si butterebbero 69 mm di cremagliera già stampata), a 500 esattamente i 256,6 della cremagliera attuale, a **550** la capacità sale a 308 e **ci sta anche la cremagliera Y più lunga stampabile in un pezzo solo** (292,8 di corsa). Costa 29 g di massa mobile in più. Supera le indicazioni di 430 e poi 500 date nella stessa sessione
- [2026-10-06] **Interferenza degli MR63 laterali con la rotaia X confermata sull'assieme reale: 8 × 2,81 mm³, cioè 0,500 di penetrazione per lato.** Zona di contatto X −303,4…−302,9, su entrambi i carrelli X. Il dato che la rende diagnostica: **gli MR63 laterali del carrello Y non interferiscono per niente** — lì il gioco modellato è 0,050 e torna. Quindi è il profilo della rotaia TT nel modello a essere sbagliato (luce interna 20,000 contro perni a ±7,500), non i carrelli, che infatti scorrono
- [2026-10-06] **L'assieme non è affidabile sotto il millimetro sugli accoppiamenti di motori e ingranaggi.** Motore e ingranaggio Y piazzati 0,350 sopra l'asse della sede (asse misurato Z 68,535 contro 68,185 richiesto), ingranaggio X 0,466 sotto. Risultato: l'assieme legge l'interasse Y **0,475 troppo stretto** e quello X 0,343 troppo largo, mentre la macchina vera funziona. Quello che invece è affidabile e torna al micron: la trave appoggia a Z 104,1846 contro un fondo asola calcolato a 104,184, le guance si fermano 1,005 sotto l'intradosso dell'ala, e **l'anima della trave sta a Y −33,531 contro il centro dei carrelli a Y −33,51** — 0,021 mm, centrata come da progetto
- [2026-10-06] **Quote del portale assemblato:** interasse rotaie **473,40** (centri X −313,40 e +160,00), facce esterne dei carrelli a X −351,40 e +198,00 → **trave da esterno a esterno 549,40**. Le due rotaie nel CAD sono **sfalsate di 62,08 mm in Y** (centri a Y +62,08 e 0), da allineare. La cremagliera Y è **decentrata di 25,88**: margini 4,5 da un lato e 56,3 dall'altro invece di 30,4 per parte
- [2026-10-06] **Il piano di base non basta più, e il centro dell'area di disegno non è dove si crede.** `base legno` è 385 × 455 e la **rotaia sx è fuori dal piano di 154 mm**. Serve ~570 × 430 con le rotaie allineate e tagliate a 400. E l'area di disegno è centrata su **X −102,6 / Y −87,9**, non su (0,0): il piano va centrato lì. Quota che serve al modulo penna: il punto più basso del carrello Y sta a **Z 46,68** sopra il piano, quindi il piano carta va a **Z ≈ 44,2** — serve una piattaforma alta 44 mm
- [2026-10-07] **Nomenclatura fissata dall'utente, e da qui in avanti è quella:** **staffa TT** = le due rotaie da 400, **staffa LL** = la trave del portale da 550. Serviva perché le due sessioni usavano vocabolari diversi ("trave a T", "rotaia TT") e in una lista di tagli l'ambiguità si paga
- [2026-10-07] **La base deve ospitare anche l'elettronica, e questo la ridimensiona.** Il vincolo che decide: **fra le due rotaie non ci sta niente di più alto di 46,68 mm**, e il piano carta ne usa già 44,2. L'elettronica non può stare dentro la macchina, va in una fascia dietro le rotaie — dove per contro **non c'è nessun limite di altezza**. Due breadboard da 830 punti affiancate chiedono 130 mm di profondità; l'utente ha poi comprato una tavola **600 × 700**, che ne lascia 190
- [2026-10-09] **I tagli li fa l'utente in proprio, con seghetto a pendolo.** La lama giusta è la **T118G** (passo 0,7), e la ragione è geometrica: la staffa LL è alta 23,5 e larga 67,1, quindi si taglia per forza appoggiata sull'ala, e **per 64 dei 67 mm di taglio la lama attraversa l'ala da 1,500 mm**. A passo 0,7 sono 2,1 denti in presa, con la T118A (1,2) sono 1,25 e con la T118B (2,0) sono 0,75 — sotto il dente, il dente aggancia invece di tagliare e strappa il bordo, che è la pista dei 608. Regole: **pendolo a 0** (nel metallo fa strappo), velocità bassa (l'alluminio ad alta velocità si salda sui denti), lubrificante, legno di sacrificio sotto, morsa sull'anima o sulla scatola mai sulle ali, nastro sotto il pattino per non rigare le piste. **Staffa TT tagliata, risultato dichiarato ottimo**
- [2026-10-11] **L'interasse delle rotaie non è una scelta libera: lo quantizzano i fori della staffa LL.** Il profilo ha **22 fori Ø4,6 nell'anima a passo 25,000 esatto**, e i due fori di serraggio delle guance del carrello X sono distanti **esattamente 25,000**, cioè un passo. Montando entrambi i carrelli **sui due fori più esterni** si ottiene l'interasse massimo possibile, **473,400**, e la staffa da 550 lo copre con 0,600 mm di avanzo totale. Supera l'indicazione data il 2026-10-07 di ricavare l'interasse come `lunghezza trave − 76,0` (che dava 474,0): quella formula ignorava che la posizione dei carrelli è discreta
- [2026-10-11] **Prova_2 contro prova_3: la mossa che ha fatto spazio è stata di 25,000 mm.** Nel prova_2 l'interasse era 448,400 e la trave sbordava di 23,3 mm da un lato; spostando il carrello sinistro di un passo-foro si arriva a 473,400 e la trave viene usata tutta
- [2026-10-11] **Il carrello Y non lo ferma il motore né il pignone: lo ferma lo spigolo interno della cremagliera X.** Misurato per bisezione con booleane, un ostacolo alla volta (il metodo si auto-valida: contro il corpo del carrello X trova il contatto a pignone Y = +82,002, cioè faccia a faccia a X 122,000, che riproduce al centesimo l'A = 116 misurato a ottobre). La cremagliera X è larga **38,660 di base ma solo 17,321 di dentatura**: 21,34 mm di flangia di fissaggio sporgono verso il centro macchina, e sono quelli che mangiano la corsa. Col vecchio riporto in legno il margine a fine corsa era **+3,475** a destra e **+1,714** a sinistra se si motorizza anche quel lato: non un margine, il non-toccarsi
- [2026-10-11] **Cremagliera X v5: il rialzo in legno sparisce dentro il pezzo stampato.** Decisione dell'utente. Il pezzo passa da 13,375 a **68,375 mm di altezza totale** (+55,000 esatti), appoggia direttamente sul legno e la cresta dei denti resta dove stava. 59 denti, passo 4,7124 uniforme, corsa 242,475: la dentatura non si è mossa. Il guadagno non previsto: il piede largo sta **solo nei primi 10 mm**, e sopra la sezione si stringe ai 17,321 della dentatura — ma il carrello Y tocca in una fascia a **Z 46,7÷59**, trentasette millimetri più in alto. Quindi l'ostacolo arretra di **21,339 mm** e i margini diventano **+11,5** e **+9,8**
- [2026-10-11] **Il conto della stampa:** 364,82 cm³ di modello (452 g se fosse pieno, ~150 g con 3 perimetri e infill al 15%, 12÷18 ore). In pianta 283 × 38,7, quindi a 45° fa `a+b = 321,7` contro i 362 ammessi dal piatto: ci sta in un pezzo solo, e c'è il precedente della cremagliera Y che era più lunga. Piede sul piatto e denti in su, nessun supporto
- [2026-10-11] **Due numeri miei da correggere.** (a) L'ingombro del carrello X **lungo la rotaia è 82,000**, non 51: i 51 sono la sola gabbia motore, ma i quattro 608 stanno a passo 60,000 e con Ø22 arrivano a 82. Il taglio a 400 resta giusto, ma la corsa meccanica disponibile è **308** e non 339, e il minimo teorico era 334,5 non 303,5. (b) L'interasse è 473,400 e lo danno i fori, non 474,0 dalla lunghezza della trave
- [2026-10-12] **Il ritiro del PLA ora agisce su 68,375 invece che su 13,375.** Allo 0,3% fa ~0,21 mm contro 0,04, ed è la quota dove il ritiro non si auto-compensa perché è riferita all'alluminio. Ma è **sistematico e in una direzione sola: più basso, cioè gioco più largo**, mai verso il grippaggio — la stessa direzione in cui sbaglia uno spessore sottodimensionato. Aspettarsi di dover spessorare di ~0,2 sotto il piede, e considerarlo normale. In cambio sparisce il termine dominante della vecchia catena: la **planarità del riporto su 284 mm, ±0,50**, che da sola valeva il doppio del budget di ±0,275 — la faccia di riferimento non è più una superficie segata ma il piatto della stampante
- [2026-10-15] **Macchina montata.** Tagliata la staffa LL — l'unico taglio del progetto senza seconda possibilità — e assemblato il portale sulla base. I due assi si muovono dalla dashboard vecchia, le quattro frecce vanno nel verso giusto, la struttura è rigida e i motori non faticano. Il disallineamento delle rotaie è stato **risolto in montaggio**, quindi i 22,9 mm di corsa che costava sono recuperati sulla macchina vera (nell'assieme CAD va ancora riportato)
- [2026-10-15] **Gli assi cambiano nome** per allinearsi alla convenzione del foglio: la trave del portale diventa X, le rotaie di base diventano Y. Vedi le Convenzioni in testa alla Pipeline — e attenzione che tutte le note qui sopra usano i nomi vecchi
- [2026-10-15] **Le misure di taratura sono rinviate al modulo penna, per decisione dell'utente.** Non è un rinvio a vuoto: col modulo penna la taratura si fa disegnando una linea lunga e misurandola, che è una misura di tutta la catena in una volta e per asse, invece di una misura del solo passo della cremagliera. Il metodo col calibro resta scritto e valido in `misure/primo-asse.md` per il giorno in cui servisse separare i contributi
- [2026-10-20] **Fissaggio del foglio: nastro di carta, in attesa della stampa di collaudo** (decisione dell'utente). Il vincolo che esclude quasi tutto il resto: fra piano carta (Z 44,2) e punto più basso del carrello (Z 46,68) ci sono **2,5 mm**, quindi dentro la zona spazzata dal carrello non ci sta nessuna calamita e nessuna molletta — solo nastro (0,1 mm), colla stick o qualcosa sotto la superficie. **La piattaforma da 44 mm non è ancora costruita**, quindi il fissaggio è una scelta di progetto della piattaforma e non un accessorio da aggiungere dopo. Proposta sul tavolo, non ancora decisa: telaio da 40 mm + **piano in vetro float da 4 mm su tre appoggi regolabili** — tre e non quattro, perché tre punti definiscono un piano e quattro lo svergolano. Tavola confermata **600 × 700**
- [2026-10-20] **Blocchi di riferimento stampati e montati**, uno per asse, agganciati alle staffe TT e LL. Spostano l'azzeramento da «a occhio» a ripetibile: l'appoggio ripete sotto la risoluzione del calibro, e il margine di sicurezza scende da 8 a 2 mm. Il blocco X è una sella senza viti, tenuta dalla forma; il blocco Y una piastra avvitata con due viti a 22,80 di passo. Misurato quanto si mangiano di corsa: **1,443 mm su X, zero su Y** — il blocco Y sta di fatto sulla battuta
- [2026-10-21] **Il vincolo che esclude calamite e mollette cambia natura, non conclusione.** Eliminata la piattaforma (vedi Step 6), sotto il carrello non ci sono più 2,5 mm ma 46,68: l'argomento del 2026-10-20 non regge più come scritto. A mordere è ora **l'alzata della penna, 2,945 mm**, perché è quello che passa sopra il foglio fra un tratto e l'altro. Stesso ordine di grandezza, stessa decisione: **nastro di carta**, e si rivede dopo la prova 11 del collaudo
- [2026-10-23] **Due cose meccaniche trovate disegnando, non misurando.** (a) **Il pignone del carrello X tocca la cremagliera dell'asse Y** sul lato destro prima che il carrello arrivi in fondo: interferenza 5 mm, se ne tolgono 10 per stare larghi, e l'area utile su X scende a 241,232. Nel profilo è un campo suo, `ostacolo`, tenuto separato dal margine di sicurezza perché si risolve in modo opposto — l'uno smontando, l'altro diventando più precisi. Conseguenza pesante: **il disegno di collaudo non ci sta più** e va riprogettato nella colonna di destra. (b) **Il legno sotto al binario della staffa TT di sinistra si era alzato**, e nel primo disegno vero ha prodotto tratti spezzati nell'angolo in alto a sinistra: non alza la carta, alza il portale, e per la penna è identico a un piano che scende. Sistemato dall'operatore. Da qui la scoperta che la prova 11 del collaudo misura i punti alti e **non** quelli bassi

**Problemi aperti su questo step (al 2026-10-15):**
- ~~Profondità del vano motore da verificare~~ — **risolto il 2026-09-26.** Il motore è un **pancake da 23,1 mm**, non un NEMA 17 standard da 34÷48: il vano da 23,5 mm è quindi corretto e le viti posteriori arrivano eccome al coperchio. Resta però **0,4 mm di gioco assiale**, che è più dei ±0,17 mm di tolleranza di centraggio della doppia elica: il motore va messo **in battuta sulla parete anteriore** (che è il riferimento della quota del pignone) con **due rondelle piane M3 da 0,5 mm** fra coperchio posteriore e parete posteriore, così le viti di dietro lo spingono in avanti invece di tirarlo indietro. Resta da verificare la profondità dei fori filettati posteriori (spesso 4÷5 mm) per scegliere la lunghezza delle viti
- ~~Test della calamita sui profili~~ — **risolto il 2026-09-27: alluminio**, 452 g/m. Toglie di mezzo il rischio peggiore sul peso del portale
- ~~Attrito del carrello completo da caratterizzare~~ — **risolto il 2026-09-27.** 10° di distacco, 15° di moto costante, e la causa è attrito interno dei cuscinetti (costante), non strisciamento (proporzionale). Il carrello è accettabile così com'è
- ~~Profilo della trave Y da comprare~~ — **risolto il 2026-09-28.** Trave a T in alluminio, ala 67,100 × 1,500, anima 3,100, altezza 23,500, due bande asolate. Le piste dei cuscinetti cadono fuori dalle asole con 2,40 e 4,20 mm di margine
- ~~Layout del carrello Y da chiudere~~ — **chiuso nella sostanza il 2026-10-01** attraverso quattro iterazioni (prova 1→4): guida, motore sotto a cavallo dell'anima, anti-sollevamento sull'anima, cremagliera sotto l'ala su base alta. Resta aperto il solo **modulo penna**
- ~~Tre quote della trave Y da misurare~~ — **chiuso per via empirica il 2026-10-03.** L'asola da 3,140 del carrello X ha accolto la trave (anima = 3,10 ± poco) e i tre carrelli stampati scorrono sulla trave vera, quindi ala e altezza totale sono confermate dall'uso. Non serve più il calibro
- ~~Verificare la mano dell'elica anche sull'asse X~~ — **risolto il 2026-10-06.** Nell'assieme entrambi gli ingranaggi sono istanze di `Spur gear (20 teeth)-Mirrored`: la correzione è applicata su tutti e due gli assi
- ~~Fori motore, fila superiore da Z −20,050 a −20,500~~ — **accettato come è il 2026-10-05.** L'utente ha stampato e montato: le viti entrano, perché i 0,500 di scarto stanno esattamente dentro il gioco Ø4,000 su M3. Segnalato tre volte, la prova fisica batte la misura sul CAD per la domanda "ci entra". Resta vero che la flangia motore si carica di sbieco e che il gioco di registrazione è esaurito, ma non è un difetto che blocca
- ~~I 608 del lato +Y a filo del bordo d'ala~~ — **ritirato il 2026-10-04: non era un problema.** Con 0,050 di gioco laterale il cuscinetto sborda di 0,050 su 7,000 di larghezza, lo 0,7% dell'appoggio. Segnalato quattro volte a torto
- ~~Cremagliera Y da disegnare~~ — **risolta e stampata il 2026-10-02**, gioco dichiarato ottimo dall'utente. 62 denti, 289,613 di dentatura, 297,360 di pezzo, in **un pezzo solo** a 45° sul piatto (niente giunto, quindi nessun gradino di passo). Dodici asole 4,600 × 7,300 elongate in Y per la registrazione del parallelismo
- ~~Interferenza cremagliera / fianco del carrello X~~ — **risolto il 2026-10-06**: il carrello X v2 è stampato e funzionante, e le booleane sull'assieme non trovano contatti in quella zona
- ~~Gioco della pinza con il carrello X completo~~ — **risolto il 2026-10-06**: i tre carrelli sono assemblati e scorrono bene
- ~~Quanto alzare il piano del foglio~~ — **risolto il 2026-10-06: Z ≈ 44,2 sopra il piano di base**, perché il punto più basso del carrello Y sta a Z 46,68. Serve una piattaforma alta 44 mm
- ~~PRIORITÀ: misurare col calibro la luce interna fra le due anime della rotaia X. È l'unica misura rimasta e blocca la squadratura del portale. Nel modello è 20,000 con i perni MR63 a ±7,500, cioè 0,500 di interferenza per lato su otto cuscinetti — e i carrelli invece scorrono, quindi il modello è sbagliato. Quel numero è il gioco laterale dell'asse X, e il gioco laterale è l'imbardata del portale: 0,05 → 0,83 mrad → 0,18 mm all'estremità di una trave da 550; 0,5 → 8,3 mrad → 1,8 mm. Va saputo prima di squadrare, non dopo~~ — **chiuso il 2026-10-12, e non come previsto.** La luce da 20,000 è la **quota ufficiale del profilo**: l'informazione è arrivata dall'utente, non dal calibro. Le otto interferenze da 2,81 mm³ nell'assieme hanno quindi una spiegazione sola — nel CAD c'è ancora il **carrello della prima versione**, mentre quello stampato ha i perni MR63 già spostati sulla base delle prime prove. Il ragionamento ("i carrelli scorrono, quindi il modello è sbagliato") era giusto, il colpevole no: era il pezzo che si era mosso, non la rotaia. Resta da registrare **di quanto** sono stati spostati i perni, perché quel numero è il gioco laterale e quindi l'imbardata del portale
- ~~Lista tagli da eseguire (fuori casa, non ci sono gli attrezzi): trave Y a T 1 × 550, rotaia X a TT 2 × 400, tolleranza ±0,5. Avanzi da conservare: 452 mm di trave (una seconda trave intera) e 600 di rotaia. Specificare a chi taglia: stringere in morsa sull'anima per la T e sulla scatola per la TT, mai sulle ali (sono le piste dei 608); lama a denti fini o troncatrice da alluminio, niente flessibile; sbavare i quattro spigoli di ogni taglio, che è l'operazione più importante del lavoro. E non usare le facce di taglio come riferimento: segnare la posizione dei carrelli misurando dal centro della trave~~ — **superata il 2026-10-09: i tagli li fa l'utente.** Comprato un seghetto alternativo a pendolo e quattro lame. **Staffa TT tagliata, risultato ottimo.** Resta da tagliare la staffa LL, rimandata di proposito finché il primo asse non si muove: dalla stecca da 1002 restano 452 mm, meno di un secondo pezzo, quindi è l'unico taglio del progetto senza seconda possibilità
- ~~Piano di base da rifare: circa 570 × 430, centrato su X −102,6 / Y −87,9. Quello attuale è 385 × 455 e la rotaia sx ne sta fuori di 154 mm~~ — **chiuso il 2026-10-12: comprata una tavola 600 × 700**, che copre anche la fascia per l'elettronica. Il layout quotato è nelle note dello step
- **Tre correzioni nell'assieme CAD** prima di ricavarne altre quote: allineare le due rotaie in Y (−62,08 sulla sx), spostare la cremagliera Y di **+25,88** per bilanciare i margini, riaccoppiare motori e ingranaggi sulle loro sedi (oggi sono fuori di 0,15÷0,47 e falsano tutti i numeri di ingranamento)
- **Quale altezza ha la cremagliera Y stampata, 44,500 o 44,625?** Nell'assieme misura 44,625, cioè 0,100 in meno di quanto era stato togliuto invece di 0,225. A 44,625 il gioco è **0,140** invece di 0,226: funziona, ma è sul lato stretto per una coppia stampata dove la scalettatura dei layer sul fianco è già 0,073
- **Carrello X sinistro: specchiare non basta.** Il mirror a X = 0 è la trasformazione giusta (tutto quello che tocca la rotaia è simmetrico, cambiano lato solo vano motore e guance), ma il sinistro deve essere il **lato flottante**: asola dell'anima a **4,500 con due grani M3 di registro laterale per guancia** (±0,700 in Y = la squadratura) e **fori di serraggio asolati in X a 4,600 × 8,000** (lo scorrimento che assorbe il non-parallelismo). Con fori tondi su entrambi i lati si torna a sovravincolare
- **Secondo canale servo da riservare nel fascio cavi adesso.** Tirare un filo in più oggi è gratis, farlo passare dopo in una catena portacavi montata no. Lo chiederà il modulo taglierino
- **Parallelismo cremagliera-binario entro 0,17 mm su tutta la corsa** (conseguenza della doppia elica). Va allineata **al binario**, non al bordo della base: far scorrere il carrello e controllare la distanza pignone-apice in quattro o cinque punti prima di fissare. Sintomo di errore: scorre bene in mezzo e si irrigidisce verso le estremità
- **Piano B se il riporto della cremagliera X esce storto:** buttarlo e appendere la cremagliera a staffe stampate fissate al binario. Vantaggio concettuale: la cremagliera verrebbe riferita allo stesso pezzo su cui corre il pignone, invece che al tavolo
- ~~PRIORITÀ: le tre misure del primo test di movimento~~ — **rinviate per decisione dell'utente il 2026-10-15**, dopo il modulo penna, quando si potranno fare disegnando. La procedura resta in `misure/primo-asse.md`, aggiornata due volte: i 6400 impulsi non si misurano con un calibro da 150, e il passo si ricava a perni (due tondini identici nelle cave, `p = (R30 - R10)/20`, dove il diametro del perno si cancella nella sottrazione). Il gioco, provato a mano a montaggio fatto, è risultato "quasi zero" — resta da quantificarlo
- **Corsa utile reale di ciascun asse, da fermo a fermo.** Basta il metro, ±1 mm. Oggi in `cnc2d-config.yaml` c'è `max_travel_mm: 300.000` su entrambi, con scritto "DA TARARE"
- **Due passi/mm, uno per asse.** Le due cremagliere si sono ritirate di quantità diverse: un valore solo fa uscire i quadrati rettangoli. Da misurare per asse e da separare nel firmware della dashboard, che oggi ne ha uno globale
- ~~La quota a cui è stata tagliata la staffa LL non è registrata~~ — **chiuso il 2026-10-15: 550 mm**, la quota di progetto, senza scarti. Dalla stecca da 1002 restano 452 mm di avanzo
- **Il config di FluidNC non è mai stato provato** sulla macchina montata. Contiene ancora `steps_per_mm: 80.000` (residuo dell'ipotesi a cinghia: sbaglia di 2,36 volte), nessun blocco `homing:`, e i due assi sono stati rinominati il 2026-10-15 senza poterli verificare
- ~~Il reticolo dei fori motore è 31,0000 × 31,4500 invece di 31 quadrato~~ — **chiuso dall'utente il 2026-10-16: non è un errore, è una quota del progetto.** Ha stampato e avvitato con questo reticolo più volte e le viti entrano sempre, perché il gioco Ø4 su M3 vale 0,500 e lo scarto 0,450. E siccome *tutti* i pezzi del progetto portano lo stesso scarto, sono coerenti fra loro. Resta vero solo che la registrazione con le viti è esaurita, quindi l'offset utensile andrà misurato e non registrato — cosa che comunque va fatta
- **Aggiornare il carrello X nell'assieme CAD con la versione stampata.** Finché c'è quello vecchio, ogni controllo di interferenza ripesca le stesse otto collisioni finte degli MR63 — e una vera ci si nasconde dentro
- ~~Le due rotaie nell'assieme sono sfalsate di 31,252 mm in Y, e costano 22,9 mm di corsa~~ — **risolto in montaggio il 2026-10-15.** L'utente ha allineato le rotaie sulla macchina vera, quindi i 22,9 mm sono recuperati. Resta da riportare l'allineamento **nell'assieme CAD**, altrimenti ogni quota che se ne ricava è sbagliata di 31 mm
- **Il margine del carrello Y a fine corsa è 11,5 mm a destra e 9,8 a sinistra** con la cremagliera X v5, contro i 3,5 e 1,7 di prima. È accettabile, ma è il numero da ricontrollare quando il modulo penna aggiungerà materiale sul lato basso del carrello: la fascia critica è **Z 46,7÷59**
- **I 12 V di potenza passano ancora per i rail della breadboard**, dati per ~1 A contro i 2 A di picco dei due motori. Va portato su morsetti a vite quando l'elettronica si fissa alla base

- [2026-11-12] **I dieci millimetri su X si tengono: decisione dell'utente.** «Mi tengo i 10 mm in meno, non è un problema, mi creerebbe problemi di simmetria spostare la cremagliera.» Con questo l'area **241,232 × 236,064 diventa definitiva** e smette di essere provvisoria: l'ostacolo resta scritto a parte dal margine nel profilo, perché la distinzione fra impedimento meccanico e incertezza resta vera, ma nessuno deve più aspettarsi che quei millimetri tornino. Aggiornati i quattro posti che promettevano il recupero: `webui/js/profile.js`, `misure/impostazioni-glossario.md`, `misure/disegno-di-collaudo.md` e `misure/accensione-e-taratura.md`. **Una conseguenza da decidere:** il disegno di collaudo non si può generare perché il suo campo è largo 246 mm contro 241,232, e fin qui aspettare era una strada — adesso non più. O si rifà la disposizione della colonna di destra, o il disegno si dichiara superato nella pulizia dello Step 15.

### Step 6 — Modulo penna e interfaccia utensili

**Stato:** **completato quanto alla funzione** — dal 2026-10-23 il modulo disegna, e la procedura di inserimento della penna è rodata e scritta: si porta il servo alla quota di contatto già decisa (`G0 Z-21.271`), si infila la penna finché tocca il foglio e si stringe lì. I quattro angoli (battuta 17°, foglio 25°, alzata 34°, tappo 90°) sono stabili e il tratto esce costante su metri di disegno. Il **gioco** d'ingranamento **non si misura, per decisione presa il 2026-10-22** su obiezione dell'utente: la procedura che c'era è stata tolta e il perché sta scritto in `misure/accensione-e-taratura.md` §A2.1 — il modulo è in presa rigida, i 0,30 mm valgono 0,92° di servo contro una banda morta di 0,9°, nessuna impostazione dipende da quel numero, e a fare quel lavoro al posto suo sono le prove 7 e 11 del disegno di collaudo, che guardano la stessa cosa sulla carta. Il valore nel profilo è di **sola lettura** (`gioco: {x: 0.30, y: 0.30}`): spiega gli artefatti, non compensa niente, e nessuna riga di G-code lo usa

**Obiettivo:** la penna si appoggia e si solleva in modo ripetibile, con pressione costante, e il modulo è intercambiabile con altri utensili senza ritarare la macchina

**Decisioni progettuali:**
- **Un solo stadio mobile, nessun giunto a gioco morto: è quello che il CAD ha costruito.** *Supera la decisione del 2026-10-16* ("architettura a due stadi sulla stessa pista, con giunto a gioco morto da 6 mm"), non per un ripensamento ma perché l'architettura a due stadi **non è mai stata messa nel CAD**: dalla `prova_1` alla `prova_4` c'è un solo pezzo mobile (`pz2`, 12 cuscinetti) che porta sia la cremagliera sia i morsetti della penna. Rilevato il 2026-10-17 e confermato dall'utente nella stessa sessione, che descrive la taratura come tre angoli di servo — cioè esattamente la presa rigida. Lo schema `modulo-penna/schema.html` (rev. 2) descrive quindi un modulo che non esiste, e porta ora una nota in testa che lo dice. **Conseguenza principale:** l'unica cedevolezza della catena sono i **0,30 mm di gioco d'ingranamento** della coppia cremagliera/pignone — dentro quei 0,30 mm `pz2` si muove senza che il pignone giri, quindi la penna appoggia col proprio peso. È un gioco morto venti volte più piccolo di quello progettato, ma della stessa natura, ed è la ragione per cui l'angolo di appoggio è tarabile invece che critico al centesimo
- **Denti dritti sul pen-lift, non doppia elica** (deciso dall'utente il 2026-10-17, dopo averla impostata a 40° il 2026-10-16). La motivazione è sua ed è migliore di quella che avevo dato io: **l'ingranaggio è avvitato a un braccetto, quindi la sua quota assiale non è un riferimento** — dipende da quanto a fondo il braccetto va sullo spline, dalla profondità della tasca e da due viti M2 in torrette stampate. I denti dritti danno un **range** su quella quota; l'elica lo converte in errore nel piano di rotazione, cioè direttamente in quota della punta. Il progetto ha già il numero, misurato sugli assi X e Y il 2026-09-26: la doppia elica chiede il centraggio sull'apice entro **±0,17 mm**, i denti dritti entro **±2 mm**. Sugli assi il riferimento assiale esiste (il pignone è piantato a pressione sull'albero, e c'è la nota del 2026-09-26 sul motore in battuta con due rondelle); qui non esiste. *Questa decisione sostituisce il motivo che avevo scritto il 2026-10-16* — "il giunto a gioco morto scollega il pignone dalla punta" — che si appoggiava a un giunto che nel CAD non c'è: la conclusione regge, il ragionamento no
- **La quota di appoggio la dà il servo, in presa rigida nei due versi.** *Supera la decisione del 2026-10-01* ("il servo fa solo il sollevamento, la penna scende per peso proprio e galleggia"), su scelta dell'utente del 2026-10-15: il timore è che la catena non sia abbastanza sciolta perché il peso della penna la porti giù, e la preferenza è dare l'altezza e provare. **Conseguenza meccanica:** il gioco morto di 1,5 mm fra naso del braccetto e linguetta della biella va a zero, e il servo resta in coppia mentre si disegna. **Conseguenza sul software:** l'angolo di appoggio diventa un **valore tarato**, che vive nella tab Impostazioni del GDC CNC 2D SLICER e va regolabile a passo fine con la penna appoggiata sul foglio
- **Il numero da tenere d'occhio con la presa rigida è la risoluzione del servo.** Un SG90/MG90S ha una banda morta di circa 10 µs, che su 2000 µs per 180° fa **circa 1° di granularità**. Con il braccetto da 30 mm dell'architettura del 2026-10-01, 1° vale **0,52 mm** alla punta e l'intera corsa di 4 mm sta in 7,6° di servo: otto posizioni distinte in tutto, troppo poche per regolare l'appoggio di una punta in fibra. Per usare 90° di servo sui 4 mm di corsa il braccetto deve scendere a **~2,5 mm**, e lì a dominare diventa il gioco dei giunti. È il vincolo di progetto vero di questa strada, e va risolto nel CAD prima della stampa, non dopo
- **Mitigazione a costo quasi nullo, se la presa rigida si rivela troppo secca: una molla in serie** fra braccetto del servo e carrello della penna. Il servo continua a dare la quota — che è quello che l'utente vuole — ma l'errore di quota si trasforma in un piccolo errore di forza invece che in punta schiacciata o linea mancante. Con una molla morbida (~0,05 N/mm), mezzo millimetro di errore vale 0,025 N su un appoggio di 0,1÷0,3 N
- **Alternativa accantonata (non scartata): discesa per gravità con servo meccanicamente staccato in appoggio.** Restano validi i tre motivi del 2026-10-01 (carta non piana, nessuna taratura di Z, nessun jitter del servo sulla punta). **Da rivedere se:** la linea esce di spessore diverso secondo il punto del foglio, o se tarare l'angolo di appoggio richiede di rifarlo a ogni cambio di foglio. Nota tecnica per quel giorno: la discesa per gravità **non chiede che il servo sia reversibile** — il servo allontana attivamente il braccetto e il carrello scende da solo — quindi quello che decide è l'attrito della guida e dei giunti, non la scioltezza del servo
- **Parallelogramma articolato, non leva basculante.** Il parallelogramma mantiene la morsa **sempre verticale** (penna di qualunque lunghezza, nessuna spazzata della coda) e con le bielle orizzontali nella posizione di disegno è **insensibile al primo ordine al trascinamento della punta**. Il conto che ha escluso la leva: con pivot 46 mm sopra la punta e braccio 30, l'attrito di trascinamento (0,15÷0,3 N) cambia la forza sulla punta del ±45% **e cambia segno col verso di tracciamento** — linee più marcate in una direzione. Alternative scartate: leva basculante su due MR63 (un solo giunto, gioco quasi nullo, ma la geometria obbliga a una penna da ≤46 mm: resta la scelta giusta se si passa a refill D1 da 67 mm con corsa 2,5); tubi telescopici in ottone Ø6 in Ø8 (la soluzione più elegante e la migliore sul trascinamento, ma l'anima da 5,1 mm accetta un refill, non una penna); slitta su aste con bronzine stampate (il gioco della bronzina va diretto sulla punta e genera isteresi)
- **La geometria è forzata dall'ingombro: l'unica colonna libera a tutte le quote è Y > 36,050.** Mappato lo spazio sul piano YZ al centro del carrello: la faccia +Y è uno smusso a ~30° che va da Y 36,05 a Z −15 fino a Y 20,05 a Z −44. Più dentro il tetto lo mette prima lo smusso, poi la parete, poi il bordo d'ala a Y 25,050. Quindi **asse penna a X −42,500 (centro carrello, dentro l'interasse dei 60 mm) e Y ≈ 44**, appena fuori dalla piastra: la penna sta in aria libera a ogni quota, **la si infila dall'alto** e si vede. Dentro (Y ≈ 23) ci sono solo 82 mm, cioè refill D1 e nient'altro
- **Corsa 4 mm, servo MG90S.** *(La pressione dalla zavorra e il gioco morto da 1,5 mm valgono per l'architettura a gravità del 2026-10-01, accantonata il 2026-10-15: con la presa rigida la pressione la dà la quota imposta dal servo e il gioco morto non c'è.)* Coppia richiesta ~9 N·mm contro i 180÷220 disponibili: 20× di margine, quindi il servo si scegle per gli ingranaggi metallici, non per la coppia. Gioco morto di **1,5 mm** fra naso del braccetto e linguetta della biella: è quello che disaccoppia il servo mentre si disegna. Alimentazione 5 V dedicata (spunto ~700 mA) e **150÷250 ms di pausa in firmware** a ogni su/giù, altrimenti a 50 mm/s si sbavano 4 mm di tratto
- **Il modulo è un'interfaccia per una famiglia di utensili, non un pezzo singolo.** Conseguenza della scelta dell'utente di fare più moduli (pennarelli diversi, in prospettiva un taglierino). Requisito che cambia: l'interfaccia deve essere un **riferimento**, non solo un fissaggio — **due spine Ø3 asimmetriche** che definiscono la posizione, con le viti che fanno solo forza, altrimenti l'offset utensile va rimisurato a ogni cambio. Più **connettore invece di fili saldati** e un secondo canale servo riservato nel fascio
- **La sede dell'utensile permette la rotazione (ritegno assiale sì, blocco in rotazione opzionale).** Così la **lama trascinata** si ha gratis: è offset rispetto al suo asse e si orienta da sola seguendo il percorso, zero assi aggiuntivi. Alternativa scartata per ora: lama tangenziale orientata attivamente, che vuole un asse A vero coordinato con X e Y (un servo non basta — ha 180° e il percorso accumula angolo) e la punta **esattamente** sull'asse di rotazione
- **Offset utensile nel modello dati del firmware adesso, a zero.** La punta non sarà dove è il riferimento del carrello: col modulo previsto sta a ~44 mm in Y. Senza il campo, il giorno in cui si monta la penna tutti i limiti e tutti i disegni si spostano di 44 mm

**Criterio di completamento:** la macchina disegna un quadrato e un cerchio su carta, con tratto di spessore costante nei due versi di tracciamento e senza salti all'appoggio

**Note (cronologia dello step):**
- [2026-10-01] Architettura progettata per intero su richiesta dell'utente, poi **rinviata**: la macchina non disegna senza il secondo appoggio dell'asse X, e senza modulo penna si muove comunque e dà già informazioni. Supera la raccomandazione data poche ore prima di fare il modulo penna **prima** del secondo asse X, che si basava sul fatto che la penna è lo strumento di misura della macchina — argomento valido ma secondario rispetto al fatto che senza appoggio il portale non si può muovere
- [2026-10-06] **Il piano carta è fissato: Z ≈ 44,2 sopra il piano di base**, perché il punto più basso del carrello Y nell'assieme sta a Z 46,68. Serve una piattaforma alta 44 mm. E l'area di disegno è centrata su X −102,6 / Y −87,9, non sul centro della macchina
- [2026-10-12] **Il requisito "alimentazione 5 V dedicata" scritto il 2026-10-01 è stato pagato in anticipo, e male.** Il servo collegato al 5 V condiviso ha mandato in brownout l'ESP32 e tenuto fermo il progetto due giorni. Ora il servo ha il suo regolatore (vedi Step 1): quando il modulo penna arriverà, l'alimentazione è già quella giusta, e il secondo canale per il taglierino si attacca allo stesso ramo
- [2026-10-06] **La precisione della punta dipende dall'altezza, non solo dall'ingombro.** Il rollio del carrello si trasferisce sulla punta con braccio ~83 mm: **1 mrad di rollio = 0,083 mm di errore**. Quindi ogni 10 mm che si alza la carta si guadagna il 12% su quell'errore. Il limite è il fondo della gabbia motore, che ha 4,9 mm di PLA sotto all'ingranaggio: portandolo da −57,5 a −55 si guadagnano 2,5 mm gratis
- [2026-10-15] **L'utente sta disegnando il CAD.** Penna scelta: **Tratto Pen, Ø 10 mm**. Fissaggio con **due morsetti a 30÷40 mm di distanza verticale** — scelta giusta per la rigidezza angolare: anche con un decimo di gioco per morsetto l'inclinazione è 0,16°, che a 60 mm sotto vale 0,17 mm, meno del tratto della penna
- [2026-10-15] **L'attacco al carrello X è sui quattro fori del motore**: reticolo quadrato da 31,0 mm, M3, con la bozza Ø22 attorno all'albero. Da verificare quale delle due facce del motore è libera, perché su quella anteriore il modulo deve scavalcare albero e pignone
- [2026-10-15] **Promemoria di posizionamento, visto che Y è motorizzato su un lato solo:** in pianta la punta va il più vicino possibile alla mezzeria dei cuscinetti del carrello X e alla trave. L'errore di posizione è l'imbardata moltiplicata per lo sbalzo, quindi ogni millimetro di sbalzo la moltiplica invece di subirla. Si misura disegnando un quadrato grande e confrontando **le due diagonali**: è anche la misura che dirà se vale la pena motorizzare il lato sinistro, per cui lo spazio è già previsto dalla prova_3
- [2026-10-15] **L'attacco è sulla faccia posteriore del motore:** nessun conflitto con albero, pignone e cremagliera. È però la faccia **più lontana dalla trave**, quindi il modulo nasce allo sbalzo massimo — la direzione in cui l'imbardata si moltiplica. Non c'è alternativa pratica, quindi il vincolo diventa tenere il modulo compatto e portare la punta il più possibile verso il lato trave
- [2026-10-15] **Quota dalla faccia inferiore del carrello X al piano: 45 mm col metro, 46,7 nel CAD.** 1,7 mm di scarto, dentro l'errore di un metro a nastro: le due misure non si contraddicono. E la quota **non serve saperla con precisione**, perché l'aggiustamento è la penna che scorre nei morsetti — motivo per cui i morsetti non vanno usati come riferimento di quota, ma solo come serraggio. Il numero serve invece per l'altezza della piattaforma della carta, e conferma i 44 mm già previsti
- [2026-10-15] **Pignone e cremagliera al posto del braccetto, per il sollevamento: il confronto.** A parità di raggio le due soluzioni hanno la stessa cinematica (corsa = r × angolo), quindi la scelta non è sul rapporto. Decide un altro numero: **il gioco di una coppia stampata, ~0,2 mm**. Su una catena rigida (~5 N/mm) vale **1 N di incertezza sulla forza di appoggio**, cinque volte la forza voluta — presa rigida e ingranaggi stampati sono incompatibili. Con una **molla morbida in serie (~0,05 N/mm)** lo stesso gioco costa **0,01 N**, e con essa diventa irrilevante anche la banda morta del servo (0,9°, che a r = 7,5 vale 0,131 mm, cioè 0,007 N). Conseguenza: la molla in serie non è un accessorio, è ciò che rende praticabile la strada scelta — e una volta che c'è, **il pignone si sceglie sullo spazio disponibile, non sul rapporto**
- [2026-10-15] **Il vero punto debole del pignone non è il pignone: è la guida verticale.** L'attrito della slitta è in serie con la forza di appoggio, quindi 0,1 N di aderenza su 0,2 N voluti sono ±50% e isteresi (la penna preme diverso dopo un'alzata e dopo essere stata spinta su dalla carta). È l'unico punto in cui il parallelogramma del 2026-10-01 resta superiore, perché un perno su cuscinetti ha attrito molto minore di una slitta. Le due cose si possono combinare: parallelogramma o lamine flessibili per **guidare**, pignone e cremagliera per **muovere**
- [2026-10-16] **L'utente sceglie cuscinetti MR63 per lo scorrimento del portapenna, e la scelta ribalta il gruppo molla.** L'attrito della guida passa da ~0,150 N (bussola stampata, μ 0,3 su 0,5 N di carico) a ~0,001 N (cuscinetto che rotola): due ordini di grandezza, e il punto debole segnalato il 2026-10-15 sparisce. Conseguenza non ovvia: **il peso proprio dello stadio flottante basta e avanza**. Un cannotto da 25 g pesa 0,25 N, cioè più dei 0,2 N che si volevano ottenere comprimendo una molla di 4 mm. Una molla che spinge in giù non serve — sommerebbe la sua forza al peso; semmai servirà **in tiro, per alleggerire**, o si toglie materiale dal cannotto
- [2026-10-16] **Architettura a due stadi sulla stessa pista**, conseguenza della precedente. Stadio comandato: 2 cuscinetti, porta la cremagliera, la sua quota è l'angolo del servo. Stadio flottante: 4 cuscinetti in due coppie, porta i morsetti e la penna, appoggia per peso proprio. Fra i due un **giunto a gioco morto da 6 mm** (perno in asola) che impedisce alla quota imposta dal servo di arrivare alla punta. Con esso l'angolo di appoggio torna **non critico** e **il servo si può rilasciare a penna giù** — era l'unico vantaggio che la soluzione a gravità del 2026-10-01 aveva e che la presa rigida aveva perso. La decisione del 2026-10-15 regge quindi nella sostanza (il sollevamento è positivo e comandato), ma la forza d'appoggio torna al peso proprio
- [2026-10-16] **L'interasse fra le due coppie di cuscinetti è la quota che decide la precisione.** Il gioco residuo arriva alla punta amplificato: `errore = gioco × (1 + h/s)`, con h = quanto la punta sta sotto la coppia inferiore e s = interasse. Con 0,05 di gioco e h = 40: s = 15 → 0,18 mm; s = 25 → 0,13; s = 40 → 0,10; s = 55 → 0,09. Non si azzera, si diluisce — conviene spendere in altezza ogni millimetro che l'inviluppo concede
- [2026-10-16] **Due accorgimenti di stampa e montaggio per la pista:** precarico obbligatorio (un perno eccentrico per coppia, come sui carrelli), altrimenti il rotolamento non serve a niente perché il gioco va dritto alla punta; e righe di strato **nel verso dello scorrimento**, perché un cuscinetto da 6 mm che rotola perpendicolare agli strati li scavalca uno per uno
- [2026-10-16] **Primo CAD del modulo (`modulo_tratto-pen_tot_prova_1`), analizzato.** Nessuna interferenza fra i 21 componenti — il contrario degli assiemi precedenti, dove le booleane ripescavano otto collisioni finte. **La guida è vincolata correttamente:** 8 cuscinetti stringono una piastra in Z (spessore 5,000, luce fra i cuscinetti 5,400) e 4 stringono una nervatura in X (larghezza 5,600, luce 6,000); insieme bloccano cinque gradi di libertà e lasciano libera solo la traslazione lungo l'asse della penna. L'imbardata, che è l'errore che si dimentica più spesso, è vincolata
- [2026-10-16] **BUG EREDITATO: il reticolo dei fori motore è 31,0000 × 31,4500, non 31 quadrato.** Verificato su `pz1` e, nello stesso file, **sul carrello: identico, 31,0000 × 31,4500**. È lo stesso scarto di 0,450 registrato il 2026-10-05 sui fori motore del carrello e accettato perché "le viti entrano, i 0,500 di scarto stanno dentro il gioco Ø4 su M3". Allora era un pezzo, ora sono due, e la nota di allora diceva già il punto: **il gioco di registrazione è esaurito**. Conseguenza nuova e peggiore: la posizione di `pz1` sul motore è la posizione della punta, cioè l'offset utensile — e non c'è margine per registrarla con le viti
- [2026-10-16] **Il gioco della guida è 0,200 per lato su tutti e dodici i cuscinetti**, cioè 0,400 totali in entrambe le direzioni. Amplificato dalla leva vale **0,942 mm alla punta** (interasse coppie 35,450, punta 48,022 più in basso, fattore 2,355). I fori Ø3,2 su perni Ø3 danno esattamente 0,200 di ripresa: l'intenzione c'è, ma il margine è zero e i fori sono tondi, quindi il cuscinetto scappa in qualunque direzione mentre si stringe. Ripreso a 0,05 l'errore scende a 0,118 mm
- [2026-10-16] **Bilancio della massa flottante: 44÷61 g, cioè 0,44÷0,60 N, contro i 0,20÷0,29 N previsti.** `pz2` è 67,54 cm³ di solido (25÷42 g stampato secondo i parametri), più penna ~10 g, dodici cuscinetti ~5,4 g, attacchi e coprivite ~4,1 g. La forza d'appoggio si regola con una molla di richiamo **in tiro**, non alleggerendo il pezzo: 25 g di pezzo stampato non si raggiungono svuotando
- [2026-10-16] **Corsa sulla pista: 25,350 mm totali, ma 10,000 esatti in discesa e 15,350 in salita.** La pista è lunga 69,800 e il gruppo cuscinetti ne occupa 44,450. I 10 mm di corsa ci stanno, ma in discesa il margine è **zero**: conviene spostare il gruppo verso l'alto sulla pista finché è un parametro nel CAD e non un pezzo stampato
- [2026-10-16] **Il morsetto, come modellato, non tocca la penna** — ed è giusto, è disegnato aperto. Ma le distanze dicono due cose: la sede in `pz2` è una **parete piana** a 0,500 dalla penna (nessuna faccia cilindrica con asse penna in `pz2`), e l'attacco è un arco Ø12 su una penna Ø10, a 1,000. A morsetti stretti **l'asse della penna si sposta fino a 0,5 mm** rispetto al modello, e il contatto avviene sui due spigoli dell'arco. Una sede a V in `pz2` definirebbe l'asse per costruzione e distribuirebbe il contatto
- [2026-10-16] **I due coprivite sono fuori posizione:** stanno a X 42÷49, a 13,5 mm dal pezzo più vicino, dove non c'è nient'altro, e non hanno nessuna faccia cilindrica (nessun alloggiamento per la vite). Da posizionare e finire
- [2026-10-16] **Interasse dei morsetti: 40,000 mm**, cioè il massimo della forchetta 30÷40 che l'utente aveva indicato. Scelta giusta: la rigidezza angolare cresce con l'interasse
- [2026-10-16] **prova_2 analizzata.** Zero interferenze fra 23 componenti. `pz1` allungato di 6,000 mm sul lato basso: la corsa sulla pista passa da 10,000/15,350 a **16,000 in discesa e 15,350 in salita, 31,350 totali**, ben centrata sui 10 mm di corsa utile. `pz2` alleggerito del 6,6% (da 67,54 a 63,08 cm³). Servo spostato di −6,000 in Y e +3,400 in Z. Aggiunte le due viti dei morsetti
- [2026-10-16] **L'albero del servo è lungo Z, non lungo X.** Ø4,800 a X −37,450, Y −4,080, uscente verso il basso da Z −52,800. Quindi il pignone gira nel piano XY e la cremagliera è una stecca verticale lungo Y con i denti rivolti verso −X — coerente con la zona evidenziata dall'utente sulla faccia di `pz2` a X −16,500
- [2026-10-16] **Il diametro del pignone lo decide una distanza sola:** dall'albero (X −37,450) alla linea primitiva della cremagliera. E siccome il pignone sta sotto Z −52,800, cioè **sotto `pz1` che finisce a Z −41,200**, il suo ingombro laterale non interferisce con il corpo del modulo: si sceglie liberamente. `z28` → cremagliera a filo della faccia (sporgenza 1,45) ma disco Ø45; `z20` → sporgenza 7,45 e Ø33, **ed è il pignone che il progetto già stampa per gli assi**; `z14` → sporgenza 11,95 e Ø24. Con il gioco morto la risoluzione non è un criterio, quindi la scelta è fra sbalzo della cremagliera e ingombro del disco
- [2026-10-16] **Le due viti dei morsetti pesano ~19 g in acciaio** (Ø5,49 × 36,9), cioè **circa un terzo della massa flottante**. Bilancio aggiornato: 62÷70 g = **0,61÷0,69 N**, peggiore della prova_1 nonostante `pz2` sia più leggero, perché prima le viti non erano modellate. La testa sta a X 47, cioè 28,6 mm fuori dalla faccia di `pz2`: accorciare la vite è il risparmio di massa più grosso disponibile, e toglie anche lo sbalzo
- [2026-10-16] **I coprivite restano a X 42÷49**, ora accoppiati alla testa delle viti. L'insieme vite + coprivite sporge quindi di 28,6 mm dal fianco di `pz2`, in aria. Da chiarire se è voluto (una manopola che si raggiunge con le dita) o se vanno riavvicinati
- [2026-10-16] **DECISIONE: l'ingranaggio si attacca al braccetto in dotazione, non si stampa la scanalatura.** Proposta dell'utente, ed è la scelta giusta per una ragione quantitativa: lo spline di un SG90 ha 21 denti in modulo 0,2, cioè denti che sporgono di **0,20 mm** sopra la primitiva (altezza totale 0,45) — metà di una larghezza di estrusione. In PLA non ingrana, o ingrana e si spiana al primo carico. Il braccetto è stampato a iniezione, ha lo spline fatto bene e arriva con la vite di ritegno assiale. Si annega in una tasca dell'ingranaggio, si centra **sul mozzo tondo** (concentrico allo spline) e si indicizza sui bracci, tagliando i due lunghi a filo e tenendo i due corti. La coppia in gioco è ~2 N·mm, che su un braccio da 10 mm fa 0,2 N: due bracci avanzano. Fissaggio con due viti M2 nei fori che il braccetto ha già, meglio della colla perché smontabile. **Dettaglio che non va dimenticato: foro di accesso Ø3 sull'asse**, passante, altrimenti dopo l'incollaggio non si arriva più alla vite del servo e per smontare si distrugge l'ingranaggio
- [2026-10-16] **Il diametro del pignone ora dipende anche dal braccetto.** La tasca non può superare `m·(z − 2,5) − 4` (2 mm di spalla sotto i denti): z14 → 13,25; z20 → 22,25; z24 → 28,25; z28 → 34,25. Da misurare col calibro la campata dei due bracci corti e scegliere di conseguenza. Resta il compromesso dell'altro verso: più denti, meno sporgenza della cremagliera da `pz2` (z20 → 7,45; z28 → 1,45)
- [2026-10-16] **Cremagliera del pen-lift quotata** in `modulo-penna/cremagliera-e-pignone.html`. Modulo 1,5, angolo di pressione 20°: fianchi **rettilinei** — l'evolvente sta tutta nel pignone — quindi bastano tre semilarghezze e due altezze. Semilarghezza 0,63214 alla cresta, 1,17810 alla primitiva, 1,86054 al fondo; addendum 1,500, dedendum 1,875, passo 4,71239. Vano al fondo 0,99131, quindi raccordo massimo 0,496 e consigliato 0,3÷0,4. **Sei denti (28,274) bastano** per i 10 mm di corsa con presa di un dente per lato; larghezza della stecca 2 mm più del pignone, 1 per lato
- [2026-10-16] **Le quote del braccetto non sono standardizzate, e lo spline è incerto di 0,3 mm.** Cercate: nessun produttore pubblica un disegno quotato del braccetto a croce dell'SG90, e le dimensioni cambiano fra i cloni. Sul diametro esterno dello spline le fonti danno 4,6 / 4,8 / 4,9 — per un accoppiamento a contatto è una divergenza inaccettabile. Concorde invece il numero di denti, 21, da cui si deduce il modulo 0,2 (primitivo Ø4,2, esterno Ø4,6). Conseguenza di metodo: il disegno del braccetto è stato fatto **parametrico su sei quote da rilevare col calibro** (`modulo-penna/braccetto-e-ingranaggio.html`), non su valori presi da internet
- [2026-10-16] **Il numero di denti del pignone lo decide la campata dei bracci corti:** `z ≥ (A + 4) / 1,5 + 2,5`, dove A è la campata dopo aver tagliato i due bracci lunghi. Sotto A = 22 il pignone resta lo **z20 già in uso sugli assi**. E il centraggio dell'ingranaggio va fatto **sull'alloggiamento del mozzo** (tornito concentrico allo spline) con 0,2 di gioco, mentre la tasca dei bracci ha 0,4 di gioco e non centra niente: centrare sui bracci importerebbe nell'ingranaggio l'eccentricità dello stampo del braccetto
- [2026-10-16] **MIO ERRORE, segnalato dall'utente: il profilo della cremagliera gliel'avevo dato a gioco zero.** Le quote di accoppiamento avevano il loro gioco (tasca del braccetto A+0,4, mozzo C+0,2, stecca 1 mm per lato più larga del pignone), ma il profilo del dente erano le quote teoriche. **Una coppia stampata a gioco zero non ingrana.** Corretto: gioco di ingranamento **j = 0,30 mm**, scaricato tutto sulla cremagliera assottigliandone i denti sulla primitiva — semilarghezza da 1,17810 a **1,02810**, cresta 0,48214, fondo 1,71055, vano al fondo 1,29131 (che in cambio permette un raccordo fino a 0,645)
- [2026-10-16] **Perché 0,30 e non meno.** La posizione della cremagliera rispetto all'albero del servo è una catena che passa per la sporgenza stampata su `pz2`, la posizione dei cuscinetti e la sede del servo in `pz1`: realisticamente ±0,3 mm. E un errore di interasse cambia il gioco di `2·tan20° = 0,728` volte sé stesso. Con j nominale 0 il gioco reale va da −0,218 a +0,218, cioè **grippa metà delle volte**; con j = 0,30 va da +0,082 a +0,518 e non grippa mai. E qui il gioco **non costa niente**, perché il giunto a gioco morto rende la forza sulla carta indipendente dalla posizione del pignone: conviene esagerare
- [2026-10-16] **Il gioco non si fa mai riducendo il modulo.** Mettere 1,48 invece di 1,50 cambia il passo, quindi i denti si disallineano progressivamente lungo la stecca e un ingranamento buono in mezzo si impunta alle estremità. Si fa sullo spessore del dente o sull'interasse
- [2026-10-16] **Onshape: la feature Spur Gear ufficiale non ha un campo per il gioco** (verificato sul forum Onshape; alcune versioni custom l'hanno aggiunto spostando l'angolo dell'evolvente). È il motivo pratico per cui il gioco va messo nella cremagliera, che è uno sketch a mano e quindi sotto controllo. Parametri del pignone: teeth 20, module 1,5 mm (non diametral pitch), pressure angle 20°, depth 6, root fillet attivo, nessun bore. Tasca, alloggiamento del mozzo, foro di accesso Ø3 e fori M2 come feature separate sul corpo generato
- [2026-10-16] **prova_3: pignone modellato e `pz2` alleggerito del 27%** (da 63,08 a 46,20 cm³). Zero interferenze fra 24 componenti. Pignone z25 confermato nel CAD: centro X −37,500, Ø esterno 40,41 × 40,48, spessore 10,009. Profondità portata a 10 perché l'incavo del braccetto è 7 e con 8 restava 1 mm solo di presa filetto per le M2; con 10 ne restano 3. **Ci sta, ma è il massimo**: sotto l'albero del servo (Z −52,800) e il fondo di `pz2` (Z −63,100) ci sono 10,30 mm, e il disco ne usa 10
- [2026-10-16] **Corsa in discesa di `pz2`: 11,000 mm.** La limitano i cuscinetti inferiori (2 e 8) che arrivano in fondo alla pista; la scansione per collisione conferma il primo contatto a 11,1 mm, stesso evento. Fra prova_2 e prova_3 la pista si è accorciata di 5 mm sul lato basso (da Y −35,978 a −30,978) e la discesa è passata da 16,000 a 11,000: allungare la pista verso il basso è la leva se servisse più corsa. Salita 15,350, corsa totale **26,350**
- [2026-10-16] **La cremagliera vuole 9 denti (42,412).** Con l'origine sulla faccia inferiore di `pz2` (Y −30,000): nella posizione modellata il pignone ingrana a 25,922 dal fondo della stecca, a fine discesa a 36,922, a fine salita a 10,572. Con un dente di presa oltre ciascun estremo servono denti da 5,860 a 41,634, cioè 8,84 passi. **8 denti (37,699) non bastano**
- [2026-10-16] **Il servo non è il vincolo, e questo smonta il timore del montaggio.** A raggio 18,750 valgono 0,3272 mm per grado: l'intera corsa della guida (26,350) sta in **80,5° su ~180 disponibili**, e la corsa utile di 10 mm in 30,6°. Margine di montaggio **±49,7°, cioè ±16,3 mm**. Lo spline ha 21 denti, quindi le posizioni di montaggio sono quantizzate ogni 17,14° = 5,61 mm: con quel margine va bene qualunque dente entro ±2 posizioni da quella ideale
- [2026-10-17] **Il range assiale che i denti dritti concedono, misurato: 4,0 mm in tutto, ma 3,796 sotto e 0,196 sopra.** La stecca è larga 14,000 e il pignone 10,009, quindi la sovrapposizione di fascia tollera 4 mm di sfalsamento assiale — è esattamente il margine che l'utente dice di volersi tenere scegliendo i denti dritti. Non è però centrato: nella posizione modellata il pignone può scendere di 3,8 mm e salire di due decimi. In montaggio il pignone va quindi tenuto **alla quota modellata o più in basso**, mai più in alto; se si vuole il margine da entrambe le parti, basta spostare la fascia dentata di ~1,8 mm verso l'alto in Z
- [2026-10-17] **prova_4 analizzata: la cremagliera è modellata, geometricamente esatta, e a gioco zero.** Unica differenza da `prova_3`: `pz2` cresce di 1,800 in −X (la dentatura) e di 1,43 cm³. Zero interferenze fra tutti gli altri 23 componenti. Passo 4,712, profondità 3,375, fianchi a 20,00°, interasse 18,750: tutto esatto al millesimo. **10 denti** da Y −30,000 a +16,133, cioè 1,24 denti di margine sotto e 0,95 sopra il campo che serve (−24,140 ÷ +11,634). Corsa invariata, 11,000 in discesa e oltre 20 in salita escludendo i cuscinetti. Larghezza della stecca 14,000 contro i 10,009 del pignone, non centrata: sporge 3,796 sotto e **0,196 sopra**, quindi se il pignone deve spostarsi assialmente in montaggio ha margine solo verso il basso
- [2026-10-17] **MIO ERRORE, secondo giro sulle stesse tolleranze: il gioco j = 0,30 non è nel CAD.** Misurato traslando la stecca lungo Y a pignone fermo a passi di 0,025: la finestra senza compenetrazione è larga **0,000 mm** — un punto solo, non un intervallo. La curva è simmetrica attorno a quel punto (0,286 mm³ da una parte, 0,302 dall'altra), quindi i profili sono coniugati esatti: il disegno è giusto, è solo troppo pieno. Le quote disegnate sono le nominali (pianetto di cresta 1,264, vano al fondo 0,991) e non quelle della sezione 2 della scheda (0,964 e 1,291). **Causa probabile:** la scheda metteva le quote con l'offset in una tabella di semilarghezze, che non sono le quote che si disegnano in uno sketch — i pianetti sì. Corretta la scheda con le due quote da cambiare espresse come larghezze
- [2026-10-17] **CORREZIONE DI UN MIO NUMERO: il centro del pignone è X −37,450, non −37,500,** e quindi la primitiva della stecca è a **X −18,700**, non −18,750. L'avevo letto dal bounding box del pignone, che per una dentatura non allineata agli assi non è simmetrico (40,410 × 40,482). Il centro vero si legge dai cilindri di testa (R 20,250) e di fondo (R 16,875), concentrici. Nel CAD la stecca è a −18,700, cioè **giusta**: l'interasse misurato è esattamente 18,750. Il valore −37,450 era già scritto correttamente nella nota del 2026-10-16 sull'albero del servo: l'errore è stato usare il bounding box nella scheda invece di quel numero
- [2026-10-17] **La massa flottante non è più un problema di budget, perché non è più la forza d'appoggio.** Il bilancio aggiornato su `prova_4` dà 46÷56 g con riempimento 35÷50% (0,45÷0,55 N), di cui **19,15 g sono le due viti dei morsetti** in acciaio (9,58 g ciascuna, M6 × ~41). Ma con la presa rigida la forza sulla carta la dà la quota, non il peso: il peso serve solo a essere sollevato, e il servo a r = 18,750 dà 9,4 N contro 0,55, cioè **17× di margine**. Il target 0,20÷0,29 N scritto il 2026-10-16 valeva per l'architettura a gravità e **non si applica più**. Resta un motivo più debole per alleggerire (inerzia e vibrazione sull'alzata), e resta che dentro i 0,30 mm di gioco la penna appoggia col proprio peso: lì 0,55 N è il doppio di quello che si voleva
- [2026-10-17] **I bulloni esagonali nei morsetti: sì, ma il verso del carico decide dov'è la tasca.** La vite non tira, **spinge**: avanza nel filetto e la sua punta preme sul magnete dell'attacco, che schiaccia la penna. La reazione spinge quindi il bullone **verso l'esterno**, cioè fuori da una tasca aperta sul lato della testa. La tasca va aperta verso l'interno (lato penna) e la spalla deve stare sul lato esterno. Misure rilevate: la parete del morsetto va da X 7,50 a X 16,50 (**9,0 mm**), foro Ø5,500 passante, punta della vite a X 6,10. Un dado M6 standard (10,0 sulle facce, 5,0 di spessore) sta in tasca da X 7,50 a 12,70 e lascia **3,80 mm di spalla**: ci sta senza ingrossare niente. Il foro residuo va aperto a Ø6,5. Il fastidio è che la tasca guarda in orizzontale, quindi il dado cade mentre si monta: tasca a 10,1 sulle facce (presa a frizione) e si inserisce prima dell'attacco, che poi lo intrappola
- [2026-10-16] **Pignone grande o piccolo, per la forza del servo: non è un criterio.** Forza alla cremagliera = coppia / raggio. Con 1,8 kg·cm (≈177 N·mm) e r = 18,750 escono **9,4 N**; con r = 10,5 (z14) 16,9 N. Ma la massa flottante da sollevare è 0,55÷0,60 N, quindi il margine è **15×** già col pignone grande. Quello che il pignone grande compra davvero: la cremagliera cade sulla parete di `pz2` invece che su una mensola (meno massa flottante, che è il parametro fuori budget) ed è **1,8× più veloce** nell'alzata (0,051 s contro 0,091 per 10 mm), il che però conta poco contro il tempo di assestamento. Criterio vero: la geometria, non la coppia
- [2026-10-21] **MODULO MONTATO**, cuscinetti compresi: il collo di bottiglia del progetto si è sbloccato. L'utente riferisce accoppiamento cremagliera/pignone buono e cuscinetti che scorrono con gioco vicino a zero — resta da **misurare il gioco d'ingranamento**, che da progetto vale 0,30 mm e **non va ridotto**: è quello che ha preso il posto del giunto a gioco morto, e dentro quella banda la penna appoggia col proprio peso invece che con la quota imposta. Due cose scoperte al montaggio: il servo gira **al contrario** (risolto convertendo in un punto solo per lato della catena), e la prima taratura ha messo la battuta a **1° logico = 2489 µs**, fuori dalla specifica 500÷2400 dell'SG90 — l'ingranaggio è stato calettato col servo già contro il proprio fermo interno. Da rifare spostando l'ingranaggio di un dente di cannula (~19°), che porta la zona di lavoro a 2122÷2289 µs
- [2026-10-21] **La piattaforma da 44 mm è eliminata** (decisione dell'utente). Supera la nota del 2026-10-06, che la dava come necessaria: il piano carta a Z ≈ 44,2 nasceva dal punto più basso del carrello Y a Z 46,68, quando il modulo penna non era ancora disegnato. **Col modulo Tratto Pen montato sulla testina X lo spazio verticale libero è meno di 40 mm**, quindi la piattaforma non ci sta sotto. Il piano resta **unico: la tavola**, e il foglio ci appoggia sopra. Conseguenza sulla taratura: l'angolo di penna abbassata si impone stringendo la penna contro **la tavola**, non contro uno spessore — la quota assoluta non è mai stata un vincolo, perché a regolarla è la penna che scorre nei morsetti (nota del 2026-10-15). CAD aggiornato in arrivo
- [2026-10-22] **Il CAD con il modulo montato, letto numero per numero** (`misure/cad-assieme.md`). Tavola a Z 0, 700 × 600. **Asse della penna X −198,01 · Y −215,78**, ricavato dalla sede a V su `pz2` (tangenza di un Ø10 esattamente sulla bocca: la sede è disegnata per il Tratto Pen). **Sbalzo in Y 70,47 mm** dalla mezzeria del carrello, 50,94 oltre la faccia della trave — in X la punta è centrata a +7,67. **Punto più basso della testina Z 26,68** (16,68 a fondo corsa dello stadio flottante), quindi il vincolo sul foglio resta l'alzata della penna, 2,945 mm. Zona di disegno stimata X −206,20…49,89, Y −217,91…25,16, tutta sulla tavola con 32,8 mm davanti: ±2 mm, perché dipende da quali facce toccano i blocchi
- [2026-10-22] **Battuta misurata 17°** con la striscia di carta, contro i 19 fissati per costruzione il giorno prima: i due gradi sono quello che il modulo aveva ancora da scendere quando il pignone è stato calzato. I 25° di penna abbassata restano, perché non sono battuta + 6 ma l'angolo a cui la penna è stata stretta. **Nasce la posizione tappo a 90°**, che fa due lavori: riposo a fine stampa e all'accensione, e tetto del meccanismo (oltre, lo stadio flottante esce dalle guide). Conseguenza su FluidNC: l'arco dell'asse Z va dal contatto al tappo e non all'alzata, se no `mapConstrain` tronca — `max_travel_mm 21.271`, impulsi 2222 e 1500. **E il parser di FluidNC non accetta commenti in coda a una chiave**, cosa che il nostro config.yaml faceva quasi ovunque: riscritto il generatore, e il file a mano sostituito dalla copia generata
- [2026-10-23] **Il modulo disegna, e la procedura di montaggio della penna è quella definitiva.** Non si cerca la quota giusta muovendo il servo: si porta il servo alla quota **già decisa** e si stringe la penna lì — i 25° non sono una misura, sono un'imposizione, e il profilo lo dice da sempre. Il foglio deve essere sotto durante la stretta, perché la quota è definita *punta sul foglio* e non *punta sulla tavola*. Verificata su più stampe: il tratto resta costante su 4,4 m (vortice) e su 21 m di spirografo per quanto ne ha fatto. **Resta aperto il gioco**, l'ultimo parametro del profilo mai misurato: la rosa mistica dei medaglioni è stata disegnata apposta per leggerlo — nove vertici su cui convergono otto corde ciascuno, e se il punto d'arrivo dipende dalla direzione d'arrivo i vertici chiudono in una rosellina larga quanto il gioco

- [2026-10-26] **Il cambio colore non è un cambio di taratura.** Montando la penna nuova con il servo già **alla quota di contatto del programma in corso**, la procedura di montaggio del 2026-10-23 vale identica a metà stampa: si infila finché tocca il foglio e si stringe lì. Da qui la cancellazione della correzione di Z nel Sender (vedi Step 4), e il conto che la giustifica: 0,9° di banda morta del servo = **0,29 mm** alla punta, dieci volte lo spessore di un foglio.

- [2026-11-12] **La prova sulla carta che sostituisce la misura del gioco non è più il disegno di collaudo: sono le stampe vere.** Lo stato di questo step dice che a fare quel lavoro sono «le prove 7 e 11 del disegno di collaudo, che guardano la stessa cosa sulla carta». Quel disegno è **superato dal 2026-11-12** (decisione dell'utente, vedi Step 15) — e va detto che era un appoggio fragile già prima: dal 2026-10-23 non si poteva nemmeno generare, perché il suo campo è più largo dell'area. Il resto del ragionamento del 2026-10-22 non dipende da lui e resta in piedi: presa rigida, 0,30 mm che valgono 0,92° contro una banda morta di 0,9°, nessuna impostazione che usi quel numero. La prova sulla carta, oggi, sono i disegni veri — magneti compresi — che l'utente ha guardato e approvato.

### Step 7 — Logo e identità visiva della macchina

**Stato:** in corso — **il logo c'è, l'ha disegnato l'utente, ed è in repository.** Il 2026-11-01 è arrivato `CNC_2D_LOGO` fatto in Illustrator, rivisto due volte nella stessa giornata dopo l'analisi: `C 2 N D C` intercalate, la D annidata dentro l'ultima C rovesciata, il pennino dentro la prima. Le **tre varianti generate il 27 ottobre sono state cancellate** su richiesta dell'utente (restano in `git show 5c50952`). Dal 2026-11-02 il marchio **sta nell'applicazione**: nell'intestazione al posto delle parole «CNC 2D», e nel foglio con un pulsante accanto a quello del logo GDC Stuff. Manca: la **versione quadrata** per favicon e profili — e adesso non è più una previsione, è **misurata**: a 26 px di barra gli incastri non si leggono più —, la **firma del filone** («by GDC Stuff», decisione rimandata dall'utente), il **`.ai` aggiornato** e la prova **plottata su carta**.
*Supera lo stato del 2026-10-27* (tre varianti in attesa di scelta): la scelta è arrivata da un'altra parte

**Obiettivo:** un logo della macchina che si legga sul telaio e in fondo a un foglio, derivato dal logo GDC Stuff invece che somigliargli, e **disegnabile dalla macchina stessa**

**Decisioni progettuali:**
- **Le tre lettere di GDC non sono un alfabeto, quindi non si continua l'alfabeto.** Misurate sui percorsi del file: la G ha l'asta a **0,257** dell'altezza maiuscola, la C a **0,181**. Sono tre segni disegnati uno per uno; chiedere al disegno «come sarebbe una N in questo carattere» non ha risposta
- **Si continuano invece i tre modi di interrompere la forma**, che sono trasportabili su qualunque lettera: la **C spezzata** (vuoto di 64,8 su 196,6, un terzo della lettera, e si legge «C» comunque — *chiusura*), la **D piena** senza occhiello (*figura-sfondo* all'estremo), la **D più bassa** delle maiuscole (0,751, allineamento rotto per scelta). Nel logo dell'utente la chiusura c'era già, e non per caso
- **Il font di base è Jost Bold, con i contorni letti dal TTF** e non ridisegnati a mano: upem 1000, maiuscola 700. La **D piena è invece costruita** come mezzo ellisse al rapporto misurato (97 × 147,6), perché la D di Jost è disegnata come asta + pancia e non come esterno + occhiello: riempirla non dà un semicerchio pieno, dà una D con la pancia chiusa
- **La prossimità fa la lettura:** nella variante a riga lo stacco fra parola e numero è il **doppio** dell'avvicinamento fra le lettere, ed è quello che fa leggere «CNC» e «2D» come due cose invece di cinque segni in fila
- **Il logo lo disegna l'utente; la sessione lo misura e lo prepara.** *Supera la decisione del 2026-10-27* (tre varianti generate da un programma che applica le regole misurate su GDC Stuff). Il generatore faceva il lavoro giusto con lo strumento sbagliato: un logo è una scelta, e la scelta era di chi la macchina la costruisce. Quello che resta alla sessione è il mestiere che si misura — altezze, pesi, spaziature, dimensioni minime — e la preparazione dei file
- **Il bianco è inchiostro come un altro.** L'esportazione di Illustrator disegna i controformi (il 2 e la D) con path **bianchi** sopra ai neri: su carta si legge giusto, su un fondo grigio compaiono macchie bianche, su fondo nero resta solo «2 D». Nel repository il logo buono ha **buchi veri** (maschera) e `currentColor`, così funziona su carta, sul pannello scuro dello SLICER e in negativo. `logo/pulisci.py` lo rifà dall'esportazione a ogni giro
- **Le fessure si cuciono con un contorno, non con operazioni booleane.** Due pezzi che si toccano esattamente lasciano una riga chiara: nessuno dei due bordi copre tutto il pixel. In Illustrator non si vede — lavora in vettoriale — ma si vede su ogni schermo. Un contorno dello stesso colore da **0,3 unità** (0,19% dell'altezza) porta la riga da 222/255 a 252/255 sul bianco e da 40 a 5 dentro al nero. **Più grosso no:** a 2,0 si mangia lo stacco di 2,17 unità fra il pennino e la sua barra, che è voluto

**Criterio di completamento:** del logo scelto esistono **due cose**: il file che funziona su qualunque fondo (buchi veri, niente bianco disegnato) e la **versione quadrata** per le misure piccole; e la macchina lo ha **disegnato su carta** almeno una volta.
*Riscritto il 2026-11-01:* il criterio precedente parlava di `clipPath` e delle due metà della C, che erano dettagli del **generatore** — e il generatore non c'è più

**Note (cronologia dello step):**
- [2026-11-02] **Il marchio entra nell'applicazione, e si scopre dove non funziona.** Nell'intestazione sta al posto delle parole «CNC 2D» — resta «GDC» davanti e «SLICER» dietro, così la riga si legge per intero — in `currentColor`, quindi segue il tema senza una seconda copia. Ma **a misura di intestazione non si legge come lettere**: gli incastri che lo rendono interessante a venti millimetri, a venti pixel diventano una macchia. Sta a 26 px perché la barra è alta 52; sotto i 20 non si riconosce più. È la **conferma misurata** che la versione quadrata del criterio non è un di più: un marchio piccolo si disegna, non si rimpicciolisce.
- [2026-11-02] **E il marchio entra anche nel foglio**, con un pulsante accanto a quello del logo GDC Stuff: livello nuovo, come il vicino. Due cose imparate mettendocelo. Primo, **va ridotto a un colore solo** prima di darlo all'importatore: sullo schermo è fatto di lettere piene, contrografici bianchi e un bordo di cucitura — tre colori, e l'importatore divide per colore, quindi arrivava spezzato in due livelli con un «2 D» che galleggiava senza il resto. Ma quei colori non sono penne: sono il modo di ritagliare un buco in un'area piena, e su carta una penna sola traccia il contorno delle lettere **e** quello dei buchi, col bianco che è la carta. Secondo, **l'SVG è uno solo**: quello dell'intestazione, letto dalla pagina al momento del clic, così quando il logo cambia cambiano insieme il marchio in alto e quello che finisce sul foglio.
- [2026-10-27] **Misurato `gdc master.svg` campionando i percorsi veri**, non a occhio: asta della G 50,6/196,6, della C 35,4/196,6, vuoto della C 64,8, D 97 × 147,6 e **piena**, due filetti 116,55 × 7,14 ai lati di STUFF. Ogni costante del generatore è una di queste misure, in frazione dell'altezza maiuscola.
- [2026-11-01] **È arrivato il logo vero, e l'analisi ha trovato cinque cose misurabili.** Ingombro 472,19 × 158,44 (2,98:1). **(1)** L'overshoot era **al contrario**: le C alte 151,41 contro i 158,44 della N, cioè il 4,4% **più basse**, mentre una tonda deve sbordare oltre una piatta dell'1-3%. **(2)** Le C pesano il **15%** più della N (spina 43,7 contro asta 38,1), dove la correzione ottica ne chiede il 2-5%. **(3)** Tre linee di cima diverse (195,77 / 199,30 / 202,97): 7,2 unità, il 4,5% dell'altezza — troppo poco per sembrare voluto. **(4)** Spaziature con il **23%** di scarto (38,6 contro 47,4). **(5)** Il pennino, che è la cosa migliore del marchio, **muore sotto i 200 px** di larghezza, e il marchio intero sotto i 120. Più il difetto di produzione: funzionava **solo sul bianco**.
- [2026-11-01] **La revisione dell'utente prende due numeri su tre.** C alzate a 158,49 — pari alla N, cioè ancora 1-2% sotto l'overshoot vero ma fuori dall'errore —; spaziature da 23% a **4%** di scarto; D da 120,40 a 125,91. Il peso **non è cambiato** (+16%: ingrandire la C ingrandisce il suo anello), ed è rimasta l'unica cosa che vale la pena toccare. Nel file nuovo sono comparsi due pezzi fantasma: un path `fill:none` e una **polilinea di area zero** (tre punti sulla stessa retta), invisibili sullo schermo e **disegnati da un plotter**. `pulisci.py` adesso li butta, calcolando l'area.
- [2026-10-27] **Tre varianti, tre usi diversi.** **A — la riga:** `CNC 2D` in fila, da leggere, regge fino a 16 px. **B — il monogramma:** lo schizzo dell'utente messo in squadra, il 2 e la N fusi sulla larghezza di un'asta. **C — la chiusura:** `CNC` grande col `2D` dentro al vuoto della C finale, cioè il difetto trasformato nel posto dove sta il resto del nome; va usata grande, perché a 16 px il «2D» si chiude in una macchia. **La variante B è la mia lettura dello schizzo e va confermata:** nella foto il secondo segno può essere un 2 dentro la N o una N col ricciolo, e ho scelto.

### Step 8 — Miglioramenti della macchina: cavi, box elettronica, alloggiamenti

**Stato:** in corso, **in attesa dell'utente** — progetto sui numeri del CAD, niente stampato. Tre fronti aperti il 2026-10-27: i cavi dei motori e del servo che strisciano sul piano, il circuito da chiudere in un box con coperchio trasparente, e lo spazio libero a sinistra da trasformare in alloggiamenti. **Il 2026-11-08 l'utente ha deciso l'ordine dei lavori:** prima prova delle **cerniere già pronte su MakerWorld**, poi si disegna il resto attorno a quelle — box e passacavi si progettano sulla cerniera scelta, non il contrario

**Obiettivo:** nessun cavo tocca il piano in nessuna posizione dei carrelli; il circuito resta **a vista** dentro un box chiuso; fogli, penne e moduli hanno un posto sulla macchina

**Decisioni progettuali:**
- **Il box va nella striscia da 140,04 mm, non in quella da 147,5.** A sinistra ci sono **due** strisce libere e non una: la prima (X −493,74 … −353,70) ha **altezza libera** perché la trave finisce lì; la seconda (fino a X −206,20) è più larga ma ha il **soffitto a Z 104,18**, dove il portale ci passa sopra. Un box alto 120 nella seconda lo prende in pieno il portale
- **Catena stampata sull'asse Y, cavo piatto sopra la trave per l'asse X.** La faccia superiore della trave è a **Z 127,68** e sopra non c'è niente: un cavo lì è più alto del foglio, della penna e di qualunque cosa appoggi sul piano — **toglie** il cavo dal piano invece di spostarlo. Sull'asse X la catena è scartata non per ingombro ma per massa: 17 maglie sul carrello sono peso nel posto peggiore della macchina, con lo **sbalzo di 70,47 mm** in Y che lo moltiplica sull'imbardata (vedi `cad-assieme.md`)
- **Gli alloggiamenti sono due oggetti, non uno.** I fogli A5 in piano entrano per **mezzo millimetro** (148 contro 147,5) e le penne in piedi non ci stanno sotto un soffitto di 104: quindi un vano **basso** sotto la trave (fogli coricati, moduli) e una rastrelliera **alta** accanto al box, dove l'altezza è libera. Progettare un contenitore unico sarebbe stato scoprirlo a stampa fatta

**Criterio di completamento:** portando i carrelli a tutte e quattro le combinazioni di fine corsa nessun cavo sfiora il piano né si impiglia; il coperchio del box chiude con il circuito dentro e si vede; fogli, penne e moduli stanno al loro posto

**Note (cronologia dello step):**
- [2026-10-27] **`misure/cavi-box-e-alloggiamenti.md`:** le due strisce a sinistra, i percorsi possibili per i due assi, e la catena dimensionata — **passo 16, raggio 30**, che fa 29,9° per giunto e rispetta la regola dei 5÷10 diametri di cavo; **17 maglie su X e 16 su Y**, ansa alta **84 mm**. Tutti i numeri vengono dal STEP, non dallo schermo.
- [2026-10-27] **Tre misure mancano e non si inventano:** la **sezione della rotaia destra** (nel CAD c'è la cremagliera, non la rotaia) e dove ci si può avvitare, l'**ingombro della scheda** con driver e alimentatore, il **diametro vero dei cavi**. E i 140 mm vanno confermati col metro, perché la posizione dei blocchi nel CAD vale ±2 mm.

### Step 9 — Il telecomando della macchina

**Stato:** **completato** (2026-11-03) — **la stampa a due colori è stata portata a termine senza toccare il portatile.** L'ha confermato l'utente: cambio penna annunciato dal cicalino, procedura chiusa dai tasti, anello a raccontare il resto. *Supera lo stato del 2026-11-02* («non resta nessuna taratura», ma il criterio era ancora aperto) e quello del 2026-10-31 («mancato per un tasto solo»: il tasto RIPRENDI è stato aggiustato e ha funzionato). **Il lavoro non è finito qui:** i cinque lavori che restano — la SD, i dispositivi, il firmware da ricaricare, l'interruttore, il tasto che chiude il racconto — stanno nello **Step 13**, aperto il 2026-11-08
**Con un'avvertenza che vale la pena scrivere:** quella stampa è girata col firmware **di prima** delle correzioni sulla fine stampa, quindi dimostra la catena — invio, cambio penna chiamato dalla macchina e accettato dal telecomando, ripresa, fine — e **non** dimostra niente del lavoro del 2026-11-02 sera. Quello è stato verificato separatamente il 2026-11-03, quando l'utente ha caricato il firmware nuovo e ha confermato che funziona.
Quello che resta è lavoro nuovo, non il criterio: il **passo della punta sul telecomando** (oggi la terza schermata dice «ANGOLO / DAL PC» e non ha tasti, perché ritrovare la punta vuol dire guidare la testina e guardare dove cade) e il **volume del cicalino alle tacche basse**, mai uscito da un banco di prova.

**Stato di prima (2026-11-02):** in corso — il telecomando ha lavorato a una stampa vera, e il criterio è mancato per un tasto solo. Il 2026-10-31 il biglietto per il cliente Feffi è stato stampato a due colori col telecomando acceso: schermate, suoni, LED, pausa, stop e il primo passo del cambio penna hanno funzionato alla macchina. **RIPRENDI, il tasto che chiude il cambio penna, non riprendeva** — difetto nel SLICER, non nel telecomando — quindi la ripresa è stata fatta dal portatile: il criterio **non è passato**, e passerà alla prossima stampa a due colori con il tasto aggiustato. Sistemati nella stessa giornata altri cinque difetti visti solo accendendo l'oggetto (vedi note), fra cui la **tabella dei pad girata di mezzo giro**. Il 2026-11-01 **la batteria funziona** (era quasi certamente solo scarica), il caricabatterie è stato messo in chiaro registro per registro, **`K_PARTITORE` è tarato a 1,284** sulla macchina vera e il tasto del cambio penna dice l'**azione** invece del proprio nome. **La sera del 2026-11-01 il capitolo batteria si chiude:** la taratura è confermata su **due punti** a 0,37 V di distanza che danno lo stesso K a un decimillesimo (quindi un rapporto basta, non serve una retta), e **la carica è dimostrata** — 47% → 59% in un'ora, dentro alla previsione fatta prima di misurare. Il 2026-11-02 **finiscono anche le tarature**: la risonanza del cicalino è misurata a **2500 Hz** con un torneo a due note per volta, i quattro suoni sono scelti all'ascolto, e c'è un **volume** comandato dal SLICER. Nella stessa giornata il telecomando impara a dire che cosa succede **alla fine di una stampa**: «fatta» quando la macchina si è fermata davvero, «fermata» quando l'hai interrotta tu, e un «fermo» di passaggio che toglie lo sfarfallio dopo lo STOP. **Non resta nessuna taratura.**
*Supera lo stato scritto il 2026-10-31 09:33* («manca la prova sul campo»: la prova c'è stata) e quello del 2026-10-29 («manca solo il firmware»). **Il firmware resta non compilabile da dentro la sessione** — `downloads.arduino.cc` è bloccato — quindi ogni modifica richiede una tornata di compilazione sulla macchina dell'utente; quello che si può fare da qui è scritto in `schermo/README.md`

**Obiettivo:** sapere che cos'è successo alla stampa **senza guardare il portatile**, e poter chiudere il cambio penna **stando alla macchina** — con le mani sulla penna, che è dove la procedura si svolge

**Decisioni progettuali:**
- **L'oggetto è un MKR IoT Carrier Rev2 con dentro un MKR WiFi 1010**, già in casa: display TFT tondo 1,3" 240 × 240, **cinque tasti** capacitivi intorno, cinque LED RGB APA102, **cicalino**, micro SD, batteria 18650 con ricarica via USB. *Supera l'ipotesi presa poche ore prima nella stessa giornata* — un pannello **GC9A01** pilotato dal secondo ESP32 — che funzionava e costava zero ma non aveva tasti né batteria, e voleva cinque fili SPI dal box al coperchio accanto ai cavi dei motori. Il carrier risolve tutte e quattro le cose, e **non è uno schermo: è un telecomando che ha anche uno schermo**
- **Il telecomando è un secondo client del SLICER, non della macchina.** I dati che deve mostrare **non esistono in FluidNC**: la stampa non è un file che l'ESP32 esegue, è il browser che manda una riga alla volta e conta gli `ok`. Percentuale, tempo rimanente, cambi penna, errori e colore della penna vivono in `State.data.stampa` e da nessun'altra parte. Scartate: leggere da FluidNC come secondo client (dà posizione e `Run/Idle/Hold`, cioè la metà facile e non quella che serve) e mettere il display sull'ESP32 montato (vuol dire forkare FluidNC e perdere la corrispondenza con la 4.1.1 verificata il 2026-10-22, dove il `config.yaml` è **generato** e il firmware è quello ufficiale)
- **Un canale solo, in due versi.** Un browser non apre socket TCP: il telecomando fa da **server HTTP**, il SLICER gli manda lo stato con un `POST`, e **la risposta a quel POST riporta il tasto premuto e la carica**. Il telecomando non comincia mai lui una conversazione, non conosce l'indirizzo della macchina e non ci parla: la regola «non comanda FluidNC» così non è disciplina, è **struttura**
- **I tasti non reimplementano niente**: entrano dalla stessa porta da cui entrerebbe un dito sulla pagina — pausa e riprendi al `Sender`, i due passi del cambio penna al `Popup` che già li governa. Due procedure di cambio penna divergerebbero alla prima modifica, e te ne accorgeresti col foglio rovinato
- **Il telecomando non muove la macchina**: ferma, riprende, guida il cambio penna. Mandare un carrello da qualche parte vuol dire guardare delle coordinate, e su 33 mm di vetro le coordinate non ci stanno. L'unica eccezione è il tasto **PROVA** del montaggio, che alza e abbassa il servo — lo stai guardando da venti centimetri con la penna in mano
- **Lo STOP si conferma due volte** (richiesta dell'utente): un tocco che **chiede**, con l'anello che diventa un conto alla rovescia rosso e si svuota, più un **ANNULLA** esplicito; poi un secondo tocco **tenuto un secondo**, con uno spicchio che si riempie al centro del vetro. Lo spicchio è un oggetto diverso dall'anello apposta — l'anello sta sul bordo e dice a che punto è la stampa, lo spicchio sta in mezzo e dice a che punto è il tuo dito — ma girano nello stesso verso. Al SLICER arriva **un `stop` solo, già confermato**: i due tempi sono interfaccia del telecomando
- **Quattro suoni: due allarmi e due motivetti**, e uno solo si ripete. Il punto è capire cosa è successo **senza guardare**. **Cambio penna** (due colpi, **ogni 20 s finché non premi**) e **problema** (uno lungo) devono arrivare *dall'altra stanza*: stanno su **una nota sola**, quella della risonanza del cicalino, e si distinguono per il **ritmo** — una differenza che regge anche attutita da una porta, mentre due altezze diverse, attutite, diventano la stessa cosa. **Partenza** (tre note che salgono) e **fine** (un motivetto che scende e torna su) li senti da vicino e possono permettersi delle note, tutte dentro l'ottava in cui il trasduttore parla (**A7-D8, 3,5-4,7 kHz**); la fine **attacca sulla nota più forte**, così la prima cosa che senti arriva comunque lontano. Nessuno dei quattro chiede un campo nuovo al protocollo: sono **quattro cambi di `stato`** che il POST porta già. *Supera i tre suoni del 2026-10-28* («due note alte», «tre che scendono», «tre basse»), scritti pensando a un cicalino con l'oscillatore dentro: vedi la voce del 2026-10-29 15:03
- **La pila si vede dove serve e non sempre.** Sul telecomando: **sempre sulla schermata Pronta** — quella che hai davanti quando lo prendi in mano — e **sotto al 20% dappertutto**, in rosso, perché lì non è un dato ma un avviso; non sulle due schermate dello stop, dove in mezzo a una domanda è rumore. Nel SLICER: in alto accanto allo stato della macchina, **solo quando il telecomando ha risposto**
- **La micro SD: libro di bordo e casa del SLICER.** Una riga per stampa in CSV (data mandata dal SLICER, che il telecomando un orologio che sopravviva a una batteria scarica non ce l'ha), scritta **a fine stampa e non a ogni messaggio**. E soprattutto: ci può stare **la pagina del SLICER compressa**, che rimette in gioco l'indirizzo unico perso il 2026-10-25 quando la pagina fu tolta dall'ESP32 per mancanza di spazio — **senza toccare la macchina**, perché servire un file non è comandarla. Scartato: **stampare dalla SD**, che romperebbe la regola, rifarebbe col SAMD21 il guasto del canale lungo del 2026-10-23, e comunque non scioglie il legame col portatile — il programma si **rigenera** dopo i tre popup con le misure di quel giorno, quindi il G-code di ieri non vale oggi

**Criterio di completamento:** una stampa a due colori portata a termine **senza toccare il portatile** dopo l'avvio: il cambio penna annunciato dal cicalino, la procedura chiusa dai tasti, e l'anello che racconta il resto

**Note (cronologia dello step):**
- [2026-10-28] **La grafica prima dell'hardware.** `schermo/mock.html` disegna le dieci schermate **due volte**, grande e a grandezza vera: una grafica che funziona solo nel riquadro grande non funziona. Il vincolo che comanda tutto è **0,1376 mm per pixel** (240 px su 33 mm): una riga a 24 px è alta tre millimetri e tre decimi, e nel tondo ci stanno **un simbolo, un numero e due parole**. Il «1 di 2» è stato **disegnato** invece che scritto, poi tolto del tutto quando sono arrivate le etichette dei tasti, che sullo stesso bordo contano di più.
- [2026-10-28] **Numeri confermati dal datasheet ABX00073** (l'utente ha mandato i PDF: `docs.arduino.cc` non è raggiungibile dalla sessione): display **1,3" 240 × 240**, modulo 36 × 40 mm; **5 tasti qTouch** e **5 LED APA102**; libreria **`Arduino_MKRIoTCarrier` 2.0.0 o successiva**, dichiarata come *requisito*. L'ipotesi prudente da cui si era partiti (33 mm) era quella giusta, quindi la grafica non si è toccata.
- [2026-10-28] **Due regali dal pinout.** **D3 è `DISP_BL`**: la retroilluminazione è comandabile, quindi il vetro **si spegne davvero** invece di diventare nero — e il risparmio di batteria passa da speranza a fatto, con la IMU che serve a risvegliarlo prendendolo in mano. E **tutti i piedini del MKR sono occupati** (tasti su A1÷A5, LED su D4/D5, cicalino su D7, SPI condivisa fra display e SD, I²C per i sensori): **liberi restano solo A0 e A6**, sui Grove analogici.
- [2026-10-28] **Come si legge la carica, in ordine di costo:** `analogRead(ADC_BATTERY)` se la variante del MKR lo definisce — **una riga di sketch risponde**, ed è la prima cosa da provare —; poi il PMIC BQ24195L, che dà di sicuro lo **stato** (in carica, carica, in scarica) ma non ha un misuratore di carica a bordo; in ultimo un partitore sul Grove A0. Dalla tensione la percentuale è un'approssimazione, perché la curva di una Li-ion è piatta in mezzo: niente decimali, e si guarda il colore.
- [2026-10-28] **Il lato SLICER è fatto e collaudato** (`webui/js/telecomando.js`, 37 asserzioni contro un telecomando finto). Il messaggio: `POST /stato` con `{v, stato, nome, percento, rimanente, passo, macchina, azzerata, data}`, risposta `{tasto, batteria}`. Battito a **due velocità**: 400 ms con qualcosa in corso, 2 s a riposo — a riposo non c'è niente da raccontare, ma bisogna comunque accorgersi che qualcuno ha premuto. **Indirizzo vuoto = spento**, che è lo stato normale di chi non ce l'ha.
- [2026-10-28] **Quello che manca:** il firmware (`Arduino_MKRIoTCarrier` + `WiFiNINA`), la corrispondenza **numero ↔ posizione** dei cinque pad (si vede premendoli: le posizioni nel mock sono giuste), e il **colore della penna** nel messaggio — il SLICER lo sa, è la tinta del livello, ma va portato fin dentro al G-code per sapere *quale* penna sta disegnando a metà programma.
- [2026-10-29] **Gli schemi Altium del carrier chiudono i numeri dei pad.** L'utente ha mandato anche gli schematici e il `.PcbDoc` (file OLE con dentro record a `|CHIAVE=valore`: leggibili). Dal rame: ogni pad va al suo piedino con una resistenza da **zero ohm** e **nessun condensatore**, e i poligoni dicono dove sta ciascuno. **TOUCH0** in basso a sinistra (A5), **1** in alto a sinistra (A1), **2 in alto** (A2), **3** in alto a destra (A3), **4** in basso a destra (A4); stanno a **60°** uno dall'altro, non a 72 — cinque posti su sei, il vuoto in basso. I LED seguono i pad senza conversioni: nella catena APA102 il dato entra in DL4 e arriva a DL8, e sul rame DL4+n sta accanto al pad n. *Supera il «si vede premendoli» della nota qui sopra.* Resta un'occhiata alla scheda per destra/sinistra: i pad sono rame sulla faccia del vetro, e guardarla specchia i lati — ma l'insieme delle posizioni è simmetrico, quindi **il 2 resta in alto** comunque. `schermo/leggi-schemi.py` rifà tutti questi numeri dai file, perché una tabella copiata a mano fra un mese non si distingue da una indovinata.
- [2026-10-29] **Il cicalino non è quello che si credeva, e ha cambiato i suoni.** M1 è un **ABT-461-RC**, trasduttore magnetico **a comando esterno**: dentro non ha un oscillatore, quindi non suona perché gli dai tensione — suona finché gli fai commutare il piedino (D7 → Q1, un 2N7002K sul lato basso; il trasduttore sta sul 3V3, R8 fra i due è uno zero ohm). E **non ha volume**: o commuta o non commuta. L'unica cosa che cambia quanto si sente è la **frequenza**, perché ha una **risonanza** intorno ai 4 kHz. I 4 kHz esatti sono **da confermare a orecchio** — lo schema dice il tipo, non la frequenza — e una spazzata da 1 a 6 kHz col firmware la trova in dieci secondi.
- [2026-10-29] **La retroilluminazione è un alimentatore, non un transistor.** Dietro a D3 c'è un convertitore a innalzamento (U3/U6 con l'induttanza L6 da 10 µH, dal 3V3) che tira la fila di LED del pannello. Spegnere **ferma il convertitore**, quindi risparmia corrente vera; un'onda quadra lo **attenua**, quindi «acceso ma piano» esiste e costa meno; e R19 tiene quel piedino **a terra a riposo**, quindi all'accensione il vetro è **nero finché non lo alza il firmware** — da sapere prima di crederlo rotto.
- [2026-10-29] **La batteria non arriva allo zoccolo, confermato dal rame.** La rete `VBAT` tocca solo il contatto del portabatteria (J8) e il connettore del cavetto (J11): **nello zoccolo del MKR non entra**. Nessun ADC la può vedere, quindi resta il partitore sul Grove A0 — non è una svista da aggirare con un piedino nascosto. E il **reset del pannello** è attaccato (R9) alla linea di reset del MKR: il vetro si azzera solo azzerando la scheda.
- [2026-10-29] **I quattro suoni si sentono nel banco di prova**, col pulsante accanto a ognuno, e la prova li fa passare per un **filtro centrato sulla risonanza** invece di pareggiarli: una prova che li pareggia direbbe una bugia comoda, e la bugia si scoprirebbe in officina con un motivetto inudibile dall'altra stanza. C'è l'interruttore per togliere il filtro. Il disegnino accanto a ogni suono ha il tempo in orizzontale, l'altezza in verticale e il **pallore sulla resa**; la pagina sputa la tabella `{hertz, millesimi}` già pronta per lo sketch, così non si ricopia a mano un suono scelto bene.
- [2026-10-29] **Lo spazio utile del vetro è un cerchio, e le parole si posano per lo spigolo.** L'utente ha visto parole che toccavano l'anello e la parola in mezzo al vetro. Causa unica: le etichette si posavano per il **punto di appoggio**, ma su un vetro tondo quello che urta è sempre un **angolo** — quello alto per le etichette di sopra, quello basso per quelle di sotto — quindi mettendo sul raggio giusto il punto d'appoggio l'angolo finiva comunque fuori. Adesso si posano per lo spigolo, dentro un cerchio di **raggio 93** (l'anello comincia a 95,5). Corretti di conseguenza IN PAUSA, FERMARE?, lo spicchio del tocco lungo, la penna alzata sotto FATTO, la pila dell'avviso e la frase che spiega perché manca la stima. Tolto «tieni premuto»: il tasto accanto dice già TIENI, ed era la stessa parola due volte a due centimetri di distanza. Il banco adesso **misura** il rettangolo dell'inchiostro di ogni parola — non quello tipografico, che va dall'ascendente al discendente e segnalerebbe come scontro due righe impilate apposta — su trenta schermate.
- [2026-10-29] **Il firmware gira sulla scheda.** Caricato al secondo tentativo: il primo errore era `WiFiNINA.h` non installata, il secondo — l'unico vero — è che **l'IDE di Arduino non compila il `.ino` com'è scritto**: genera i prototipi di tutte le funzioni e li infila *prima della prima funzione*, quindi i tipi dichiarati più in basso venivano nominati quando ancora non esistevano. Spostati tipi e variabili sopra la prima funzione. Il controllo con `g++` non poteva prenderlo (i prototipi non se li inventa): adesso se li inventa anche lui, e sulla versione di prima l'errore esce identico a quello dell'IDE. Il telecomando viene trovato dal SLICER e la prova in bianco funziona.
- [2026-10-29] **Difetto trovato dalla prima accensione vera: «da azzerare» anche dopo l'homing.** Il vetro si ridisegnava solo quando cambiava SCHERMATA, e azzerare la macchina non la cambia — resta «pronta», cambia solo la riga sotto. Stessa trappola per il pallino del colore, che arriva un attimo dopo l'inizio della stampa, perché il segno di penna sta nel G-code all'inizio del livello. Adesso il vetro si rifà anche quando cambia **quello che c'è scritto sopra**, non solo quale schermata è.
- [2026-10-29] **La prova in bianco** (Impostazioni → *Prova in bianco*): il SLICER recita una stampa intera — pronta, in stampa con la penna nera, cambio penna in due passi con la rossa, finita, errore — e in fondo **smette di chiamare**, perché «senza SLICER» è l'unica schermata che non si prova mandando qualcosa. Dieci schermate, quattro suoni e cinque tasti in un minuto invece che in venti minuti di stampa e un foglio. **I tasti non escono dalla prova**, e non è prudenza: se «riprendi» finisse al Sender mentre si recita una stampa che non esiste, la prova in bianco sarebbe l'unica cosa del progetto capace di far partire una stampa vera.
- [2026-10-29] **Il firmware è scritto** (`schermo/telecomando/telecomando.ino`, un file solo), **non ancora caricato**. L'API non è ricordata: i sorgenti della libreria arrivano da **GitHub**, che il proxy serve anche se `downloads.arduino.cc` no — quindi la cosa che sembrava richiedere una tornata alla cieca è stata fatta sui nomi veri. Tre cose cambiate dal leggerli: **`carrier.begin()` torna `false` se un sensore qualsiasi non risponde** (al telecomando i sensori non servono: si guarda il valore e si tira dritto); il **preflight del CORS** non è una riga — prima di un POST con corpo JSON il browser manda un `OPTIONS`, e senza risposta il POST non parte nemmeno, cioè il telecomando sembra morto pur essendo acceso; **`ADC_BATTERY` esiste** sul MKR WiFi 1010 (pin 32, PB09), quindi la carica si legge con una riga e il partitore sul Grove non serve. Non potendo compilare per la scheda si è fatto il resto: `g++ -Wall -Wextra` contro intestazioni finte (zero avvisi: non prova che funzioni, prova che non ci sono refusi né nomi sbagliati) e uno script che **legge il sorgente**, ricava le parole di ogni schermata e rifà il conto della geometria col font di Adafruit_GFX. Hanno trovato tre difetti prima del caricamento, di cui uno vero: **lo stop in due tempi collassava in uno**, perché il dito che arma la domanda è ancora sul pad e il secondo tempo cominciava a contare insieme al primo. Restano da tarare sulla scheda: la **risonanza** del cicalino, il **rapporto del partitore** della batteria e **destra/sinistra** dei pad.
- [2026-10-29] **Il protocollo è completo: c'è anche la penna.** `POST /stato` porta ora `{v, stato, nome, percento, rimanente, penna, passo, macchina, azzerata, data}`; `penna` è `{colore, nome}` oppure null, e al cambio penna è **già quella nuova**. Non sta nell'impronta che decide cosa non aspetta il prossimo giro: cambia solo all'inizio di un livello, e il livello che chiede una penna diversa comincia subito dopo una pausa — cioè insieme a un cambio di `stato`, che nell'impronta c'è già e porta con sé anche il colore nuovo.
- [2026-10-31] **La prima accensione vera, e cinque cose che solo l'hardware poteva dire.** Nessuna era un errore di calcolo. (1) **I tasti erano dalla parte sbagliata**: la tabella pad → posizione era girata di **mezzo giro**, le parole da una parte del vetro e il LED acceso dall'altra. Veniva dagli schemi Altium, dove era giusta — ma i pad sono rame sulla faccia **di sotto**, e di sotto alto e basso, destra e sinistra sono il contrario. *Segnala come sbagliata la nota del 2026-10-29* («TOUCH2 in alto… il 2 resta in alto comunque»): la simmetria c'era, il mezzo giro no. I pad veri: 00 in alto a destra, 01 in basso a destra, **02 in basso**, 03 in basso a sinistra, 04 in alto a sinistra, e il vuoto è **in alto**, dove stanno i sensori. (2) **L'anello seghettato**, che questo documento e il README davano per inevitabile: si disegnava a raggi e, oltre alla scaletta, lasciava **buchi** che il commento giurava non ci fossero. Adesso va **per pixel**, col pixel di bordo acceso a metà se è mezzo dentro e mezzo fuori — si può perché il fondo è nero sia dentro sia fuori, quindi «mezzo acceso» è il colore smorzato e non c'è nessun fondo da rileggere. (3) **L'anello spezzato in basso**: non l'anello, il **rettangolo nero** che cancella il tempo che resta; gli angoli di un rettangolo stanno più in là dei suoi lati e quell'angolo cadeva dentro all'anello. Adesso quanto si cancella a una certa altezza lo decide il cerchio. (4) **I LED senza un colore definito**: le tinte del vetro sono morbide e hanno tutti e tre i canali accesi, e su un LED da una capocchia di spillo tre canali accesi fanno bianco rosato. (5) **«C'è una scritta PROVA che non capisco»**: era un tasto, ma col LED acceso dalla parte opposta e il pallino del colore sulla stessa riga diventava una didascalia.
- [2026-10-31] **`schermo/vetro/`: il firmware disegnato senza la scheda.** Compila il firmware **vero** contro un finto display che scrive in memoria e salva una immagine per schermata. Le lettere sono blocchi larghi quanto la lettera (il font di Adafruit_GFX non c'è), ma anello, spicchio e rettangoli che cancellano sono **esatti**, perché quei pixel li calcola il firmware. Ha trovato da solo tre cose che l'occhio non aveva visto: l'etichetta **TIENI sopra allo spicchio rosso** (rossa su rosso, invisibile, e per vederla bisogna tenere premuto lo stop), lo spicchio **ridisegnato intero** venti volte al secondo, e — col disegno per pixel — che un avanzamento più piccolo di un pixel d'arco non accende niente **ma spostava il confine**, cioè il conto alla rovescia dello stop non si svuotava più. Dentro ci sono anche i controlli che stavano nello scratchpad: `controlla.sh` (prototipi come li infila l'IDE, `g++` contro intestazioni finte, geometria del vetro letta dal sorgente) e `vetro.sh`.
- [2026-10-31] **La prima stampa vera: il criterio manca per un tasto.** Biglietto a due colori, telecomando acceso, stampa perfetta — e tre difetti, nessuno dei quali ha fermato la stampa. (1) **RIPRENDI dopo il cambio penna non faceva niente**, e non era il telecomando: `premuto('riprendi')` nel SLICER chiamava `Popup.telecomando('apri')`, che la finestra la **apre** — ma quando il telecomando mostra RIPRENDI la finestra è già aperta al secondo passo, è proprio da lì che sa di doverlo mostrare. Riapriva una finestra aperta. **La prova in bianco non poteva prenderlo**: lì «avanti» e «riprendi» finiscono tutti e due nello stesso posto, perché la recita deve solo avanzare — giusto per la prova, inutile come garanzia. (2) **PROVA rinominato ABBASSA / E ALZA**, su due righe, che è quello che fa; il comando sulla rete resta `prova`, perché è il protocollo. (3) **Sfarfallio premendo STOP**, «come se passasse per altre schermate»: passava davvero, perché il giro del firmware decideva la schermata **prima** di leggere i tasti e ridisegnava per intero quella della stampa prima di quella dello stop.
- [2026-11-01] **La batteria funziona, e la causa non è accertata.** Dopo la procedura di diagnosi l'utente ha riferito «ora funziona, 100%»: l'ipotesi più probabile resta la **cella scarica sotto la soglia del PMIC**, ma nessuno ha misurato la cella *prima*, quindi **non è dimostrato**. Il cavetto a 2 pin resta obbligatorio in ogni caso. *Chiude il problema aperto del 2026-10-31 senza chiuderne la causa.*
- [2026-11-01] **Il caricabatterie non si spera, si scrive.** Attaccare l'USB del MKR ricarica la cella — il caricabatterie è il BQ24195L **sul MKR**, non sul carrier — ma all'accensione tre cose lo impediscono: il core di Arduino accende la carica **solo se all'avvio vede la batteria** (e se non la vede stacca la cella), il limite di corrente in ingresso vale **100 mA** perché sul MKR i fili D+/D− non arrivano al chip, e `carrier.begin()` tocca lo stesso registro con la boost mode. Il firmware adesso scrive cinque registri in `setup()` (ingresso 500 mA, cella 512 mA, guardiano spento, timer 12 h, carica e boost insieme) e **legge lo stato ogni due secondi**, ricavando quattro parole — *a batteria*, *in carica*, *piena*, **attaccata ma non carica** — che vanno sul vetro (fulmine bianco, pila verde o ambra) e nella risposta al SLICER (campo `carica`). L'ultima parola è il guasto che da solo non si scoprirebbe mai.
- [2026-11-01] **Due cose dette dal banco, invisibili da qui.** (1) Il registro del modo, riletto **subito dopo averlo scritto**, dice `0x1B` e non `0x3B`: con l'USB attaccata **il bit della boost non resta su**. Ha senso — la boost serve a ingresso assente — ma vorrebbe dire che staccando l'USB a telecomando acceso il 5 V dei LED non si riaccende fino al riavvio. Adesso il firmware lo rimette nell'istante in cui la spina se ne va, e **l'utente l'ha verificato: staccando l'USB i LED restano accesi**. (2) A cella piena il caricabatterie alterna *in carica* e *carica finita* **due volte ogni cinque secondi**: normale fine carica, ma sul vetro le due cose si disegnano uguali e ridisegnare a ogni giro erano **due schermate al secondo** per non cambiare un pixel. Il vetro adesso guarda *come si disegna*, non *come sta*.
- [2026-11-01] **`K_PARTITORE`: da 2,00 a 1,284, e il primo tentativo era sbagliato.** Con K = 2 lo sketch stampava **6,34 V**, che per una cella sola non esiste: tanto bastava per sapere che il partitore non era da metà. Il primo calcolo (1,233) usava un tester letto **in un altro momento**, a spina staccata, e sbagliava di **quattro punti percentuali**: fra una misura e l'altra il caricabatterie alza e abbassa la cella di un decimo di volt. La misura buona — reset premuto, tester sulla cella **mentre** il monitor stampava — dà grezzo 982,37 su 1023 (3,169 V sul piedino) con la cella a **4,07 V**, cioè **K = 1,284**. Quel numero non è il partitore: è tutta la catena, resistenze **e** tensione vera del riferimento. Conseguenza buona: il fondo scala vale **4,24 V di cella**, sopra una Li-ion piena, quindi il muro che si temeva a 4,07 non c'è e `V_PIENA` resta 4,15. Secondo punto di taratura da prendere **a USB staccata**, leggendo la percentuale sul vetro: attaccare l'USB per aprire il monitor rimette la cella in carica e alza la tensione che si vuole misurare.
- [2026-11-01] **Bug: la pila ballava di diciassette punti.** *Sintomo:* a cella ferma, 73 → 67 → 57 → 65 → 67 → 74 ogni dieci secondi. *Causa:* accertata — diciassette punti sono **0,145 V**, cioè la caduta sulla resistenza interna della cella più le molle del portabatteria e i contatti del cavetto quando il WiFi trasmette o il vetro si riaccende (con burst da un paio di decimi di ampere, mezzo ohm abbondante in giro, quasi tutto nei contatti). *Fix:* la tensione non si può misurare meglio, ma **un indicatore non deve inseguire il carico**: si assaggia ogni decimo di secondo e si tiene il **picco** su due secondi (la caduta tira solo in giù, quindi il massimo è il momento in cui nessuno chiedeva corrente), si filtra pesando il passato tre volte il presente, e il numero **si muove di un punto per volta**. In più la pila si rinfresca da sola su una striscia alta diciotto pixel, perché a un punto ogni due secondi rifare la schermata intera sarebbe stato uno sfarfallio ogni due secondi. Verificato sulla macchina: «la pila è ferma e scende piano».
- [2026-11-01] **Il tasto del cambio penna dice l'AZIONE.** «ABBASSA E ALZA» diceva che cosa sa fare il tasto, non che cosa succede premendolo adesso: per saperlo bisognava **guardare la macchina**, cioè girarsi, che è quello che il telecomando serve a non fare. Adesso c'è scritto **ALZA** se la penna è al contatto e **ABBASSA** se è alzata. Dove sta il servo lo sa il SLICER e lo manda nel messaggio (`giu`), che è un **terzo stato** e non un booleano: vero, falso, oppure *non lo dice* — schiacciare `null` su `false` farebbe scrivere «ABBASSA» con sicurezza a un telecomando che non sa dov'è la penna. Tornata a una riga sola, la schermata del montaggio è tornata alle altezze delle altre.
- [2026-11-01] **Bug: la presa a muro non si faceva vedere.** *Sintomo:* alimentatore da rete attaccato, **nessun fulmine**; stesso cavo nella porta del PC, fulmine e carica; a muro premendo il reset, carica. *Causa:* accertata — nessun fulmine vuol dire `PG_STAT` giù, cioè «non vedo nessun ingresso buono», e **a batteria la boost pilota il filo VBUS**, lo stesso su cui arriva l'alimentatore. Un alimentatore da muro che regola a 5,0 V esatti non sovrasta un'uscita boost che sta cinque centesimi più su: il PMIC non vede niente di nuovo e resta in boost, dove `PG` è zero per definizione; la porta del PC è dura e lo sovrasta. **E il firmware peggiorava le cose ri-armando la boost proprio quando vedeva «a batteria»**, cioè nello stato sbagliato: si teneva su da sé. *Fix:* l'unico modo di guardare è togliersi di mezzo — la boost si molla per **ottanta millisecondi** e si rilegge `PG`. Se un alimentatore c'è, in quegli ottanta millisecondi è lui a tenere su il filo e **il 5 V non cala nemmeno**; se non c'è, resta giù un battito di ciglia e si ri-arma. Quel buio si paga solo quando non c'è niente attaccato, quindi si prova **ogni otto secondi a LED spenti e ogni minuto a LED accesi**, dove si vedrebbe — e i LED vanno **riscritti** dopo, perché sono LED intelligenti e senza il 5 V il colore se lo dimenticano. Verificato sulla macchina.
- [2026-11-01] **`VBUS_STAT` dice «sconosciuto» anche mentre carica, e di quel registro si può credere solo `PG_STAT`.** Il registro `0x08` con l'alimentatore attaccato vale `0x24`: bit 2 alto (ingresso buono, carica veloce) ma i due bit alti a `00`. È la conferma che i fili D+/D− non arrivano al caricabatterie, quindi **la trattativa non si fa mai** e il PMIC non sa che tipo di sorgente ha davanti. Fidarsi di `VBUS_STAT` avrebbe dato «a batteria» con la spina dentro.
- [2026-11-01] **I guasti del caricabatterie restano agganciati: la prima lettura è la storia, la seconda è l'adesso.** Il registro `0x09` alla prima lettura dopo l'avvio dice `0x90` (guardiano scattato **e** guasto d'ingresso), alla seconda `0x00`. Non è un guasto che va e viene: quel registro si azzera **solo leggendolo**, quindi la prima lettura riporta quello che si è accumulato da prima — il guardiano scaduto nella sessione precedente e lo sgarro dell'istante in cui si infila la spina. Scritto nel README perché, senza saperlo, `0x90` sembra un guasto vero.
- [2026-11-01] **Bug: mentre carica, la tensione non dice la carica.** *Sintomo:* spina attaccata e reset, il numero salta da **35% a 89%**; staccando la spina scivola giù di mezzo punto al secondo per due minuti. *Causa:* accertata — la corrente di carica attraversa la stessa mezz'ohm di molle e contatti **al contrario**, e invece di una caduta fa un rialzo; in più il **picco su due secondi**, che a batteria è la difesa giusta contro il carico, qui tiene il momento peggiore (il massimo del rialzo, ripple di commutazione compreso). La discesa dopo lo stacco non era un difetto: era il filtro che rientrava un punto per volta, come gli era stato chiesto. *Fix:* un offset non si filtra e non si misura meglio — **si spegne quello che lo fa**. Alla spina il firmware ferma la carica per **trecento millisecondi** ogni venti secondi, misura una cella a corrente zero e riparte; il 3V3 e il 5 V li tiene l'USB, quindi non si spegne niente. Trecento millisecondi bastano perché il pezzo che se ne va è quello resistivo, e quello se ne va subito. Alla spina `leggiCarica()` **non misura nemmeno**. Verificato: il numero parte dalla verità invece che da 89.
- [2026-11-01] **Bug (mio): la finestra rimetteva `0x3B` e fermava la carica.** *Sintomo:* dopo la **prima** finestra il vetro diceva «attaccata ma non carica», e due finestre lunghe di fila non lo smuovevano. *Causa:* accertata — la finestra rimetteva `0x3B`, **carica e boost**, copiato da `impostaCaricatore()` dove ha senso perché lì si scrive una volta sola senza sapere se la spina c'è. Alla spina no: chiedere la boost con un alimentatore attaccato vuol dire chiedere al PMIC di pilotare lo stesso filo da cui gli arriva la corrente — esattamente il litigio diagnosticato tre ore prima, riprodotto da me. *Fix:* il modo giusto lo dice **una funzione sola** (`modoGiusto()`: `0x1B` con la spina, `0x3B` senza), il registro si **rilegge e si stampa** accanto alla misura, e **`FERMA` non deve durare** — se dura, il firmware riscrive il modo (non più di una volta ogni dieci secondi) e lo **dice sul seriale**, così un guasto vero torna e si racconta invece di nascondersi. Verificato: `modo 0x1B` su tutte le finestre e lo stato resta «in carica».
- [2026-11-01] **Un controllo scritto dallo stesso ragionamento che sbaglia non protegge da niente.** Il banco finto aveva già l'asserzione giusta — «la finestra deve rimettere la carica» — ma le era stato fatto pretendere `0x3B`, cioè **confermava l'errore**. Ora pretende `0x1B`, e il bus finto tiene un vero specchio dei registri (prima rispondeva un registro solo). Le due asserzioni nuove sono state provate **mutando il firmware di proposito**, per vedere che mordessero: senza quella prova sarebbero state due righe decorative.
- [2026-11-01] **`K_PARTITORE` chiuso su due punti, e il ballo era il carico.** Finestra lunga a corrente ferma (un carattere nel monitor seriale, carica ferma cinque secondi): grezzo **893**, il firmware stampa **3,70 V**, il tester sulla cella dice **3,70 V**. Con il primo punto (982,37 → 4,07 V) fanno **K = 1,2843** e **K = 1,2844**, a 0,37 V di distanza: si accordano meglio di quanto il tester sappia risolvere. È la cosa che un punto solo non può dire — se il K **non** cambia da un capo all'altro della scala, nella catena **non c'è un offset** e un rapporto basta. Il **1,312** ricavato dal punto a batteria (47% sul vetro contro 3,78 V al tester) non era un errore di taratura: era la **caduta sotto carico**, 80 mV su mezz'ohm a 160 mA, cioè lo stesso mezz'ohm ricavato dal ballo di diciassette punti. *Supera la nota di questa stessa giornata sul secondo punto da prendere a USB staccata:* a USB staccata la cella eroga, quindi quel punto misura un'altra cosa; il punto buono si prende a **corrente zero**. E nei dieci numeri di quei cinque secondi il grezzo è stato fermo fra **893 e 894**: a corrente zero il ballo **non esiste**, quindi era il carico — dimostrato, non più dedotto.
- [2026-11-01] **La carica è dimostrata, e con una previsione che poteva sbagliare.** Prima di misurare: «fra un'ora circa 60% e circa 3,80 V; se fra un'ora sei ancora a 48%, `0x24` sta mentendo». Dopo un'ora: **59%**, cioè 3,80 V per come il firmware fa il conto. Dodici punti non li spiega il rumore (un passo di convertitore vale 4,1 mV, e tre letture che ballano di due passi sono lo stesso numero visto tre volte) né il **pelo di metodo** della finestra corta (trecento millisecondi togliono la parte resistiva ma non la cella che si rilassa, quindi le finestre corte stanno un filo sopra la tensione a vuoto). Il tester segnava **3,94 V** nello stesso momento: **non è una contraddizione**, è la finestra che fa il suo lavoro — 138 mV di differenza, cioè sedici punti percentuali, che è l'errore che si farebbe credendo a un tester letto sotto carica. E quei 138 mV sono **un amperometro travestito**: diviso per la mezz'ohm danno 280 mA, e i dodici punti in un'ora danno 325-390 mAh — due stime indipendenti della corrente di carica che si accordano, e che confermano il «~350 mA» stimato a tavolino dal datasheet.
- [2026-11-02] **Il cicalino grida a 2500 Hz, e il firmware ne usava 4000.** Quasi mezza ottava fuori: il cicalino **gridava col freno tirato da sempre**. Il numero viene da un **torneo a eliminazione** e non da una spazzata: quindici note una dietro l'altra non si classificano — a metà non si ricorda quanto era forte la terza — mentre due note che si alternano si confrontano senza memoria. Griglia a **sesti di ottava** (passi del 12%, in rapporti e non in Hz, perché l'orecchio e le risonanze lavorano così), quattordici confronti più quattro di rifinitura. **I numeri non si vedono durante il confronto** e il lato del campione si scambia ogni volta: sapere che una delle due è «quella del foglio tecnico» basta a sentirla più forte. Previsione scritta prima: 2500-3150. Il foglio tecnico del venditore dà 2731.
- [2026-11-02] **A orecchio non è un ripiego.** Un fonometro troverebbe il massimo di pressione acustica; serve invece la frequenza che un **umano** sente di più, e l'orecchio ha la sua curva di sensibilità, massima proprio fra i 3 e i 4 kHz. I due numeri sono diversi e quello buono è il secondo: non si sta misurando il cicalino, si sta accordando la **coppia cicalino + orecchio**.
- [2026-11-02] **2500 diventa la tonica, non solo una costante.** I quattro suoni sono una scala maggiore col DO su 2500 — `sol 1873 · la 2102 · si 2360 · DO 2500 · re 2806 · mi 3150 · fa 3338` —, nove semitoni in tutto, perché più ci si allontana più il suono si spegne. Scelti all'ascolto su `schermo/suoni.html`, che li suona con un'onda quadra (quello che `tone()` manda davvero) e ha due interruttori che contano più delle melodie: **attutito** (passa-basso a 1150 Hz più venti decibel in meno, cioè una porta chiusa) e **rumore dei motori**. Partenza: *la fanfara*. Cambio penna: *tre colpi*. Fine: *l'arpeggio che torna*. Problema: *la sirena*. Corretto anche un commento che prometteva che `RISONANZA` trascinasse le melodie: non l'ha mai fatto.
- [2026-11-02] **Due cose imparate scegliendo i suoni.** L'orecchio **somma l'energia** di un suono per circa due decimi di secondo: una nota da 220 ms si sente più forte di una da 70 a parità di tutto, quindi un allarme che deve arrivare da lontano vuole una testa lunga e non una raffica di colpi corti. E le note che **scendono sotto 2500** si spengono da sé: dove serve, il difetto diventa il significato.
- [2026-11-02] **Il volume esiste anche se il cicalino non ce l'ha.** Fra il piedino e la bobina c'è un MOSFET e basta: «volume» può voler dire solo **quanto dura l'impulso** dentro a ogni periodo, e quello che la membrana sente va come `sin(π·d)`. Non in proporzione — da 10 a 9 non si sente, da 2 a 1 si sente moltissimo — e per questo la scala ha **dieci tacche e non cento**. A **10** si passa da `tone()`, cioè la strada vecchia intatta; da **1 a 9** è TCC0 in PWM. Si può perché il cicalino sta su **D7 = PA21 = TCC0/WO[7]** e TCC0 qui non lo usa nessun altro (la retroilluminazione è su D3 = TCC1, `tone()` usa TC5). L'impianto lo fa il core — `analogWrite(pin, 0)` collega, accende e configura — così di nostro restano **due registri**. *Non provato sulla scheda*: provati sul banco i due numeri, periodo e parte alta, che è dove un errore cambierebbe la **nota** senza che nessuno se ne accorga ascoltando.
- [2026-11-02] **Bug: lo sfarfallio dopo lo STOP.** *Sintomo:* tenendo il dito sul tasto, prima dello stop vero si vedevano passare altre schermate. *Causa:* accertata — il telecomando manda «stop» **nella risposta** al prossimo messaggio, il SLICER lo legge e ferma, e solo col messaggio **dopo** torna lo stato nuovo: **due giri**, e in quei due giri `S.stato` vale ancora «invio», quindi si ridisegnava la schermata della stampa in corso. Tieni → stampa → pronta. *Fix:* non accelerare i messaggi — **smettere di mentire**: da quando lo stop parte a quando lo stato cambia il vetro dice **FERMO**, con una scadenza di sei secondi perché un comando perso non blocchi la schermata. Quella riga sta **sopra a tutte le altre** in `quale()`, e la prima stesura sbagliava proprio l'ordine: l'ha trovata il banco.
- [2026-11-02] **Bug: il campo dello stato era di 10 byte.** *Sintomo:* il banco si fermava con un buffer overflow aggiungendo lo stato «interrotta». *Causa:* accertata — «interrotta» vuole 11 byte, il parser tronca **in silenzio**, e poi nessun confronto torna più: lo stato nuovo non sarebbe esistito, senza un errore da nessuna parte. *Fix:* lo stato si chiama **`fermata`** (più corto, e la stessa parola che si legge sul vetro) e il campo è stato allargato lo stesso, perché il prossimo che ne aggiunge uno non ricaschi. Trovato dal banco, che compila coi controlli sui buffer accesi — sulla scheda sarebbe stato invisibile.
- [2026-11-02] **La fine di una stampa, detta quando succede.** Tre schermate nuove di significato: **«fatta»** solo quando la macchina dice `Idle` (prima voleva dire «ho consegnato l'ultima riga», e la penna stava ancora tracciando), **«fermata»** con la percentuale a cui si è interrotta e un suono suo (prima tornava a «Pronta» in silenzio, indistinguibile da una macchina che non ha mai stampato), e il **«fermo»** di passaggio. E il racconto **scade dopo tre minuti**: «fatta» e «fermata» restavano finché non partiva la stampa dopo, cioè raccontavano ieri a chi passava la mattina.
- [2026-10-31] **Problema aperto: con la 18650 non si accende niente.** Né il MKR né il LED PWR del carrier, nemmeno collegando il cavetto a 2 pin fra la scheda e il connettore batteria del MKR. Non è software: se il MKR non parte, sul carrier non si accende niente. La catena, dal rame già letto il 29: **cella → portabatteria (J8) → connettore a 2 pin (J11) → cavetto → connettore batteria del MKR → PMIC BQ24195L sul MKR → 3V3 per tutto**; il 5 V del carrier (i LED) lo genera lo stesso PMIC in boost mode, acceso da `carrier.begin()`. Due conseguenze: il cavetto **non è opzionale**, e senza cavetto la cella **non si carica** nemmeno. Ipotesi più probabile, non ancora verificata: cella **sotto i 3 V**, soglia sotto la quale il PMIC non accende la scheda a sola batteria. Da fare, in ordine: misurare la cella ai suoi poli; misurare su J11 con la cella dentro (zero lì con la cella carica = portabatteria che non fa contatto — tipico delle celle **flat-top** — o cella girata); in mancanza di tester, USB + cavetto + monitor seriale, dove il firmware stampa all'avvio il grezzo di `ADC_BATTERY`. Se è solo scarica: un'ora attaccata all'USB col cavetto collegato, poi staccare.

- [2026-11-03] **Il criterio è passato, e l'utente l'aveva già fatto prima di dirlo.** La stampa a due colori è uscita «perfettamente» senza toccare il portatile. Da registrare per chi rilegge: è stata fatta **prima** del messaggio che segnalava lo sfarfallio dello STOP e i buchi degli stati di fine stampa, quindi con il firmware di prima. Il criterio riguarda la catena, non quelle correzioni, e la catena ha tenuto.
- [2026-11-03] **Il messaggio che restava appeso, ed è la spiegazione più probabile della fine stampa che non arrivava.** Sintomo: a stampa finita il telecomando restava sulla schermata della stampa, nessun suono, nessun «FATTO», e **niente nel registro**. Due volte, e la seconda col firmware nuovo e con tutti gli altri suoni funzionanti — fanfara alla partenza, tre colpi al cambio penna — quindi non era il dialogo a non esserci mai stato: aveva smesso. Causa (non dimostrata sul campo, ma è l'unica strada trovata che produce quei sintomi in silenzio): **`fetch` non scade da solo**. Se il telecomando accetta la connessione e poi non risponde — 32 kB di memoria, un WiFi solo, uno schermo da ridisegnare — la promessa resta appesa per sempre, `inVolo` resta vero con lei, e da quel momento `manda()` e `subito()` escono subito: il battito batte a vuoto e al telecomando non arriva più niente. Il vetro resta sull'ultima schermata che aveva. E non lo dice nemmeno il registro, perché il `catch` non scatta: **una cosa rotta che non dice di esserlo**. Fix: scadenza a 2,5 s con `AbortController`, una seconda rete che sblocca un messaggio appeso da troppo, e il riprova che parte dal momento del guasto invece che dal giro già in calendario. Se ricapita, adesso il registro scrive «ha accettato la connessione e non ha risposto entro 2,5 s»: da mistero diventa prova.
- [2026-11-03] **La terza schermata del cambio penna.** Il passo nuovo della punta (Step 4) avrebbe lasciato il vetro a dire «MONTA» mentre il SLICER chiedeva l'angolo del foglio: una schermata che dice una cosa e una macchina che ne aspetta un'altra. Adesso c'è `PENNA3` — «ANGOLO / DAL PC» — e **su quella schermata non c'è nessun tasto**: ritrovare la punta vuol dire guidare la testina col tastierino e guardare dove cade, e un «FATTO» premibile senza aver mosso niente sarebbe il modo più facile di spostare il programma di venti millimetri. Quando il passo passerà sul telecomando ci vorranno le frecce. Caricato e provato dall'utente il 2026-11-03: funziona.
- [2026-11-09] **Il volume del cicalino ha piantato il telecomando per giorni, e la strada era quella «non provata sulla scheda».** Sotto il volume 10 il suono passa dal PWM di TCC0, aggiunto il 2026-11-02 e collaudato solo al banco: dentro c'erano due `while (TCC0->SYNCBUSY.reg) { }` **senza uscita**. Sulla scheda vera il timer non rispondeva, e il giro principale moriva dentro al primo suono di ogni stampa — la fanfara della partenza. Adesso l'attesa conta ventimila giri e poi molla, e si torna a `tone()`: un cicalino troppo forte è un fastidio, un telecomando che non risponde è una stampa senza telecomando. Il racconto per intero sta nella voce del 2026-11-09.

### Step 10 — Progetti da stampare: i magneti della lavagna d'allenamento

**Stato:** concluso per ora (2026-11-08) — magneti consegnati; si riapre se servono altri magneti o grafiche.

**Obiettivo:** un set di quadrati magnetici stampati, con scritti in modo bello e permanente i nomi degli esercizi, così che preparare l'allenamento del giorno si riduca ad **attaccare i magneti in ordine** sulla lavagna. Fronte **non legato alla macchina CNC**: è un uso del lavoro grafico a servizio dell'attività dell'utente (atleta di beach volley); è il fronte `(stampe)`, la terza sessione.

**Decisioni progettuali:**
- **Come si usa la lavagna** (dalla foto "Dare to Challenge"): la lavagna ha un blocco di righe, una per esercizio; a sinistra i **magneti grandi**, uno per esercizio, con il colore che dice il tipo; a destra, scritti a pennarello, i parametri. I **magneti piccoli** (etichette bianche) definiscono i parametri e sono quattro: **Intenzione, Fase, Rally, Score**.
- **Il colore è il tipo di esercizio:** **verde = competizione**, **azzurro = ripetizione a obiettivo**, **arancione = costruzione**. Il testo di ogni magnete è il **nome dell'esercizio** (esempi visti: «Forza 4», «3», «7», «Out of 8», «In a row», «7-3»).
- **Il flusso** è lo stesso dei progetti da stampare: **mockup per l'approvazione**, poi **un SVG per ciascun magnete** da mandare in stampa.
- **Dimensioni e lista esercizi non sono ancora note:** arrivano dallo staff dell'utente in un file; fino ad allora niente disegno di dettaglio.

**Criterio di completamento:** l'utente approva il mockup, riceve un SVG per ogni magnete (esercizi + parametri), li stampa e li usa sulla lavagna per un allenamento vero.

**Note (cronologia dello step):**
- [2026-10-29] Step aperto. Visto dalla foto della lavagna lo schema colori/parametri; mancano lista esercizi e misure dei magneti.
- [2026-10-29] **Primo progetto vero: il biglietto A5 per il cliente Feffi** (portaoggetti husky «Kira», da `.3mf`). Da un modello 3D a un SVG a due penne (nero + grigio) da mettere nella scatola. Provati tre stili; è stato scelto e rifinito dall'utente quello a **linee di livello**, e battezzato **«Rilievo»** (vedi `stampe/README.md`). I magneti della lavagna restano in attesa di lista esercizi e misure.
- [2026-11-01] **Secondo cliente: Antei (abbigliamento).** Due mascotte stampate in 3D dall'utente, da disegnare in stile Rilievo, più il logo dell'azienda da vettorializzare. Fatti: logo, angioletto «Starry angel kid» (dal 3MF) e seconda mascotte (da screenshot, il 3D era troppo pesante). I magneti restano in attesa.
- [2026-11-01] **Antei, set definitivo scelto dall'utente:** `logo antei cnc2d`, `starboy cnc2d (dettagliato)` e `(essenziale)`, `starry angel kid cnc2d (dettagliato)` e `(essenziale)`, in `stampe/antei/` sul branch `claude/quirky-bohr-u9ktwd`. Tenute entrambe le coppie di stile.
- [2026-11-02] **Magneti: arrivano misure e colori.** Magneti grandi **75 × 75 mm**, piccoli **75 × 25 mm**, angoli arrotondati; i piccoli attuali hanno il nome scritto a pennarello (es. «INTENZIONE»). Colori in foto: azzurro, arancione, verde e un quadrato bianco grande (a cosa serve non ancora chiarito). Le grafiche arrivano dall'utente nel messaggio successivo; poi il mockup con la sequenza delle stampe.
- [2026-11-05] **Magneti: l'utente rifà a mano i tre grandi, e da lì si ricava la regola delle scritte.** I tre file ritoccati (`stampe/magneti/finali-utente/`) sono i buoni. Il problema era nelle scritte: tracciare il **contorno** della lettera con l'indelebile da **1,5 mm** (predefinito del livello nello SLICER) fa sbordare l'inchiostro di mezzo pennarello e le lettere si impastano. Regola nuova (`stampe/magneti/testo_marker.py`): tratto **dentro** la lettera a metà larghezza di pennarello dal bordo, anelli sovrapposti ~10% solo dentro la stessa lettera, linea di mezzo per le parti sottili, spaziatura fra lettere calcolata sulla forma (≥ ~0,9 mm di vuoto). Applicata ai quattro piccoli e ai tre bianchi, da provare in stampa. Due penne: Tratto Pen (~0,5 mm) e indelebile (1,5 mm); lo spessore lo sceglie l'utente per livello nello SLICER. Il verde «Gioco» ritoccato è un disegno diverso dal mio (podio 1-2-3 con coppa).
- [2026-11-08] **Magneti chiusi, per ora** (decisione dell'utente). Condiviso il foglio con tutti i magneti rifiniti a mano nello SLICER, `stampe/magneti/finali-utente/tutti_i_magneti.svg` (232 × 313 mm, 19 livelli, penna `#1d1d1b`, spessore 1,5): è il riferimento finale. Fuori Step 10: palla da beach volley a contorni (`stampe/palla-beach-volley.svg`), biglietto Feffi, set Antei. Resta aperto solo il bianco grande rifatto dall'originale, se arriverà il file.

### Step 11 — Unire due progetti salvati: il foglio e la scelta dei livelli

**Stato:** **completato** (2026-11-08). Il **foglio** si è chiuso il 2026-11-07 con la fase 5 dello Step 12 — un progetto salvato si porta dietro i suoi fogli, e se il piano è già quello di quel progetto i livelli si appoggiano sui fogli che ci sono — e la **scelta dei livelli** il 2026-11-08: la finestrella del progetto ha l'elenco con le caselle, e di diciotto livelli se ne prendono due.

**Obiettivo:** prendere pezzi da due progetti salvati senza perdere niente per strada e senza dover ricollocare a mano — né i disegni, né l'attenzione.

**Decisioni progettuali:**
- **Aggiungendo, chi c'era prima è il padrone di casa** (2026-11-06). Del file arrivato si prendono *solo* i livelli: foglio, angolo e scala restano quelli in uso. L'alternativa — adottare il foglio del file — sposterebbe i livelli di chi c'era già, perché cambiare misura del foglio li ricentra tutti.
- **Il prezzo di quella decisione si paga dicendolo** (2026-11-06). I rettangoli di collocazione sono millimetri **su quel foglio**: se le due misure non combaciano, i livelli arrivati restano alle coordinate in cui stavano e possono cascare fuori. Per ora si avvisa in due posti — nella finestrella prima di scegliere, e nel registro fra gli avvisi dopo — e non si fa altro. Rimandato dall'utente: «per ora non mi interessa se perdo il foglio».
- **Un foglio girato NON è lo stesso foglio**, qui. È il contrario della regola di `chiaveFoglio` in `profile.js`, dove un A5 per il lungo è sempre un A5: là si parla della **risma**, qui si parla di **dove casca un disegno**, e 148 × 210 non è 210 × 148 per un rettangolo di collocazione.

**Che cosa manca** (le due cose rimandate):

| Cosa | Perché serve |
|---|---|
| ~~**Il foglio diverso**~~ | **Fatto il 2026-11-07** (fase 5 dello Step 12). Non si è scelto fra «ricollocare» e «adottare il foglio»: le due strade erano i due modi di spartirsi un unico foglio, e l'unico foglio non c'è più. |
| ~~**La scelta dei livelli**~~ | **Fatta il 2026-11-08.** L'elenco con le caselle nella finestrella del progetto, e con i livelli arrivano **solo i fogli che servono a loro**: due livelli su diciotto portano due magneti, non nove. |

**Criterio di completamento:** l'utente apre due progetti salvati su fogli di misura diversa, prende da ciascuno solo i livelli che gli servono, e **non deve ricollocare niente a mano** prima di stampare. *Soddisfatto nel programma il 2026-11-08; da confermare all'uso.*

**Note (cronologia dello step):**
- [2026-11-06] Step aperto, e aperto perché una parte è già fatta: l'avviso a tre vie è nello Step 4. Qui restano il foglio e la scelta dei livelli, rimandati dall'utente nello stesso messaggio in cui ha chiesto l'avviso.
- [2026-11-07] **Il foglio passa allo Step 12, e non per spostare un problema altrove.** L'utente ha chiesto di andare verso più fogli sul piano, e quella direzione *scioglie* questo pezzo invece di rattopparlo: non c'è più un unico foglio per cui litigare. Qui resta la scelta dei livelli — l'elenco con le caselle per prenderne due su otto — che nel frattempo è diventata meno urgente, perché un livello caricato sul foglio sbagliato adesso si trascina su quello giusto (Step 4).
- [2026-11-08] **La scelta dei livelli, e lo step si chiude.** La finestrella del progetto ha l'elenco con le caselle: tutti presi di partenza, «Tutti» e «Nessuno», il conto («3 su 18 presi») e i due pulsanti che dicono su quanti lavorano e si spengono se non ne resta nessuno. Con i livelli arrivano **solo i fogli che servono a loro**, con la geometria relativa che avevano nel file: il posto del foglio saltato non si richiude. Quelli lasciati restano nel file, e il registro lo dice.
- [2026-11-07] **Il foglio è chiuso** (fase 5 dello Step 12). Un progetto salvato scrive i suoi fogli nel file e ogni livello dice su quale sta. Riaprendolo: se il piano di oggi è **lo stesso piano** (tanti fogli quanti, delle stesse misure, nello stesso ordine) i livelli si appoggiano sui fogli che ci sono — che è il caso raccontato il 6 novembre, due file sullo stesso formato e le parti da mettere sulla stessa carta; se no, il progetto **porta i suoi fogli** e nessuno si sposta. L'avviso «quel progetto era su un foglio di un'altra misura, controlla dove sono finiti i livelli» è stato cancellato: non c'è più niente da controllare.

### Step 12 — Più fogli sul piano

**Stato:** **completato** (2026-11-08). Nel programma erano fatte tutte e cinque le fasi dal 2026-11-07; la prova vera l'ha fatta l'utente sulla macchina il 2026-11-08: «il disegno con più magneti l'ho già fatto, tutto corretto». Vedi la nota di quel giorno per che cosa quella frase copre e che cosa no.

**Obiettivo:** mettere sul piano più fogli, anche di misure diverse, lavorarci sopra come su uno solo e stamparli **in una volta**, senza che il numero dei fogli si trasformi in un numero uguale di misure da fare e di cambi penna da aspettare.

**Il numero che decide tutto:** la corsa percorribile è **241,23 × 236,06 mm**. Non è il piano di legno (355 × 400 raggiungibili dentro una tavola 700 × 600): è dove la punta arriva, e tutto quello che si stampa insieme deve starci dentro. Cosa ci sta: **nove magneti 75 × 75** in una griglia 3 × 3 con cinque millimetri di gioco (in altezza per un millimetro); **due A6** affiancati; **un A5** e basta — due non ci stanno, 296 > 241. Il caso vero sono quindi i magneti e i formati piccoli, non due A5.

**Decisioni progettuali:**
- **Un foglio è un SISTEMA DI RIFERIMENTO**, non un rettangolo da disegnare. I livelli hanno il loro posto in coordinate *del foglio*; `State.data.fogli` è un elenco, e `paper`/`sheetOrigin`/`foglioMisurato` sono diventate **viste sul foglio attivo** invece che campi. È il motivo per cui la fase 1 non si vede: nessuno degli altri otto file è cambiato.
- **Le misure non traboccano da un foglio all'altro.** Un angolo misurato sul foglio 1 non dice niente del foglio 2. È il difetto peggiore che questa roba potesse avere, perché non si vedrebbe sullo schermo — si vedrebbe sulla carta.
- **L'accostamento si legge dalla geometria**, non da un interruttore (chiesto dall'utente: «il programma lo deve capire quando creo il file nella tab Disegno»). Due fogli i cui bordi si toccano entro **un millimetro** e che si affacciano per almeno **dieci** sono accostati, e il secondo ricava l'angolo dal vicino. Si guarda **solo indietro nell'elenco**, e non è un'ottimizzazione: è quello che impedisce i giri chiusi, e rende vera la regola «il primo foglio di un gruppo accostato è quello che si misura».
- **I magneti non sono una comodità.** Un foglio appoggiato a occhio e sbagliato di mezzo millimetro *non* è accostato: chiederà la sua misura e chi l'ha posato non capirà perché. I magneti sono quello che rende il gesto affidabile. La loro tolleranza si misura in **pixel e non in millimetri** — da ingranditi un millimetro è mezzo schermo — e Alt li spegne, come nell'editor.
- **La misura muove tutta la famiglia.** I fogli accostati sono spinti uno contro l'altro: la loro geometria relativa è un fatto, e la misura dice dove sta il *gruppo*. Spostare solo quello misurato sfascerebbe il gruppo nel momento in cui lo si ancora alla realtà. Da lì si bloccano tutti.
- **L'altezza di contatto resta UNA**, con la spunta «i fogli sono di carte diverse» per il caso contrario. Nove quadrati dallo stesso cartoncino hanno lo stesso spessore, e misurarla nove volte sarebbe otto gesti per sapere otto volte lo stesso numero. La spunta sta nella colonna e non nel popup: si sa prima di premere Stampa che carte si hanno in mano, e il contatore dei passi deve dire la verità dalla prima schermata.
- **L'ordine di stampa lo sceglie l'utente ogni volta**, con «per penna» proposto di partenza (scelta sua). Per penna, l'ordine delle penne è quello in cui compaiono nell'elenco: non si inventa un ordine «migliore», perché l'ordine dei livelli decide anche che cosa finisce sopra a che cosa.
- **Con l'ottimizzazione «tutto» il raggruppamento per penna non si può fare**, e si dice invece di farlo male: lì un gruppo è un foglio intero con le sue penne mescolate, e «la penna di questo gruppo» non esiste.
- **Il controllo dell'ingombro guarda un foglio per volta** durante la procedura, e tutti alla fine. Lamentarsi di un foglio non ancora misurato sarebbe un allarme su una posizione che è ancora un'ipotesi.
- **Nel file i fogli si salvano, gli AGGANCI no** (fase 5). Chi è accostato a chi *discende* da dove stanno i fogli: un aggancio scritto in un file potrebbe descrivere un giro chiuso che nessuna geometria regge, e `radiceDi` lo dice già in un commento. Il file dice dove sono i fogli; l'accostamento si rilegge da lì. Per lo stesso motivo non si salvano le misure di una stampa — `z`, `cartaSua`, `misurato` — che sono misure della macchina di oggi, non del lavoro.
- **Il livello salva il NUMERO del suo foglio, non l'id.** Gli id (`fog3`) li conta un contatore che riparte da uno a ogni ricarica: due file salvati in due giorni chiamerebbero `fog1` due fogli che non c'entrano niente. Un indice è una posizione in un elenco che sta nello stesso file, e non può voler dire altro.
- **Il file resta un SVG che si apre anche altrove**, quindi il disegno dentro passa in coordinate **macchina** (riquadro = tutti i fogli). Nove magneti devono uscire come nove disegni in nove posti, non nove volte sovrapposti nell'angolo. Con un foglio solo il file è **identico** a quello di prima: è l'invariante che protegge i file già salvati, ed è un controllo del banco.
- **Il formato è il 2, e scrive anche le due chiavi del formato 1** (`foglio` e `angolo`, del primo foglio). Costa due chiavi e salva un file aperto su un computer non aggiornato.
- **Un piano con più fogli è lavoro da perdere anche senza un livello sopra.** Nove magneti posati uno contro l'altro, magari con l'angolo già misurato, sono mezz'ora: dal 2026-11-07 aprire un progetto con più di un foglio sul piano fa chiedere, come lo faceva un livello.

**Quanto costa, in fermate:** nove magneti con due penne vogliono **17 cambi penna** stampati foglio per foglio e **1** stampati per penna. Non sono secondi di macchina — lo spostamento in più è penna alzata a 3000 mm/min — sono sedici volte che una persona deve alzarsi.

**Le fasi.** Erano cinque nel piano iniziale; la 4 (il telecomando) è
diventata la **3d** perché si è rivelata l'ultimo anello della catena di
stampa e non un lavoro a parte — il numero del foglio nasce nel generatore e
arriva al vetro senza mai uscire da quella catena. Il numero 5 è rimasto
quello che era.

| fase | cosa | stato |
|---|---|---|
| 1 | il modello: `fogli[]` e le viste | fatta (2026-11-07) |
| 2 | il piano, i magneti, i livelli su un foglio | fatta (2026-11-07) |
| 3a | ordine fra i fogli, marcatori `;FOGLIO`, elenco diviso | fatta (2026-11-07) |
| 3b | i popup: un angolo per foglio, la spunta delle carte | fatta (2026-11-07) |
| 3c | la tab «In stampa» col piano intero | fatta (2026-11-07) |
| 3d | il telecomando: «FOGLIO 3/9» | fatta (2026-11-07) |
| 5 | il progetto salvato: `fogli[]` nel `.cnc2d.svg` | fatta (2026-11-07) |

**Criterio di completamento:** l'utente mette nove magneti sul piano, li accosta, fa **tre schermate** di inizio stampa invece di ventisette, stampa tutto con **un** cambio penna, e il telecomando gli dice a che magnete è arrivato. Poi salva il lavoro, lo riapre un altro giorno e ritrova i nove fogli dov'erano.

**Note (cronologia dello step):**
- [2026-11-07] **Fase 1, il modello.** `paper`, `sheetOrigin` e `foglioMisurato` diventano viste sul foglio attivo: con un foglio solo il comportamento è identico, e il criterio della fase era esattamente quello — tutti i banchi che c'erano passano ancora, senza che nessuno li abbia toccati.
- [2026-11-07] **Fase 2, il piano e i magneti.** I nove magneti si posano da soli in una griglia 3 × 3 esatta (`0,0 75,0 0,75 150,0 75,75 0,150 150,75 75,150 150,150`) con **un solo angolo da misurare**.
- [2026-11-07] **Fase 3, la stampa.** L'ordine per penna, il marcatore `;FOGLIO n/N` gemello di `;PENNA`, i popup per foglio, la tab «In stampa» col piano intero, il telecomando.
- [2026-11-07] **Sul vetro del telecomando il posto non era libero**, e si è scoperto misurando: fra la percentuale e il tempo che manca passa l'etichetta del tasto STOP (fascia 152-162, a destra di x=154). Per questo, quando il foglio si scrive, il pallino della penna e la percentuale **salgono di quattordici pixel**. Con un foglio solo la schermata resta quella di prima.
- [2026-11-07] **Fase 5, il progetto salvato.** `fogli[]` nel `.cnc2d.svg` e il numero del foglio su ogni livello. Riaprendo: se il piano di oggi è **lo stesso piano** del file i livelli si appoggiano sui fogli che ci sono, se no il progetto **porta i suoi**. Chiusa la metà «foglio» dello Step 11.
- [2026-11-07] **Un A4 non ci sta nella corsa, e il banco l'ha fatto notare.** 297 > 236: un progetto su A4 non può essere posato «dove c'è posto», e la prima versione reagiva mettendogli i fogli sopra a quelli che c'erano. Adesso un gruppo che non ci sta va **di fianco** a tutto, fuori dalla corsa, e mai sopra: due disegni sulla stessa carta non si vedono, un foglio che sporge sì — e l'elenco dei fogli lo dice già. «Più grande della corsa» e «non c'è più posto libero» si dicono con due frasi diverse, perché la prima non è un errore (con un A4 si stampa un pezzo per volta).
- [2026-11-08] **Stampato sulla macchina, e va.** Detto dall'utente: «il disegno con più magneti l'ho già fatto, tutto corretto». È il criterio di completamento, e con quella frase lo step si chiude. **Che cosa copre quella frase e che cosa no:** copre la stampa su più fogli in una volta — le schermate di inizio stampa, i cambi penna, il telecomando — perché è quello che si attraversa stampando. Non ho chiesto il dettaglio punto per punto e non lo invento: la metà «salva, riapri un altro giorno e ritrova i nove fogli» resta verificata **nel programma** (2026-11-07: nove fogli, un angolo da misurare, programma identico di 327 righe) e non da una seconda giornata di macchina. Se un giorno riaprendo un progetto i fogli non tornassero, è lì che va guardato. **E un dubbio in più, venuto fuori la sera stessa riconciliando la Pipeline:** il criterio dice anche «il telecomando gli dice a che magnete è arrivato», ma il «FOGLIO 3/9» sul vetro è arrivato col firmware del 2026-11-07 e **l'ultimo caricamento confermato sul MKR è del 2026-11-03** — l'utente dice che sulla scheda c'è ancora una versione vecchia (Step 13). Se non l'ha ricaricato, quella riga del criterio non può essere passata: è da chiedergli, e nel frattempo resta scritta qui invece che data per buona. **Chiesto e risposto il 2026-11-09: non l'aveva caricato.** Quindi quella riga del criterio non era passata sulla macchina. **Lo stesso giorno l'ha caricato**, e dopo tre giri di correzioni la stampa a due fogli è andata in porto col telecomando acceso: il criterio è completo, e il numero del foglio adesso sta in una **targhetta nell'angolo in alto a destra** — non più una riga in mezzo, per il motivo scritto nella voce del 2026-11-09.

### Step 13 — Il telecomando, seconda tornata: la SD, i dispositivi, l'alimentazione

**Stato:** in corso — cinque lavori elencati dall'utente il 2026-11-08, **due fatti il 2026-11-09**: il quinto (il tasto che chiude il racconto) e il terzo (il firmware ricaricato sul MKR, che l'utente ha caricato e provato lo stesso giorno). **Ne restano tre:** la SD e il multi-dispositivo, le interfacce per i vari dispositivi, l'interruttore. Nessuno è stato cominciato, e **nessuno era nella Pipeline**: tre vivevano solo in `schermo/README.md`, due solo nella testa dell'utente. Lo Step 9 resta completato, perché il suo criterio — una stampa a due colori chiusa senza toccare il portatile — è passato il 2026-11-03: questo è il giro dopo.

**Obiettivo:** che il telecomando smetta di essere solo un vetro che racconta e diventi anche **il posto da cui il lavoro parte** (la pagina, i disegni, i progetti), che si accenda e si spenga come un oggetto, e che il firmware sulla scheda sia quello del repository.

**I cinque lavori**, nell'ordine in cui l'utente li ha detti:

1. **La micro SD e il multi-dispositivo.** Il piano è già scritto in `schermo/README.md` («La SD rimette in gioco il SLICER servito dalla macchina») e vale la pena ricordarne la ragione: il 26 ottobre la pagina è stata tolta dall'ESP32 perché **non ci stava** (64 kB liberi contro 583 della pagina, 172 compressa), e con lei si è perso *un indirizzo solo, sempre aggiornato, che qualunque dispositivo apre*. La SD lo rimette senza toccare la macchina: il MKR fa già da server HTTP, `cnc2d-telecomando.local/` serve `cnc2d-ui.html.gz` con `Content-Encoding: gzip`. Tre passi in ordine di valore: **la pagina**, poi **una cartella di disegni** (gli SVG elencati dalla pagina), poi **i progetti salvati** (`.cnc2d.svg` scritti sulla scheda, che chiede un endpoint di caricamento).
2. **Le interfacce per i vari dispositivi. Spezzato in due il 2026-11-14, e la prima metà è cominciata.** Era scritto che andava fatto **dopo** il punto 1 «perché prima non c'è niente da aprire da un telefono»: il vincolo vale per la pagina SERVITA dalla scheda, non per l'adattamento in sé, che non ha bisogno di niente e al banco si prova con un tablet emulato — tocco vero, non eventi finti. Quindi: **(a) l'adattamento al dito**, lavorabile subito e cominciato il 2026-11-14 con la pinzata e i bersagli (vedi la nota di quel giorno nello Step 4); **(b) la prova sui dispositivi dell'utente e la pagina servita dalla scheda**, che aspettano il 23 novembre e il punto 1. Resta vero il resto: è lavoro sul SLICER (Step 4), non sul firmware. Era già dichiarato nel README — *«multi-dispositivo vuol dire ACCESSO, non ancora interfaccia»* — e la frase «da un telefono si apre ma non si usa» va corretta: il layout si riorganizza già da solo (1100 px e 760 px, più le container query delle colonne) e i gesti sono scritti con i pointer event, quindi trascinare funziona già col dito. Quello che manca è l'elenco nella nota del 2026-11-14.
3. **Il firmware da ricaricare sul MKR.** Sulla scheda c'è una versione vecchia. L'ultimo caricamento **confermato** nel documento è del 2026-11-03 (la terza schermata del cambio penna, `PENNA3`); dopo quella data il firmware nel repository è cambiato almeno una volta, il 2026-11-07, con la fase 3d dello Step 12 — **«FOGLIO 3/9» sul vetro**. Vedi la nota del 2026-11-08 nello Step 12: se quel caricamento non c'è stato, quella parte del criterio non può essere passata.
4. **L'alimentazione: un modo per spegnerlo e riaccenderlo, e come si ricarica.** Da decidere se serve un modulo di ricarica a parte: il caricabatterie **c'è già e sta sul MKR** (BQ24195L), attaccando l'USB la 18650 si ricarica, e dal 2026-11-01 i registri si scrivono nel modo giusto (`modoGiusto()`: `0x1B` con la spina, `0x3B` senza). Quindi il lavoro vero è **l'interruttore** — oggi il telecomando non si spegne — e la domanda da chiudere è se un modulo esterno aggiunga qualcosa a quello che il MKR fa già, o se sia solo una seconda strada per la stessa corrente.
5. **Un tasto che chiude il racconto.** Oggi, finita o annullata una stampa, le schermate `FINE` e `FERMATA` restano per **tre minuti** (`RACCONTO_MS = 180000`) e poi tornano da sole alla schermata Pronta. L'utente vuole poterle **chiudere con un tasto** invece di aspettare. È la modifica più piccola delle cinque, e va fatta insieme al punto 3 perché richiede comunque un caricamento.

**Decisioni progettuali:**
- **La SD non diventa mai l'unica strada.** Il telecomando è a batteria e dorme: se la pagina vivesse solo lì, con la pila scarica non si stamperebbe più. Il file locale resta, la SD è una strada in più.
- **Servire un file non è comandare la macchina.** Il telecomando consegna dei byte; una volta caricata, la pagina parla con FluidNC dal browser come ha sempre fatto. Nessun secondo padrone — la regola dello Step 9 non si rompe.
- **La SD divide la SPI con il display**, quindi si scrive ai cambi di stato e mai durante il tocco lungo dello stop, che è l'unico momento in cui un fotogramma perso si vede.

**Criterio di completamento:** l'utente apre il SLICER **da un indirizzo solo** (il telecomando) su un dispositivo che non è il portatile, con una pagina che su quello schermo si usa davvero; il MKR porta il firmware del repository; il telecomando si spegne e si riaccende con un interruttore; e una schermata di fine stampa si chiude con un tasto.

**Note (cronologia dello step):**
- [2026-11-08] Step aperto, elencato dall'utente. I tre lavori della SD erano già progettati in `schermo/README.md` dal 2026-10-28 ma non erano mai entrati nella Pipeline: è il tipo di lavoro che si perde, perché sta scritto in un posto che si legge solo quando si lavora lì.
- [2026-11-09] **Lavori 3 e 5 fatti, e provati sulla macchina.** Il firmware è stato caricato dall'utente e una stampa a due fogli è andata in porto **a batteria**: «tutto ha funzionato correttamente». Con quel caricamento sono arrivate sulla scheda anche tutte le correzioni di mezzo — vedi la voce di storico del 2026-11-09, perché fra il caricamento e la stampa buona ci sono stati due guasti e tre difetti trovati.
- [2026-11-12] **La copia del profilo sulla SD smette di essere un «uso minore».** Domanda dell'utente: aprendo il SLICER dall'iPad o dall'iPhone, cosa manca di quello che sta solo sul PC? La risposta divide in due. **Quello che non manca mai:** origine, altezza di contatto e angolo del foglio sono chiesti dai popup **a ogni stampa, su ogni dispositivo**, perché dipendono da dove hai appoggiato il foglio oggi e per questo non stanno nel profilo (`popup.js`). **Quello che manca:** tutto il profilo macchina, che vive in `localStorage` ed è **per dispositivo e per browser** — corse in passi, margine, ostacolo, angoli del servo (cioè **quanto si alza la penna**), gioco, zero della tavola, velocità — più penne, spessori, segnalibri, indirizzo e volume del telecomando. Un dispositivo nuovo non parte da zero: parte dai **valori di fabbrica compilati nella pagina**, che sono le misure vere al momento del build. Il rischio quindi non è il vuoto, è lo **scostamento silenzioso** fra quella fotografia e quello che l'utente ha cambiato dopo sul PC. Da qui: la copia del profilo sulla scheda diventa **l'ossatura del multi-dispositivo**, non un contorno, e va fatta col lavoro 1. **Regola proposta: il PC resta il padrone**, la scheda ne tiene la copia, gli altri dispositivi la **leggono** e non la scrivono se non quando l'utente lo chiede — una sincronizzazione a due vie fra tre dispositivi è una gara a chi salva per ultimo.
- [2026-11-12] **Il passo 3 del lavoro 1 (i progetti salvati sulla scheda) ha un consumatore preciso**, chiesto dall'utente: il menù «disegni recenti» e il salvataggio automatico, descritti nella nota del 2026-11-12 dello Step 4. Cambia la priorità interna del lavoro 1 — l'endpoint di caricamento non serve più solo a «salvare dalla macchina», serve a far esistere il menù su tutti i dispositivi — ma **non** l'ordine dei tre passi. E la data: la scheda da **32 GB** l'utente l'ha (è il massimo che il lettore accetta), ma fino al **23 novembre** non è a casa con scheda, telecomando, PC e macchina, quindi il lavoro 1 non può cominciare prima. Da verificare allora che la scheda sia formattata **FAT32** e non exFAT, che la libreria non legge: il sintomo sarebbe «la scheda non c'è», non «la scheda è sbagliata».
- [2026-11-09] **Lavoro 5 fatto: il tasto che chiude il racconto.** `FINE` e `FERMATA` hanno un tasto in alto a sinistra che riporta alla schermata Pronta; i tre minuti restano, e sono per chi passa domani. Consegnato all'utente il file da caricare, che porta anche il **lavoro 3** — il firmware sulla scheda è fermo al 2026-11-03, quindi con lo stesso caricamento arrivano il «FOGLIO 3/9» della fase 3d e tutto quello di mezzo. **L'utente ha confermato che non l'aveva ancora caricato:** il dubbio aperto nello Step 12 è quindi sciolto nel verso previsto — durante la stampa dei nove magneti il vetro il numero del foglio NON l'ha detto, perché quel firmware non c'era.

### Step 14 — I riempimenti: riconoscere le forme chiuse e riempirle

**Stato:** **in corso** — dal 2026-11-14 **si riempie davvero**: il motore (`webui/js/riempi.js`) e la porta dell'utente (pulsante «Riempi» nella tab Editor, finestrella dei parametri col tempo, anteprima sotto il puntatore, clic che disegna, sottolivello con la ricetta). Mancano il **ricalcolo al rilascio** quando il contorno cambia, la **porta all'ingrosso** dal livello pieno, e gli altri tipi di tratteggio. Aperto il 2026-11-09, cominciato il 2026-11-14 dalle parti piu' leggere: **la mira del doppio clic e' corretta** (due difetti, non uno) e **la spunta dice quando la scelta ricomincia**, prima del clic e dopo. Con queste il difetto segnalato l'11 novembre e' chiuso per intero. Restano **i riempimenti veri** e il controllo **«si vedra'»** con la soglia 1,8x. Aperto il 2026-11-09 su richiesta dell'utente. **Non è un'idea nuova:** sta in `webui/README.md` sotto «Cosa manca» da quando quel file esiste («Riempimento a tratteggio delle forme piene»), ed è il seguito dichiarato della decisione scritta lì accanto — «**Le forme piene diventano contorni.** Una penna non riempie. Il riempimento a tratteggio si potrà aggiungere più avanti». È la prima volta che entra nella Pipeline.

**Obiettivo:** che un livello «pieno» si possa stampare **pieno**, con un tipo di riempimento scelto, e non solo come contorno vuoto.

**Prima metà: riconoscere le forme chiuse.** Un pezzo c'è già e non va rifatto:
ogni sotto-tracciato porta il suo `chiuso`, preso dal comando `Z` del file
(`svgpath.js`), l'ottimizzatore lo usa già per cominciare un contorno chiuso da
dove gli conviene, e l'importatore distingue già la **tinta di bordo** dalla
**tinta di riempimento** (`svgimport.js`, `piena: true`), mettendo le piene in
un livello spento ma recuperabile. Quello che manca:

- la forma chiusa **di fatto ma non col `Z`**: primo e ultimo nodo coincidenti entro tolleranza, caso frequentissimo nei file esportati;
- i **buchi**. Un SVG li fa con `fill-rule` (`evenodd` o `nonzero`), e oggi quella proprietà **non è letta in nessun punto del codice**: una ciambella verrebbe riempita tutta, tappo compreso. *Scritto la mattina come «il primo vero lavoro di questo step», e **declassato la sera stessa**:* col riempimento che parte dal click (vedi le decisioni) i buchi vengono giusti **senza che `fill-rule` venga mai letto**, perché il riempimento non può attraversare l'inchiostro. `fill-rule` resta necessario solo sulla strada all'ingrosso, quella dei livelli pieni importati;
- le forme che **si auto-intersecano**, dove «dentro» non è una domanda con una risposta sola;
- i tracciati **disegnati nell'editor**, che chiusi non nascono: va deciso se li chiude l'utente con un gesto o se li chiudiamo noi quando i capi si toccano.

**Seconda metà: i tipi di riempimento.** Ognuno è un generatore che prende un
poligono con i suoi buchi e restituisce tratti, che poi passano
dall'ottimizzatore già esistente — salda i contigui e riordina. In ordine di
valore:

1. **Tratteggio** a un angolo e un passo: il caso base, e la base di tutti gli altri.
2. **Serpentina**: lo stesso tratteggio, ma unito ai capi — un tratto solo invece di N. Non è un vezzo: ogni alzata di penna costa circa mezzo secondo, e la regola dell'ottimizzazione in questo progetto è **il tempo, non la distanza**. Su una forma grande è la differenza fra un minuto e dieci.
3. **Tratteggio incrociato**, due passate a un angolo fra loro, per coprire di più senza stringere il passo.
4. **Contorni concentrici** (offset verso l'interno): seguono la forma invece di tagliarla, ed è la resa che somiglia al disegno a mano.
5. **Spirale**, pulita sulle forme convesse e problematica sulle altre.
6. **Punti (stippling)** e **scarabocchio**: resa artistica più che copertura, da fare per ultime.

**Decisioni progettuali** — **prese il 2026-11-09**, discusse con l'utente prima di scrivere una riga di codice: il disegno dell'interazione è suo, il resto è stato concordato («sono d'accordo con tutto»). Si costruisce quando lo dirà lui.

- **Il riempimento si comanda dalla tab edit, con un pulsante suo** che apre una finestrella con i parametri e il tipo. Poi **il mouse anticipa il riempimento** della regione sotto il puntatore e **il click lo disegna**. È il disegno dell'utente, e supera la prima idea di questo step (un interruttore «riempi» sul livello): *il click dice la cosa che la geometria non può sapere — **quale** degli spazi chiusi si intende*. Sulla A in grassetto il corpo si riempie coi buchi già giusti, e il triangolo è una regione come le altre: un secondo click.
- **Lo stampino.** All'apertura della finestrella tutti i tratti **visibili** del foglio si disegnano su una tela fuori schermo a **un decimo di millimetro per pixel**, con gli spessori veri delle penne, e **tutte le regioni si etichettano una volta sola**. Così il passaggio del mouse non calcola niente: legge l'etichetta sotto il puntatore, e il tratteggio di una regione si calcola una volta e si tiene. Il **bordo del foglio fa da argine**; **griglia e magneti no**, altrimenti si riempirebbero i quadretti.
- **Un decimo di millimetro basta, e l'errore va nascosto sotto l'inchiostro.** Sono tre passi di motore e un quarto di punta di penna; e i capi del tratteggio **devono comunque infilarsi sotto il contorno** di un paio di decimi, altrimenti fra riempimento e bordo resta una riga bianca. Quindi l'imprecisione dello stampino finisce dove non si vede, per costruzione.
- **La fessura è il modo in cui questa cosa si rompe**, e si difende due volte: una **tolleranza di chiusura** nella finestrella (i tratti si ingrassano di N decimi *solo* nello stampino, così i buchi fino a quella misura si tappano), e un **guardiano** — se la regione tocca il bordo del foglio o ne supera una fetta, il riempimento **non si disegna**: si dice che il contorno ha una fessura e si mostra **dove è scappato**. Un guasto che si annuncia, invece di un foglio allagato.
- **Nella finestrella ci va anche il tempo.** Un A4 tratteggiato a 0,4 mm sono circa **150 metri di penna**: oltre un'ora, più le alzate. Metri e minuti scritti **prima** del click costano niente e togliono la brutta sorpresa — ed è anche l'argomento che mette la serpentina subito dopo il tratteggio.
- **Due porte, un motore solo.** Il click serve a comporre; un logo importato con quaranta forme piene sarebbero quaranta click, quindi resta anche la strada all'ingrosso («riempi questo livello pieno» dall'elenco dei livelli). Le due porte usano **gli stessi generatori di tratteggio**, e `fill-rule` serve solo alla seconda.
- **Il passo del tratteggio non è un numero libero: nasce dallo spessore del tratto della penna**, che il livello porta già dal 2026-11-03. Passo uguale allo spessore = copertura piena; passo maggiore = trama che si vede. Quindi il comando naturale all'utente è una **copertura** (o un passo in multipli del tratto), non millimetri staccati dalla penna che è montata davvero. Si lega al controllo «si vedrà?» offerto nello Step 4: un tratteggio più fine del tratto della penna non è un tratteggio, è una macchia.
- **Il riempimento non sostituisce il contorno.** Una forma piena *con* bordo li vuole entrambi, e sono due interruttori, non uno.
- **Il riempimento si deve vedere in anteprima**, altrimenti l'utente lo scopre a penna in mano. Ma il tratteggio vero di una forma grande sono centinaia di segmenti: va deciso se l'anteprima li disegna tutti o ne mostra un campione.
- Il generatore lavora **a valle dell'appiattimento**, su polilinee e non su curve: è lì che vive già tutto il resto della catena.

**Le due domande, chiuse il 2026-11-10 dall'utente:**

1. **Il riempimento ha un livello suo.** Confermato: così porta la sua penna — il pennarello grosso per il pieno, la punta fine per il bordo — e si spegne o si butta da solo.
2. **Il livello del riempimento è un SOTTOLIVELLO del disegno che riempie.** È la proposta dell'utente, accolta. Risolve più cose di quelle per cui è stata proposta, e però **non** risolve da sé quella per cui è stata proposta: la distinzione va tenuta chiara, perché è lì che si sbaglia.
   - **Quello che la parentela dà.** Dice senza ambiguità *quale* disegno quel riempimento riempie — cosa che il click, da solo, non registra da nessuna parte. Il riempimento si sposta, si spegne e si butta col padre, e un contorno cancellato non lascia un riempimento orfano a mezz'aria sul foglio. L'elenco dei livelli lo mostra rientrato sotto al suo, invece di una riga di cui non si capisce l'appartenenza. E il gruppo **si ordina da sé in stampa**: prima il figlio, poi il padre, perché il contorno disegnato per ultimo copre le sbavature del tratteggio che gli si infila sotto.
   - **Quello che la parentela NON dà**, ed è proprio seguire una *modifica* del contorno. Spostare e ruotare sono trasformazioni: lì i segmenti del riempimento si muovono rigidamente col padre e non si ricalcola niente. Ma se si trascina un nodo e il triangolo della A cambia forma, il tratteggio **va rigenerato** — non esiste trasformazione che lo faccia. Lo stesso per la scala, anche uniforme: raddoppiando la lettera il passo raddoppia e la copertura si dimezza, quindi la scala ricalcola. Quello che fa seguire il riempimento è **la ricetta tenuta nel figlio** (tipo, angolo, passo, punto cliccato, tolleranza di chiusura) più l'avviso che arriva dal padre quando cambia. La parentela è il posto dove la ricetta abita e il filo che dice *quando* rifarla; la ricetta è il come.
   - **Quando si rifà: al rilascio, mai durante il trascinamento.** Mentre si modifica, il riempimento vecchio resta visibile sbiadito e la riga nell'elenco si segna **da rifare**; si rigenera quando il gesto finisce, perché costa un decimo di secondo. E **un riempimento segnato da rifare non si stampa**: o si rigenera prima, o lo si dice all'utente. Un foglio stampato da una ricetta vecchia è il genere di bugia che si scopre a penna in mano.
   - **Se ricalcolando perde** — un nodo trascinato ha aperto il contorno — vale il guardiano già deciso: si **tiene l'ultimo riempimento buono**, si segna la riga e si dice dove è scappato. Non si allaga il foglio e non si butta il lavoro fatto.
   - **Il confine può non essere di un solo livello.** Dopo l'importazione per tinte, una regione può essere chiusa da tratti di due o tre livelli diversi. Il padre allora è **uno solo** — il livello attivo nell'editor al momento del click — ma la ricetta tiene anche l'**elenco dei livelli che hanno fatto da confine**: se cambia uno qualsiasi di quelli, il figlio è da rifare. Questa è una scelta mia, non dell'utente, e si può ribaltare.
   - **Un riempimento non è padre di niente:** un livello solo di profondità, altrimenti si finisce a discutere di alberi invece di disegnare.

**Criterio di completamento:** due prove, una per porta. (1) Dalla tab edit: una **A in grassetto** si riempie nel corpo e, con un secondo click, anche nel triangolo; il mouse mostrava prima del click quello che poi è uscito dalla penna. (2) All'ingrosso: una forma piena importata da un SVG — **compreso un disegno con buchi** — esce riempita sulla carta col tipo scelto dall'elenco dei livelli. In entrambi i casi il tempo di stampa è un numero che l'utente ha letto **prima** di premere, e un contorno con una fessura non allaga il foglio: lo dice.

**Note (cronologia dello step):**
- [2026-11-09] Step aperto su richiesta dell'utente, con due metà dette da lui: «riconoscimento forme chiuse e riempimenti di diversi tipi». Nessuna riga di codice scritta. Lo stato di partenza è quello scritto qui sopra: `chiuso` c'è, le tinte piene ci sono come livelli spenti, lo spessore della penna in millimetri c'è, `fill-rule` **non** c'è.
- [2026-11-09] **Disegno deciso in conversazione, prima di costruire** — come chiesto dall'utente: «prima di costruirlo decidiamo, lo implementiamo la settimana prossima», e poi «sono d'accordo con tutto, teniamo tutto in pipeline per quando te lo farò fare». L'interazione (pulsante nella tab edit, finestrella dei parametri, anteprima sotto il mouse, click che disegna, regioni lette dai tratti che ci sono) è sua; lo stampino, la tolleranza di chiusura, il guardiano della fessura, il tempo nella finestrella e le due porte sono il come. **Lo step resta «da fare» e non si comincia finché non lo dice lui.**
- [2026-11-10] **Chiuse le due domande aperte**, e con la seconda è arrivata la proposta dell'utente: i riempimenti nascono come **sottolivelli** del disegno che riempiono. Accolta, con la precisazione scritta qui sopra — la parentela dà l'appartenenza, l'ordine di stampa e la cancellazione in blocco; a far seguire una modifica del contorno è la ricetta, e il ricalcolo si fa al rilascio del gesto. Sempre zero righe di codice: «teniamo tutto in pipeline per quando te lo farò fare».

- [2026-11-13] **Il tratteggio esiste già dall'altra parte, e i due devono dire la stessa cosa.** Lo strumento delle stampe ha un campo «Riempimento a tratteggio (mm, 0 = no)» e `fedele.py` l'opzione `riempimento=mm`: quando questo step si costruisce, il **passo** deve voler dire la stessa cosa nei due posti, altrimenti lo stesso disegno riempito di qua e di là esce diverso. Detto in positivo: il generatore del tratteggio dello SLICER nasce con un riferimento già stampato su carta da confrontare, e con la soglia 1,8× di `controlla.py` per dire quando il passo è troppo stretto.

- [2026-11-14] **La mira del doppio clic: corretti DUE difetti, non uno.** Era il punto piu' leggero dei quattro, e sotto il sintomo «ogni tanto non prendo la forma» c'erano due cose indipendenti che si sommavano. **(1) La mira guardava nel foglio sbagliato** — `quale()` adesso prende millimetri del PIANO e sottrae l'angolo di ciascun livello, invece di ricevere un punto già misurato dall'angolo del foglio in uso. **(2) Su un foglio libero il doppio clic non arrivava affatto:** il primo clic rende quel foglio quello in uso, i fogli si ridisegnano, il rettangolo premuto non esiste più quando arriva il secondo e il browser il `dblclick` non lo manda — la stessa ragione per cui esiste `Nome.doppio`, e la stessa cura: i due clic si contano a mano, con un guardiano perché il gesto non venga servito due volte e giri al livello di sotto. Era questa la metà che si sentiva ogni giorno, perché un foglio è libero per tutta la composizione: cliccando esattamente su un tratto il bersaglio è il tracciato e il gesto passava, cliccando nel bianco dentro al disegno il bersaglio era il foglio e non passava. **Tolto anche un `preventDefault()`** che spegneva gli eventi del mouse, ma da solo non bastava — provato. Tre scene nuove in `prova-piano.js` e tre mutazioni in `rompi.py` (235 in tutto).

- [2026-11-14] **La spunta dei livelli adesso dice quando la scelta ricomincia.** Seconda meta' di quello che l'operatore aveva segnalato l'11 novembre, e qui non c'era un difetto da correggere ma **una regola muta da far parlare**: spuntare un livello di un altro foglio fa ricominciare la scelta invece di sommarla, perche' due livelli di due fogli diversi non hanno un rettangolo in comune — vero, deciso il 2026-11-07, e resta. Si vede da due parti: **prima** del clic il quadratino di quel livello ha il filo tratteggiato e un suggerimento che lo scrive, e il segno compare **solo** quando c'e' davvero una scelta da far ricominciare (senza niente scelto non ricomincia niente); **dopo**, il registro dice quale livello, su che foglio e perche'. Due controlli e tre mutazioni (238 in tutto): il vestito che manca, il vestito su tutte le spunte, e la scelta che ricomincia in silenzio. **Non fatto, e di proposito:** allargare il bersaglio della spunta (18 x 18 px, col nome a 33 px che invece sostituisce la scelta). Il reclamo era sulla regola muta, non sulla mira del dito; se dara' fastidio si allarga, ma cambiare l'altezza delle righe con dodici livelli in elenco e' un costo che adesso non serve.

- [2026-11-14] **Il motore dei riempimenti, e non tocca niente.** `webui/js/riempi.js`: dagli si dei tratti, restituisce regioni e segmenti. Non sa dell'interfaccia e non tocca lo stato — per questo al banco si prova con forme inventate a mano (un quadrato, una ciambella, un contorno con una fessura) invece che con un file, cioè sapendo esattamente che cosa deve venire fuori. **Lo stampino** disegna i tratti visibili del foglio su una tela fuori schermo a 0,1 mm/px con gli spessori veri, etichetta **tutte** le regioni in una passata (pila esplicita, non ricorsione: su un A4 una regione è mezzo milione di celle) e da lì «che regione c'è sotto il puntatore» è una **lettura**, non un calcolo — è ciò che permette l'anteprima sotto il mouse. **Il tratteggio** taglia righe parallele sulla regione, con angolo e passo; la **serpentina** le unisce ai capi **solo dove il collegamento resta dentro la regione** (unire alla cieca vuol dire attraversare il buco della ciambella con la penna giù: è il difetto che sembra un tratteggio finché non lo guardi da vicino). I **capi si infilano sotto il contorno** di 0,2 mm. **Il guardiano**: una regione che tocca il bordo del foglio non si riempie, e si dice **dove** è scappata. **Tre cose imparate costruendo:** (a) una fessura da mezzo millimetro **non** fa scappare niente — il tratto è largo 0,4 coi capi tondi, quindi ne restano aperti 0,1, un pixel che l'antialiasing chiude: il «quasi chiuso» dei file esportati si tappa gratis, e la tolleranza serve per le fessure vere; (b) un quadrato di 20 a passo 1 costa **372 mm** e non 400, perché il contorno si mangia il suo spessore e le righe sono diciannove — un controllo che pretendesse 400 non avrebbe capito la forma; (c) la scena del banco ha il buco **fuori centro** apposta: una ciambella simmetrica sta uguale anche ribaltata, e il ribaltamento della y è l'errore più facile qui dentro (sul foglio la y cresce in su, sulla tela in giù). Banco nuovo `webui/tools/prova-riempimenti.js`, 14 controlli; **sette mutazioni** (264 → 271) tutte viste. **Manca l'interfaccia:** pulsante nella tab edit, finestrella dei parametri col tempo di stampa, anteprima sotto il mouse, click che disegna, sottolivello con la ricetta e ricalcolo al rilascio.

- [2026-11-14] **La porta dell'utente: si riempie col clic, e il riempimento è un sottolivello.** Fatta l'interazione che l'utente aveva disegnato il 9 novembre, pezzo per pezzo: **pulsante «Riempi»** nella barra dell'editor, **finestrella** coi parametri che resta aperta mentre si mira (tipo, passo, angolo, tolleranza di chiusura), **il puntatore che anticipa** la regione sotto di sé, **il clic che disegna**. Nella finestrella ci sono **metri, alzate e minuti prima del clic** — un A4 a quattro decimi è più di un'ora, e saperlo dopo è una brutta sorpresa — e la riga che dice che cosa vuol dire quel passo **per la penna montata**: sotto lo spessore del tratto non è un tratteggio più fine, è una macchia (è il controllo «si vedrà?» nella sua forma più utile, quella che si legge mentre si sceglie). **Il riempimento nasce come sottolivello**, con la ricetta dentro, **prima** del padre nell'elenco — l'elenco è l'ordine di stampa e il contorno deve passare per ultimo, perché i capi del tratteggio gli si infilano sotto —, eredita la penna ma la può cambiare, e **se ne va col padre**. La scelta resta sul disegno: ritrovarsi dentro al riempimento appena fatto vorrebbe dire continuare a disegnare nel posto sbagliato. **Si lavora nelle unità del file** e non in millimetri, perché sono quelle in cui vivono le forme dell'editor e in cui deve nascere il figlio: si convertono i tre numeri che l'utente scrive, non tutta la geometria. **Tre buchi del banco trovati rompendo**, e tutti e tre erano scene cieche, non codice sbagliato: (a) il disegno riempiva il foglio, quindi un figlio adattato al foglio per conto suo stava **nello stesso posto** di uno posato sulla mappa del padre — la scena adesso mette il disegno in un angolo; (b) si cliccava **oltre** l'argine, dove non c'è nessuna regione, quindi il ramo «è scappata» non veniva mai percorso — adesso si clicca dentro l'argine e fuori dalla forma, e il controllo pretende anche **che il programma lo dica**; (c) una mutazione lasciava il file sintatticamente rotto, cioè non simulava un difetto, impediva alla pagina di esistere. Il banco sale a **25 controlli**, le mutazioni a **280** (nove nuove), tutte viste.

### Step 15 — Pulizia su GitHub: cosa c'è, cosa resta, cosa va via

**Stato:** da fare — **da cominciare quando gli altri lavori sono chiusi**, per decisione dell'utente il 2026-11-09. Si segna adesso perché è il tipo di lavoro che non si ricorda da sé, e perché farlo prima della fine vorrebbe dire buttare via roba che serve ancora.

**Obiettivo:** avere chiaro, file per file, che cosa contiene il repository, e che di ogni file si sappia dire una delle tre cose: **serve** (e a che cosa), **è storia** (non serve più ma racconta come ci siamo arrivati, quindi resta), **è superato** (va via). A fine step il repository non ha file che nessuno sa spiegare.

**Come si farà:** una **scansione completa** — oggi sono 192 file censiti, divisi in `webui/` (63), `stampe/` (30), `gcode/` (30), `schermo/` (22), `firmware/` (21), `misure/` (7), `content/` (7), `logo/` (5), `modulo-penna/` (3) e 4 in radice — con una proposta per ciascuno, e **la decisione la prende l'utente**: io porto l'elenco diviso nei tre gruppi, con il perché di ogni riga, e non cancello niente prima della sua risposta.

I sospetti, da verificare quando si arriva allo step e non prima:
- i **G-code generati** in `gcode/`, che sono il prodotto di una stampa già fatta e si rigenerano dal SLICER in un secondo;
- il **disegno di collaudo**, che non è più un sospetto ma una cosa decisa: **superato il 2026-11-12** per decisione dell'utente, perché le undici prove sono state fatte in itinere con le stampe vere. Da decidere se `misure/disegno-di-collaudo.md` e `webui/tools/test-macchina.js` vanno via o restano come descrizione di come si leggono quelle misure — oggi portano in cima il riquadro che dice che sono superati, e due file li citano ancora (`misure/cad-assieme.md` la prova 2, `webui/tools/cornice.js` la prova 11); altri **disegni di collaudo** eventualmente sostituiti da versioni più nuove;
- gli **sketch e le configurazioni di passaggio** del firmware, dove una prova di bring-up può essere stata soppiantata da quella definitiva;
- i **README di cartella** che si sono disallineati dal codice che descrivono — qui il lavoro non è cancellare, è correggere;
- i **banchi di prova** in `webui/tools/`, che invece **non** sono candidati: un collaudo vecchio è una rete di sicurezza, non un residuo. **Attenzione a non confondere:** `test-macchina.js` sta nella stessa cartella ma non è un banco — non controlla il codice, genera un disegno da misurare a mano — e quello è superato.

**Decisioni progettuali:**
- **Togliere un file da GitHub non è perderlo.** La storia resta: un file cancellato si rilegge con `git show <commit>:<percorso>`, come già accaduto alle tre varianti del logo del 27 ottobre (`git show 5c50952`). Quindi «va via» significa *sparisce dalla cartella di lavoro*, e il costo dell'errore è basso — ma per questo la cancellazione va **sempre accompagnata dal commit che la contiene**, citato nel documento, altrimenti nessuno sa dove ripescarla.
- **Non si cancella per fare ordine estetico.** Un file si toglie se è *superato* (c'è qualcosa che fa la stessa cosa meglio) o se è *rigenerabile in un gesto*. Un file brutto ma unico resta.
- **Il peso non è il motivo.** Il repository sta in 350 kB compressi: non c'è nessun problema di spazio da risolvere. Il motivo è uno solo — **poter aprire una cartella e capirla**.

**Criterio di completamento:** l'utente scorre l'elenco e per ogni riga sa dire se tiene o toglie; le righe da togliere sono tolte in uno o pochi commit che le elencano; e in radice c'è una mappa breve delle cartelle, così che la domanda «cosa c'è qui dentro?» non richieda un'altra scansione fra un mese.

**Note (cronologia dello step):**
- [2026-11-09] Step aperto su richiesta dell'utente, da fare **per ultimo**: «lo faremo quando avremo finito, intanto segnatela». Nessuna scansione fatta: a questo punto c'è solo il censimento grossolano per cartella scritto qui sopra.
- [2026-11-09] **Era lo Step 14, rinumerato a 15** nella stessa giornata quando è arrivato il lavoro sui riempimenti: la pulizia deve restare l'ultima della fila, e il numero lo dice senza doverlo spiegare.

### Step 17 — Disegnare a mano libera con la Apple Pencil

**Stato:** **da discutere** — idea dell'utente del 2026-11-14, detta a fine giornata: «un tasto che dato attivo dà la possibilità alla penna di creare un tracciato». Nessuna riga di codice, e nessun disegno deciso: «ne parleremo poi». Sta in pipeline perché le idee dette a voce si perdono, non perché sia cominciata.

**Obiettivo (come si capisce oggi):** una **terza porta** per far nascere un disegno, accanto all'importazione di un SVG e agli strumenti dell'editor — la mano, su un iPad, con la Apple Pencil.

**Quello che si sa già, e che non va riscoperto quando si comincerà:**
- L'editor è già scritto con i **pointer event**, e una Apple Pencil arriva come `pointerType: 'pen'`, distinguibile da un dito. Il riconoscimento «è la penna o è la mano appoggiata» quindi non è da inventare: è da usare.
- L'evento porta anche **pressione e inclinazione**. Da decidere se servono: su un plotter a penna la pressione non si può rendere con lo spessore (la punta è una sola), ma potrebbe scegliere la penna o il tipo di riempimento.
- Il tracciato a mano nasce come una **sequenza fittissima di punti**: va ridotto (semplificazione) e probabilmente addolcito in curve, se no un segno di dieci centimetri diventa mille micro-segmenti che l'ottimizzatore deve digerire e la macchina percorrere a scatti.
- Il **tasto** che l'utente chiede è la cosa giusta: senza un modo esplicito di entrare in «la penna disegna», ogni appoggio della mano diventa un tratto.

**Criterio di completamento:** da definire con l'utente.

**Note (cronologia dello step):**
- [2026-11-14] Idea detta dall'utente subito dopo aver dato il via ai riempimenti, e **rimandata da lui stesso**: «ne parleremo poi». Registrata e basta.

### Step 16 — Metodo di lavoro delle stampe: scheda, catalogo, controllo

**Stato:** in corso — struttura costruita e collaudata (2026-11-09); manca la skill.

**Obiettivo:** che un nuovo lavoro di stampa parta da specifiche precise e si chiuda senza giri a vuoto: l'utente dice ingresso, stile, dettaglio, foglio, penne e testi, e il risultato esce già controllato.

**Decisioni progettuali:**
- **Catalogo con nomi fissi:** **Rilievo** (da modello 3D o screenshot), **Onde** e **Poligoni** (da foto), **Linea** (da icona/logo, quello dei magneti), più **Tratti** tenuto solo come nome, sconsigliato per la macchina. Dettaglio sempre su tre livelli: essenziale, medio, dettagliato.
- **Modulo, non testo libero:** a ogni lavoro faccio io le domande a scelta (ingresso, stile, dettaglio, foglio) e poi quelle libere (penne, testi, da non fare, vista, ritaglio). Scelta dell'utente.
- **Un punto d'ingresso, motori invariati:** `stampe/lavoro.py` legge la scheda JSON e chiama i motori già esistenti; i file non sono stati spostati, per non rompere gli import.
- **Controllo prima di consegnare** (`stampe/controlla.py`): ingombro nel foglio e nel margine, sollevamenti di penna, tratti sovrapposti (>1,8×), tratti più corti di 0,15 mm; legge anche i file dello SLICER con lo spessore vero dei livelli.
- **Testi sotto il disegno:** se la scheda ha dei testi, il disegno si ferma 4 mm sopra la scritta più alta.
- **Skill:** si fa quando tutto è definito (decisione dell'utente).

**Criterio di completamento:** l'utente conferma il modulo e il catalogo su un lavoro vero fatto con la scheda, e la skill lo richiama.

**Note (cronologia dello step):**
- [2026-11-09] Costruiti `lavoro.py`, `controlla.py`, `linea.py` (lo stile Linea come script a sé), `testo.js`, `penne.json`, `catalogo.py` (pagina `stampe/catalogo/index.html` con le anteprime dei file veri) e il README riscritto. `rilievo.py` accetta il passo come `L<n>` (n livelli) e il margine da ambiente.
- [2026-11-13] **Catalogo rivisto dall'utente: sette stili.** Il biglietto Feffi diventa uno stile a sé, **Layer** (linee parallele, fette alla stessa quota, da 3D), mentre **Rilievo** resta quello di starry angel e starboy (linee organiche, distanza dall'osservatore). Nuovo **Fedele** (da illustrazioni/logo, non da foto: contorno di ogni campitura, esempio il logo Antei; `fedele.py`, opzioni `colori=N` e `riempimento=mm`). Per i file d'ingresso il tipo `icona` diventa `illustrazione`. Le anteprime del catalogo si aprono in grande con zoom; gli esempi nuovi stanno in `stampe/catalogo/esempi/` con la loro scheda.
- [2026-11-13] **Lo strumento a pagina** (richiesta dell'utente: dropbox, pulsanti per lo stile, slider per il dettaglio, riquadro per le richieste, pulsante Genera). `stampe/strumento/`: una pagina e un piccolo server locale (solo libreria standard) che lancia `lavoro.py`. Con il motore genera e mostra anteprima, report e download; senza motore diventa «Prepara scheda» per mandarla a Claude. Include l'anteprima del modello 3D da sei angoli, cliccabile per scegliere la vista. Collaudato con un browser sui tre percorsi (foto, 3D con angolo, senza motore). La skill resta da fare.
- [2026-11-13] **Icone «i» e scala del dettaglio estendibile** (richieste dell'utente). Accanto a ogni stile e al dettaglio un'icona «i» mostra, al passaggio del mouse, le anteprime degli esempi; gli esempi stanno ora in `stampe/catalogo/esempi.json` (stile + livello) e si aggiungono col pulsante «Aggiungi agli esempi» dello strumento o con `catalogo.py --aggiungi`. Lo slider ha la scala base a tre scatti e due spunte che la estendono: a sinistra *minimo* e *molto essenziale*, a destra *molto dettagliato* e *massimo*; i motori (`lavoro.py`, `fedele.py`, `da_immagine.py`) gestiscono i sette livelli. Il controllo segnala quando il livello più alto è troppo fitto (Layer massimo: 3,3× di sovrapposizione).
- [2026-11-13] **Pacchetto dello strumento consegnato** all'utente: `strumento-stampe.zip` (8,8 MB, con `LEGGIMI.txt`) più `strumento/index.html` da solo. Il motore dipende da due file fuori da `stampe/`: `webui/js/font-tratto.js` e `webui/tools/figli-sagome.py`; vanno inclusi in ogni pacchetto. Se sul PC dell'utente non c'è Python resta la modalità «Prepara scheda».
- [2026-11-13] **Il fronte SLICER ha letto questo lavoro e detto cosa integrare** (vedi le due note del 2026-11-13 nello Step 4): i motori restano qui, mentre controlli, penne, catalogo-come-cartella e provenienza passano di là. **Due disallineamenti trovati leggendo, da risolvere nella pulizia dello Step 15:** il codice delle stampe sta sul branch `claude/quirky-bohr-u9ktwd` mentre il documento sta su `claude/elegant-knuth-0396no`, dove `stampe/` contiene **solo** i 30 file di `.lavoro/` — immagini di lavorazione e un intero progetto 3MF, cioè residui — quindi il documento descrive settanta file che su quel branch non esistono; e va deciso se `stampe/` vive su un branch solo o su entrambi.

## Storico sessioni

### [2026-11-14 15:02] I riempimenti: il clic disegna

**Riepilogo:** fatta la porta dell'utente sopra al motore della mattina — pulsante, finestrella coi parametri e col tempo, anteprima sotto il puntatore, clic che disegna — e il riempimento nasce come **sottolivello** del disegno che riempie, posato esattamente sopra di lui.

**Cosa è stato fatto:**
- **`Artwork.riempimento(padre, polilinee, ricetta)`**: crea il figlio con `nuovo(nome, padre)`, che eredita la **stessa mappa** del padre (box e bb), così `rigenera()` lo posa dove il padre lo vedeva. Poi lo sposta **prima** del padre nell'elenco, perché l'elenco è l'ordine di stampa.
- Il padre si porta via i figli quando lo si butta, e l'occhio del padre spegne anche loro.
- **Editor**: modalità riempimento, con l'aiuto in fondo che in quella modalità parla solo di lei — dodici gesti che in quel momento non fanno niente, descritti come se funzionassero, sono peggio di nessun aiuto.
- La finestrella dice **metri, alzate e minuti** prima del clic, e che cosa vuol dire il passo scelto per la penna montata.
- Banco a **25 controlli**, mutazioni a **280**.

**Decisioni prese:**
- Contesto: il riempimento deve stare *sopra* al disegno che riempie, e un livello nuovo normalmente si adatta al foglio per conto suo.
- Decisione: **il figlio eredita la mappa del padre**, riusando la strada già provata di `nuovo(nome, modello)` invece di calcolare una collocazione a parte.
- Alternative scartate: mettere i tratti del riempimento **dentro** al livello del disegno — più semplice, ma perde la penna propria, lo spegni-e-accendi separato e la ricetta.
- Da rivedere se: servirà che un riempimento sopravviva al padre. Oggi non serve, ed è anzi la cosa che si vuole evitare.

**File consegnati/modificati:** `webui/js/riempi.js`, `webui/js/artwork.js`, `webui/js/editor.js`, `webui/index.html`, `webui/css/components.css`, `webui/tools/prova-riempimenti.js`, `webui/tools/rompi.py`, `documento-sessione-cnc-2d.md`.

**Impatto su Vision/Pipeline:** Step 14 — lo stato passa a «si riempie davvero»; restano il ricalcolo al rilascio, la porta all'ingrosso e gli altri tipi di tratteggio.

---

### [2026-11-14 10:52] La pinzata: il piano e la tela si guardano col dito

**Riepilogo:** anticipato l'adattamento ai dispositivi prima dei riempimenti (decisione dell'utente, e la ragione regge: il gesto del tocco è un ingresso del disegno dei riempimenti), e fatta la prima parte — la pinzata in un modulo solo per il piano e per la tela dell'editor, e i bersagli da dito.

**Cosa è stato fatto:**
- **Guardato prima com'era messa la pagina**, invece di fidarsi della frase «da un telefono si apre ma non si usa» dell'8 novembre: il layout si riorganizza già (1100 e 760 px, più le container query), i gesti sono già sui pointer event — trascinare funziona già col dito — e l'unico uso del trascinamento HTML5 è la zona di rilascio dei file, che col dito si sostituisce col selettore.
- **`webui/js/tocco.js`**, nuovo: la pinzata e il conto delle dita. Non sa che cosa sta guardando — chi chiama gli dice come si legge la finestra, come si scrive e dove cade un punto dello schermo — quindi ce n'è **uno solo** per il piano (y in su) e per la tela (y in giù).
- Il piano e la tela lo usano; lo **spostamento dello sguardo** e il **trascinamento del foglio** si fanno da parte quando arriva il secondo dito, se no si ingrandisce e si trascina insieme.
- **Bersagli a 40 px** sotto `pointer: coarse`, e il passaggio del mouse che col dito diventa `:active`.
- Banco nuovo `webui/tools/prova-tocco.js` (12 controlli) col **tocco emulato davvero** (CDP `Input.dispatchTouchEvent`), e **dieci mutazioni** in `rompi.py` (246 → 256), tutte viste.

**Bug: la pinzata ancorava mezzo passo dopo**

**Sintomo:** pinzando, il punto fra le due dita scappava di **10,5 px** — il disegno scivola mentre lo si guarda. Il rapporto di ingrandimento usciva 0,525 invece di 0,500.
**Causa:** gli eventi del tocco arrivano **un dito alla volta**, anche quando le dita si posano insieme. Fondando la pinzata al primo `pointermove`, la distanza e il punto medio di riferimento sono fatti di un dito già partito e di uno ancora fermo: mezzo passo fuori posto, che ingrandendo di tre volte diventa dieci pixel. (Il primo sospetto — l'accumulo dei passi — era **sbagliato**: riscritto il conto in forma assoluta, lo scarto è rimasto identico, ed è quello che ha indicato la causa vera.)
**Fix applicato:** la pinzata si fonda sull'appoggio del **secondo dito**, dove le due posizioni sono esatte. Rapporto 0,500 e scarto **0,0 px**, su entrambi i controlli d'ancoraggio. Il conto assoluto si tiene comunque: andata e ritorno riportano il disegno esattamente dov'era, ed è un controllo a sé.

**Seconda parte, dopo la prova dell'utente sull'iPad.** Ha provato e ha confermato: pinzata, bersagli e doppio tocco funzionano. **Una limitazione trovata usando:** *«il tasto Shift per non deformare il disegno»*. Tenere le proporzioni trascinando un angolo del riquadro era affidato **solo a Shift**, e su un tablet quel tasto non c'è: dall'iPad il disegno si poteva soltanto schiacciare. Adesso c'è una **spunta** accanto ai campi del livello e **Shift la capovolge** — chi ha la tastiera non perde niente (il predefinito resta «deforma», come prima), chi ha il dito non resta fuori, e una scelta che viveva solo in un tasto diventa visibile anche sul PC. **E una cosa che il banco ha trovato da sé:** col dito la maniglia d'angolo **da 9 px non si prende**. L'utente c'era riuscito, ma è una mira che non deve servire: adesso sotto ogni maniglia c'è una **presa trasparente da 30 px**, e il quadratino visibile resta di nove — ingrandire il segno coprirebbe il disegno proprio mentre lo si sta ridimensionando. Quattro mutazioni in più (256 → 260), e il banco sale a 15 controlli.

**Terza parte: gli ultimi due comandi che vivevano solo in un tasto.** Domanda dell'utente — «Ctrl si usa solo in edit?» — e la risposta, verificata invece che ricordata, ha rimpicciolito il lavoro: **nella tab Disegno Ctrl non si usa mai** (le cinque occorrenze stanno tutte in `editor.js`), e nell'editor Ctrl+Z, Y, X, C, V **hanno già i loro pulsanti**. I «quindici punti» di cui avevo parlato erano righe di codice, non gesti: i gesti senza strada sul tablet erano **due**. **(1) I magneti fra i fogli** (tab Disegno): sospenderli era solo Alt tenuto premuto, quindi dall'iPad due fogli non accostati non si potevano posare. Adesso una spunta sotto l'elenco dei fogli, accesa di serie, e **Alt la capovolge**. **(2) Sommare un tratto alla scelta** (editor): era solo Ctrl. Adesso l'interruttore **«Somma»** nella barra, e **Ctrl lo capovolge**. Restano senza strada sul tablet solo cose che ce l'hanno altrove: lo scatto della rotazione si libera con Shift ma l'angolo esatto si scrive nel campo «Rotazione», e il tasto centrale ha il dito sul fondo. Il tasto destro non fa niente, serve solo a non far comparire il menù del browser. **Un buco del banco chiuso per strada:** nessun collaudo, qui dentro, aveva **mai premuto Ctrl** — adesso la metà «il tasto capovolge» ha due controlli suoi, uno per Alt e uno per Ctrl. Banco a **21 controlli**, mutazioni da 260 a **264**, tutte viste.

**Decisioni prese:**
- Contesto: l'adattamento era in pipeline **dopo** la SD, «perché prima non c'è niente da aprire da un telefono».
- Decisione: **spezzarlo in due** e anticipare la prima metà. L'adattamento al dito non ha bisogno della scheda e al banco si prova con un tablet emulato; aspetta il 23 solo la prova sui dispositivi veri e la pagina servita dalla scheda.
- Alternative scartate: decidere il gesto del tocco **dopo** i riempimenti — l'anteprima sotto il mouse non ha equivalente sul touch, e si rifarebbe.
- Da rivedere se: la prova sui dispositivi veri dice che 40 px non bastano. Quaranta e non quarantaquattro è un **compromesso dichiarato**: sulla riga di un livello ce ne stanno quattro accanto al nome.

**File consegnati/modificati:** `webui/js/tocco.js` (nuovo), `webui/js/paper.js`, `webui/js/editor.js`, `webui/css/components.css`, `webui/index.html`, `webui/tools/prova-tocco.js` (nuovo), `webui/tools/rompi.py`, `webui/js/versione.js`, `documento-sessione-cnc-2d.md`.

**Impatto su Vision/Pipeline:** Step 13 — il lavoro 2 è spezzato in (a) adattamento al dito, lavorabile subito e cominciato, e (b) prova sui dispositivi e pagina sulla scheda, dal 23 novembre; corretta la frase «da un telefono si apre ma non si usa», che non era più vera per intero. Step 4 — aggiunta la nota del 2026-11-14.

---

### [2026-11-14 10:23] L'avviso dei numeri di fabbrica

**Riepilogo:** la pagina adesso sa dire se i numeri della macchina sono quelli di questo dispositivo o quelli compilati nel file, e lo dice in tre posti — fascia all'apertura, verifica delle impostazioni, riga nei popup di inizio stampa — con una frase sola scritta in un posto solo; è la prima metà dell'avviso proposto il 2026-11-12, la seconda aspetta la SD.

**Cosa è stato fatto:**
- `Profile` distingue i due casi con un dato solo: se in `localStorage` c'era un profilo di questo dispositivo. Un `reset()` conta come profilo suo (i valori sono quelli di fabbrica, ma metterli lì è stato un gesto di chi sta davanti alla macchina); un profilo illeggibile no, e l'avviso si accende — è il caso giusto, quei valori non sono più quelli che il dispositivo aveva scelto; e `save()` cambia stato **solo se la scrittura è andata**, perché dire «salvato» a chi in una finestra anonima non ha salvato niente è esattamente l'avviso che si sta cercando di dare.
- `MISURE_DI_FABBRICA` dice di quando sono i numeri del file (2026-10-24, l'ultima misura entrata nei valori di partenza: lo zero della tavola), con scritto accanto che chi cambia un valore di partenza cambia anche la data — una data falsa è peggio di nessuna data, perché sembra una garanzia.
- **Tre interfacce, una frase.** `provenienza()` sta in `profile.js` e la mostrano la fascia, la verifica e i popup.
- La **fascia** (`index.html`, `app.js`, `components.css`): sotto le tab, gialla, col pulsante «Apri le impostazioni» — che cambia tab **premendo la tab vera**, non con una seconda copia della logica — e una × che non si ricorda.
- La **voce nella verifica**, come avviso e non blocco.
- La **riga nei popup di inizio stampa** (`popup.js`), gialla quando i numeri sono di fabbrica. Nel cambio penna non c'è: quel popup si apre a stampa avviata, cioè dopo che la riga è stata letta tre volte.
- Banco nuovo `webui/tools/prova-profilo.js` (19 controlli) e **otto mutazioni** in `rompi.py`, da 238 a 246: tutte **viste**. Il collaudo intero passa su tutti i quattordici banchi.

**Decisioni prese:**
- Contesto: un avviso può bloccare o solo dire.
- Decisione: **solo dire**, mai bloccare. Da un dispositivo di fabbrica si stampa: i tre popup di inizio stampa chiedono comunque origine, altezza di contatto e angolo del foglio, che sono le misure pericolose.
- Alternative scartate: farne un blocco — renderebbe impossibile stampare dall'iPad, che è esattamente il caso d'uso da cui la domanda è nata; e ricordare la × in memoria, che spegnerebbe l'avviso per sempre il primo giorno.
- Da rivedere se: arriva la SD. Allora il confronto col profilo della scheda diventa possibile e il pulsante della fascia può diventare *prendi il profilo dalla macchina* invece dell'importazione da file.

**File consegnati/modificati:** `webui/js/profile.js`, `webui/js/app.js`, `webui/js/popup.js`, `webui/index.html`, `webui/css/components.css`, `webui/tools/prova-profilo.js` (nuovo), `webui/tools/rompi.py`, `webui/js/versione.js` (contatore della pagina), `documento-sessione-cnc-2d.md`.

**Impatto su Vision/Pipeline:** Step 4 — aggiunta la nota del 2026-11-14; la proposta del 2026-11-12 resta aperta per il solo pezzo che dipende dalla scheda (il confronto campo per campo col profilo sulla SD).

---
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
