giandcdalcorso11-coder/GDC-CNC-2D/stampe/.lavoro/ang-dett.png

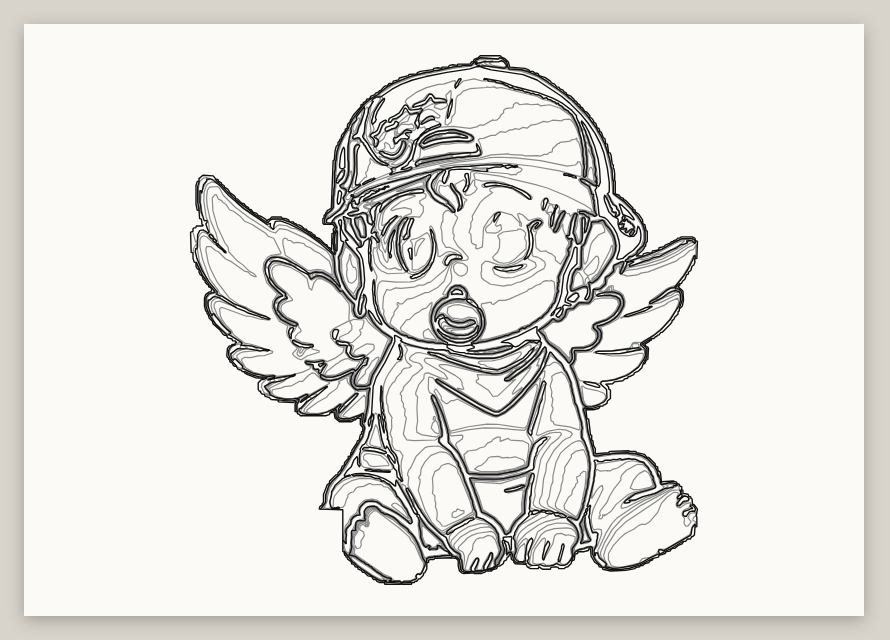
stampe/.lavoro/ang-dett.png
