giandcdalcorso11-coder/GDC-CNC-2D/stampe/.lavoro/angelo-b.png

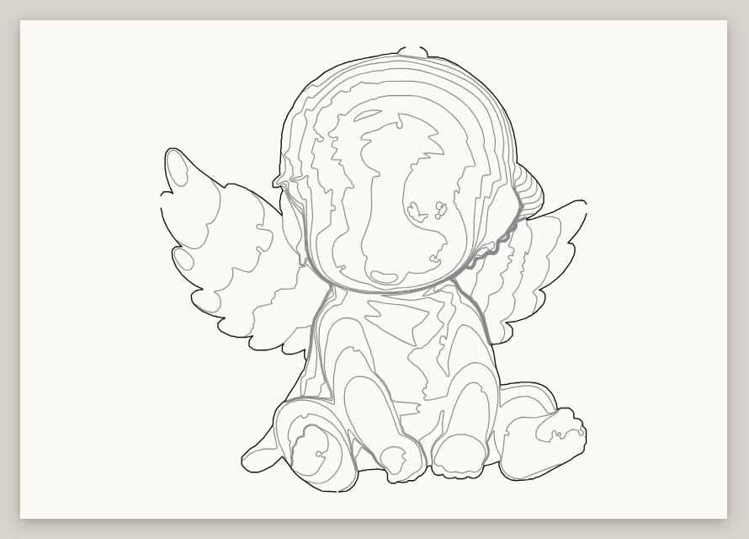
stampe/.lavoro/angelo-b.png
