giandcdalcorso11-coder/GDC-CNC-2D/stampe/.lavoro/angelo-ombra-900.png

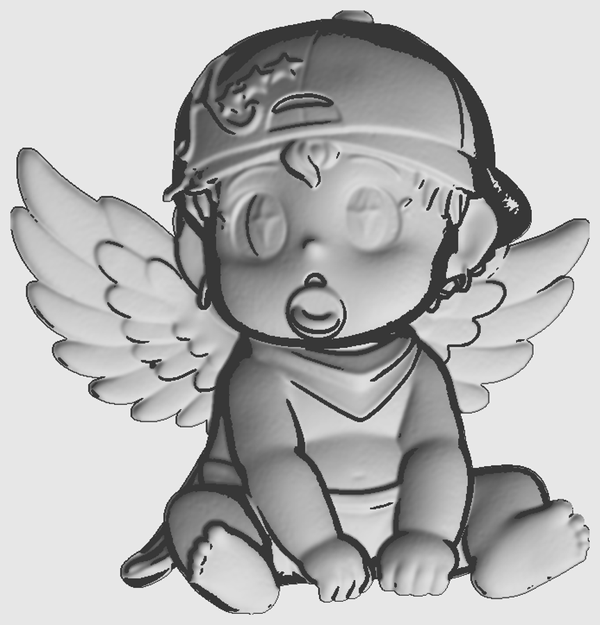
stampe/.lavoro/angelo-ombra-900.png
