giandcdalcorso11-coder/GDC-CNC-2D/stampe/.lavoro/angelo-s7.png

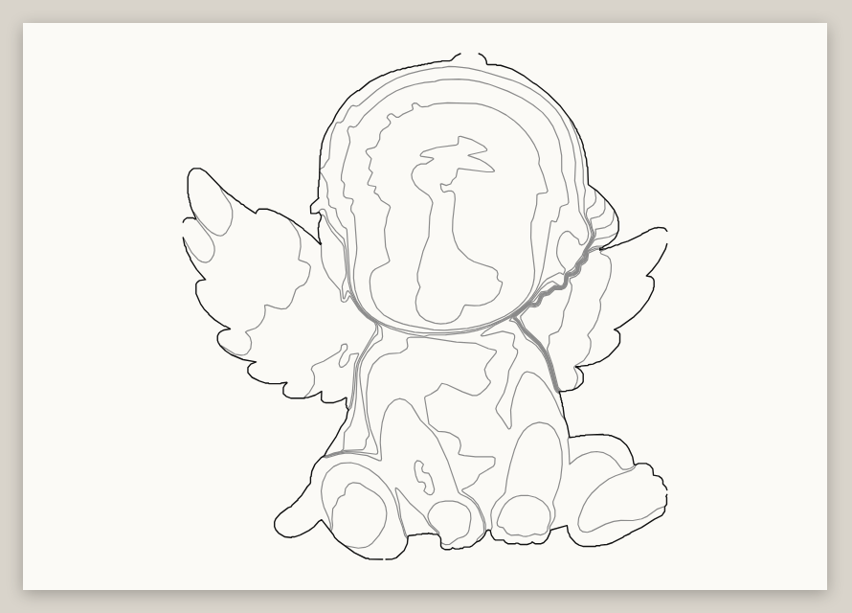
stampe/.lavoro/angelo-s7.png
