giandcdalcorso11-coder/GDC-CNC-2D/stampe/.lavoro/angelo.png

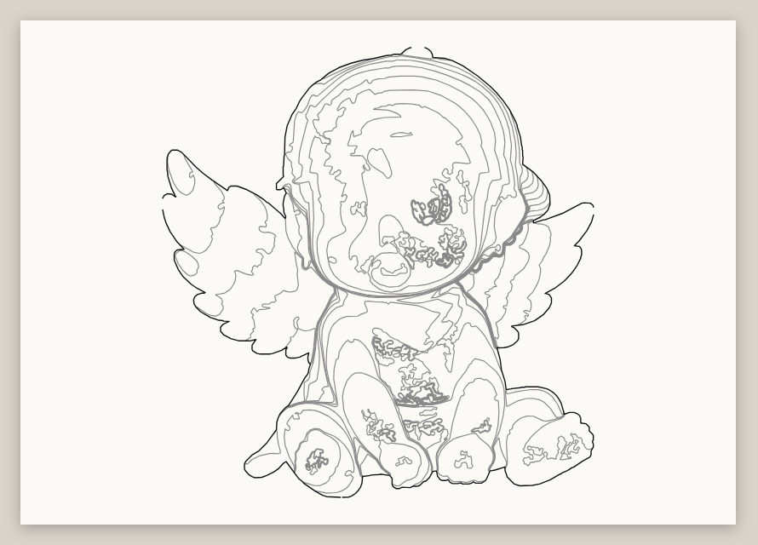
stampe/.lavoro/angelo.png
