giandcdalcorso11-coder/GDC-CNC-2D/stampe/.lavoro/fronte.png

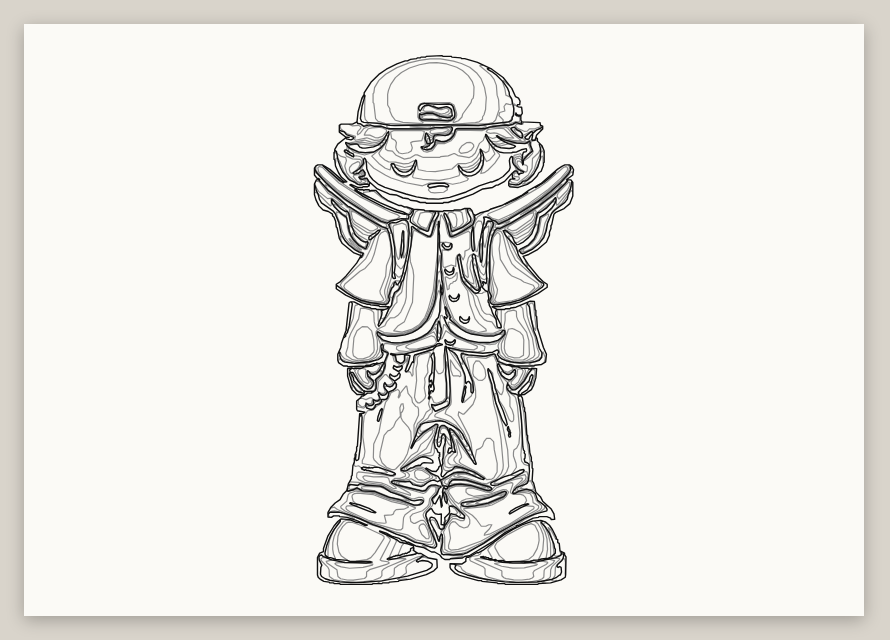
stampe/.lavoro/fronte.png
