giandcdalcorso11-coder/GDC-CNC-2D/stampe/.lavoro/mask.png

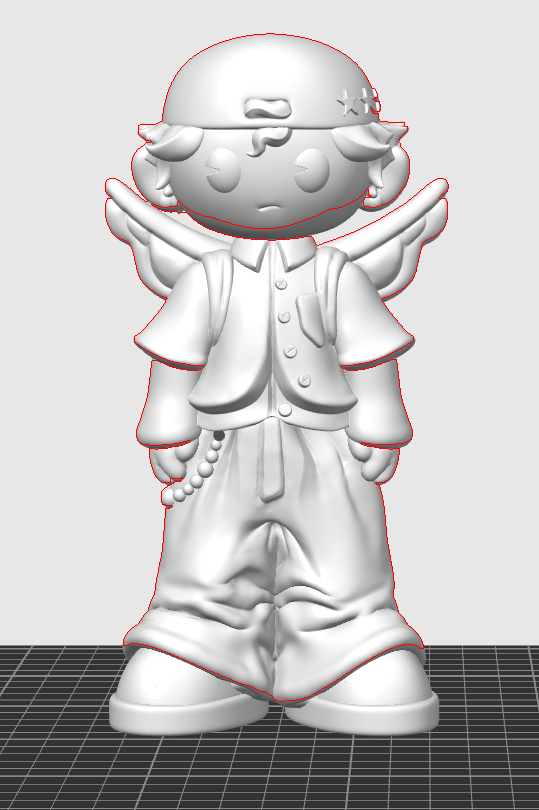
stampe/.lavoro/mask.png
