giandcdalcorso11-coder/GDC-CNC-2D/stampe/.lavoro/starry/Metadata/plate_1.png

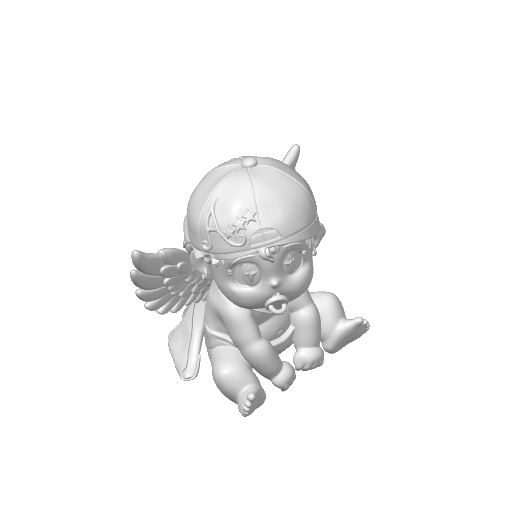
stampe/.lavoro/starry/Metadata/plate_1.png
