giandcdalcorso11-coder/GDC-CNC-2D/stampe/.lavoro/starry/Metadata/plate_no_light_1.png

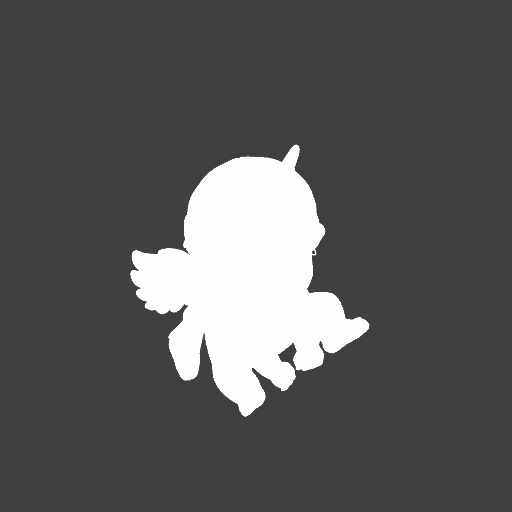
stampe/.lavoro/starry/Metadata/plate_no_light_1.png
