giandcdalcorso11-coder/GDC-CNC-2D/stampe/.lavoro/starry/sheet.png

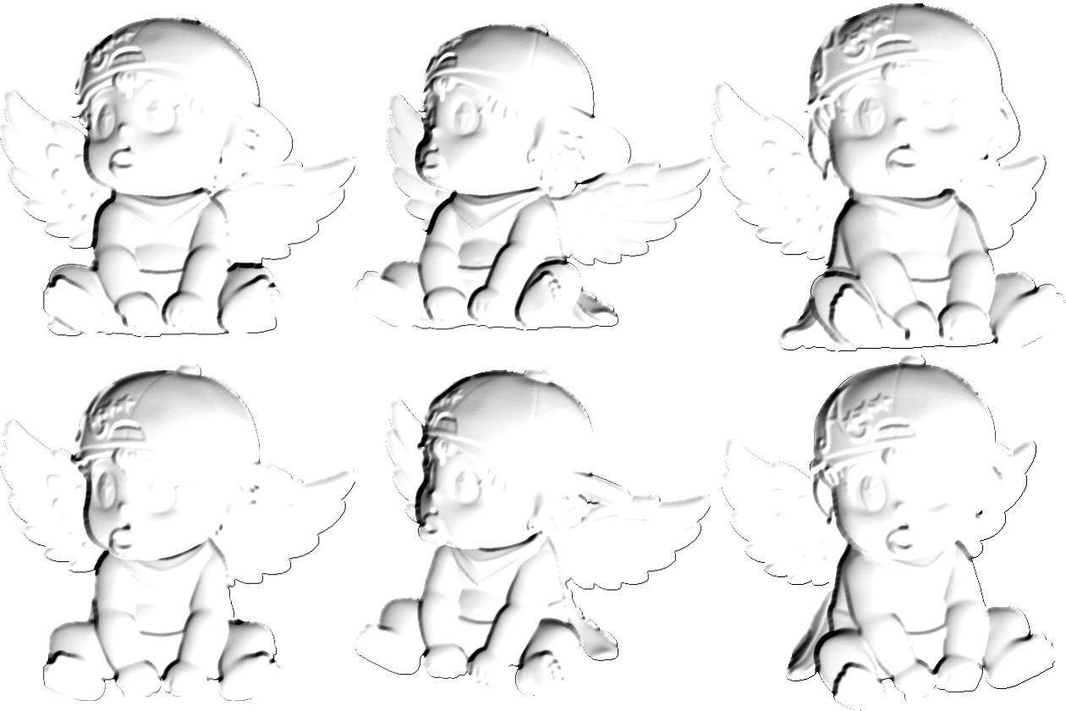
stampe/.lavoro/starry/sheet.png
