giandcdalcorso11-coder/GDC-CNC-2D/firmware/fluidnc/cnc2d-config.yaml

# COPIA GENERATA, tenuta nel repository per poterla leggere e confrontare.
# La sorgente è il profilo macchina del SLICER (tab Impostazioni → Scarica
# config.yaml): modificare questo file a mano fa divergere le due copie.
#
# GDC CNC 2D — configurazione FluidNC
#
# GENERATO dal profilo macchina del GDC CNC 2D SLICER.
# Non modificarlo a mano: la prossima generazione sovrascrive le modifiche.
# I numeri si cambiano nella tab Impostazioni, che rigenera questo file.
#
# Regola del parser: nessun commento in coda a una chiave: valore.
#
# Verifica al primo avvio: un movimento su X deve muovere il carrello
# lungo la trave, non tutto il portale.

name: GDC CNC 2D
board: ESP32 Dev Module

stepping:
  engine: RMT
  # Driver sempre abilitati: con origine manuale, un asse che si
  # ammorbidisce fa perdere la posizione in silenzio.
  idle_ms: 255
  pulse_us: 4
  dir_delay_us: 1
  disable_delay_us: 0

axes:
  shared_stepper_disable_pin: gpio.27

  # X — trave del portale: il carrello che porta la penna, sinistra→destra sul foglio
  x:
    # 94.2478 mm per giro ingranaggio (NOMINALE, da tarare)
    steps_per_mm: 33.953
    max_rate_mm_per_min: 8000.000
    acceleration_mm_per_sec2: 200.000
    # Corsa dal blocco di homing. Totale 257.532 (8744 passi), blocco a 4.300 dalla battuta.
    # Percorribile 241.232 (margine 2.0, ostacolo 10.0).
    # L'ostacolo è un impedimento meccanico: qualcosa si tocca prima
    # della fine corsa. max_travel_mm resta la corsa FISICA, perché
    # descrive la macchina; a non uscire dal percorribile ci pensa
    # l'interfaccia prima di generare un programma.
    max_travel_mm: 253.232
    soft_limits: false

    motor0:
      # Finecorsa non montati: homing a mano sui blocchi stampati.
      hard_limits: false
      stepstick:
        step_pin: gpio.4
        direction_pin: gpio.26

  # Y — rotaie di base: ci scorre sopra tutto il portale, basso→alto sul foglio
  y:
    # 94.2478 mm per giro ingranaggio (NOMINALE, da tarare)
    steps_per_mm: 33.953
    max_rate_mm_per_min: 8000.000
    acceleration_mm_per_sec2: 200.000
    # Corsa dal blocco di homing. Totale 243.041 (8252 passi), blocco a 4.977 dalla battuta.
    # Percorribile 236.064 (margine 2.0).
    max_travel_mm: 238.064
    soft_limits: false

    motor0:
      # Finecorsa non montati: homing a mano sui blocchi stampati.
      hard_limits: false
      stepstick:
        step_pin: gpio.25
        direction_pin: gpio.33:low

  # Z non è un asse vero: è il servo del pen-lift.
  # Senza homing lo zero macchina sta in CIMA e la corsa è negativa:
  # Z0 = posizione tappo, Z scende in negativo fino al foglio.
  # Le quote sono millimetri veri di punta di penna.
  z:
    steps_per_mm: 100.000
    max_rate_mm_per_min: 1000.000
    acceleration_mm_per_sec2: 100.000
    # Dal contatto alla posizione tappo: 65 gradi di servo.
    # Corsa dichiarata, quindi le quote vanno da Z-21.271 a Z0.
    # L'alzata di lavoro è la quota intermedia Z-18.326.
    max_travel_mm: 21.271
    soft_limits: false

    motor0:
      rc_servo:
        output_pin: gpio.32
        pwm_hz: 50
        # min_pulse_us va al FONDO della corsa, cioè Z-21.271:
        # penna sul foglio, 25 gradi. Servo invertito: min > max, voluto.
        min_pulse_us: 2222
        # max_pulse_us va in CIMA, cioè Z0: posizione tappo, 90 gradi.
        max_pulse_us: 1500
        # Battuta dei cuscinetti a 17 gradi (2311 µs): sta fuori
        # dall'arco qui sopra, quindi FluidNC non può comandarla. È voluto.

user_outputs:
  # Verde, giallo, rosso: comandati con M62/M63 P0..P2.
  digital0_pin: gpio.18
  digital1_pin: gpio.19
  digital2_pin: gpio.2

start:
  # Niente finecorsa: l'origine la dà G92 e non sopravvive a un riavvio.
  must_home: false

macros:
  # All'accensione la penna si porta in posizione tappo.
  # FluidNC parte assumendo Z0, e Z0 È la posizione tappo: quello che la
  # macchina crede e quello che il servo fa coincidono, e l'istante fra
  # accensione ed esecuzione di questa riga non muove niente.
  # La riga resta perché rende la quota esplicita, non per correggere.
  # Regola comunque valida: il tappo si toglie PRIMA di dare corrente.
  startup_line0: G90 G0 Z0
  startup_line1:
