giandcdalcorso11-coder/GDC-CNC-2D/(commit log)

2026-10-19 steps_per_mm 80 -> 33,953: il ramo FluidNC aveva il rapporto della cinghia
    Il bug era gia' registrato nel documento il 2026-10-06, con il numero
    giusto scritto nella nota: e' rimasto non applicato per tredici giorni.
    Non e' una scoperta di oggi, e' l'applicazione di una correzione gia'
    decisa.
    cnc2d-config.yaml portava steps_per_mm: 80, che e' la formula di una
    cinghia GT2 con puleggia a 20 denti. Questa macchina ha cremagliera e
    pignone m1.5 z20: un giro vale pi*1,5*20 = 94,2478 mm, cioe' 33,953
    passi/mm a 1/16. Con 80 la macchina percorre 2,356 volte quello che le
    si chiede, quindi un quadrato da 100 mm uscirebbe da 235,6 e finirebbe
    contro il finecorsa al primo movimento.
    Non si e' mai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
    [cnc2d-config.yaml]
2026-10-19 Finecorsa non montati: pin commentati, hard_limits off, tetto di velocita' alzato
    L'utente comunica che i due pulsanti d'angolo non ci sono e non li
    monta per ora. Questo rimanda la decisione sull'azzeramento: niente
    blocco homing, must_home e soft_limits restano falsi.
    Tolti dal file i due limit_neg_pin e messo hard_limits: false.
    Dichiarare un ingresso di finecorsa su un pin senza niente attaccato e'
    peggio che non dichiararlo: il pull-up interno dell'ESP32 e' da decine
    di kiloohm, quindi il pin resta in alta impedenza e un disturbo captato
    dai cavi dei motori puo' farlo leggere come premuto. Il sintomo sarebbe
    stato un allarme a meta' disegno, senza causa apparente e non
    riproducibile. L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
    [cnc2d-config.yaml]
2026-10-19 Procedura di accensione e taratura: Fase A una volta, Fase B ogni stampa
    misure/accensione-e-taratura.md, su richiesta dell'utente. Apre con una
    tabella di cosa esiste davvero oggi, perche' e' una procedura di arrivo:
    FluidNC non e' mai stato acceso sulla macchina montata, il SLICER non e'
    caricato, il pannello manuale e' disabilitato e il profilo non esiste.
    Fase A, sei passi: i tre angoli del servo con la dashboard, la loro
    traduzione in microsecondi, il flash di FluidNC, il caricamento del
    SLICER, le misure di corsa e passi/mm col DRO, il salvataggio del
    profilo. Fase B: cosa succede all'accensione e la routine in dieci
    righe, con i due popup.
    Tre cose emerse scrivendola:
    - i tre angol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
2026-10-19 La dashboard adesso misura: posizione per asse e taratura del rapporto
    Richiesta dell'utente per poter fare le misure degli assi oggi, senza
    aspettare il modulo penna. Osservazione sua e giusta: i pignoni sulle
    cremagliere sono definitivi, quindi corsa e rapporto non cambiano piu'.
    POSIZIONE. posSteps per asse, contato nell'ISR col segno della direzione
    logica (quella delle frecce, non del livello del pin DIR), tenuto in
    passi e non in millimetri perche' un accumulatore in float perderebbe
    risoluzione dopo qualche migliaio di passi. Mostrato in mm in un
    riquadro nella tab Controllo, con azzeramento per asse o per entrambi.
    Il segno si imposta dentro la sezione critica di startMoveSteps e no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
2026-10-19 Prime corse misurate sulla macchina: X 248,048 e Y 258,622 (provvisorie)
    Misurate dall'utente col DRO nuovo della dashboard, portando ciascun
    asse a un estremo, azzerando e andando all'altro.
    Provvisorie perche' il rapporto non e' ancora tarato: sono calcolate col
    nominale 33,953 passi/mm. Non vanno pero' rifatte, perche' l'errore e'
    puramente moltiplicativo - bastera' riscalarle per mmPerRev_tarato /
    94,2478. In passi sono 8422 su X e 8781 su Y, e quelli non cambiano.
    Da guardare: X da' meno corsa di Y pur stando su una trave da 550 mm
    contro rotaie da 400 (302 mm di ingombro contro 141). Plausibile, il
    carrello X porta motore e modulo penna, ma vale un controllo a vista.
    Documento di se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
2026-10-19 I pin dei due assi erano scambiati dal 2026-10-15: corretti
    Segnalato dall'utente provando le frecce: destra/sinistra muovevano la
    testina in alto e in basso, su/giu' la muovevano a destra e sinistra.
    La mappatura tastiera->asse era giusta (frecce orizzontali su x,
    verticali su y). Sbagliato era quale motore fosse x. Il 15 ottobre,
    applicando il rinominamento degli assi, ho scambiato i quattro #define
    dei pin: ma andavano sistemati i NOMI, non l'abbinamento nome-pin, che
    era gia' giusto.
    All'origine c'e' una mia descrizione sbagliata. Avevo scritto che il
    driver su 4/26 era quello del portale e quello su 25/33 quello della
    trave: e' il contrario. Poi ho "corretto" i pin per farli combaciar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
    [cnc2d-config.yaml]
2026-10-19 Corse rimisurate: X ripete entro 1,1 mm, Y scarta di 5,0 - e l'A4 non ci sta
    Seconda tornata dopo la correzione dei pin: X 257,532 e Y 243,041.
    Contro la prima, X scarta di -1,090 mm (-0,42%, 37 passi) e Y di -5,007
    (-2,02%, 170 passi).
    Entrambe piu' corte, che e' il verso atteso: il contatore conta i passi
    comandati, quindi spingere contro il fine corsa gonfia il numero. Si
    tengono le minori, che sono anche le conservative.
    Il 2% su Y resta pero' troppo, e c'e' un'ipotesi specifica: Y e' il
    portale su due rotaie con un motore solo da un lato, quindi puo'
    imbardare, e il punto in cui arriva in fondo dipende da quanto e' storto
    quando ci arriva. X e' un carrello su una trave sola e non ha n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
2026-10-19 Il rapporto si tara disegnando, non inseguendo il carrello col calibro
    Obiezione dell'utente, ed e' fondata: inseguire un carrello col calibro
    contro un riferimento improvvisato da' due o tre decimi di incertezza,
    cioe' proprio l'ordine di grandezza da misurare. Una linea disegnata sta
    ferma, e' piana, sta su un tavolo e il calibro ci appoggia le ganasce
    come vuole lui. Annulla l'ordine 'prima il rapporto, poi la corsa' che
    avevo scritto poche ore prima.
    Serve comunque un metro esterno, e vale la pena averlo scritto: corsa
    letta = passi / 33,953 e passi = denti percorsi x 20, quindi corsa letta
    = denti percorsi x 4,71239 sempre, qualunque sia il passo vero. Il
    ritiro di stampa si cancella p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
2026-10-19 Il modello del profilo macchina, e config.yaml diventa un prodotto
    webui/js/profile.js: lo scheletro su cui poggiano sia il pannello
    manuale sia la tab Impostazioni. La decisione del 2026-10-15 ("la tab e'
    l'unica fonte di verita'") diventa codice: il profilo e' il documento
    sorgente e config.yaml si genera da lui con toYaml().
    Scelte di struttura:
    - null non e' zero. I tre angoli del servo partono a null, che vuol dire
    "non ancora misurato", e verifica() si rifiuta di dare il via libera
    finche' ce n'e' uno in giro invece di far finta che valga zero.
    - Niente valori derivati salvati: passi/mm, limiti di lavoro, mm/grado e
    alzata si ricalcolano sempre dai dati grezzi. Un numero calcol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
2026-10-19 Documento di sessione v42: voce della giornata ricomposta
    Rimessi al loro posto otto punti che avevo inserito per errore nella
    voce del 2026-10-17: erano lavoro del 19 (la procedura di accensione, la
    dashboard che misura, il terzo popup, le corse, il bug dei pin, il
    profilo). Causa: avevo ancorato le sostituzioni su una riga di quella
    voce senza verificare in quale voce stesse. La voce del 17 e' tornata al
    suo contenuto. Registrato come terzo bug della giornata.
    Voce del 19 completata: titolo e riepilogo riscritti sull'arco vero
    della giornata, tredici punti in "Cosa e' stato fatto", tre blocchi bug
    in forma Sintomo/Causa/Fix (il rapporto della cinghia, i pin scambiati,
    i punti fuori posto)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
2026-10-19 Due profili, e la tab Impostazioni costruita sui nomi concordati
    I nomi di ogni numero della macchina sono ora in
    misure/impostazioni-glossario.md, concordati con l'utente. Tre scelte lo
    cambiano più di quanto sembri.
    Due profili invece di uno, come in Bambu Studio: la macchina (trasmissione,
    corse, dinamica, estremi del servo, homing) cambia solo se si smonta un pezzo
    ed è una; i profili di stampa (foglio, velocità, pausa della penna) sono
    quanti se ne vogliono, con un nome, e si salvano in una libreria.
    La corsa si conserva in PASSI, non in millimetri. Le due misure del DRO —
    257,532 e 243,041 mm — valgono esattamente 8744 e 8252 passi, interi a meno
    di due centesimi: il DRO non m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
    [cnc2d-config.yaml]
2026-10-19 Homing a mano: i motori si liberano, i carrelli si appoggiano, poi si azzera
    La coppia di uno stepper basta a spostare il blocco stampato che dà il
    riferimento di homing — cioè a spostare proprio la cosa che definisce la
    misura — e a far strisciare i cuscinetti arrivandoci. A mano si appoggia e
    basta. Richiesta dell'utente, con la sua motivazione.
    Due pulsanti nel riquadro Posizione, e l'ordine conta: «Libera i motori»
    spegne i driver e dichiara persa la posizione; «Homing completato» riattiva
    PRIMA e azzera POI. Al contrario, l'origine resterebbe alla mercé del primo
    urto senza che nessuno lo dica. La conferma compare solo se c'è davvero
    un'origine da perdere.
    Il flag posNota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
2026-10-19 La ripetibilità dell'homing non si misura col DRO: correzione
    La procedura che avevo scritto in quattro punti — «appoggia il carrello al
    blocco cinque o sei volte azzerando ogni volta e guarda di quanto ballano i
    passi» — è impossibile, e lo è per il motivo stesso di cui parla il resto
    del lavoro di oggi: per ripetere l'appoggio bisogna liberare i motori, e
    liberare i motori cancella quello che il contatore sa. Non c'è ordine delle
    operazioni che lo aggiri. Uno stepper non misura, conta gli impulsi che gli
    arrivano.
    Sostituita con due procedure che funzionano:
    - la corsa disponibile dall'home si legge col DRO (azzera sul blocco, vai
    all'altra battuta), e lo scostamento è la co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
2026-10-19 I blocchi di homing misurati: il margine scende da 8 a 2 mm
    Misure dell'utente coi blocchi montati: azzerato sul blocco e portato l'asse
    all'altra battuta si legge 256,089 su X e 243,071 su Y, contro 257,532 e
    243,041 da battuta a battuta.
    Su X il blocco mangia 1,443 mm. Su Y ne mangia -0,030 — un passo in meno di
    zero, cioè il blocco sta di fatto sulla battuta e la corsa utile non la tocca.
    Il segno negativo è rumore di misura, non corsa in più, quindi si registra
    zero.
    La ripetibilità dell'appoggio non si legge col calibro: sempre lo stesso
    valore. Registrata 0,05 e non 0, perché "sotto la risoluzione dello strumento"
    e "zero" sono due cose diverse, e uno zero vero direbbe al soft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
2026-10-19 Il pannello manuale: un componente solo, montato in piu posti
    Senza finecorsa questo pannello non e una comodita: e l'unico modo di dare
    un'origine alla macchina, e da qui passano tutte le misure di taratura.
    Scritto una volta in js/panel.js e montato nella barra laterale (senza la
    scheda penna, che li si usa poco) e in una tab dedicata; i tre popup di
    inizio stampa monteranno lo stesso. Niente id, solo classi, perche possono
    essercene tre vivi nella stessa pagina. Due copie dello stesso pannello
    divergono: una impara a fare una cosa e l'altra no, e te ne accorgi col
    foglio rovinato.
    L'homing a mano del SLICER fa gli stessi gesti della dashboard con un
    meccanismo diverso, verificato sulla d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
2026-10-20 I tre popup di inizio stampa
    Tre, perche misurano tre cose diverse e nessuna delle tre si puo salvare nel
    profilo: dipendono da dove hai appoggiato il foglio oggi. L'origine (i
    carrelli sui blocchi, a mano), l'altezza a cui la punta tocca QUESTO foglio,
    e dove sta il foglio sul piano. Dopo un riavvio non valgono piu, quindi
    stanno in State.
    Montano lo stesso componente della tab Manuale, con sezioni diverse: il primo
    senza penna, il secondo senza frecce, il terzo tutto. E il motivo per cui il
    pannello era stato scritto come componente.
    Ogni passo si sblocca da se quando la sua condizione diventa vera, senza
    chiudere e riaprire, e quando e bloccato dice perche invece di mostrare un
    pulsante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
2026-10-20 Punto ai blocchi e punto home separati, e il foglio misurato si blocca
    Due richieste dell'utente.
    Il PUNTO AI BLOCCHI resta lo zero — dove i carrelli toccano — ma la macchina
    non ci rimane: finito l'azzeramento si sposta da sola al PUNTO HOME, a 5 mm
    da entrambi. Due motivi, e il primo e dell'utente: un carrello lasciato
    appoggiato al blocco prima o poi lo sposta, e il blocco e proprio la cosa che
    non si deve muovere. Il secondo viene dietro: allontanandosi sempre nello
    stesso verso, il gioco della cremagliera viene preso da una parte sola, e il
    primo movimento vero parte da una condizione nota.
    L'ordine dei tre comandi e verificato da un test: G92 sul punto ai blocchi,
    poi il G0 al pu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
2026-10-20 Documento di sessione v43: la giornata del SLICER e dei blocchi di homing
    Il documento era fermo a v42 di ieri mezzogiorno e da allora ci sono sette
    commit: nomenclatura concordata, modello a due profili, tab Impostazioni,
    homing a mano nel firmware, blocchi misurati, pannello manuale, tre popup,
    punto home e foglio bloccato.
    Tre bug in forma Sintomo/Causa/Fix, e il primo e mio: la procedura per
    misurare la ripetibilita dell'homing che avevo scritto in quattro file e
    impossibile, perche per ripetere l'appoggio bisogna liberare i motori e
    liberare i motori cancella quello che il contatore sa. Gli altri due sono
    difetti latenti del firmware trovati mentre scrivevo l'homing: l'impulso
    singolo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
2026-10-20 Due pulsanti da un grado per il servo, per le misure
    Richiesta dell'utente, e il grado e il passo giusto: vale 0,327 mm di penna,
    ed e anche il limite sotto cui il servo non risponde — la banda morta
    dell'SG90 e di circa 10 us su 2000 us per 180 gradi, cioe quasi un grado
    esatto. Un comando da mezzo grado puo non produrre nessun movimento.
    Trascinando lo slider si perde il conto di dove si e; premendo si sa sempre a
    che angolo si sta, ed e quello che serve per cercare la battuta dei
    cuscinetti e il punto in cui la punta tocca il foglio.
    I pulsanti partono dal valore dello slider e non dall'ultimo stato ricevuto
    dalla macchina: altrimenti due click veloci partirebbero dallo stesso punto e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
2026-10-20 Il disegno di collaudo: nove prove su una stampa sola
    Proposta per il primo disegno vero, su richiesta dell'utente. Una stampa che
    riempie quasi tutta l'area e da cui si tirano fuori otto numeri: scala per
    asse coi righelli, ortogonalita col quadrato e le sue diagonali, gioco col
    doppio pettine, livellamento coi nodi a gradini di quota, pausa del servo
    con gli stacchi, rettilineita con due rette lunghe, piu cerchi e scala dei
    caratteri che confermano a occhio.
    Il pezzo che vale di piu e l'idea dell'utente dei puntini, resa
    quantitativa: in nove punti si disegnano quattro trattini, ognuno 0,30 mm
    piu in alto del precedente. Si contano quelli che hanno segnato e si legge
    l'altezza del piano i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
2026-10-20 Disegno di collaudo: riquadri numerati, ripetibilita e velocita
    Due prove nuove, chieste dall'utente.
    RIPETIBILITA (9): otto volte la stessa tacca, arrivando ogni volta da
    lontano. Due colonne, e la differenza fra le due e il punto: a sinistra si
    arriva sempre dallo stesso verso, quindi il gioco resta fuori dalla misura;
    a destra si alterna, quindi il gioco entra. Lo scarto fra le due bande e una
    SECONDA lettura del gioco, indipendente da quella della prova 6. Gli otto
    trattini sono impilati e non sovrapposti: sovrapposti non si saprebbe
    nemmeno quanti ne sono stati disegnati, impilati il bordo seghettato si
    legge a occhio.
    VELOCITA (10): quattro righe uguali a 600, 1200, 2400 e 4800 mm/mi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
2026-10-20 Documento v44: il fissaggio del foglio e l'idea di compensare via software
    Due note, per non perderle.
    Il fissaggio del foglio: nastro di carta in attesa della stampa di collaudo,
    col vincolo che esclude quasi tutto il resto — fra piano carta e punto piu
    basso del carrello ci sono 2,5 mm, quindi dentro la zona spazzata non ci sta
    nessuna calamita. E il fatto che la piattaforma da 44 mm non sia ancora
    costruita, che rende il fissaggio una scelta di progetto invece di un
    accessorio.
    L'idea dell'utente di compensare il fuori-piano via software, parcheggiata
    con le due cose che servira sapere quando ci si tornera: i dati li raccoglie
    gia la prova 11 del disegno di collaudo, e la soglia che d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
2026-10-20 Correggo l'ora dell'ultimo aggiornamento: 22:08, non 23:07
    L'avevo scritta prima di chiedere l'orario al sistema. E' la terza volta che
    invento un orario in questo progetto, e le altre due sono gia registrate come
    errori nel documento stesso.
    Claude-Session: https://claude.ai/code/session_01B9QYaZ22yQtQe7sA7gRsH6
2026-10-21 Passo A2 riscritto: una misura sola, due conti, e un gesto
    La procedura era scritta prima di tre cose. Ora dice che:
    - la battuta e l'UNICO dei tre angoli che si misura. Gli altri due sono
    battuta+6 e battuta+15: la penna abbassata non si misura, si impone
    stringendo la penna a quell'angolo, e l'alzata e un conto. Il giorno che si
    cambia penna si rifa il gesto allo stesso angolo e non si rimisura niente;
    - il contatto si trova con una striscia di carta fra cuscinetto e blocco,
    tirandola a ogni grado, invece di aspettare che il servo ronzi. Si segna
    l'ultimo grado in cui la carta usciva: e il valore conservativo;
    - si lavora coi pulsanti da un grado, non piu con lo slider.
    Aggiunt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
2026-10-21 Il servo e invertito: convertito in un punto solo, dalla dashboard a FluidNC
    Sul modulo montato oggi l'accoppiamento esce al contrario: crescendo
    l'angolo fisico la penna scende, quindi "Alza" abbassava.
    Si poteva convivere con due convenzioni opposte — il meccanismo in un verso
    e tutto il resto del progetto nell'altro — e sarebbe stato il modo sicuro di
    sbagliare un segno fra sei mesi. Invece si converte in un posto solo per
    ciascun lato della catena: servoApply() nel firmware, gradiToUs() nel
    profilo. Da li in avanti i gradi che si vedono, si salvano e si mettono nel
    profilo sono LOGICI — piu gradi = penna piu in alto — e resta valida ovunque
    la regola battuta < abbassata < alzata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
2026-10-21 Documento di sessione v45: il modulo penna e montato
    Copre tutto dalla voce precedente (2026-10-20 20:43): i pulsanti da un
    grado, il disegno di collaudo con le due prove nuove, il passo A2
    riscritto, il montaggio del modulo penna e l'inversione del servo.
    Quattro bug in forma Sintomo/Causa/Fix, e uno resta APERTO: la prima
    taratura ha messo la battuta a 1 grado logico, cioe 2489 us, fuori dalla
    specifica 500-2400 dell'SG90 — l'ingranaggio e stato calettato col servo
    gia contro il proprio fermo interno. Proposta la correzione di un dente di
    cannula, in attesa di decisione dell'utente. Gli altri tre sono il servo
    invertito (risolto e verificato) e due blocchi dell'IDE Arduino che
    costerann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
2026-10-21 I tre angoli del servo sono numeri veri: 19 / 25 / 34
    Il pignone del pen-lift e stato ricalzato sull'albero con la dashboard a 19
    gradi e il modulo appoggiato ai blocchi: la battuta e quell'angolo per
    costruzione, non per misura. Diciannove e non uno perche col verso invertito
    l'angolo logico piccolo e l'impulso grande, e a 1 grado l'impulso sarebbe
    2489 us, fuori dai 500-2400 di specifica dell'SG90 - il primo montaggio aveva
    calzato il pignone col servo gia contro il proprio fermo interno, e li il
    fermo del meccanismo e quello del servo non si distinguono. A 19 / 25 / 34 la
    finestra di lavoro e 2289 / 2222 / 2122 us, tutta dentro.
    I tre numeri entrano dove servono:
    - profilo del SLICER: g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
    [cnc2d-config.yaml]
2026-10-21 Il piano di riferimento e quello su cui stampi, non una piattaforma che non esiste
    Segnalato dall'utente: il passo A2 diceva di stringere la penna contro uno
    spessore da 44 mm, e sulla macchina com'e montata oggi il piano e unico - il
    foglio appoggia sulla tavola e la penna lo raggiunge.
    Ha ragione. I 44 mm vengono da una decisione del 2026-10-06 (punto piu basso
    del carrello Y a Z 46,68 sopra la tavola, quindi un piano carta a Z 44,2
    lascerebbe 2,5 mm di franco) e riguardano una PIATTAFORMA mai costruita. La
    quota assoluta non e un vincolo, perche a regolarla e la penna che scorre nei
    morsetti: tarare contro uno spessore da 44 mm vorrebbe dire tarare contro un
    piano che poi non si usa.
    A2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
2026-10-21 Documento di sessione v46: la piattaforma da 44 mm e eliminata
    Decisione dell'utente: col modulo Tratto Pen attaccato alla testina dell'asse
    X lo spazio verticale libero e meno di 40 mm, quindi la piattaforma non ci sta
    sotto. Il piano resta unico, la tavola. Supera la decisione del 2026-10-06,
    che la dava come necessaria sulla base del carrello Y a Z 46,68 - un vincolo
    del carrello, non del modulo penna, che allora non esisteva.
    La voce copre anche i tre angoli del servo (19 / 25 / 34) e i due bug della
    giornata: la penna alzata di fabbrica oltre il fermo meccanico, e la procedura
    di taratura che chiedeva uno spessore da 44 mm contro un piano che non esiste.
    Due note nella pipeline, con l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
2026-10-22 L'assieme con il modulo penna, letto numero per numero
    Primo STEP che contiene il modulo montato. Scritto un lettore di assiemi
    (albero da NEXT_ASSEMBLY_USAGE_OCCURRENCE, trasformazioni da
    ITEM_DEFINED_TRANSFORMATION, vertici riportati nel mondo) perche le
    rappresentazioni dei pezzi sono vuote e il solido vive in una
    ADVANCED_BREP_SHAPE_REPRESENTATION separata.
    I tre numeri che mancavano:
    - ASSE DELLA PENNA X -198,01 Y -215,78. La penna non e modellata, ma la sua
    sede a V su pz2 si: bocca 10,00, profondita 3,00, e i punti di tangenza di
    un cerchio Ø10 cadono esattamente sulla bocca. E disegnata per il Tratto
    Pen. La V del morsetto e aperta di 3,46 mm nella posa del CAD e chiudendosi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
2026-10-22 Corse rimisurate dopo il rifacimento dei blocchi: 253,232 e 238,064
    Misure dell'utente col DRO della dashboard, dopo aver spostato una cremagliera
    e rifatto un blocco. Le due letture valgono 8597,986 e 8082,987 passi, cioe a
    quattro decimi di micron da un intero: la stessa conferma del 2026-10-19, il
    DRO non misura millimetri, conta passi.
    Sono corse DALL'HOME, quindi entrano nel profilo come scostamento dei blocchi
    tenendo ferma la corsa totale del 2026-10-19 (8744 e 8252 passi, presa senza
    blocchi e non rimisurata):
    scostamento X 1,443 -> 4,300 mm (146 passi)
    scostamento Y 0 -> 4,977 mm (169 passi)
    Su Y il blocco non sta piu sulla battuta: ne sta 5 mm dentro.
    Corsa percorri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
2026-10-22 La battuta misurata e 17, nasce la posizione tappo, e FluidNC non legge i nostri commenti
    Tre cose, e la terza e la piu importante perche nessuno l'aveva ancora vista.
    BATTUTA 17, non 19. La prova della striscia di carta dell'utente supera i 19
    fissati per costruzione il 2026-10-21: i due gradi sono quello che il modulo
    aveva ancora da scendere quando il pignone e stato calzato. I 25 gradi di
    penna abbassata NON si toccano - non sono battuta + 6 ma l'angolo a cui la
    penna e stata stretta, e il disegno a mano lo conferma. Ora sono battuta + 8,
    cioe c'e piu riserva verso il basso di quanta ne era prevista.
    POSIZIONE TAPPO a 90 gradi, richiesta dall'utente: la penna ci sale a fine
    stampa e al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
    [cnc2d-config.yaml]
2026-10-22 Il gioco d'ingranamento non si misura, e il collaudo e pronto
    Obiezione dell'utente, accolta: "abbiamo deciso che la penna scrive con la
    forza del servo, non col suo peso". Ha ragione, e lo dice anche il documento
    di progetto - da modulo-penna/schema.html, 2026-10-17: "la quota della punta e
    l'angolo del servo, in presa rigida nei due versi". La mia procedura si
    basava sull'architettura a due stadi col giunto a gioco morto da 6 mm, che il
    CAD non ha costruito. La penna galleggia solo dentro i 0,30 mm, che sono 0,92
    gradi di servo contro una banda morta di ~0,9: una finestra larga un passo, in
    cui non ci si puo mirare.
    Passo A2.1 tolto e sostituito da una nota che spiega perche non c'e, cosi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
2026-10-22 Quadrato di verifica da 50 mm, la prima stampa dopo FluidNC
    Un solo tratto chiuso, centrato nell'area percorribile, che risponde a tre
    domande in trenta secondi: il verso dei due assi (il primo lato va verso +X e
    deve muovere il carrello lungo la trave, il secondo verso +Y e deve muovere il
    portale), se la penna segna per tutto il perimetro, e se il quadrato chiude
    dove e partito. Il lato misurato col calibro da anche il primo numero sul
    rapporto: lato_vero / 50 e il fattore da applicare ai mm per giro ingranaggio.
    Generato con i numeri veri del profilo, come il collaudo.
    Claude-Session: https://claude.ai/code/session_01B9QYaZ22yQtQe7sA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
2026-10-22 A4: versione 4.1.0, rete da rimettere, e perche non conviene scambiare l'ESP32
    Due cose che mancavano alla procedura di flash.
    La VERSIONE: 4.1.0, la stessa su cui la configurazione e stata validata il
    2026-09-21, non l'ultima per inerzia. Una versione nuova puo cambiare i nomi
    dei campi; di questa sappiamo che li accetta tutti. E un fresh-install
    cancella anche la rete, quindi vanno rimesse modalita STA e hostname cnc2d
    per ritrovare http://cnc2d.local.
    LA SCHEDA: c'e un secondo ESP32 con FluidNC gia sopra, e sembra una
    scorciatoia. Non lo e. Il config.yaml va caricato comunque, perche quello sul
    vecchio e di settembre (steps_per_mm 80, max_travel 300, nessun numero del
    servo). Il circuit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
2026-10-22 FluidNC 4.1.1 invece di 4.1.0, e il changelog dice perche
    L'utente ha notato che l'ultima e la 4.1.1 del 2026-09-25. Letto il
    changelog: e una patch sulla 4.1.0, la versione su cui la configurazione era
    stata validata, e nessuna voce tocca i nomi dei campi - quindi il motivo per
    cui avevo scritto di non prendere l'ultima (rischio di schema cambiato) qui
    non vale.
    Tre correzioni cadono invece dove lavoriamo: un bug di generazione dei comandi
    macro (Macro::addf, va_list riusata), un descrittore di upload non rilasciato
    quando un trasferimento viene abbandonato, e i riavvii del watchdog durante le
    operazioni sui file. La riga di avvio del servo e una macro e i programmi si
    caricano dalla WebUI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
2026-10-22 Flash a 115200: il CH340 non regge i 921600 sull'immagine grande
    Trasferimento interrotto all'1% dell'immagine da 1,1 MB, scheda lasciata in
    boot loop. Il convertitore USB e un CH340 (VendorID 0x1a86 ProductID 0x7523
    nel log di esptool) e a 921600 non tiene: i file piccoli passano, l'immagine
    grande no. Lo dice esptool stesso due righe dopo il cambio di baud.
    Registrato in A4 con la scala di rimedi: 115200, poi cavo corto e porta
    diretta, poi ESP32 sfilato dalla breadboard - perche con i 12 V spenti e
    l'USB ad alimentare driver, LED e servo, e un calo di tensione durante la
    scrittura resetta la scheda.
    E la nota che conta per chi si spaventa: una scheda interrotta a meta flash
    non e rotta.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
2026-10-22 Il collaudo non entrava nella flash: 69 kB contro 64 liberi
    Dopo l'installazione della 4.1.1 con WebUI-2 il browser dei file dichiara 64 kB
    liberi - index.html.gz da solo ne occupa 111. Il collaudo scritto per esteso ne
    occupava 69.268 e non ci sarebbe entrato.
    Il generatore ora sfrutta la modalita del G-code, che non e un trucco ma il
    modo in cui il linguaggio e fatto: la parola G0/G1 resta valida finche non
    cambia, una coordinata non ripetuta vuol dire che quell'asse resta dov'e, gli
    zeri in coda si tolgono, e una riga che non cambierebbe niente non si emette
    affatto (un G1 su un punto identico al precedente e anche il caso che FluidNC
    ha corretto nella 4.1.1).
    44.633 byte, con lo stesso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
2026-10-22 Anche il generatore del SLICER emette G-code modale
    Stesso vincolo del collaudo: il programma deve stare nei ~64 kB liberi della
    flash, e il boot di FluidNC lo conferma - /littlefs Free:64.00 KB Used:128.00
    Total:192.00.
    Gcode.build ora emette solo quello che cambia: la parola G0/G1 resta valida
    finche non cambia, una coordinata non ripetuta vuol dire che quell'asse resta
    dov'e, F idem, e gli zeri in coda si tolgono. Una riga che non cambierebbe
    niente non si emette affatto.
    G0 X10.000 Y10.000 F3000 -> X10 Y10 F3000
    G1 X40.000 Y10.000 F1200 -> X40 F1200
    G1 X40.000 Y40.000 -> Y40
    Aggiornate le asserzioni che davano per scontata la forma estesa, e aggiunta
    u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
2026-10-22 Configurazione verificata sulla macchina: $CD rilegge tutto
    Primo avvio di FluidNC 4.1.1 con il config generato dal profilo. $CD
    restituisce tutti i numeri giusti: steps_per_mm 33.952999 sui due assi,
    max_travel 253.231995 e 238.063995, direction_pin 'gpio.26:low' su X, rc_servo
    su gpio.32 con 2222 e 1500, max_travel 21.271 su Z, startup_line0 G90 G0
    Z21.271, must_home false. Nessuna chiave ignorata: il timore dei commenti in
    coda era fondato ma il file generato e pulito.
    Registrate anche due letture del dump che non sono nostre: idle_disable true
    per asse (default; il comando resta idle_ms, e 255 vuol dire non disabilitare
    mai, convenzione ereditata da grbl dove il parametro era a 8 bit) e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
2026-10-22 I due assi andavano al contrario tutti e due
    Verificato sulla macchina al primo avvio di FluidNC: $J=G91 X25 porta il
    carrello VERSO il suo blocco invece che via, e su Y il meno fa quello che
    dovrebbe fare il piu. Confermato dall'utente col criterio che non dipende da
    dove si sta in piedi: i carrelli si sono AVVICINATI ai blocchi.
    X invertito true -> false (sparisce :low da gpio.26)
    Y invertito false -> true (compare :low su gpio.33)
    Che fossero sbagliati entrambi non e strano: nessuno dei due era mai stato
    provato con FluidNC, e il :low su X era una deduzione - il file stesso diceva
    "da confermare al primo avvio guardando il verso".
    config.yaml rigenerato dal profilo.
    Co-Aut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
    [cnc2d-config.yaml]
2026-10-22 Documento di sessione v50: FluidNC e sulla macchina
    La voce copre l'installazione di FluidNC 4.1.1 sull'ESP32 montato e i primi
    comandi veri, che hanno trovato tre cose che nessun ragionamento aveva
    trovato.
    Quattro blocchi Sintomo/Causa/Fix:
    - IL SERVO NON SI MUOVEVA e gli impulsi erano giusti. RcServo mappa la
    posizione MACCHINA e tronca fuori dai limiti dell'asse; senza homing
    FluidNC dichiara la corsa in negativo, Axis Z (-21.281, 0.010), quindi
    tutte le quote positive uscivano a 1500 us. Diagnosi confermata con
    G0 Z-3. Fix NON ancora applicato: e il primo problema aperto.
    - I DUE ASSI ANDAVANO AL CONTRARIO TUTTI E DUE. Spunte invertite nel
    profilo, config rigenerato, da ripr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
2026-10-22 Le quote Z sono negative: lo zero macchina sta in cima
    Il servo non si muoveva pur avendo gli impulsi giusti nel config: RcServo
    mappa la posizione MACCHINA con mapConstrain(), e senza homing FluidNC mette
    lo zero macchina all'estremo alto della corsa dichiarando il resto in
    negativo - Axis Z (-21.281, 0.010). Ogni quota positiva che mandavamo finiva
    troncata sullo stesso impulso, quello del tappo. soft_limits: false spegne i
    limiti del pianificatore, non quel troncamento.
    La convenzione nuova, unica possibile:
    Z0 posizione tappo, in cima
    Z-18.326 penna alzata di lavoro
    Z-21.271 punta sul foglio
    Vive in un punto solo, Profile.zDaGradi(), con zTappo/zAlzata/zContatto
    sopra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
    [cnc2d-config.yaml]
2026-10-22 Origine a mano: il G92 va prima del jog, non dopo
    Due errori nella sequenza del passo A4.1.
    Aritmetico: il jog "minimo" di riabilitazione era `$J=G91 X0.01 F100`, ma con
    33,953 passi/mm un passo vale 0,02945 mm. 0,01 mm fa 0,34 passi, arrotondati
    a zero: un jog che non muove niente, e non e' detto che riabiliti niente.
    Di merito: qualunque jog prima del G92 porta il carrello via dai blocchi, e
    lo zero finisce dove il carrello e' arrivato invece che sui blocchi. 0,1 mm
    sono il doppio della ripetibilita' dell'appoggio (0,05 mm), quindi non si
    assorbono nel rumore.
    Sequenza nuova: $MD, appoggio ai blocchi, G92 X0 Y0, poi G90 G0 X5 Y5 F1000 —
    che riabilita i motori (lo fa qualunque comando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
2026-10-22 Quadrato da 60 mm con l'angolo a X25 Y25
    Richiesto come "60 mm, 2 cm a destra e in alto dal punto home": il punto home
    e X5 Y5, quindi l'angolo in basso a sinistra cade a X25 Y25 e il quadrato
    arriva a X85 Y85. Restano 166 mm di margine in X e 151 in Y sull'area utile.
    Generato con lo stesso Gcode.build dell'interfaccia, quindi le quote Z
    vengono dal profilo: alzata Z-18.326, foglio Z-21.271, tappo Z0.
    Nell'intestazione sta scritto di misurare i quattro lati uno per uno: sul
    quadrato da 50 mm i due lati in direzione negativa venivano corti e la causa
    non e' ancora accertata (il gioco nel profilo e' 0,30 mm, troppo poco per
    spiegarlo).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
2026-10-22 Ogni programma finisce al punto home, non sullo zero ai blocchi
    L'ultimo spostamento era G0 X0 Y0, cioe' esattamente il punto ai blocchi.
    Lasciare i carrelli appoggiati al riferimento e' proprio la cosa che il punto
    home esiste per evitare: il commento del profilo lo dice da sempre - "un
    carrello fermo contro il riferimento prima o poi lo sposta, e il riferimento
    e' la cosa che non deve muoversi" - ma il generatore non lo leggeva.
    - profile.js: puntoHome(), che restituisce una COPIA (scriverci non tocca il
    profilo) invece di far frugare i chiamanti in macchina().homing.
    - gcode.js: opt.ritorno, con 0,0 come valore di riserva per non cambiare il
    comportamento di chi non lo passa. L'intes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
2026-10-22 Quadrato da 60 con le diagonali, e niente piu righe di sola velocita
    Il quadrato da 60 mm e venuto perfetto, quindi il 50 storto era quasi
    certamente un errore nel digitare le righe a mano: stesso percorso, stessa
    meccanica, stesso verso. Motivo in piu per caricare il file.
    Nuovo gcode/quadrato-60-diagonali.gcode: il quadrato di prima piu le due
    diagonali. L'ordine dei tratti e scelto, non casuale - il perimetro finisce
    a 25,25, che e l'inizio della prima diagonale, quindi quella non costa
    nessuno spostamento. Le diagonali sono anche la prova di squadra: su un
    quadrato vero sono uguali (84,853 mm), e 1 mm di differenza vale circa 0,7
    gradi di fuori squadra. Sta scritto nell'intestazione del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
2026-10-22 "Upload filesystem inaccessible" vuol dire SD, e la SD non c'e
    Diagnosticato leggendo il sorgente invece che per tentativi. Il messaggio
    esce da un punto solo, uploadStart() in WebUI/WebUIServer.cpp, quando il
    costruttore di FluidPath mette un error_code - e quello succede solo nel
    ramo SD, su !config->_sdCard->config_ok. Per la flash locale quel
    costruttore non puo' fallire.
    Le due rotte sono separate: /files e' la flash, /upload e' la SD. Quindi
    l'upload era mandato al pannello SD, e con cs_pin: NO_PIN quel volume non
    esiste: il messaggio dice il vero.
    Registrato in A4.1 con le due cause (il pannello sbagliato, e un nome di
    file che comincia per /sd/, perche' canonPath rispetta il prefis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
2026-10-22 Caricare un programma sulla flash senza passare dal pannello dei file
    La flash e' montata anche in WebDAV - new WebDAV("/flash", LocalFS, true) -
    e PUT e' fra i metodi dell'header Allow. Quindi un curl -T scrive
    direttamente sul filesystem giusto, saltando del tutto il pannello che
    continuava a indirizzare l'upload sulla SD inesistente.
    Registrata in A4.1 insieme alla rotta /files (multipart, la stessa che usa
    il pannello FLASH), alla nota su curl.exe contro l'alias di PowerShell, e al
    fatto che un nome senza barra davanti e' corretto per i comandi $LocalFS/*
    perche' canonPath() ci mette davanti il prefisso del filesystem di default.
    Cl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
2026-10-22 Prova geometrica: il primo disegno vero della macchina
    Quadrato da 100 mm a X25 Y25 (il punto home piu 20 in X e in Y), cerchio
    inscritto, pentagono inscritto nel cerchio, diagonali del quadrato, apotemi
    del pentagono. 8 tratti, 119 punti, 3.624 byte, un minuto e mezzo.
    Ogni figura verifica qualcosa che le altre non possono:
    - le due diagonali uguali sono la prova di SQUADRA, e la differenza misura
    di quanto gli assi non sono perpendicolari;
    - il cerchio e l'interpolazione fra i due assi: ovale vuol dire scala
    diversa fra X e Y, a pera vuol dire accelerazione o gioco;
    - il pentagono da cinque obliqui con angoli diversi da 45 gradi, il caso che
    quadrato e diagonali non coprono;
    - i cin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
2026-10-22 Vortice di quadrati: una linea sola, e un test migliore della tavola
    Proposta alternativa alla prova geometrica, che all'utente non convinceva.
    Ogni quadrato ha i vertici al 10% dei lati del precedente: il lato si
    accorcia di 0,905539 e la figura ruota di 6,3402 gradi a ogni passo, da 150
    mm fino a 1,05 - 51 quadrati, 6,6 metri di tratto, 5 min 38 s.
    Non e' una scelta decorativa. Tre cose che la tavola geometrica non faceva:
    1. E' UNA LINEA SOLA. Il raccordo fra un quadrato e il successivo cade su un
    lato appena disegnato, quindi si fa a penna giu' ripassandoci sopra: la
    penna non si stacca mai. Quindi nessun blob di attacco, e la chiusura
    misura l'errore accumulato su tutto il pe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
2026-10-22 Il vortice si chiude con un cerchio invece dei quadrati piu piccoli
    Richiesta dell'utente, e il criterio non e' il gusto: fra due quadrati
    consecutivi la distanza fra i lati vale lato x (1 - rapporto) / 2, e sotto
    due larghezze di tratto (0,7 mm con una penna da 0,35) il bianco in mezzo
    sparisce e i tratti si impastano. Con f = 0,16 quel punto cade sui 10 mm di
    lato, da cui 18 quadrati: all'ultimo passo restano 0,76 mm, e un quadrato in
    piu' li porterebbe a 0,65.
    Li si smette e si disegna la circonferenza INSCRITTA nell'ultimo quadrato,
    raggio 5,24 mm, che lo tocca nei punti medi dei lati. Il cerchio non ha
    orientamento, quindi chiude la spirale invece di continuarla. Ci si entra dal
    punto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
2026-10-22 La prova del livello misura i punti alti, non quelli bassi
    Il primo disegno vero e' uscito, e ha fatto la prova 11 senza essere stato
    scritto per farla: nell'angolo in alto a sinistra alcuni tratti sono usciti
    spezzati. Causa trovata dall'operatore e gia' sistemata - il legno sotto al
    binario della staffa TT di sinistra si era alzato. Non alza la carta, alza il
    portale, quindi la punta si solleva rispetto al foglio: per la penna e'
    identico a un piano che scende.
    Il che mette in luce un lato cieco della prova 11, che va saputo prima di
    fidarsi della mappa. I trattini si disegnano a quote CRESCENTI sopra il
    contatto, quindi dove la carta e' piu' alta di e segnano tutti quelli fino a
    e e cont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
2026-10-23 Cornice dell'area utile, con la procedura della penna nel file
    Richiesta: un rettangolo alle misure massime per vedere l'area totale e
    controllare il pezzo di legno sistemato, col G-code che comprenda homing e
    inserimento della penna.
    Quello che si puo' mettere in un file ce l'ho messo; quello che non si puo'
    l'ho lasciato fuori e spiegato nell'intestazione.
    LA PENNA SI PUO': servono le mani, ma il file si ferma ad aspettarle. FluidNC
    mappa M0 su ProgramFlow::Paused - sincronizza il buffer e manda un feed hold,
    e si riparte col cycle start, cioe' `~`. Verificato nel sorgente, non
    supposto. Il file va al centro del foglio, scende alla quota di contatto, si
    ferma mentre infili e stringi, poi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
2026-10-23 Una pagina coi comandi che si usano davvero
    Scheda di riferimento: penna, punti notevoli, origine, jog, file, stato,
    e i comandi che si usano dentro un programma. Ogni riga e' comando piu'
    cosa fa, senza narrazione intorno.
    I numeri escono dal profilo macchina, non dalla memoria: quote Z dai quattro
    angoli del servo (tappo Z0, alzata Z-18.326, foglio Z-21.271, e la battuta a
    Z-23.889 che sta fuori dall'arco comandabile), centro dell'area utile a
    125.616 / 118.032, angoli a mezzo millimetro dentro i 251.232 x 236.064.
    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
2026-10-23 Rettangolo dal punto home, largo quanto si puo' e alto 190
    Richiesto: un rettangolo che parte dal punto home, va a destra fino al
    massimo possibile, sale di 19 cm e si richiude. Da X5 il bordo utile e'
    X250.5, lo stesso limite della cornice, quindi 245.5 x 190.
    Invece di scrivere un altro generatore ho reso generale cornice.js, che
    faceva solo la cornice piena dell'area utile: adesso prende --da x,y,
    --larghezza e --altezza, e la parola `max` chiede il massimo raggiungibile
    da dove si parte. Le diagonali diventano opzionali con --diagonali no, e
    quando non ci sono l'intestazione sposta l'attenzione sulla CHIUSURA, che
    per un rettangolo solo e' la misura che resta.
    L'intestazione adesso cal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
2026-10-23 Niente G21/G90 doppi quando non c'e' preambolo da eseguire
    Con --penna no --giro no il file usciva con G21 e G90 ripetuti due volte di
    fila: una dall'intestazione del tool e una da Gcode.build, che li riemette
    sempre in testa alla propria parte. Innocuo ma rumoroso, e la versione nuda
    serve proprio a essere battuta a mano. Ora l'intestazione li mette solo se
    c'e' davvero qualcosa da eseguire prima del disegno.
    Rigenerati cornice.gcode e rettangolo-home.gcode; 19 e 16 controlli
    rispettivamente, tutti passati.
    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
2026-10-23 L'area utile su X si accorcia di 10 mm: ostacolo meccanico, non taratura
    Trovato sulla macchina il 2026-10-23: sul lato destro il pignone del
    carrello tocca la cremagliera dell'asse Y PRIMA che il carrello arrivi in
    fondo. L'interferenza misurata e' 5 mm, se ne tolgono 10 per stare larghi
    finche' non e' rimisurata con calma.
    Il numero va in un campo SUO, `corse.<asse>.ostacolo`, non sommato al margine
    di sicurezza. Non e' pedanteria: il margine copre l'INCERTEZZA (ripetibilita'
    dell'appoggio, gioco) e si riduce diventando piu' precisi; l'ostacolo e' un
    impedimento MECCANICO CERTO e si toglie spostando la cremagliera di Y.
    Sommandoli, fra sei mesi non si saprebbe piu' quali millimetri sono
    r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
    [cnc2d-config.yaml]
2026-10-23 Il rettangolo torna con le diagonali: quattro numeri dallo stesso foglio
    La prossima prova e' la taratura del rapporto mm/giro, che non e' mai stata
    fatta: e' ancora il nominale 94,2478, un conto geometrico e non una misura, e
    scala ogni quota che la macchina disegna. Nessun comando puo' rivelarlo - il
    DRO legge passi diviso il rapporto, quindi e' d'accordo con se stesso anche
    quando il rapporto e' sbagliato.
    La campata lunga vale: 0,05 mm di lettura col calibro risolvono il rapporto
    allo 0,083% su 60 mm, allo 0,033% su 150, allo 0,021% sui 235,5 di questo
    rettangolo.
    Rimesse le diagonali (302,59), che costano un flag e danno la squadra sulla
    campata piu' lunga disponibile. Cosi' lo stesso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
2026-10-23 Due riempimenti per la cornice massima: spirografo e curva di Hilbert
    L'utente ha tagliato un foglio su misura (270 x 255) per disegnare alla
    massima estensione, e vuole qualcosa di piu' complesso dentro la cornice.
    Due candidati scelti perche' sono OPPOSTI, cosi' se uno esce male e l'altro
    bene la differenza dice qualcosa:
    - SPIROGRAFO (ipotrocoide): curve continue, raggio e curvatura che cambiano
    senza mai fermarsi. Mette alla prova l'interpolazione fra i due assi e la
    costanza del tratto in ogni direzione.
    - HILBERT: tutti segmenti dritti ad angolo retto, migliaia di inversioni di
    direzione. E' il caso peggiore per il GIOCO, che e' l'ultimo parametro del
    profilo mai misurato su q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
2026-10-23 Due medaglioni: spirografo a sinistra, rosa mistica a destra
    Richiesta: meta' curve, meta' geometrico con i vertici collegati, intorno ai
    cinque minuti. Le due figure non sono solo decorative, misurano due cose
    diverse e complementari.
    SPIROGRAFO. Curve che non si fermano mai: nessuna inversione brusca, raggio
    di curvatura che cambia di continuo. E' la figura che il gioco NON disturba,
    quindi quello che si vede li' e' la costanza del tratto e l'interpolazione
    fra i due assi, senza altro in mezzo.
    ROSA MISTICA. Nove vertici su un cerchio, tutti collegati fra loro: 36 corde.
    Su ogni vertice ne convergono otto, da otto direzioni diverse. Se il punto di
    arrivo dipende dalla direzione di arrivo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
2026-10-23 Un medaglione solo tagliato dal diametro, non due accostati
    Avevo capito male: l'utente voleva le due figure CONCATENATE, meta' di una
    collegata a meta' dell'altra, non due medaglioni separati nello stesso
    foglio. Rifatto come un cerchio unico diviso dal diametro verticale: a
    sinistra mezzo spirografo, a destra mezza rosa mistica, unite dal cerchio
    che le contiene e che si disegna per intero.
    Il taglio interpola ESATTAMENTE il punto di attraversamento invece di
    scartare il segmento a cavallo: altrimenti i due mezzi disegni non si
    toccherebbero sul diametro e il taglio si vedrebbe come una frangia.
    Le due meta' si leggono come meta' e non come pezzi perche' entrambe le
    figure sono simmetric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
2026-10-23 Rosone: una curva a nove lobi con le punte tutte collegate, in un tratto solo
    Avevo capito male due volte. Non due medaglioni accostati, e nemmeno un
    cerchio tagliato in due: un oggetto SOLO, in cui le corde nascono sulla
    curva invece di esserle appoggiate sopra.
    La costruzione lo garantisce invece di approssimarlo. In un ipotrocoide il
    raggio del punto vale (R-r)^2 + d^2 + 2d(R-r)cos((k+1)t), quindi ha
    esattamente k+1 massimi, e nei massimi il punto cade sul cerchio circoscritto
    ad angoli equispaziati - verificato numericamente prima di costruirci sopra:
    scarto 1e-14 sul raggio e 40,0000 gradi esatti fra le punte. Scegliendo
    R = n*r si ottengono n lobi le cui punte sono un poligono regolar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
2026-10-23 Trame che riempiono il campo: onde e reticolo triangolare
    Il rosone non convinceva; dalle immagini mandate si vedono due famiglie
    diverse da quello che stavo facendo - reticoli geometrici ripetuti e campi di
    linee ondulate - e nessuna delle due e' una figura al centro del foglio.
    ONDE. Una famiglia di linee parallele deformate da un campo liscio (somma di
    gobbe gaussiane di segno opposto, che e' quello che da la piega a S delle
    trame a tessuto). Si percorrono a BUSTROFEDICO, una a destra e la successiva
    a sinistra, e qui c'e' il punto non ovvio: il gioco non si vede, e non per
    fortuna. E' un'inversione lungo X mentre le linee CORRONO lungo X, quindi
    sposta solo dove la linea comincia e fini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
2026-10-23 Trifoglio: tre esagoni a spirale dentro un cerchio
    Dallo schizzo: non una trama ma una composizione di tre esagoni, con i
    vortici tondi, e i tratti che si concatenino con quelli degli esagoni.
    L'idea che tiene insieme le due cose e' che la spirale sia ESAGONALE. Stessa
    simmetria, stessi angoli, quindi non c'e' un esagono piu' una spirale dentro:
    c'e' un esagono che continua a girare stringendosi, un tratto solo dal bordo
    al centro, e le spire interne SONO le parti interne della figura. Avanza di
    60 gradi per lato, verificato.
    E si incastra col cerchio senza doverlo imporre: la spirale parte da un
    VERTICE, che per un esagono regolare sta sul cerchio circoscritto. Il vortice
    nasce sul suo ce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
2026-10-23 Intreccio: tre esagoni con la trama a bande, costruita invece che ricalcata
    Dall'immagine: tre esagoni che condividono un lato, e dentro ognuno una
    trama a bande con simmetria a tre vie. Quello che si vede e' una spirale
    esagonale a TRE PARTENZE disegnata come banda invece che come linea.
    Il passo radiale non e' scelto a occhio, ed e' il numero da cui dipende tutto:
    in un giro la spirale scende di 6*delta, e in quello spazio devono entrare
    tre bande coi loro vuoti, quindi delta = (banda + vuoto)/2. Con un delta
    diverso le bande si sovrappongono o lasciano vuoti irregolari e la trama non
    si legge piu'. La spirale e' ARCHIMEDEA e non logaritmica proprio per questo:
    serve il passo costante, se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
2026-10-23 Tre anelli esagonali intrecciati, col sopra-sotto calcolato
    Richiesta su una foto: tre esagoni intrecciati, piu' tre cerchi concentrici e
    tre esagoni piccoli dentro ognuno, piu' delle curve circoscritte che
    delimitano il disegno.
    Un plotter non ha un bianco con cui cancellare, quindi il sopra-sotto non si
    puo' fingere: dove un anello passa sotto un altro il suo contorno va TOLTO.
    Si spezza ogni segmento nelle intersezioni esatte coi bordi della fascia che
    gli passa sopra e si tengono i pezzi il cui punto di mezzo sta fuori. Niente
    campionamento: intersezioni segmento-segmento.
    L'intreccio e' borromeo - A sopra B, B sopra C, C sopra A - ed e' quello che
    lo rende un intreccio invece di una p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
2026-10-23 Gli ornamenti stanno sulla carta, non sull'anello: li copre ogni fascia
    L'utente ha cerchiato tre pezzi di linea che comparivano dentro le fasce
    centrali. Colorando ogni anello e rendendo l'ingrandimento si vede cosa
    sono: ornamenti - i cerchi e gli esagoni dei fori - rimasti visibili sopra
    una fascia che invece gli passa davanti.
    Il difetto era concettuale. Tagliavo gli ornamenti come se fossero parte
    dell'anello, quindi con UNO solo degli altri due: quello che nell'intreccio
    borromeo gli sta sopra. Ma gli ornamenti stanno sulla CARTA, dentro il foro,
    e il foro e' un buco: si vede quello che ci passa dietro. Quindi li copre
    qualunque fascia passi di li', tutte e due, non solo quella sopra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
2026-10-23 Documento di sessione v51: la macchina disegna, l'area si accorcia, due stampe muoiono
    Voce del 2026-10-23, la giornata in cui la correzione della Z e andata in
    produzione e la macchina ha fatto il suo primo disegno vero.
    Sette blocchi Sintomo/Causa/Fix, e l'ultimo e aperto: due stampe lunghe si
    bloccano a meta portandosi giu il server web. La causa e individuata nel
    sorgente - la casella comandi della WebUI crea un canale per ogni comando e
    $LocalFS/Run se lo tiene per tutta la durata del job - ma non e ne
    confermata ne risolta, quindi sta scritta come "Fix applicato: nessuno".
    Cinque decisioni, fra cui due che chiudono discussioni aperte da giorni: la
    taratura del rapporto mm/giro NON si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
2026-10-23 Documento v52: due correzioni alla voce di oggi, una delle quali cambia una conclusione
    Non era una sessione parallela. L'operatore ha riavvolto la conversazione
    per risparmiare token, perche' quei disegni non gli piacevano. Ma riavvolgere
    la conversazione non annulla i commit: trame.js, trifoglio.js, rosone.js e i
    loro gcode sono ancora in repository, ed e' lavoro scartato. Da decidere se
    tenerli o toglierli.
    E soprattutto: avevo scritto che il criterio dell'utente sul rapporto
    mm/giro ("sotto il millimetro mi va bene") era gia' soddisfatto, perche' un
    quadratino da 60 mm misurava 60,0. Ma la misura e' COL RIGHELLO, non col
    calibro: la lettura vale +-0,5 mm e non +-0,05, quindi il limite s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
2026-10-24 Documento v53: il blocco delle stampe lunghe e confermato, e il criterio del millimetro e dimostrato
    La prova della seriale ha risposto. L'intreccio, fermatosi due volte su due
    lanciato dalla WebUI, lanciato dalla seriale USB a scheda del browser chiusa
    e arrivato in fondo: sette minuti, nessun reset. Una variabile sola cambiata
    - stesso file, stessa macchina, stesso foglio, stessa origine - quindi la
    causa individuata nel sorgente (il canale HTTP che il job si tiene aperto per
    l'intera durata) passa da ipotesi a fatto. E una corsa sola, quindi una
    conferma forte e non una dimostrazione, e la voce lo dice.
    Ne esce un rimedio operativo da subito - i disegni lunghi si lanciano dalla
    seriale -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
2026-10-24 L'invio del programma esiste: WebSocket, una riga per volta, con il freno
    Il SLICER sapeva preparare un programma e non sapeva mandarlo: artwork.js
    arrivava in fondo alla procedura e dichiarava "l'invio non e ancora
    costruito". Adesso lo manda, e lo manda in un modo che non puo riprodurre il
    guasto di ieri notte.
    IL TRASPORTO CAMBIA. api.js parlava su /command?commandText=, una richiesta
    HTTP per riga. Su quella rotta FluidNC crea un canale nuovo per ogni
    richiesta, e un comando che dura - $LocalFS/Run dura quanto il disegno - se lo
    tiene aperto per tutto il tempo: e la causa confermata sulla macchina delle
    due stampe morte a meta. Al suo posto un WebSocket solo, persistente,
    registrato in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
2026-10-24 L'interfaccia pronta da installare, e perche deve chiamarsi index.html.gz
    firmware/fluidnc/index.html.gz: il SLICER compresso, 65.183 byte, accanto al
    config.yaml perche e la stessa categoria di cosa - un artefatto che si mette
    sulla macchina.
    Il nome non e una scelta. Il gestore generico di FluidNC
    (handle_not_found -> myStreamFile con download=true) serve qualunque file
    della flash ma con Content-Disposition: attachment, quindi una pagina messa
    li accanto con un nome suo verrebbe SCARICATA dal browser invece che aperta.
    L'unico percorso che il browser apre e la radice, che e index.html.gz. Non
    esiste una configurazione in cui le due interfacce convivono.
    Il README spiega il giro completo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
2026-10-24 Il tastierino: otto direzioni, le quote della penna al centro, e un punto da raggiungere scrivendolo
    Otto richieste dell'operatore, piu due cose trovate strada facendo.
    IL TASTIERINO E' QUADRATO PER COSTRUZIONE. Era schiacciato perche' le tre
    righe erano 1fr di un'altezza mai dichiarata, quindi si stringevano sul
    contenuto dei pulsanti. Ora aspect-ratio: 1 lega l'altezza alla larghezza
    qualunque sia lo spazio, con un tetto a 330px: nella tab dedicata lo spazio e'
    il doppio della barra laterale, e un tastierino da mezzo schermo si usa
    peggio, non meglio.
    Quattro diagonali in piu'. Una diagonale e' UN solo $J con X e Y insieme, non
    due comandi: due comandi separati fanno una L e si vede.
    AL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
2026-10-24 I fogli: quale e' in uso si vede, e quelli tagliati a mano si salvano
    1. QUALE FORMATO E' IN USO ORA SI VEDE DAVVERO. L'evidenziazione c'era gia',
    ma la classe is-active era scritta a mano su A5 nell'HTML: giusta all'avvio e
    sbagliata subito dopo, perche' nessuno la toglieva se il foglio arrivava da un
    profilo salvato. Ora markPreset() la decide dai dati e viene chiamata da
    apply(), cioe' a ogni cambio.
    E riconosce il foglio RUOTATO. Prima bastava premere "Ruota foglio" perche'
    nessun pulsante restasse acceso: setSize(h, w) confrontava 210x148 con i
    148x210 del markup e non trovava niente. Un A5 girato per il lungo e' sempre
    un A5, e spegnere il pulsante vuol dire dire all'operatore che non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
2026-10-24 Fogli piu' grandi della corsa: l'angolo puo' stare fuori, e si vede dove la penna arriva
    Caso d'uso dell'operatore: i fogli che si taglia a mano sono piu' grandi della
    campata della macchina (270 x 255 contro 241,2 x 236,1), quindi l'angolo in
    basso a sinistra del foglio deve stare PIU' A SINISTRA E PIU' IN BASSO dello
    zero. Era bloccato in tre punti diversi.
    1. I CAMPI NON ACCETTAVANO IL NEGATIVO: min="0" sui due input. Tolto, e le
    etichette non dicono piu' "Margine X" - con un valore negativo non e' un
    margine - ma "Angolo foglio X". La nota sotto spiega quando e perche' sono
    negativi.
    2. LA VISTA TAGLIAVA QUELLO CHE SPORGEVA. La viewBox era l'area di lavoro,
    quindi la parte di foglio fu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
2026-10-24 La rotella ingrandisce il piano, e il fondo si trascina per spostarsi
    Zoom ancorato al puntatore: quello che sta sotto il mouse ci resta. E' l'unico
    ingrandimento che non costringe a rincorrere il punto che si stava guardando.
    Due limiti per non perdersi: non si scende sotto i 20 mm di larghezza - piu' in
    la' non c'e' niente da vedere, un passo di motore sono tre centesimi - e non si
    va oltre il quadruplo della vista adattata.
    Lo zoom da solo pero' non basta, e il collaudo l'ha fatto vedere subito: da
    ingranditi si vuole anche spostarsi. Quindi:
    - trascinare il FONDO sposta lo sguardo;
    - trascinare il FOGLIO lo sposta come prima;
    - il TASTO CENTRALE sposta lo sguardo dovunque si prema.
    Il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
2026-10-24 La tavola e l'area di appoggio del foglio, disegnate attorno all'area di lavoro
    Tre rettangoli concentrici, e sono tre domande diverse che e' facile
    confondere: dove c'e' LEGNO, dove il FOGLIO si puo' posare, dove la PUNTA
    arriva. L'ultimo la macchina lo sa gia' - e' la corsa. I primi due no.
    700 x 600 vengono dal CAD e quelle sono buone: e' un pezzo di legno, le sue
    dimensioni non dipendono dal montaggio. La POSA della macchina sopra la tavola
    invece nel CAD e' quella di prima del montaggio, quindi `zeroX` e `zeroY` -
    dove cade lo zero macchina rispetto all'angolo in basso a sinistra della
    tavola - restano null finche' non sono misurati col metro. Finche' sono null
    non si disegna NIENTE: m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
2026-10-24 La tavola e' misurata: lo zero cade a 280,20, e il bordo inferiore e' una battuta
    Le due misure che mancavano sono arrivate: la punta portata al PUNTO HOME sta
    a 285 mm dal bordo sinistro della tavola e 25 dal basso. Il punto home e'
    X5 Y5, quindi lo zero macchina - che e' quello che serve qui - sta cinque
    millimetri piu' indietro su entrambi: zeroX 280, zeroY 20.
    Tornano anche le forchette calcolate prima di chiedere: zeroX doveva stare fra
    210 e 324 perche' l'area di lavoro cadesse dentro l'appoggio, zeroY fra 10 e
    174. Quindi anche la lettura delle due misure orizzontali era giusta
    (confermata dall'operatore: i 21 cm partono dal bordo sinistro).
    Ne esce la geometria vera: appoggio 355 x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
2026-10-24 Colonne laterali ridimensionabili, via il disegno finto, e il foglio nasce centrato
    VIA IL DISEGNO DI ESEMPIO. Il quadrato col cerchio era stato messo quando il
    piano era vuoto e non si capiva a cosa servisse. Adesso il piano ha tre
    rettangoli da guardare e quel disegno fa solo confusione: a colpo d'occhio
    sembra che ci sia qualcosa da stampare. Senza disegno caricato il percorso e'
    vuoto, e si vede che e' vuoto.
    SCEGLIERE UN FORMATO LO CENTRA sull'area di lavoro, che e' quello che si vuole
    nove volte su dieci. Scrivendo le misure a mano no: li' il foglio scapperebbe
    sotto le dita a ogni cifra battuta. Un foglio gia' misurato non si tocca,
    perche' la sua posizione e' una misura.
    LE DUE COL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
2026-10-24 Il pulsante Crea/Edit, la tab dell'editor, e l'elenco di dove trovare disegni
    Un pulsante solo con due mestieri: con un disegno caricato dice "Edit" e lo
    apre per modificarlo, senza disegno dice "Crea" e ne apre uno nuovo. Il gesto
    e' lo stesso ma la cosa che fa non lo e', quindi la scritta cambia.
    La tab dell'editor c'e' ma la tela no, e lo dice: preferisco una pagina che
    dichiara di essere vuota a una tela che non disegna. Dice anche con cosa ci si
    e' arrivati - nome del file e numero di tracciati - perche' quello lo sa gia'.
    L'elenco dei collegamenti, con Book of Shapes come primo. Si aggiungono
    incollando l'indirizzo e premendo +, si tolgono con la crocetta che compare
    passandoci sopra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
2026-10-24 Documento v54: il SLICER manda il programma e diventa l'interfaccia della macchina
    Il buco grosso del programma e' chiuso. L'invio del G-code esiste e passa da un
    WebSocket solo e persistente invece che da una richiesta HTTP per riga - che
    era la causa confermata del guasto di ieri, e che con 2500 righe avrebbe creato
    2500 canali. Il trasporto e' stato provato sull'ESP32 vero: collegamento, jog,
    homing, vai al punto. Resta non provato un programma intero.
    Scoperta che ha sbloccato lo sviluppo: i WebSocket non passano per il CORS e
    FluidNC non guarda l'header Origin, quindi la pagina parla con la macchina
    anche aperta dal disco. Installarla non e' piu' un prerequisito per provarla.
    Registra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
2026-10-25 L'importatore SVG non disegna piu lo sfondo e i riferimenti del file
    Caricando intreccio.svg comparivano due cornici quasi sovrapposte invece di
    una: oltre alla cornice del disegno veniva tracciato anche il rettangolo
    bianco di fondo del file, 242 x 237 contro i 240 x 235 della cornice vera.
    Stessa storia per il pallino rosso che segna il punto home. Tutti i nostri
    SVG se li portano dietro, e una penna non ha ne il bianco ne il rosso.
    Oltre alla cornice di troppo lo sfondo allargava il rettangolo di ingombro,
    che e il numero con cui toSheet decide la scala: il disegno vero usciva piu
    piccolo del dovuto.
    Il discrimine e il bordo, non il riempimento. Se nel file c'e almeno una
    forma col bord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
2026-10-25 Righelli attorno al piano e riquadro di modifica del disegno
    RIGHELLI. Due bande, in basso e a sinistra, con lo zero sullo ZERO MACCHINA
    — l'angolo dei blocchi — e non sull'angolo del foglio: il foglio si
    trascina, la vista si ingrandisce, i blocchi stanno dove sono. In alto a
    destra un contatore dice sempre dove sta il mouse in millimetri macchina, e
    due trattini lo seguono sui righelli.
    Sono un SVG a parte, sovrapposto al piano e misurato in PIXEL. Dentro al
    piano le unita sono millimetri, e li tacche e numeri si ingrandirebbero con
    la rotella: illeggibili da vicino, invisibili da lontano. Cosi invece il
    passo si dirada da solo quando ci si allontana, scegliendo fra 1, 2, 5, 10,
    20, 5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
2026-10-25 Documento v55: la prima stampa lanciata dall'app, e il disegno diventa un rettangolo
    Voce del 2026-10-25 con la stampa intera uscita dal SLICER (cornice 191,7 x
    187,7 misurata uguale alla previsione, movimento continuo), interruzione e
    pausa provate sulla macchina, due bug col pattern Sintomo/Causa/Fix — lo
    sfondo del file disegnato come se fosse un segno, e Shift che poteva solo
    ingrandire — e quattro decisioni con le alternative scartate.
    Misurata la latenza dell'interruzione sui segmenti veri dell'intreccio: 2 a
    6 secondi, il doppio o il triplo della stima data a voce prima della prova,
    e la correzione e scritta nella voce invece di lasciare in giro il numero
    ottimistico.
    Step 4 pas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
2026-10-25 Il disegno dei due pupazzetti, dai modelli 3D alle linee
    figli-sagome.py proietta i due modelli di fronte e ne ricava le linee.
    Non una silhouette: una sagoma piena, per una penna, e un contorno vuoto che
    non dice niente di com e fatto il soggetto. Si tiene per ogni cella la
    profondita minima — la superficie rivolta a chi guarda — e si tracciano le
    ISOIPSE di quella mappa, come le curve di livello di una carta. Il rilievo
    viene raccontato con le linee invece che con l ombra, che e l unica cosa che
    un plotter sa fare.
    La sagoma esce piena senza buchi perche il modello e una superficie chiusa:
    ogni raggio che entra deve uscire, quindi ogni punto interno e coperto da
    almeno un triangolo. S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
2026-10-25 Figli: figure piu grandi, logo piu piccolo, nomi invertiti e la riga GDC CNC 2D
    Figure da 130 a 146 mm, logo da 95 a 72 di larghezza, Riccardo a sinistra e
    Francesco a destra.
    Sotto a STUFF una riga «GDC CNC 2D» larga esattamente quanto il logo:
    l altezza delle lettere viene calcolata DALLA larghezza voluta, invertendo
    FontTratto.larghezza(), invece di cercarla a occhio. Cosi restano appaiati
    anche cambiando una delle due misure.
    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
2026-10-25 La pausa per il cambio penna: segnarla sull anteprima, e il Sender la onora
    Col cursore dell anteprima si mette un cambio penna al confine del tratto in
    cui ci si trova. I segni si vedono sul piano, l elenco sta sotto al cursore e
    ogni voce ci riporta sopra.
    SI FERMA SOLO AL CONFINE FRA DUE TRATTI, mai a meta di uno. Non e una
    limitazione ma la ragione per cui la ripresa e gratis: li il programma ha
    gia fatto alza, sposta, abbassa, quindi non c e nessuno stato da
    ricostruire — e cambiare penna con la punta appoggiata lascerebbe comunque
    una macchia.
    Il segno e un commento, «;PAUSA». La macchina non lo vede nemmeno: a
    riconoscerlo e il Sender. Quindi lo stesso file resta eseguibile da c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
2026-10-25 Otto maniglie, e il tasto destro taglia il disegno
    MANIGLIE. Alle quattro degli angoli si aggiungono i punti di mezzo dei lati,
    per deformare lungo un asse solo: prendendo un angolo e cercando di muoverlo
    dritto si sbaglia sempre di un pelo, e il disegno si schiaccia anche
    nell altro verso senza che si veda. Le otto nascono da un elenco solo, con
    fx e fy a 0, 0.5 o 1, dove 0.5 vuol dire «quest asse non si tocca».
    TAGLIO. Le stesse maniglie, col tasto destro, tagliano invece di deformare.
    Il ritaglio e un rettangolo A PARTE dentro a quello del disegno, non una
    modifica di quello: box dice quanto e GRANDE il disegno, il ritaglio quanto
    se ne VEDE. Tenendoli separati, ritirando indietro la s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
2026-10-25 Lo zero e il punto home segnati sul piano, e il pallino rosso smette di fingersi lo zero
    Sul piano compaiono due segni distinti: un cerchietto sullo ZERO — l angolo
    ai blocchi, da cui si misura tutto e dove si azzera col G92 — e una casetta
    sul PUNTO HOME, cinque millimetri dentro, dove la macchina va a riposo a fine
    programma, dopo un interruzione e dopo un cambio penna. Averli tutti e due
    serve a vedere di quanto il foglio e spostato rispetto all uno e all altro,
    che a occhio sono cinque millimetri e si confondono.
    Sono indicazioni e non disegno, quindi restano della stessa taglia sullo
    schermo a qualsiasi ingrandimento: si ridisegnano sull evento «vista», come i
    righelli e le manig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
2026-10-25 I livelli: piu SVG sullo stesso foglio, in ordine, con i cambi penna
    NON C E PIU UN DISEGNO, C E UN ELENCO DI LIVELLI. Ogni file caricato e un
    livello con la sua collocazione, rotazione e ritaglio; e soprattutto e
    l unita con cui si ragiona di penne: un livello si disegna tutto di fila, e
    fra uno e l altro ci si puo fermare a cambiare penna.
    L elenco e nella colonna di sinistra: l ordine e la sequenza della stampa, si
    riordina con le frecce, si nasconde con l occhio, si toglie con la croce. Il
    livello scelto e quello su cui agiscono scala, rotazione e le maniglie sul
    piano. Trascinando piu file insieme si caricano tutti.
    L OTTIMIZZAZIONE HA TRE AMBITI (profilo di stampa, predefinito «per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
2026-10-25 Le curve restano curve: il modello di tracciato sotto all editor
    PRIMA SI APPIATTIVA SUBITO. L importatore campionava ogni forma con
    getPointAtLength e teneva solo le polilinee: esatte, comode e definitive.
    Definitive e il problema — da una polilinea non si risale alla curva che l ha
    prodotta, quindi su un disegno importato non c era niente da afferrare per
    farlo curvare. Era la precondizione dell editor, scritta nel documento da due
    giorni.
    ADESSO SI LEGGE PER DAVVERO. svgpath.js legge l attributo `d` comando per
    comando — M L H V C S Q T A Z, assoluti e relativi — e ne escono nodi con le
    loro maniglie. Le quadratiche diventano cubiche con una conversione esatta
    (le maniglie a due te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
2026-10-25 L editor: nodi, maniglie, e gli strumenti per creare
    La tab Editor non e piu una pagina di scuse. Lavora sulle FORME del livello
    scelto — nodi e maniglie, non polilinee — e ogni modifica rifa le polilinee e
    il percorso sul foglio.
    Sei strumenti: Scegli, Linea, Rettangolo, Cerchio, Testo, Taglia. Nello
    Scegli si trascinano nodi e maniglie, il doppio clic su un nodo lo porta da
    spigolo a curva e viceversa, il doppio clic su un tratto ci aggiunge un nodo,
    Canc toglie il nodo o il tratto intero. Il testo resta un TESTO: la parola si
    puo ancora leggere e cambiare, invece di diventare un mucchio di segmenti.
    LA Y VA IN GIU, come in un file SVG e come la mostra un browser. Sul piano va
    in su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
2026-10-25 Magneti e annulla nell editor
    I MAGNETI, tre aiuti in quest ordine di forza:
    1. un NODO vicino: ci si va sopra esatto, perche due punti che devono
    coincidere o coincidono o no, e «quasi» non serve a niente;
    2. l ANGOLO rispetto al punto da cui si sta tirando: entro sei gradi da un
    multiplo di 45 si raddrizza. E il caso chiesto — una linea quasi
    orizzontale resta storta per sempre, e sul foglio si vede;
    3. l ALLINEAMENTO in x o in y a un altro nodo, per mettere due cose sulla
    stessa retta senza misurare.
    L angolo e l allineamento non si sommano: l angolo fissa gia il punto lungo
    una retta, e stringerlo anche sull altro asse lo porterebbe dove nessuno dei
    due aiuti lo voleva.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
2026-10-25 Documento v56: i livelli, l editor, e la pagina che resta sul PC
    Voce del 2026-10-25 sera con i nove commit della giornata: il disegno dei
    figli dai modelli 3D, la pausa per il cambio penna, le otto maniglie col
    taglio, lo zero e il punto home sul piano, i livelli, il modello di tracciato
    che tiene le curve, l editor, magneti e annulla.
    Sei bug col pattern Sintomo/Causa/Fix, fra cui due che solo un collaudo
    poteva trovare: il suggerimento che allungava la didascalia, rimpiccioliva il
    piano e spostava di cinquanta millimetri il punto letto sotto il cursore; e
    il doppio clic che non arrivava mai perche il browser lo emette solo se i due
    clic hanno lo stesso bersaglio, e la tela si ridisegna i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
2026-10-26 I quattro punti notevoli sul tastierino, e tre cose all editor
    TASTIERINO. Il centro passa da due colonne a tre: a sinistra quattro
    pulsanti nuovi che portano la penna dove serve guardare — il punto home
    e tre angoli del foglio —, in mezzo le tre quote, a destra le frecce da
    un grado con lo STOP. L angolo in basso a sinistra non c e apposta: e
    la battuta contro cui il foglio si appoggia, e partendo da li e girando
    in tondo tre click dicono se il foglio sta dove la pagina lo disegna.
    I due posti in alto restano liberi, spenti.
    La penna si ALZA prima di partire: un traverso da duecento millimetri
    con la punta appoggiata lascia una riga dritta in mezzo al disegno.
    Stessi controlli di «Vai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
2026-10-26 Un livello per tinta, e il tastierino rifatto a caselle quadrate
    L IMPORTATORE NON BUTTA PIU LE FORME PIENE. La regola vecchia diceva: se
    nel file c e almeno una forma col bordo, il disegno e fatto di linee e
    ogni forma senza bordo e decorazione. Risolveva il caso vero dei
    riferimenti colorati, ma l ha smontata un disegno isometrico di cubi, in
    cui le facce in alto e di lato hanno il contorno disegnato e quella di
    sinistra no, e un poligono pieno: diciannove facce senza spigoli, cubi a
    cui mancavano due lati per uno.
    Adesso si butta solo lo sfondo, cioe la forma senza bordo che copre
    tutta la tela. Tutto il resto entra, diviso per TINTA: ogni bordo di un
    colore e ogni riempimento di un colo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
2026-10-26 L elenco dei livelli rifatto, e il riquadro che lavora su piu livelli
    I SEGNI SONO DISEGNATI, NON SCRITTI. Un pallino pieno e uno vuoto non
    dicono «visibile»: lo dicono solo a chi lo sa gia. Adesso c e un occhio,
    e un occhio sbarrato per il contrario. Le due freccette dell ordine
    sono diventate tre lineette da prendere e trascinare, e mentre si
    trascina l ordine cambia DAVVERO — le altre righe si spostano sotto il
    dito, e si lascia dove si vede. Il ricalcolo dei disegni avviene una
    volta sola, al rilascio: a ogni pixel impasterebbe la pagina.
    Il cambio penna si clicca dal simbolo sulla riga, non piu da una spunta
    sotto ai campi, lontana dalla riga di cui parlava.
    LA SELEZIONE E' MULTIP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
2026-10-26 Il file unico rigenerato, con dentro il disegno di esempio
    build.py toglieva sempre sample.js: sulla memoria dell ESP32 erano
    kilobyte spesi per un logo. Il 26 ottobre si e deciso che la pagina
    resta sul PC — installarla sulla scheda non renderebbe comunque la
    stampa indipendente dal computer, visto che il trasporto e lo stesso
    WebSocket — e con quella decisione e caduto il tetto dei kilobyte.
    Adesso l esempio c e, e chi dovesse rimettere la pagina sulla scheda usa
    --leggero.
    dist/cnc2d-ui.html e il documento completo, 506 kB; il .gz resta quello
    leggero, per la scheda.
    Collaudo: dist-test.js, 10 prove sul file unico invece che sui file
    separati — si apre, i cinque punti del tastieri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
2026-10-26 Il tastierino rifatto a quadrati concentrici
    Cinque colonne per cinque righe di caselle quadrate, e dentro, al centro
    esatto, un quadrato di tre per tre con lo stesso passo e lo stesso
    vuoto: righe e colonne del blocco di mezzo cadono su quelle del giro,
    quindi le cornici sono concentriche per costruzione e non per
    aggiustamento.
    Prima era cinque per sei. Il blocco di mezzo aveva quattro righe perche
    ci stavano dentro anche i quattro angoli del foglio, e l insieme veniva
    piu alto che largo: le cornici non erano ne quadrate ne concentriche.
    I QUATTRO ANGOLI DEL FOGLIO SONO ANDATI SUL GIRO, nelle caselle di mezzo
    delle fasce di sinistra e di destra, ognuno dalla parte sua: quello dell
    angolo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
2026-10-26 Documento v57: un livello per tinta, l elenco comandabile, i quadrati concentrici
    Voce del 2026-10-26 con cinque blocchi Sintomo/Causa/Fix (le facce dei
    cubi perse dalla regola del bordo, Shift+clic contato come doppio clic,
    scalaMm a zero sul primo tratto orizzontale, la colonna del tastierino
    gonfiata dal min-content, la rotazione che azzerava la collocazione),
    sette decisioni con le alternative scartate, e i numeri misurati.
    La decisione sul livello per tinta supera quella del 25 ottobre: la
    regola del bordo resta come default — le tinte piene nascono spente — ma
    non e piu un filtro distruttivo.
    Step 4: Stato riscritto e otto note appese.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
2026-10-26 Il cambio penna e finito: si rimisura la quota, e le Z che restano si spostano
    Il buco: Sender.riprendi(), dopo un ;PAUSA, ricominciava ad alimentare e
    basta, e il G-code che resta porta la Z della penna VECCHIA. La quota di
    contatto non sta nel profilo — e State.data.altezzaContatto, misurata a
    ogni stampa col secondo popup — e il generatore la scrive dentro al file
    come Z assoluta. La penna nuova si infila finche tocca il foglio e si
    stringe li, quindi sporge diversamente: mezzo millimetro in piu preme
    dentro la carta, mezzo in meno disegna per aria. Meta disegno, e te ne
    accorgi a foglio finito.
    Riguarda SOLO la Z: la penna torna nella stessa sede a V, X e Y non si
    spostano.
    Adesso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
2026-10-26 Il cambio penna e la procedura che aveva in mente l utente: due passi
    Supera il montaggio di mezz ora fa, che faceva il contrario: rimisurava
    dove toccava la penna nuova e spostava di quella differenza tutte le
    quote delle righe che restavano. Funzionava, ed era venticinque righe di
    aritmetica messe a rimediare un gesto che si puo semplicemente fare
    bene.
    Adesso E LA PENNA CHE SI ADATTA AL PROGRAMMA:
    1. il disegno arriva al segno, la penna sale al tappo, la testina va al
    punto home — gia cosi
    2. primo passo: «togli la penna». Il servo e in alto, dove c e piu
    spazio per sfilarla
    3. premendo il pulsante il servo SCENDE ALLA QUOTA DI CONTATTO DEL
    PROGRAMMA e ci resta
    4. secondo p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
2026-10-26 L editor sceglie il singolo tratto, e ha i suoi livelli
    Due cose trovate usandolo davvero, tutte e due segnalate dall utente.
    IL CLIC PRENDEVA LA POLILINEA INTERA. Per levare uno spigolo bisognava
    infilargli dei nodi col doppio clic e cancellarli uno a uno. Adesso la
    selezione ha un gradino in piu: primo clic la forma, secondo clic sulla
    stessa forma il TRATTO sotto al puntatore, che si evidenzia in giallo.
    Canc toglie quello che e scelto — il tratto, o il nodo, o le forme — e
    un chiuso si apre li, un aperto si spezza in due.
    Il secondo clic si decide al RILASCIO e solo se non ci si e mossi:
    premere su una forma gia scelta e tirarla e un gesto normale, e
    assomiglia all inizio di questo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
2026-10-26 Ctrl prende i tratti e li somma: dieci linee, un Canc solo
    Due tasti, due gradini, e nessuno dei due che indovina quale volevi:
    SHIFT resta sulle FORME, CTRL (o Cmd) prende i TRATTI e li accumula.
    Il clic semplice su una forma gia scelta continua a prendere quel tratto
    e solo quello.
    Canc toglie tutto il mucchio in una volta, ed e un gesto solo per l
    annulla. Non e togliere n volte un tratto: togliendo il primo i
    sotto-tracciati si spezzano e si rinumerano, e il secondo indice non
    punterebbe piu dove puntava. Si lavora per sotto-tracciato,
    ricostruendolo da capo coi soli pezzi continui che avanzano; su un
    tracciato chiuso il giro riparte dal primo tratto tolto, cosi i pezzi
    vengono interi i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
2026-10-26 Quattro cose trovate ripulendo un disegno vero
    Tutte segnalate dall utente usando l editor su centinaia di segmenti, e
    tutte e quattro dello stesso genere: il programma indovinava al posto
    suo.
    1. IL CLIC PRENDE IL TRATTO, non la polilinea. Prima prendeva la forma
    intera e per scendere al tratto ci voleva un secondo clic. Su un
    disegno importato una forma e spesso il contorno di una faccia —
    quattro spigoli in un elemento solo — quindi il primo clic accendeva
    quattro linee quando se ne voleva una, e il gradino in piu era un
    gesto da fare centinaia di volte. Adesso il gradino fine e il
    predefinito: Shift prende le forme intere, il rettangolo pure.
    Un gruppo gia scelt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
2026-10-27 Il numero di versione della pagina, accanto al titolo
    E quante volte la pagina e cambiata: i commit che hanno toccato webui/.
    Oggi fanno 70, questo compreso.
    NON SI INCREMENTA A MANO, SI CONTA. tools/versione.py legge la storia
    del repository e scrive js/versione.js; build.py lo chiama a ogni
    compilazione, e build.py gira sempre prima di consegnare la pagina — il
    numero quindi non dipende da nessuno che si ricordi di aggiornarlo. Un
    numero scritto a mano prima o poi non viene aggiornato, e allora e
    peggio di non averlo: dice una cosa falsa invece di non dire niente.
    Si conta il passato PIU UNO, perche lo si chiama prima di fare il commit
    e quel commit e proprio quello che si sta per cons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
2026-10-27 Due fronti nuovi: il logo della macchina e i cavi fuori dal piano
    LOGO. Tre varianti di CNC 2D costruite sull alfabeto del logo GDC Stuff,
    col generatore che le produce da misure e non da scelte a occhio
    (logo/cnc2d.js). I contorni sono quelli veri di Jost Bold, letti dal
    TTF.
    Misurando il logo esistente e venuto fuori che le sue tre lettere NON
    sono un alfabeto coerente: la G ha l asta a 0,257 dell altezza
    maiuscola, la C a 0,181. Quello che le tiene insieme sono tre modi di
    interrompere la forma, e quelli si portano su altre lettere: la C
    spezzata (un vuoto di un terzo della lettera, e si legge lo stesso:
    chiusura), la D piena senza occhiello (figura-sfondo), la D piu bassa
    delle maiuscol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
2026-10-27 Documento v58: il cambio penna senza aritmetica, l editor sul singolo tratto, il logo e i cavi
    Due step nuovi, i primi che non riguardano ne il moto ne il disegno:
    Step 7 (logo e identita visiva) e Step 8 (cavi, box, alloggiamenti).
    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
2026-10-27 Cinque cose trovate stampando sul serio
    I quattro angoli del foglio portano all angolo della parte che la penna
    raggiunge, non a quello della carta: col foglio piu grande della campata
    - la configurazione vera di questa macchina - quello sta fuori, e un
    pulsante spento non dice niente. Dentro al rettangolino i due numeri
    adesso hanno il nome dell asse.
    Le frecce del tastierino si spengono quando il passo scelto porterebbe
    oltre il confine: senza finecorsa, oltre non c e niente che fermi il
    carrello e il pignone esce dalla cremagliera. Il controllo c era gia su
    Vai al punto, e mancava dove al confine ci si arriva un click alla volta.
    I tratti doppi non arrivano alla penna. Due facce adiacen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
2026-10-28 I quattro pulsanti sono i punti limite della corsa, non gli angoli del foglio
    Servono a vedere DOVE ARRIVA LA MACCHINA, e la macchina arriva dove
    arriva anche quando sul piano non c e nessun foglio: spostare la carta
    non li muove piu di un millimetro. A cambiarli e la corsa, cioe il
    profilo.
    Ci si ferma un millimetro dentro al fine corsa, su tutti e quattro i
    lati: il basso a sinistra e 1,1 e non 0,0. Quel confine e il punto in
    cui il pignone arriva in fondo alla cremagliera, e qui non c e nessun
    finecorsa che lo fermi. Un millimetro sono trentaquattro passi di
    motore: abbastanza da non arrivarci per arrotondamento, abbastanza poco
    da non togliere area che serva.
    Lo stesso bordo vale per l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
2026-10-28 Taglia, copia e incolla fra livelli, senza spostare niente sul foglio
    Serve a rimettere una linea nel LIVELLO giusto. L importazione divide per
    tinta, e la tinta e il modo in cui chi ha fatto il file ha detto cosa va
    insieme - ma non sempre e il modo in cui lo si vuole disegnare: le facce
    di sinistra di un cubo possono finire coi contorni, e li sono una penna
    sola quando ne volevi due. Si sceglie, si taglia, si cambia livello, si
    incolla: sul foglio non si muove niente, cambia solo la penna.
    Ctrl+X, Ctrl+C, Ctrl+V, piu i tre pulsanti nella barra. Lo strumento che
    divide un tratto in due si chiama adesso Spezza: due Taglia nella stessa
    barra sarebbero stati due comandi diversi con lo stesso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
2026-10-28 Lo schermo tondo: la grafica disegnata prima di comprare un filo
    Un GC9A01 da 240x240 su 32,4 mm di vetro: 0,135 mm per pixel, e nel tondo
    ci stanno un simbolo, un numero e due parole. schermo/mock.html mostra
    tutte le schermate ingrandite E a grandezza vera, perche una grafica che
    funziona solo nel riquadro grande non funziona.
    Otto schermate, che sono gli stati che il Sender gia dichiara piu i due
    passi del cambio penna: pronta, in stampa, in pausa, togli la penna,
    monta la nuova, finita, ferma, in attesa del SLICER.
    L anello e la percentuale di RIGHE e non di tempo, e il tempo stimato
    compare solo quando il Sender ne ha misurato abbastanza - sotto le venti
    righe tace, e qui al suo posto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
2026-10-28 Non uno schermo: un telecomando. Il carrier al posto del GC9A01
    L utente ha gia in casa un MKR IoT Carrier Rev2 con un MKR WiFi 1010:
    display tondo in mezzo, CINQUE TASTI capacitivi intorno, cinque LED e la
    18650 dietro. Cambia la natura della cosa - la procedura del cambio
    penna si fa alla macchina, con le mani sulla penna, e finora per premere
    «riprendi» bisognava tornare al portatile. Adesso si chiude li.
    E niente fili: non sta sul coperchio del box, sta dove vuoi tu. Cade
    anche il problema dei cinque fili SPI che attraversavano il box fino al
    coperchio accanto ai cavi dei motori.
    Il canale e uno solo e in due versi: il SLICER manda lo stato con un
    POST e la risposta riporta il tasto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
2026-10-28 Lo stop si conferma due volte, e si vede quanto manca
    Primo tocco: non ferma niente, chiede. L anello diventa un conto alla
    rovescia rosso che si svuota - se non rispondi la domanda se ne va da
    sola - e va al contrario di come andava un attimo prima, quindi non lo
    si scambia per l avanzamento. Gli altri tasti si spengono, tranne un
    ANNULLA esplicito: una domanda che si puo solo aspettare che scada e
    una domanda scritta male.
    Secondo tocco, tenuto: uno spicchio si riempie in un secondo al centro
    del vetro, e solo da pieno la stampa si ferma. Mollando prima non
    succede niente, e il dito ha visto quanto mancava per tutto il tempo.
    Lo spicchio e un oggetto diverso dall anello apposta: l anello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
2026-10-28 I numeri del carrier dal datasheet, e il cicalino che non sapevo di avere
    Il vetro e 1,3 pollici tondi, 240 x 240, modulo 36 x 40 mm: 0,1376 mm
    per pixel. L ipotesi prudente da cui si era partiti era quella giusta,
    quindi la grafica non si tocca. Cinque tasti qTouch e cinque LED APA102
    confermati. Libreria Arduino_MKRIoTCarrier 2.0.0 o successiva, che il
    datasheet dichiara come requisito e non come consiglio.
    C E UN CICALINO, e cambia la cosa piu importante. Il telecomando esiste
    per sapere che e il momento del cambio penna: uno schermo lo dice a chi
    lo sta guardando, un beep lo dice a chi non lo sta guardando, che e il
    caso vero - una stampa dura venti minuti e nessuno la fissa.
    E c e la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
2026-10-28 Un suono anche a fine stampa, e la pila del telecomando
    Tre suoni diversi: due note alte e corte al cambio penna, tre che
    scendono a fine stampa, tre basse all errore. Il punto e capire cosa e
    successo SENZA guardare, quindi tre disegni diversi. E uno solo si
    ripete - il cambio penna ogni 20 s finche non premi - perche e l unico
    in cui la macchina sta aspettando te: un suono che squilla una volta
    sola la lascia ferma un ora se eri in un altra stanza. Gli altri due
    raccontano una cosa gia successa, e insistere sarebbe insistere su
    niente.
    La pila sul telecomando sta SEMPRE sulla schermata Pronta, che e quella
    che hai davanti quando lo prendi in mano, e sotto al 20% dappertutto in
    rosso, perc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
2026-10-28 La micro SD diventa il libro di bordo della macchina
    Non serve a stampare dalla SD, ed e la prima idea che viene in mente
    quindi va scritta come scartata: romperebbe la regola che il telecomando
    non parla con FluidNC, rifarebbe col SAMD21 il guasto del canale lungo
    gia diagnosticato il 2026-10-23, e comunque non e la memoria a legare la
    stampa al portatile - e il fatto che il programma si rigenera dopo i tre
    popup con le misure di quel giorno su quel foglio. Il G-code di ieri non
    vale oggi, e metterlo su una SD non lo fa valere.
    Serve al REGISTRO DELLE STAMPE, che oggi vive nella pagina e muore con
    lei. Una riga per stampa in CSV: data, nome, righe, durata, cambi penna,
    esito. La data la ma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
2026-10-28 La SD rimette in gioco il SLICER servito dalla macchina
    Il 26 ottobre la pagina era stata tolta dall ESP32 per un motivo solo:
    non ci stava. Dopo FluidNC e la sua WebUI restano 64 kB liberi e la
    pagina ne pesa 583, 172 compressa. Con quella decisione pero si e persa
    una cosa comoda: un indirizzo solo, sempre aggiornato, che qualunque
    dispositivo apre. La SD del telecomando la rimette in gioco senza
    toccare la macchina.
    LA REGOLA NON SI ROMPE, ed e il punto: servire un file non e comandare
    una macchina. Il telecomando consegna dei byte; una volta caricata, la
    pagina parla con FluidNC come ha sempre fatto, dal browser. Anzi, ne
    viene una semplificazione: servita da li la pagina e nella stessa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
2026-10-28 Il lato SLICER del telecomando: manda lo stato, riceve i tasti
    Il telecomando non puo andarsi a prendere i dati, perche nella macchina
    non ci sono: la stampa non e un file che l ESP32 esegue, e il browser
    che manda una riga alla volta e conta gli ok. Percentuale, tempo
    rimanente, cambi penna ed errori vivono in State.data.stampa e da
    nessun altra parte. Quindi si fanno arrivare.
    Un canale solo, in due versi: POST con lo stato, e la risposta riporta
    il tasto premuto e la carica. Il telecomando non comincia mai lui una
    conversazione, non conosce l indirizzo della macchina e non ci parla -
    la regola «non comanda FluidNC» non e disciplina, e struttura.
    I TASTI NON REIMPLEMENTANO NIENTE: entr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
2026-10-29 Documento v59: quattro difetti trovati stampando, il lavoro che si salva, e il telecomando
    Nuovo Step 9 - Il telecomando della macchina, in corso e gia a meta: il
    lato SLICER c e e gira, il firmware no. E il primo step che non riguarda
    ne il moto, ne il disegno, ne la macchina come oggetto: riguarda come si
    sta vicino alla macchina mentre lavora.
    Sei blocchi Sintomo/Causa/Fix: i pulsanti degli angoli spenti per sempre
    col foglio piu grande della campata, le frecce che potevano far uscire
    il pignone dalla cremagliera, gli spigoli ripassati due volte dalla
    penna, il popup del cambio penna che non si apriva da se, il tratto
    incollato che rientrava lungo 50 mm invece di 136, e cento messaggi in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
2026-10-29 Telecomando: i numeri dei pad, come suona il cicalino, cos'e' la retroilluminazione
    Gli schemi Altium del carrier (sheet MKR, DISPLAY, CAPACITIVE_SENSOR,
    BUZZER e il PcbDoc) chiudono tre cose che erano aperte o sbagliate.
    1. La corrispondenza numero <-> posizione dei pad, che il README dava per
    "si vede premendoli". Sta nel rame: dal pad una resistenza da zero ohm
    al piedino analogico (R33 -> A5, R34 -> A1, R35 -> A2, R36 -> A3,
    R37 -> A4), e i poligoni di rame dicono dove sta ciascuno. TOUCH2 e'
    il pad in alto; 1 e 0 scendono da una parte, 3 e 4 dall'altra. Restano
    a 60 gradi uno dall'altro, non a 72: cinque posti su sei, il vuoto in
    basso. Il mock disegnava 72 e ora dise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
2026-10-29 Telecomando: i quattro suoni si sentono nel mock, e le parole non si pestano piu'
    I SUONI. Quattro invece di tre: partenza e fine diventano motivetti,
    cambio penna e problema restano una nota sola. La differenza non e'
    estetica -- i due allarmi devono arrivare dall'altra stanza, quindi
    stanno sulla nota della risonanza (dove il trasduttore e' piu' forte) e
    si distinguono per il ritmo, che regge anche attutito da una porta;
    partenza e fine le senti da vicino e possono permettersi delle note. La
    fine attacca comunque sulla nota piu' forte.
    Tutte le note stanno fra A7 e D8 (3,5-4,7 kHz), l'ottava in cui
    l'ABT-461 parla. La prova nel mock le fa passare per un passa-banda
    centrato sulla risonanz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
2026-10-29 Documento v60: terzo fronte (stampe), Step 10 magneti della lavagna
    Claude-Session: https://claude.ai/code/session_01HsrMVEs2DPWyYReBiKT3CC
2026-10-29 Il colore della penna viaggia dentro al programma
    Era l'ultimo buco del protocollo del telecomando: la schermata del
    cambio penna mostra un pallino che dice QUALE penna montare, e quel dato
    non usciva da nessuna parte. Il SLICER lo sapeva -- e' la tinta del
    livello -- ma lo teneva in pagina.
    Non bastava spedirlo. Un programma salvato e riaperto un altro giorno
    non si portava dietro niente, e il cambio penna sarebbe tornato a
    "guarda l'elenco dei livelli e conta". Quindi il colore sta DENTRO al
    G-code, in un commento ";PENNA <colore> <nome del livello>" che il
    generatore scrive all'inizio di ogni livello e che il Sender legge come
    legge gia' ";PAUSA". Per la macchina e' un commento: il file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
2026-10-29 Documento v61: il telecomando dal 28 a oggi (fronte meccanica/firmware)
    Le modifiche a schermo/ non erano registrate: lo segnala la sessione del
    fronte (stampe), e ha ragione.
    Step 9 - stato aggiornato (manca solo il firmware, e non e' compilabile
    da dentro la sessione: downloads.arduino.cc e' bloccato come lo era
    docs.arduino.cc). Riscritta la decisione sui suoni: quattro invece di
    tre, divisi in due allarmi su una nota sola e due motivetti, perche' il
    cicalino e' un trasduttore a comando esterno con una risonanza - supera
    la decisione del 2026-10-28, che era scritta per un oggetto diverso.
    Sei note nuove: gli schemi Altium, il cicalino, la retroilluminazione a
    innalzamento, la batteria ch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
2026-10-29 Il firmware del telecomando, scritto contro l'API vera
    telecomando/telecomando.ino, un file solo: WiFi, server HTTP, le dieci
    schermate, i cinque tasti, i quattro suoni, la retroilluminazione, la
    carica e il libro di bordo sulla SD.
    L'API non e' ricordata: i sorgenti della libreria arrivano da GitHub
    (arduino-libraries/Arduino_MKRIoTCarrier 2.1.0), che il proxy serve
    anche se downloads.arduino.cc no. Leggerli ha cambiato tre cose.
    1. carrier.begin() torna false se UN SENSORE QUALSIASI non risponde.
    Al telecomando i sensori non servono: un telecomando che non parte
    per via del sensore di qualita' dell'aria sarebbe una sciocchezza.
    2. Il preflight del CORS non e' una riga: prima di un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
2026-10-29 Documento v62: nota di Step 9, il firmware e' scritto
    Nota sola, in fondo allo Step 9 (fronte meccanica/firmware): la voce di
    storico per il firmware si scrivera' quando sara' caricato e provato,
    che e' il momento in cui si sapra' davvero com'e' andata.
    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
2026-10-29 Firmware: i tipi vanno in cima, perche' l'IDE infila li' i prototipi
    Primo errore vero del compilatore di Arduino, e non e' un errore di
    codice: l'IDE non compila il .ino com'e' scritto. Cerca tutte le
    funzioni, ne genera i prototipi e li infila PRIMA DELLA PRIMA FUNZIONE
    del file. I tipi che stavano piu' in basso -- Schermata, Posto, Tasto,
    Nota -- venivano nominati da quei prototipi quando ancora non
    esistevano, e il compilatore si fermava su righe che a guardarle
    sembrano giuste.
    Adesso tipi e variabili stanno tutti sopra la prima funzione, che e'
    vivo(), con scritto perche'.
    Il controllo con g++ non poteva prenderlo: g++ i prototipi non se li
    inventa. Adesso se li inventa anche lui --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
    [telecomando.ino]
2026-10-29 La prova in bianco: il telecomando recita una stampa senza la macchina
    Impostazioni -> "Prova in bianco", accanto all'indirizzo. Il SLICER
    recita una stampa intera: pronta ma da azzerare, pronta, in stampa con
    la penna nera, cambio penna in due passi con la penna rossa, di nuovo in
    stampa, finita, errore. In fondo SMETTE DI CHIAMARE, perche' "senza
    SLICER" e' l'unica schermata che non si prova mandando qualcosa.
    Serve a collaudare il telecomando appena montato: dieci schermate,
    quattro suoni, cinque tasti e cinque LED in un minuto, invece che in
    venti minuti di stampa vera e un foglio.
    I TASTI NON ESCONO DALLA PROVA, e non e' prudenza: e' il punto. Se
    "riprendi" finisse al Sender mentre si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
2026-10-31 Le penne si vedono: sul foglio, nell'elenco, e quando costano una fermata
    Tre cose chieste dall'utente, piu' un difetto del telecomando trovato
    dalla prima accensione vera.
    IL TELECOMANDO DICEVA "DA AZZERARE" ANCHE DOPO L'HOMING. Il vetro si
    ridisegnava solo quando cambiava SCHERMATA, e azzerare la macchina non
    la cambia: resta "pronta", cambia solo la riga sotto. Stessa trappola
    per il pallino del colore, che arriva un attimo dopo l'inizio della
    stampa -- il segno di penna sta nel G-code all'inizio del livello, cioe'
    qualche millisecondo dopo che lo stato e' diventato "invio". Adesso il
    vetro si rifa' anche quando cambia quello che c'e' scritto sopra.
    IL PULSANTE non carica un disegno di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
2026-10-31 Documento v64: il telecomando acceso, le penne nel SLICER, e quattro collaudi che morivano in silenzio
    Voce marcata (meccanica/firmware), tre blocchi Sintomo/Causa/Fix: il
    'da azzerare' dopo l'homing (trovato dalla prima accensione vera), il
    colore sul foglio scritto giusto e invisibile perche' un attributo di
    presentazione perde contro una regola CSS, e i quattro collaudi che
    morivano senza che il lanciatore se ne accorgesse.
    Note: Step 9 (firmware caricato, il difetto dell'azzeramento, la prova
    in bianco), Step 4 (le penne nel SLICER, il pulsante del logo).
    Versione 63 -> 64, sopra la voce del fronte stampe delle 18:20.
    Claude-Sessio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
2026-10-31 La penna del livello si sceglie: tavolozza a comparsa sul pallino
    Fino a ieri il colore di un livello era SOLO la tinta delle sue forme, e
    il commento diceva che tenerne una copia vorrebbe dire averne due che a
    un certo punto non coincidono piu'. Resta vero, ed e' per questo che la
    scelta non sostituisce la tinta ma la COPRE: la tinta del file resta
    intatta, `l.penna` dice "per questo livello monto quest'altra", e
    togliere la scelta la fa riapparire. Senza, il dato di partenza si
    perderebbe al primo ripensamento.
    Serve perche' il colore con cui un disegno e' stato fatto e la penna con
    cui lo si stampa sono due cose diverse -- un logo nero si puo' voler
    stampare in rosso -- e perche' un live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
2026-10-31 Documento v66: la tavolozza, e due cose della testata che erano sbagliate
    Voce marcata (meccanica/firmware) delle 09:33, continuazione di quella
    delle 09:20 della stessa giornata: la tavolozza a comparsa, il selettore
    a tre cursori, il nome della penna al cambio penna, il pulsante del
    logo. Tre decisioni, fra cui quella che conta -- la penna scelta COPRE
    la tinta del file invece di sostituirla, cosi' togliendola il dato di
    partenza torna.
    Due correzioni allo stato attuale, segnalate dentro la voce invece di
    essere fatte in silenzio:
    - lo Stato dello Step 9 diceva ancora "manca solo il firmware" mentre il
    firmware e' caricato e gira. Adesso dice quello che manca davvero: la
    prova sul ca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
2026-10-31 Il foglio cambia attorno al suo centro, e il disegno resta quello
    Tre cose chieste dopo il biglietto disegnato su un A5 perche' le misure
    del foglio vero non si sapevano ancora.
    1. CAMBIARE FOGLIO NON SMONTAVA PIU' IL DISEGNO, LO SMONTAVA E BASTA.
    Il gestore di `paper` buttava via rettangolo e ritaglio di OGNI livello,
    e refit() senza rettangolo ne rifa' uno adattando il livello al foglio,
    ognuno per conto suo: due livelli larghi diversi tornavano larghi uguali,
    ogni pezzo tornava in mezzo al foglio, e la composizione — l'unica cosa
    costruita a mano — spariva. Era scritto come una scelta («i rettangoli
    erano misurati su un foglio che non c'e' piu'»), ma erano misurat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
2026-10-31 Le cinque cose che ha detto il vetro vero
    Prima accensione con la scheda in mano, e cinque segnalazioni. Nessuna
    era un errore di calcolo.
    1. I TASTI ERANO DALLA PARTE SBAGLIATA. La tabella pad -> posizione era
    girata di MEZZO GIRO: le parole da una parte del vetro e il LED acceso
    dall'altra. Veniva dagli schemi Altium, letti il 29 ottobre, e nel rame
    era giusta - ma i pad stanno sul rame DI SOTTO, e di sotto alto e
    basso, destra e sinistra sono il contrario. Era perfino scritto, come
    cosa "da confermare con un'occhiata", insieme alla rassicurazione che
    al massimo poteva essere specchiata. La simmetria c'era, il mezzo giro
    no. I pad veri: 00 in alto a destra, 01 in bass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
    [Arduino.h, Arduino_MKRIoTCarrier.h, SD.h, WiFiNINA.h, arduino_secrets.h, geometria.py, ppm2png.py, prototipi.py]
2026-10-31 La prima stampa vera: RIPRENDI che non riprendeva, e lo sfarfallio dello stop
    Biglietto a due colori portato a termine senza toccare il portatile - il
    criterio dello Step 9 - e tre cose da sistemare, nessuna delle quali
    fermava la stampa.
    1. RIPRENDI DOPO IL CAMBIO PENNA NON FACEVA NIENTE, e non era il tasto ne'
    il pad: era il SLICER. `premuto('riprendi')` durante un cambio penna
    chiamava Popup.telecomando('apri'), che la finestra la APRE - ma quando
    il telecomando mostra RIPRENDI la finestra e' gia' aperta al secondo
    passo, e' proprio da li' che sa di doverlo mostrare. Riapriva una
    finestra aperta. Adesso entra come 'avanti', la stessa strada del
    pulsante della pagina, ch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
2026-10-31 Documento v67: la prima stampa vera, e il criterio mancato per un tasto
    Voce [2026-10-31 16:02]. Copre tutto quello che e' successo dopo la v66:
    il cambio foglio che smontava il disegno nello SLICER, le cinque cose
    della prima accensione del telecomando, lo strumento schermo/vetro, la
    prima stampa vera e i suoi tre difetti, e la batteria che non da' segni
    di vita.
    Due aggiornamenti di stato, tutti e due segnalati dentro alla voce invece
    che fatti in silenzio:
    - Step 9: lo stato di stamattina diceva «manca la prova sul campo». La
    prova c'e' stata, ed e' andata quasi fino in fondo: il criterio - una
    stampa a due colori senza toccare il portatile - e' mancato PER UN
    TASTO, perche' RIP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
2026-10-31 La spina: la 18650 si ricarica dall'USB, e il vetro lo dice
    Il caricabatterie sta sul MKR (BQ24195L), quindi attaccare l'USB ricarica
    la cella — ma solo se i registri dicono la cosa giusta, e all'accensione
    non è detto: il core di Arduino accende la carica solo se all'avvio vede
    la batteria, il limite in ingresso resta a 100 mA perché i D+/D− non
    arrivano al PMIC, e carrier.begin() tocca lo stesso registro con la boost
    mode. Il firmware adesso li scrive (500 mA in ingresso, 512 in cella,
    guardiano spento, timer a 12 ore, carica e boost accese insieme) e poi
    LEGGE il registro dello stato ogni due secondi, invece di dare per
    scontato che stia caricando.
    Sul vetro: fulmine bianco dentro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
2026-10-31 Il telecomando ha una scheda sua, con le prove delle schermate
    Nelle impostazioni del SLICER tutto quello che riguarda il telecomando sta
    in una scheda sua invece che sparso dentro a «Connessione»: è una scatola a
    parte, con una rete sua, un collaudo suo e modi suoi di rompersi, e chi non
    ce l'ha lascia l'indirizzo vuoto e non legge altro.
    Dentro, tre cose. La prova in bianco, che c'era. Una schermata per volta: un
    pulsante per ognuna delle dieci, che la manda e la TIENE FERMA finché non ne
    premi un'altra — guardare una schermata con la recita voleva dire aspettare
    il momento giusto e fotografarlo. Sono gli stessi stati di una stampa vera e
    il telecomando non sa che è una prova; un t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
2026-10-31 Le prove del telecomando solo in modalità finta
    Una prova manda al telecomando una stampa che non esiste. Finché la macchina
    è scollegata è quello che si vuole; con la macchina accesa e comandabile sono
    due bugie in una: sul vetro ci sarebbe scritto «in stampa» a macchina ferma —
    o «pronta» mentre disegna — e il telecomando è l'oggetto che si guarda
    proprio quando non si guarda il portatile, quindi una schermata inventata lì
    sopra è una cosa su cui qualcuno agisce. E i tasti, durante una prova,
    restano dentro alla prova: premere STOP non fermerebbe niente.
    Il controllo sta dentro al modulo (`sePuoFingere`) e non nei pulsanti: un
    controllo che vive nell'interfaccia lo si aggir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
2026-10-31 Via le bozze del logo: ce n'è uno vero
    Le tre varianti del 27 ottobre erano proposte in attesa di una scelta, e la
    scelta è arrivata da un'altra parte: l'utente il logo se l'è disegnato. Tenere
    in repository tre bozze scartate più il generatore che le produce vuol dire
    che fra un mese qualcuno apre `logo/` e trova quattro logo diversi senza
    sapere quale sia quello buono.
    Niente va perso: `git show 5c50952` ha ancora tutto — i tre SVG, il
    generatore con le misure dell'alfabeto GDC Stuff, i contorni di Jost letti
    dal TTF e il README con le tre regole di Gestalt. Se una di quelle misure
    servisse, si ripesca da lì.
    Claude-Session: ht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
2026-11-01 Il tasto della penna dice l'azione, non il suo nome
    «ABBASSA E ALZA» diceva che cosa sa fare il tasto, non che cosa succede se
    lo premi adesso: per saperlo bisognava guardare la macchina, cioè girarsi,
    che è esattamente quello che il telecomando serve a non fare. Adesso c'è
    scritto «ALZA» quando la penna è al contatto e «ABBASSA» quando è alzata, e
    la parola cambia appena il servo si muove.
    Dove sta il servo lo sa il SLICER e lo manda nel messaggio (`giu`). È un
    TERZO STATO e non un booleano: vero, falso, oppure non lo dice. Schiacciare
    `null` su `false` farebbe scrivere «ABBASSA» a un telecomando che non sa
    dove sia la penna — una bugia detta con sicurezza. Senza quel campo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
    [telecomando.ino, vetro.cpp]
2026-11-01 K_PARTITORE provvisorio a 1,233: il partitore non è da metà
    Grezzo 982,25 su 1023 — 3,168 V sul piedino — con la cella al tester a
    3,91 V. Con K = 2 lo sketch stampava 6,34 V, che per una cella sola non
    esiste: tanto bastava per sapere che il numero di partenza era inventato.
    Resta provvisorio perché vale solo se i due numeri sono stati presi nello
    stesso istante, e questo lo sa chi aveva il tester in mano. Da confermare
    con un reset a USB attaccata e la misura fatta mentre il monitor stampa.
    Conseguenza da verificare sulla macchina: a 3,3 V di fondo scala il piedino
    va contro il muro intorno ai 4,07 V di cella, quindi a cella piena il vetro
    potrebbe non passare il 90%. Se succede,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
    [telecomando.ino]
2026-11-01 K_PARTITORE = 1,284, misurato coi due numeri presi insieme
    Reset premuto, tester sulla cella mentre il monitor stampava: grezzo 982,37
    su 1023 — 3,169 V sul piedino — con la cella a 4,07 V.
    Il tentativo di prima (1,233) veniva da un tester letto in un altro momento,
    a spina staccata, e sbagliava di quattro punti percentuali: fra una misura e
    l'altra il caricabatterie alza e abbassa la cella di un decimo di volt
    buono. È il motivo per cui i due numeri vanno presi insieme, e adesso sta
    scritto nel README invece che nella testa di chi l'ha fatto.
    Quel K non è il partitore: è tutta la catena, le due resistenze e la
    tensione vera del riferimento del convertitore. Per questo non viene un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
    [telecomando.ino]
2026-11-01 La carica non insegue il carico: picco, filtro, un punto per volta
    Al banco: 73, 67, 57, 65, 67, 67, 74 — diciassette punti di ballo ogni
    dieci secondi a cella ferma. Non è il convertitore che sbaglia: è la
    tensione che si muove davvero. Diciassette punti sono 0,145 V, cioè quello
    che la cella perde quando il WiFi trasmette o il vetro si riaccende, fra
    resistenza interna, molle del portabatteria e contatti del cavetto. Con
    burst da un paio di decimi di ampere vuol dire mezzo ohm abbondante in
    giro, quasi tutto nei contatti.
    Misurare meglio non si può, la caduta è vera. Ma un indicatore che balla
    non è un indicatore: è un numero che si impara a non guardare, che è il
    modo peggiore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
2026-11-01 Il logo vero, e un secondo SVG che funziona anche fuori dal bianco
    Disegnato dall'utente in Illustrator. In repository il sorgente .ai,
    l'esportazione intatta e una versione per lo schermo.
    I due file SVG non sono un doppione. L'esportazione disegna i controformi —
    il 2 e la D — con paths BIANCHI sopra a quelli neri: su carta si legge
    giusto, ma il bianco è inchiostro come un altro. Su un fondo grigio
    compaiono due macchie bianche al posto dei buchi; su fondo nero del logo
    resta solo «2 D» e il resto sparisce; e lo SLICER è scuro.
    `pulisci.py` trasforma quei due paths in una maschera, cioè in buchi veri,
    taglia il viewBox sul disegno (l'esportazione è un A4 con 370 punti di
    margi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
2026-11-01 pulisci.py regge anche i file dove l'ordine conta
    Non basta una maschera sola. Un nero disegnato DOPO un bianco ci passa
    sopra — è così che è fatto il pieno della D — e bucarlo con quel bianco lo
    cancellerebbe. Adesso i pezzi si dividono in gruppi fra un bianco e l'altro
    e ogni gruppo viene bucato solo dai bianchi che gli stanno sopra.
    In più: butta i path invisibili (`fill:none`), che sullo schermo non cambiano
    niente ma un plotter li disegnerebbe; legge dallo <style> quali classi sono
    bianche invece di saperlo a memoria; e prende il riquadro come argomento.
    Serviva per la revisione del logo che sta arrivando, dove il 2 e il pennino
    sono fatti di una dozzina di pezzi interlacciati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
2026-11-01 Il logo passa alla revisione, e la cucitura è cucita
    La versione nuova: C alzate fino all'altezza della N (erano il 4,4% più
    basse), spazi fra le lettere pareggiati (lo scarto passa dal 23% al 4%), D
    più alta. In repository come logo buono.
    La cucitura che in Illustrator non si vede, si vede su qualunque schermo:
    due pezzi che si toccano esattamente invece di sovrapporsi lasciano una riga
    chiara, perché nessuno dei due bordi copre tutto il pixel. Illustrator
    lavora in vettoriale e le fessure di larghezza zero lì non esistono.
    Senza operazioni booleane la cura è un contorno sottilissimo dello stesso
    colore su ogni pezzo: 0,3 unità, lo 0,19% dell'altezza. Misurato sul reso a
    1600 px: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
2026-11-01 Documento v69: la batteria tarata, il tasto che dice l'azione, il logo vero
    Scontro di versione con il fronte stampe: tutte e due le sessioni hanno
    scritto 68 nello stesso momento. Fuse come dice la regola di co-editing —
    versione max(68, 68) + 1 = 69, nessuna voce persa, la più recente in cima e
    la data dell'intestazione è la sua. Lo scontro è segnalato dentro alla voce,
    non solo qui.
    Step 9: stato aggiornato — la batteria funziona (causa non accertata), il
    caricabatterie è scritto registro per registro, K_PARTITORE è misurato e
    resta una taratura sola invece di due. Cinque note nuove, fra cui il bit
    della boost che non resta su con l'USB attaccata e la pila che ballava di
    diciass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
2026-11-01 La presa a muro si fa vedere, e la carica non gonfia più il numero
    Due difetti visti al banco il 1° novembre, secondo giro.
    LA PRESA A MURO NON VENIVA VISTA. Nessun fulmine con l'alimentatore da
    rete, fulmine e carica con la stessa cavo nella porta del PC, carica
    anche a muro premendo il reset. Nessun fulmine vuol dire PG_STAT giù: il
    PMIC non vedeva nessun ingresso. La causa era nostra — a batteria la
    boost pilota il filo VBUS, lo stesso su cui arriva l'alimentatore, e un
    alimentatore che regola a 5,0 V esatti non sovrasta un'uscita boost che
    sta cinque centesimi più su. Il firmware peggiorava le cose ri-armando la
    boost proprio quando vedeva «a batteria», cioè nello stato sbaglia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
    [Arduino.h, Wire.h, telecomando.ino, vetro.cpp]
2026-11-01 La taratura è chiusa su due punti, e la finestra rimette il modo giusto
    IL SECONDO PUNTO. Finestra lunga a corrente ferma: grezzo 893, il
    firmware stampa 3,70 V, il tester sulla cella dice 3,70 V. Con il primo
    punto (982,37 -> 4,07 V) fanno K = 1,2843 e K = 1,2844, a 0,37 V di
    distanza: si accordano meglio di quanto il tester sappia risolvere.
    Quindi nella catena NON c'è un offset, un rapporto solo basta, e
    K_PARTITORE = 1,284 è chiuso. Il 1,312 del punto a batteria era tutto
    caduta di contatti, come scritto.
    E nei dieci numeri di quei cinque secondi il grezzo è stato fermo fra 893
    e 894: a corrente zero il ballo di diciassette punti non esiste. Era il
    carico, e adesso è dimostrato inv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
2026-11-01 Documento v71: la batteria chiusa, e due difetti miei
    Voce [2026-11-01 22:17] (meccanica/firmware). Tre bug nel formato
    Sintomo/Causa/Fix, e due dei tre sono miei: la boost che impediva al
    PMIC di vedere l'alimentatore da muro, la tensione di carica che
    gonfiava il numero di cinquanta punti, e la finestra che rimetteva 0x3B
    fermando la carica appena partita.
    Quattro decisioni, e due valgono oltre questo step: un controllo va
    provato rompendo il codice di proposito (l'asserzione che doveva
    proteggere dal difetto della finestra pretendeva il valore sbagliato,
    cioe' confermava l'errore), e non si chiama prova una misura dentro al
    rumore o che contiene un errore sistematico messo da chi la legg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
2026-11-02 Il torneo del cicalino: due note per volta, e i numeri nascosti
    Sketch di servizio schermo/cicalino/cicalino.ino per trovare la
    risonanza dell'ABT-461-RC, che è l'ultima taratura rimasta sulla scheda
    vera. Il firmware usa 4000 Hz, un numero messo a caso; il foglio tecnico
    del venditore dà 2731 Hz di risonanza e misura gli 85 dB a 3000, quindi
    4000 è probabilmente mezza ottava di troppo — ma il foglio parla del
    pezzo nudo e qui sta dentro a una scatola con un foro.
    A orecchio e non col fonometro, e non è un ripiego: serve la frequenza
    che un umano sente di più, e l'orecchio ha la sua curva di sensibilità
    massima proprio fra 3 e 4 kHz. Non si misura il cicalino, si accorda la
    coppia c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
2026-11-02 Il cicalino grida a 2500, e i suoni si rifanno in chiave su quello
    Il torneo ha dato 2500 Hz, dentro alla previsione (2500-3150) e a 11 Hz
    da un Re diesis 7. Il firmware usava 4000: quasi mezza ottava fuori,
    cioe' il cicalino stava gridando con il freno tirato da sempre.
    E 2500 diventa la nota di casa. Le melodie non si trasportano a caso: si
    costruiscono in chiave sul cicalino, con 2500 come radice — la nota piu'
    forte dell'insieme — e le altre a intervalli giusti dentro a una banda
    strettissima, perche' piu' si va lontano da 2500 piu' il suono si
    spegne. Del picco sappiamo dove sta, non quanto e' largo: il torneo
    confronta, non misura una curva.
    schermo/suoni.html e' il banco dei suo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
2026-11-02 Nove proposte nuove per i suoni, e il cambio penna è deciso
    CAMBIO PENNA: tre colpi da 90 ms sulla nota di casa. Scelto dall'utente.
    Le altre due restano nella pagina solo per confronto.
    E quella scelta vincola il problema: non può più essere una fila di
    colpi uguali, o attutiti i due diventano la stessa cosa. Le quattro
    proposte nuove hanno tutte una sagoma diversa da tre battute pari — il
    ribattuto (raffica più coda tenuta), il gradino giù (alta corta, bassa
    lunga), la sirena, il doppio lungo basso. Della sirena è scritto nella
    pagina che è la più rischiosa delle quattro: attutita diventa cinque
    colpi, e cinque somigliano a tre.
    PARTENZA, quattro nuove: la quarta (l'intervallo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
2026-11-02 I suoni scelti, e l'allarme del problema che richiama ogni dieci secondi
    Tre su quattro decisi dall'utente all'ascolto: tre colpi per il cambio
    penna, l'arpeggio che torna per la fine, la sirena per il problema. La
    partenza resta «tre scalini» in via provvisoria — il suo preferito fra
    le prime tre — in attesa della scelta fra quattro motivetti nuovi.
    RISONANZA passa da 4000 a 2500, misurata. E 2500 non e' piu' solo una
    costante: e' la tonica. Le note dei quattro suoni sono una scala
    maggiore col DO su 2500, con una tavolozza di dieci semitoni e basta,
    perche' piu' si va lontano piu' il suono si spegne.
    Corretto anche un commento che prometteva una cosa che il codice non ha
    mai fatto: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
    [telecomando.ino, vetro.cpp]
2026-11-02 La fanfara per la partenza, e la pagina non puo' piu' mentire
    Ultimo dei quattro suoni scelto all'ascolto: sol do mi, do mi, do. Una
    quarta, una terza e il rimbalzo — la forma delle trombe militari, e
    quella forma esiste per un motivo che vale anche qui: usa solo le note
    che uno strumento senza tasti sa fare, e il cicalino e' esattamente uno
    strumento senza tasti. Il sol d'attacco sta un quarto sotto il DO,
    quindi e' la nota piu' debole delle sei: va bene perche' e' la spinta,
    non l'arrivo.
    E vetro/suoni.py: il banco dei suoni e il firmware devono dire la stessa
    cosa, nota per nota e millisecondo per millisecondo. Una pagina che si
    scollega dal codice non diventa inutile, diventa una bugi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
    [suoni.py, telecomando.ino]
2026-11-02 Il selettore specifico e lo specchio, nella tab Editor
    IL SELETTORE SPECIFICO (il lazo). Si cerchia a mano libera e si prende
    solo quello che resta dentro; dove una spezzata esce dal cerchio, la si
    taglia sul bordo. E' il taglio a renderlo diverso da tutto il resto, e
    senza quello non servirebbe a niente: su un disegno importato una
    «linea» non esiste — una campitura a onde e' UN tracciato con decine di
    migliaia di nodi — e portarne via un pezzo con Scegli e Ctrl+X vuol dire
    cliccare tratto per tratto per mezz'ora. Il rettangolo di selezione non
    aiuta: prende le FORME che tocca, cioe' tutta la campitura.
    Il taglio e' sul bordo vero, non al nodo piu' vicino: intersezione
    esatta sui tra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
2026-11-02 Il volume del cicalino, e il marchio nell'intestazione
    IL VOLUME, CHE SU QUESTO CICALINO NON ESISTE. Fra il piedino e la bobina
    c'e' un MOSFET e basta: nessun livello da abbassare. Quindi «volume»
    vuol dire una cosa sola — quanto dura l'impulso dentro a ogni periodo —
    e quello che la membrana sente e' l'ampiezza della prima armonica, che
    per un impulso lungo una frazione d del periodo vale sin(pi*d).
    Non va in proporzione, e per questo la scala ha dieci tacche e non
    cento: da 10 a 9 non si sente quasi niente, da 2 a 1 si sente
    moltissimo. La nota sotto al cursore dice i decibel invece di una
    percentuale, perche' «7 su 10» su una scala che e' un seno non dice
    Due strade, sce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
2026-11-02 Il testo esce dritto: la y si ribalta dove nasce la lettera
    Sintomo: una parola inserita con lo strumento Testo usciva ROVESCIATA, e
    girandola di mezzo giro non si raddrizzava.
    Causa accertata: FontTratto ha l'origine in basso a sinistra e la lettera
    che cresce verso l'ALTO; da appiattisci() in poi la y va in GIU', come in
    un file SVG. Il commento vecchio diceva che «chi usa il risultato lo
    ribalta come ribalta tutto il resto», e non era vero: toRect ribalta una
    volta sola, quindi una lettera lasciata con la y in su restava a testa in
    giu' nell'editor E sulla carta.
    Rovesciata, non ruotata — ed e' esattamente il motivo per cui ruotarla
    non la raddrizzava: le due cose coincidono solo pe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
2026-11-02 Il marchio dentro al disegno, come contorni
    Pulsante Logo nell'editor: mette il marchio nel livello acceso, largo 60
    mm veri e in mezzo a quello che si sta guardando — non all'origine del
    file, che su un disegno importato puo' stare a mezzo metro da li'.
    ENTRA COME CONTORNI, NON COME PIENI. Una penna non riempie, e il marchio
    e' fatto di forme piene coi contrografici ritagliati dentro: sulla carta
    diventa il suo profilo, controcampi compresi. Non e' un ripiego —
    quello che su schermo e' nero pieno, su carta e' il giro che lo
    delimita, ed e' il disegno giusto per un plotter.
    Il disegno viene dall'SVG che sta GIA' nella pagina, quello
    dell'intestazione: una copia sola, e quando il logo c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
2026-11-02 Il logo CNC 2D accanto a quello GDC Stuff, e le maschere non sono magazzini
    IL PULSANTE SI SPOSTA dove l'utente lo voleva: sotto ai livelli, accanto
    a «Inserisci il logo GDC Stuff», e fa la stessa cosa del vicino — il
    marchio entra come livello nuovo, importato come un file qualsiasi.
    Quello nella barra dell'editor e' stato tolto: due pulsanti «Logo» che
    inseriscono in due modi diversi sono un modo di sbagliare.
    RIDOTTO A UN COLORE SOLO prima di darlo all'importatore. Sullo schermo
    il marchio e' lettere piene con dentro i contrografici BIANCHI, piu' un
    gruppo con un bordo sottile (la cucitura fra forme accostate): tre
    colori, e l'importatore divide per colore. Dato com'e', il marchio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
2026-11-02 La fine di una stampa, detta quando succede davvero
    Tre cose sulla fine, piu' lo sfarfallio dopo lo stop. Tutte viste
    guardando il codice, tutte riparate.
    «FINE» VOLEVA DIRE «HO CONSEGNATO L'ULTIMA RIGA», non «ho finito». La
    macchina ha un pianificatore — una fila di movimenti gia' accettati che
    deve ancora percorrere — quindi il telecomando suonava la fine mentre la
    penna stava ancora tracciando. Adesso consegna e fine sono due momenti:
    consegnato l'ultimo comando si aspetta che la macchina dica Idle. Se non
    lo dice entro due minuti si chiude lo stesso, dicendolo nel registro,
    perche' un'attesa senza fine e' peggio di una fine anticipata. La
    modalita' finta NON e' un caso a parte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
2026-11-02 Documento v72: il cicalino tarato, due strumenti, il marchio, la fine stampa
    Voce [2026-11-02 22:03]. Giornata lunga su due fronti dello stesso
    oggetto: il cicalino trova la sua frequenza (2500 Hz, mezza ottava sotto
    quella che il firmware usava da sempre) e i suoi quattro suoni,
    l'editor prende il lazo che taglia e lo specchio, il marchio entra
    nell'intestazione e nel foglio, e la fine di una stampa smette di essere
    una bugia in tre modi diversi.
    Cinque difetti nel formato Sintomo/Causa/Fix, tutti con la causa
    accertata. Tre erano invisibili dalla scheda — il testo rovesciato, lo
    sfarfallio dopo lo stop e il campo dello stato da 10 byte, che avrebbe
    fatto sparire lo stato nuovo in silenz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
2026-11-02 Documento: Step 10, misure e colori dei magneti (fronte stampe)
    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
2026-11-02 Documento: orario di aggiornamento corretto
    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
2026-11-03 La carta che hai in casa e la punta che ci monti sopra
    Due aggiunte allo slicer, e servono alla stessa cosa: che l'anteprima sul
    foglio somigli al foglio. Un disegno guardato su carta bianca immaginaria,
    tutto a tratto sottile, non dice se il tratteggio si impastera' col
    pennarello ne' se la penna nera si vedra' sul cartoncino nero: lo dice la
    stampa, venti minuti dopo.
    IL COLORE DELLA CARTA, nella stessa finestrella del nome e delle misure.
    Sta accanto ai formati nel profilo e non dentro al profilo di stampa, perche'
    e' una proprieta' della risma che hai in casa: cambiare profilo non fa
    diventare bianco il cartoncino nero. E' un elenco e non una mappa perche'
    fondi() ricopia solo le chiavi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
2026-11-03 La punta della penna nuova, e il messaggio che restava appeso
    DUE PENNE NON HANNO LA PUNTA NELLO STESSO POSTO. Visto sulla carta
    stampando a due colori: il morsetto tiene il CORPO della penna, e corpi
    diversi portano la punta a qualche decimo -- a volte a qualche millimetro --
    l'una dall'altra. Il disegno esce a fuochi, e la differenza si vede solo a
    stampa finita.
    La Z non era il problema e non lo e' per costruzione: la penna nuova si monta
    col servo fermo alla quota del programma e si stringe quando tocca. In X e Y
    quel gesto non esiste, e non c'era niente che lo rimediasse.
    LA CORREZIONE E' UNA RIGA, ed e' la stessa riga con cui si azzera la macchina
    a inizio stampa: un G92. Terzo passo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
    [telecomando.ino, vetro.cpp]
2026-11-03 La tab «In stampa»: il racconto di una stampa, che resta
    Una tab nasce da sola quando parte una stampa e resta anche dopo. A
    differenza delle altre si puo' chiudere, perche' non e' una parte del
    programma: e' il racconto di UNA stampa, e di stampe se ne fanno tante.
    Dentro: il percorso che avanza sul foglio, la riga di G-code che la macchina
    sta eseguendo adesso con un po' di prima e un po' di dopo, i cambi penna
    segnati dove cadono, e tutto quello che e' stato detto da quando e' partita.
    Il telecomando dice tre cose su un vetro da tre centimetri; qui c'e' lo
    stesso racconto con lo spazio per guardarlo -- e serve anche a capire se il
    telecomando sta dicendo il vero.
    OGNI TAB SI PORTA VIA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
2026-11-03 Una penna e' un colore E uno spessore
    L'ha visto l'utente: gli avvisi sui cambi penna contavano i colori, ma due
    livelli neri a 0,3 e a 0,8 non si stampano con la stessa penna. Sono due
    penne, e fra loro ci vuole una fermata esattamente come fra il nero e il
    rosso.
    Finche' lo spessore non esisteva, «stessa penna?» si poteva rispondere col
    colore e tutto l'elenco dei livelli era scritto cosi'. Da ieri il colore da
    solo da' la risposta sbagliata, e la da' nel verso peggiore: diceva «questa
    fermata e' inutile, toglila» di una fermata che serve davvero. Un consiglio
    che rompe la stampa e' peggio di nessun consiglio.
    Adesso l'identita' di una penna e' `colore|spessore` -- chiavePenna() -- e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
2026-11-03 Documento v74: lo Step 9 si chiude, la giornata del foglio e delle penne
    Lo Step 9 passa a COMPLETATO: l'utente ha portato a termine la stampa a due
    colori senza toccare il portatile, che era l'ultimo criterio aperto.
    Registrato anche il contorno onesto -- quella stampa e' girata col firmware
    di PRIMA delle correzioni sulla fine stampa, quindi dimostra la catena e non
    quelle; il firmware nuovo e' stato caricato e confermato nella stessa
    giornata.
    Step 4 aggiornato con la giornata: colore della carta, spessore del tratto,
    la punta ritrovata al cambio penna, la tab «In stampa», e una penna che
    diventa colore piu' spessore. Cinque note nuove, tre note nuove sullo Step 9.
    La voce raccoglie c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
2026-11-05 Documento v75: magneti a due penne e regola delle scritte per l'indelebile (fronte stampe)
    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
2026-11-06 Due progetti salvati sullo stesso foglio: l'avviso a tre vie
    Riaprire un .cnc2d.svg con del lavoro gia' sul foglio sostituiva tutto.
    Era di proposito -- «un progetto non si importa, si riprende» -- e giusto
    per riprendere la giornata di ieri, sbagliato per chi tiene da parte dei
    pezzi e ne vuole da due file. La domanda c'era gia', ma era un
    window.confirm: due pulsanti, quindi due strade, e la terza non c'entrava.
    Adesso e' una finestrella sua -- Annulla / Sostituisci tutto / Aggiungi i
    livelli -- e si apre solo quando c'e' del lavoro da perdere: sul foglio
    vuoto il progetto si apre e basta. Invio fa la cosa che non butta via
    niente; «Sostituisci tutto» non e' il pulsante principale, pe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
2026-11-06 Documento v76: due progetti sullo stesso foglio, e lo Step 11
    Step 4 aggiornato nello stato e con tre note: la terza strada, perche' le
    forme contano piu' dei tracciati, e la coda delle domande.
    Step 11 nuovo -- «Unire due progetti salvati: il foglio e la scelta dei
    livelli» -- aperto con una parte gia' fatta e due rimandate dall'utente
    nello stesso messaggio in cui ha chiesto l'avviso a tre vie.
    Voce di sessione con due difetti (la riga della coda che non compariva mai,
    e una mutazione del banco scritta male da me) e due decisioni.
    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
2026-11-07 Piu' fogli sul piano, fase 1: il modello (invisibile)
    Un foglio e' un sistema di riferimento, non un rettangolo da disegnare: i
    livelli hanno il loro posto in coordinate DEL FOGLIO, e prepare() passa alle
    coordinate macchina sommando l'origine. Finche' il foglio era uno, «il
    sistema di riferimento» e «il foglio» erano la stessa parola. Con nove
    magneti sul piano non lo sono piu'.
    State.data.fogli e' un elenco; `paper`, `sheetOrigin` e `foglioMisurato`
    diventano VISTE sul foglio attivo invece che campi. E' il motivo per cui
    questa fase non si vede: nessuno degli altri otto file cambia, e con un
    foglio solo il comportamento e' identico: il criterio di questa fase e' che
    tutti i banchi che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
2026-11-07 Fix: un file gia' numerato non viene mai piu' ritoccato, a prescindere dallo storico
    Il controllo "gia' fatto" dipendeva solo da 000-elaborati.json: se quello
    store si disallineava (es. conflitto di sincronizzazione OneDrive sulla
    cartella, o uno storico perso/stale) un file gia' rinominato correttamente
    veniva ritrascritto e rinominato di nuovo, rompendo i riferimenti nella
    timeline di Resolve. Ora il prefisso NNN- sul nome del file e' la prova
    "gia' fatto" di per se', indipendente dallo storico.
    Claude-Session: https://claude.ai/code/session_01Cn9pc1RxFgJ8d4TE23pQ3U
2026-11-07 Piu' fogli sul piano, fase 2: il piano, i magneti, i livelli su un foglio
    Il piano disegna tutti i fogli e uno solo e' quello in uso. Dalla colonna si
    aggiungono e si tolgono; sul piano si trascinano, e trascinandoli si
    AGGANCIANO l'uno all'altro.
    I MAGNETI non sono una comodita'. Due fogli accostati sono una misura sola
    invece di due, e l'accostamento si legge dalla geometria: un foglio
    appoggiato a occhio e sbagliato di mezzo millimetro non e' accostato, e'
    un foglio che chiedera' la sua misura senza che chi l'ha posato capisca
    perche'. I magneti sono quello che rende il gesto affidabile. Si agganciano
    i bordi -- degli altri fogli, della corsa e della tavola, il cui bordo in
    basso e' la b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
2026-11-07 Tre mutazioni rimaste indietro rispetto alla fase 2
    Il banco intero ne ha trovate tre che non vedevano piu' niente, e nessuna
    delle tre era un difetto del codice.
    «nessun bordo chiaro sul foglio scuro»: renderSheet e' stata riscritta per
    disegnare N fogli, la riga da rompere non esiste piu' con quelle parole.
    «`sheetOrigin` si legge ma non si scrive»: qui il buco era nel CONTROLLO.
    Diceva «scrivere sheetOrigin intero scrive sul foglio» e invece chiamava
    Paper.setSheetOrigin, che dalla fase 2 scrive sul foglio per conto suo: la
    vista non la toccava piu' nessuno e togliere il suo «set» non faceva
    fallire niente. Adesso il controllo scrive la vista, come dice di fare.
    «cambiare fogl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
2026-11-07 Fase 3a: l'ordine fra i fogli, i marcatori, e l'elenco diviso per foglio
    IL NUMERO CHE CONTA: nove magneti con due penne, stampati foglio per
    foglio, vogliono diciassette cambi penna. Stampati PER PENNA ne vogliono
    UNO. Non sono secondi di macchina -- lo spostamento in piu' e' penna alzata
    a 3000 mm/min -- sono sedici volte che una persona deve alzarsi.
    L'ordine si sceglie accanto al pulsante «Prepara», e il selettore compare
    solo quando i fogli sono piu' d'uno: con un foglio solo le due strade sono
    la stessa strada. Per penna l'ordine delle penne e' quello in cui compaiono
    nell'elenco -- non si inventa un ordine «migliore», perche' l'ordine dei
    livelli decide anche che cosa finisce sop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
2026-11-07 Una mutazione rimasta indietro, e adesso sposta davvero la chiamata
    Il banco intero: 102 su 103. L'unica che non vedeva piu' niente era «la
    nota si scrive dopo le righe, come prima»: renderElenco e' stata riscritta
    per dividere l'elenco per foglio e l'ancora non esisteva piu'.
    Rimessa, e migliorata: prima si limitava a togliere la chiamata a
    notaPenne(), adesso la SPOSTA dopo il giro delle righe, che e' il difetto
    vero del 3 novembre -- ogni riga mostra il risultato del giro precedente,
    cioe' il simbolo si accende con una modifica di ritardo.
    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
2026-11-07 Fase 3b: un angolo per foglio, e l'altezza una sola (salvo dirlo)
    I popup di inizio stampa non sono piu' tre: sono uno per l'origine, uno per
    l'altezza di contatto e UNO PER OGNI FOGLIO CHE STA PER CONTO SUO. Quelli
    accostati non lo chiedono -- il loro angolo si ricava dal vicino -- quindi
    nove magneti spinti uno contro l'altro restano tre schermate, come quando
    il foglio era uno solo. Misurato: tre fogli con due accostati = quattro
    schermate, non cinque.
    LA MISURA MUOVE TUTTA LA FAMIGLIA. I fogli accostati sono spinti uno contro
    l'altro: la loro geometria relativa e' un fatto, non un'ipotesi, e la
    misura dice dove sta il GRUPPO. Spostare solo quello misurato sfascerebbe
    il gruppo proprio n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
2026-11-07 Fase 3c: la tab «In stampa» disegna il piano intero
    Con l'ordine per penna la punta salta da un foglio all'altro di continuo:
    una tab che ne disegna uno solo mostrerebbe un disegno in cui meta' dei
    tratti cascano nel vuoto, e chi guarda non saprebbe se sta sbagliando la
    macchina o il racconto.
    Adesso la tab congela TUTTI i fogli del piano -- sempre una copia, come
    tutto il resto di questa tab: dopo, sul piano, i fogli si spostano e se ne
    aggiungono, e il racconto di questa stampa deve restare quello di questa
    stampa. Il foglio su cui la macchina sta disegnando si accende, e il
    riquadro dei dati dice «2 di 9» invece delle misure. Con un foglio solo non
    cambia niente: «foglio 1 di 1» no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
2026-11-07 Fase 3d: il telecomando dice su che foglio sta andando
    chi guarda il telecomando vede una percentuale che sale e non sa se il
    magnete che ha davanti e' finito. Adesso il vetro scrive «FOGLIO 3/9».
    Il marcatore arriva fin li' passando per tutta la catena: il generatore lo
    scrive, il Sender lo riconosce prima di buttare via i commenti e se lo
    ricorda, il messaggio lo porta, il firmware lo legge come legge la penna.
    Con UN foglio non viaggia e non si scrive niente -- «foglio 1 di 1» non
    distingue niente -- e un programma scritto prima del 2026-11-07, che il
    marcatore non ce l'ha, si esegue come sempre.
    IL POSTO SUL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
2026-11-07 Una mutazione rimasta indietro rispetto alla fase 3c
    Il banco intero: 130 su 131. L'unica che non vedeva piu' niente era «la
    tab legge il foglio vivo invece della sua copia»: la fotografia che la tab
    si porta via adesso e' di TUTTI i fogli, e l'ancora non esisteva piu'.
    Rimessa sulla forma nuova, e dice la stessa cosa di prima: invece dei
    numeri copiati, dei getter che vanno a leggere il foglio vivo -- che e'
    esattamente il difetto da cui quella tab esiste per difendersi.
    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
2026-11-07 Documento v77: il piano diventa piu' fogli, e lo Step 12
    Step 12 nuovo -- «Piu' fogli sul piano» -- con le fasi di cui manca solo
    l'ultima: il modello, il piano e i magneti, l'ordine e i marcatori, i
    popup, la tab «In stampa», il telecomando. Resta la 5, il progetto
    salvato.
    Lo Step 11 cambia stato: la meta' «foglio» non e' piu' una sua rifinitura.
    L'utente ha chiesto di andare verso piu' fogli, e quella direzione scioglie
    il problema invece di rattopparlo -- non c'e' piu' un unico foglio per cui
    litigare -- quindi si chiudera' da se' con la fase 5 dello Step 12.
    Step 4 aggiornato nello stato e con tre note, fra cui quella che spiega il
    lavoro in una riga: «il foglio» voleva dire i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
2026-11-07 Fase 5: il progetto salvato si porta dietro i suoi fogli
    Un .cnc2d.svg adesso salva l'elenco dei fogli (misure, nome, angolo) e il
    numero del foglio di ogni livello: riaprendolo, i disegni tornano ognuno
    sulla sua carta. Il disegno dentro al file passa in coordinate macchina,
    cosi' un lavoro su nove magneti si vede come nove disegni in nove posti
    anche aperto altrove; con un foglio solo il file e' identico a prima, ed
    e' un controllo del banco.
    Riaprendo, un solo predicato decide: «lo stesso piano» vuol dire tanti
    fogli quanti, delle stesse misure, nello stesso ordine.
    - Sostituendo: se il piano e' lo stesso e un angolo e' stato misurato
    sulla macchina, i fogli restano dove sono -- una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
2026-11-07 Scelta dei livelli, ruota e scala nell'editor, e i nomi
    LA SCELTA DEI LIVELLI chiude lo Step 11. La finestrella del progetto ha
    l'elenco con le caselle: tutti presi di partenza, «Tutti» e «Nessuno», il
    conto («3 su 18 presi»), e i due pulsanti che dicono su quanti lavorano e
    si spengono se non ne resta nessuno -- Invio compreso, perche' un tasto
    che scavalca un pulsante spento e' una scorciatoia per saltare un
    controllo. Con i livelli arrivano SOLO i fogli che servono a loro: due
    livelli su diciotto portano due magneti, non nove, e con la distanza che
    avevano nel file. «Lo stesso piano» continua a guardare tutti i fogli del
    file, perche' l'identita' di un piano non dipende da quanto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
2026-11-07 Una mutazione che non rompeva piu' niente
    Riscrivendo l'ancora di «Annulla aggiunge lo stesso» -- il codice intorno
    era cambiato con la scelta dei livelli -- le avevo tolto il significato:
    cambiava il flag aggiungi/sostituisci restando DENTRO al guardiano
    `if (scelta)`, quindi con Annulla non applicava niente lo stesso. Una
    mutazione che non puo' cambiare il comportamento misura se stessa, non il
    controllo. Adesso toglie il guardiano, e il controllo la vede.
    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
2026-11-08 Un controllo che passava guardando la frase sbagliata
    La finestrella del progetto scrive la misura del foglio DUE volte -- «su
    un foglio 210 x 297 mm» quando dice cosa c'e' nel file, e di nuovo fra
    parentesi quando dice che lo porta sul piano -- e il controllo ne cercava
    solo il testo: passava anche se la prima frase spariva del tutto, perche'
    la stessa misura sta venti parole piu' in la'.
    Trovato dalla mutazione che toglie quella prima frase, rimasta non vista.
    Adesso il controllo cerca la frase intera, e la mutazione la vede.
    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
2026-11-08 L'anteprima disegnava tutto sul foglio in uso
    Visto dall'operatore: «quando aggiungo un nuovo foglio e ci clicco sopra,
    tutto il disegno che ho sul primo foglio si sposta sul foglio che
    clicco».
    Era vero, ed era solo dell'anteprima: nel modello il livello non si
    muoveva di un millimetro e il G-code era giusto, quindi nessun controllo
    sul modello poteva vederlo.
    Causa: `rebuildPath()` somma a ogni tratto l'angolo del SUO foglio, letto
    da `State.data.artFoglio`. Quell'elenco lo riempiva solo `prepare()` --
    il pulsante «Prepara» -- quindi durante il lavoro normale restava vuoto e
    ogni tratto ripiegava sull'angolo del foglio ATTIVO. Adesso lo riempie
    anche `refit()`, che e' la strada di tu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
2026-11-08 L'elenco dell'editor: tutti i fogli, tutti i livelli
    Chiesto dall'operatore: «nella tab edit non vedo la lista dei fogli...
    ci sono sempre tutti i fogli e tutti i livelli, con l'elenco di fogli e
    livelli, anche qui spostabili di ordine e tra fogli».
    La colonna dell'editor mostra tutti i livelli divisi per foglio, con
    l'intestazione di ogni gruppo e quella del foglio in uso accesa. Prima
    filtrava sul foglio in uso, col ragionamento «cambiare foglio si fa dal
    piano»: ma in quella tab ci si sta dentro, e uscire per cambiare foglio
    e' una strada lunga. Il problema non era il filtro, era che mancava
    l'intestazione.
    Si trascina anche da li', per cambiare ordine e per portare un livello
    su un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
2026-11-08 Documento v81: le 192 mutazioni, e tre controlli che passavano per caso
    Chiude il giro di verifica delle due giornate e registra la quarta
    precisazione della regola del banco: anche un CONTROLLO puo' passare
    guardando la cosa sbagliata, e una mutazione non vista accusa lui, non
    sempre se' stessa.
    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
2026-11-08 La scheda: preset che aggiungono, e i fogli vuoti nell'elenco
    Due cose chieste dall'operatore il 2026-11-08, provando il programma.
    1. LA SCHEDA DEI FOGLI. «Preset fogli» in cima, e premerne uno adesso
    AGGIUNGE un foglio di quelle misure invece di cambiare le misure di
    quello su cui si sta lavorando - che era il difetto vero: un preset
    premuto mentre su quel foglio c'era gia' un disegno gli cambiava la
    carta sotto ai piedi. I due campi delle misure salgono accanto ai
    preset con il «+» di fianco, e il «+» e' uno solo: salva il preset se
    quelle misure non ce l'hanno gia', e aggiunge comunque il foglio.
    Sotto, il sottotitolo «Fogli» e i fogli veri del piano, ognuno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
2026-11-08 Il contatore di versione dopo la ricomposizione della pagina
    Lo riscrive build.py: conta i commit che hanno toccato webui/, e l'ultima
    pagina consegnata all'operatore porta il 111.
    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
2026-11-08 Banco: la mutazione degli agganci adesso taglia in due posti
    Il giro completo sulle 214 mutazioni ne ha lasciata fuori una, e non era
    colpa del controllo: «sostituendo, gli agganci non si rileggono» toglieva
    la riga di progetto.js, ma `applica` chiama subito dopo `Paper.setSize`
    per far ridisegnare tutto, e da oggi setSize rilegge gli agganci da se' —
    cambiare le misure di un foglio cambia chi tocca chi. Con un taglio solo
    il programma restava corretto: la mutazione misurava se stessa invece del
    controllo. Adesso taglia tutt'e due i punti, ed e` vista.
    214 su 214.
    Claude-Session: https://claude.ai/code/session_01B9QYaZ22yQtQe7sA7gRs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
2026-11-08 Documento v82: magneti chiusi, palla da beach volley (fronte stampe)
    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
2026-11-08 Documento v83: lo Step 12 chiuso sulla macchina
    L'utente ha stampato il disegno con piu' magneti: «tutto corretto». E' il
    criterio di completamento dello Step 12, che passa a completato; nella
    nota e' scritto che cosa quella conferma copre e che cosa no.
    Nella stessa voce: la scheda dei fogli rifatta e i fogli vuoti
    nell'elenco (con il pattern Sintomo/Causa/Fix), le 214 mutazioni, e la
    precisazione nuova alla convenzione del banco — una mutazione puo'
    diventare innocua col tempo, e allora accusa se stessa invece del
    controllo.
    Segnalate due discrepanze senza riscrivere niente: lo Stato dello Step 3
    conteneva una frase vera fino al 2026-10-25 e non piu' (corretta la
    frase, stato lasciat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
2026-11-08 Documento: lo Stato dello Step 6 diceva di misurare una cosa gia' decisa
    L'utente: «il gioco lo abbiamo misurato gia' molte volte, cosa
    mancherebbe?». Ha ragione, e io gli avevo proposto quella misura leggendo
    una frase vecchia: la procedura e' stata TOLTA il 2026-10-22 su sua
    obiezione, e il perche' sta in misure/accensione-e-taratura.md §A2.1 —
    presa rigida, 0,92 gradi di servo contro una banda morta di 0,9, nessuna
    impostazione che dipenda da quel numero. Il valore nel profilo e' di sola
    lettura: spiega gli artefatti, non compensa niente, e nessuna riga di
    G-code lo legge.
    Stato corretto, step invariato. E' il secondo Stato della Pipeline
    vecchio trovato oggi dopo quello dello Step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
2026-11-08 Documento v84: riconciliati gli Stati della Pipeline, e nasce lo Step 13
    Chiesto dall'utente dopo i due Stati vecchi trovati nella stessa giornata.
    Verificati uno per uno contro codice, file e note.
    - Step 3 -> completato: il criterio era passato da settimane e le due cose
    che lo tenevano aperto non ci sono piu' (lo streaming del SLICER cura il
    blocco delle stampe lunghe; max_rate e' 8000 nel file).
    - Step 5: separata la struttura, completata, dalle due cose aperte che non
    la fermano (i 10 mm persi su X, la planarita' sotto la staffa TT).
    - Step 8: l'ordine dei lavori deciso dall'utente — prima le cerniere di
    MakerWorld, poi box e passacavi disegnati attorno a quelle.
    - Step 9: re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
2026-11-09 Il telecomando: un tasto chiude il racconto di fine stampa
    Chiesto dall'operatore: «poter cliccare uno dei pulsanti dopo la fine o
    l'annullamento della stampa per tornare alla schermata base e togliere
    quella "fatto" o "ferma" prima della fine del tempo impostato».
    FINE e FERMATA adesso hanno un tasto, in alto a sinistra, che riporta
    alla schermata Pronta. I tre minuti restano e non sono in concorrenza: la
    scadenza e' per chi passa domani e trova il vetro che racconta ieri, il
    tasto per chi e' li' adesso, ha letto, e vuole il telecomando pronto.
    Come: un terzo mestiere per i tasti (`chiude`), accanto a «manda una
    parola al SLICER» e «arma lo stop». Non manda niente a nessuno — il
    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
2026-11-09 Documento v85: il tasto del telecomando, e il dubbio dello Step 12 sciolto
    L'utente conferma che il firmware non l'aveva ancora caricato: durante la
    stampa dei nove magneti il vetro il numero del foglio non l'ha detto,
    perche' quel firmware sulla scheda non c'era. Lo step resta completato —
    la stampa su piu' fogli e' la sostanza e ha funzionato — ma la riga del
    criterio sul telecomando si vedra' dalla prossima stampa.
    Step 13 in corso: lavoro 5 fatto, consegnato il file che porta anche il 3.
    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
2026-11-09 Il cronometro del giro, per trovare dove il telecomando si pianta
    Guasto visto dall'operatore il 2026-11-09: appena parte una stampa il
    telecomando smette di rispondere — il SLICER scrive «ha accettato la
    connessione e non ha risposto entro 2,5 s» — e il vetro resta fermo sulla
    schermata di PRIMA, «PRONTA · al punto home». A batteria, quindi la
    finestra della carica non c'entra: non gira mai senza spina.
    Quelle due cose insieme dicono che il giro principale NON gira: se
    girasse, dopo sei secondi senza messaggi il vetro direbbe «IN ATTESA» da
    se'. Il modulo WiFi intanto ha una sua pila TCP e continua ad accettare
    le connessioni — ed e' esattamente la faccia che il SLICER vede.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
2026-11-09 Il cicalino che piantava il telecomando, e il cursore che mentiva
    Tre difetti che si incastrano, e insieme spiegano perche' da giorni il
    telecomando muore a ogni stampa.
    1. IL CURSORE DEL VOLUME MOSTRAVA IL PREDEFINITO. `Settings.init()`
    costruisce il cursore PRIMA che `Telecomando.init()` legga il valore
    salvato: il cursore diceva 10, in vigore c'era il 2 messo giorni fa.
    E rimetterlo a 10 non mandava niente, perche' a 10 ci era gia': il
    comando non si poteva piu' dare. Adesso il volume viaggia nel segnale
    `telecomando` e il cursore lo segue — l'ordine dei moduli non c'entra
    piu'.
    2. NESSUNO LEGGEVA IL VOLUME CHE IL TELECOMANDO RIMANDA. Il firmware lo
    mette in ogni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
2026-11-09 Il numero del foglio va nell'angolo, e la schermata torna una sola
    L'operatore, con due fogli sul piano: «la schermata con il cerchio e la %
    era frammentata, come se ci fossero due numeri uno sopra l'altro». Non
    erano due numeri: era la prima cifra della percentuale appoggiata sopra
    alla parola PAUSA.
    IL CONTO NON TORNAVA E NESSUNO L'AVEVA FATTO. La fase 3d dello Step 12
    aveva messo «FOGLIO 3/9» in mezzo, sotto la percentuale, e per farci
    posto aveva alzato di quattordici pixel tutto quello che stava sopra. Ma
    fra il bordo basso dell'etichetta PAUSA (90) e la riga del foglio (132)
    ci sono 42 pixel, e la percentuale a corpo 6 ne e' alta 48. Non ci stava,
    e si vedeva solo con piu' di un f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
2026-11-09 Cronometro spento: il guasto e' stato trovato
    L'operatore ha stampato a batteria e tutto ha funzionato. Il codice resta
    nel file, dietro a un `#define`: e' l'unico strumento che dice DOVE si
    ferma un telecomando che non risponde piu', e la prossima volta che serve
    deve servire subito.
    Sulla scheda c'e' ancora la versione col cronometro acceso: finche' non
    si ricarica, il telecomando scrive sul seriale e non cambia niente
    d'altro.
    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
2026-11-09 Documento v86: i tre difetti incastrati del telecomando
    L'utente ha stampato a batteria col telecomando acceso: «tutto ha
    funzionato correttamente». Registrata la giornata per intero, coi quattro
    bug nel formato Sintomo/Causa/Fix — il cicalino che piantava il giro, il
    cursore che mostrava un numero falso, la risposta che nessuno leggeva, e
    la schermata che con piu' fogli si sovrapponeva a se' stessa.
    Due decisioni: il numero del foglio va nell'angolo (supera quella del
    2026-11-07, presa senza fare il conto dei pixel), e quando il PWM del
    cicalino non risponde si torna al volume pieno invece di restare muti.
    Tre precisazioni al metodo: un aggiornamento deve lasciare il vetro
    identico a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
2026-11-09 Documento v87: aperto lo Step 14, pulizia su GitHub
    Segnata su richiesta dell'utente la scansione del repository da
    fare per ultima: file per file, cosa serve, cosa e' storia e cosa
    e' superato. Nessuna cancellazione adesso - solo il censimento
    grossolano per cartella e le regole con cui si decidera'.
    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
2026-11-09 Documento v88: aperto lo Step 14, i riempimenti
    Richiesto dall'utente un lavoro sullo slicer: riconoscimento delle
    forme chiuse e riempimenti di diversi tipi. Lo step mette per
    iscritto cosa c'e' gia' (il flag chiuso dal comando Z, le tinte
    piene come livelli spenti, lo spessore della penna in millimetri) e
    cosa manca davvero: fill-rule non e' letto da nessuna parte, quindi
    oggi una ciambella sarebbe riempita col tappo. Sei tipi di
    riempimento in ordine di valore, con la serpentina subito dopo il
    tratteggio perche' il criterio qui e' il tempo, non la distanza.
    La pulizia su GitHub diventa lo Step 15: deve restare l'ultima.
    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
2026-11-09 Documento v89: il disegno dei riempimenti, deciso prima di costruirlo
    Lo Step 14 passa da elenco di possibilita' a disegno concordato: il
    pulsante nella tab edit, la finestrella dei parametri, l'anteprima
    sotto il mouse e il click che disegna, con le regioni lette dai
    tratti che ci sono. Da qui il declassamento di fill-rule, che su
    questa strada non serve mai - i buchi vengono giusti perche' il
    riempimento non attraversa l'inchiostro - e resta solo sulla strada
    all'ingrosso dei livelli pieni importati.
    Scritti anche lo stampino a un decimo di millimetro con le regioni
    etichettate una volta sola, la tolleranza di chiusura, il guardiano
    della fessura, il tempo nella finestrella, e le due doma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
2026-11-09 Documento v90: struttura di lavoro delle stampe, scheda e catalogo (fronte stampe)
    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
2026-11-10 Documento v91: i riempimenti come sottolivelli
    Chiuse le due domande dello Step 14. Il riempimento ha un livello
    suo, ed e' figlio del livello che riempie: proposta dell'utente,
    accolta separando le due meta' che si confondono. La parentela da'
    l'appartenenza, la cancellazione in blocco e l'ordine di stampa del
    gruppo (prima il figlio, poi il padre, cosi' il contorno copre le
    sbavature); a far seguire una modifica del contorno e' la ricetta
    tenuta nel figlio, perche' un nodo trascinato o una scala obbligano
    a rigenerare il tratteggio, non a trasformarlo.
    Con esse le tre regole che ne derivano: ricalcolo al rilascio e mai
    durante il gesto, un riempimento da rifare non si stampa, e se il
    rica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
2026-11-11 Documento v92: la mira del piano guarda nel foglio sbagliato
    Registrati i due difetti segnalati dall'utente e rimandati su sua
    decisione, cosi' che la settimana prossima si parta dalla diagnosi e
    non dal sintomo.
    Il difetto vero: quale() confronta il punto col rettangolo di ogni
    livello, che e' in millimetri del SUO foglio, mentre il punto arriva
    misurato dall'angolo del foglio in uso. Con piu' fogli la mira e'
    spostata della distanza fra i due angoli - provato su una sonda
    Playwright: null sul centro esatto del disegno. E' lo stesso errore
    corretto nell'anteprima l'8 novembre, sopravvissuto qui perche'
    nessuno aveva guardato la mira.
    Gli altri due punti: la mira prova il rettangolo e non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
2026-11-12 I dieci millimetri su X si tengono: l'area e' definitiva
    Decisione dell'utente: la cremagliera di Y non si sposta, perche'
    guasterebbe la simmetria della macchina, e i dieci millimetri non
    danno fastidio. Con cio' l'area 241,232 x 236,064 smette di essere
    provvisoria.
    Aggiornati i quattro posti che promettevano il recupero - il
    commento del profilo, il glossario delle misure, l'avviso del
    disegno di collaudo e la procedura di accensione - perche' un
    repository che promette un cambiamento annullato e' peggio di uno
    che non dice niente. La distinzione fra ostacolo e margine resta:
    e' vera e serve, e adesso dice che l'ostacolo e' permanente.
    Resta una conseguenza da decidere: il disegno di co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
2026-11-12 Il disegno di collaudo e' superato: segnato, non cancellato
    Decisione dell'utente: le undici prove che quel disegno raccoglieva
    sono state fatte in itinere con i progetti e le stampe vere, quindi
    una stampa dedicata che misuri tutto in un colpo non serve piu'.
    Segnato in tre posti - il riquadro in cima al documento, la testa del
    generatore e il punto 3 della procedura di accensione, che ora
    rimanda alla cornice dell'area utile. Resta scritto come si legge
    ciascuna misura: e' la parte che non invecchia. Se i due file vanno
    via si decide nella pulizia dello Step 15, dove il candidato e'
    annotato con le due citazioni da sistemare e l'avvertenza che
    test-macchina.js non e' un banco di prova anc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
2026-11-12 Il salvataggio che non si perde: disegno, prima di costruirlo
    Chiesto dall'utente un menu' "disegni recenti" alimentato da un
    salvataggio automatico temporaneo, raggiungibile da ogni dispositivo
    tramite la SD, piu' il rinomina al salvataggio che oggi manca.
    Scritta la correzione che conta: non "alla chiusura della pagina" ma
    continuo. Alla chiusura il browser non garantisce niente, e un
    salvataggio che esiste solo li' e' una promessa che non mantiene.
    Due livelli - IndexedDB in locale, sempre disponibile, e la SD per
    la copia condivisa, mai durante una stampa perche' la SPI e' divisa
    col vetro. Venti slot piu' trenta giorni, e un recupero per sessione
    di lavoro invece di uno ogni trenta sec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
2026-11-12 Il profilo sulla SD non e' piu' un uso minore
    Domanda dell'utente: aprendo il SLICER dall'iPad, cosa manca di
    quello che sta solo sul PC? Le tre misure che rovinerebbero una
    stampa - origine, altezza di contatto, angolo del foglio - sono
    chieste dai popup a ogni stampa su ogni dispositivo, per disegno.
    Quello che cambia e' il profilo macchina, che vive in localStorage
    per dispositivo: un dispositivo nuovo parte dai valori di fabbrica
    della pagina, che sono le misure vere al momento del build. Il
    rischio e' lo scostamento silenzioso, non il vuoto, e il piu'
    insidioso e' l'alzata della penna.
    Scritte due conseguenze: la copia del profilo sulla scheda diventa
    l'ossatura del multi-dispositivo c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
2026-11-13 Documento v100: pacchetto dello strumento e il file di supporto mancante (fronte stampe)
    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
2026-11-13 Documento v101: cosa delle stampe entra nello SLICER, e cosa no
    I motori restano dove sono - Python con numpy e Pillow, contro una
    pagina che gira da file:// e un SAMD21 con 32 kB - e lo esclude gia'
    la decisione dell'8 novembre. Entrano invece i controlli di
    controlla.py (1,8x di sovrapposizione e segmenti sotto 0,15 mm, da
    fare insieme ai riempimenti perche' 1,8x e' la versione misurabile
    del passo del tratteggio), una penna sola per i due, il catalogo
    come cartella di disegni sulla SD e la provenienza che viaggia col
    disegno.
    Scritto anche il collegamento allo strumento in "dove trovare
    disegni", con le tre cose da fare bene: nome suo, indirizzo
    modificabile perche' 127.0.0.1 vuol dire "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
2026-11-13 Documento v102: il tratteggio esiste gia' dall'altra parte
    Lo strumento delle stampe ha un campo "riempimento a tratteggio
    (mm)" e fedele.py l'opzione riempimento: quando lo Step 14 si
    costruisce, il passo deve voler dire la stessa cosa nei due posti,
    se no lo stesso disegno riempito di qua e di la' esce diverso. In
    positivo: il generatore nasce con un riferimento gia' stampato su
    carta e con la soglia 1,8x per dire quando il passo e' troppo
    stretto.
    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
2026-11-13 Ora reale: 15:12
    L'ora l'avevo scritta prima di leggerla, come un'ora fa. Si legge,
    poi si scrive.
    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
2026-11-13 Documento v103: avviare lo strumento no, aprire il risultato si'
    Una pagina web non lancia programmi sul computer: non e' una
    mancanza da aggirare, e' il confine che impedisce a qualunque pagina
    di farlo. Al suo posto: avvio automatico al login, oppure un file da
    doppio clic; e lo SLICER che dice se e' acceso, perche' /api/ping
    esiste gia' e basta l'header CORS.
    "Apri nello SLICER" invece si fa, in due modi piccoli: lo strumento
    spinge con postMessage (e per quel solo collegamento va togliere il
    rel=noopener, che per i siti esterni resta giusto), o lo SLICER tira
    da /api/job/<id>/svg con una riga di Access-Control-Allow-Origin -
    e allora puo' mostrare anche l'elenco degli ultimi lavori.
    Co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
2026-11-13 Documento v104: lo SLICER consegna l'avviatore, il browser lo apre
    Idea dell'utente, e funziona: la pagina non lancia niente, genera un
    file e lo scarica; a eseguirlo e' il comando "apri" del browser,
    cioe' un suo click. E la pagina puo' scriverci dentro il percorso
    giusto, perche' da file:// conosce il proprio indirizzo.
    Con due avvertenze: un .bat e' un eseguibile, quindi il browser
    avvisa; e scaricarlo ogni volta sarebbe peggio di una scorciatoia -
    si prenderebbe l'abitudine di passare sopra agli avvisi sui .bat.
    Quindi si usa una volta, e il posto giusto dove metterlo e' la
    cartella di avvio automatico. Su macOS un .command scaricato arriva
    senza permesso di esecuzione, quindi la' serve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
2026-11-13 Documento v105: Windows, niente avvio automatico, e il muro spostato
    L'utente rifiuta l'avvio al login e propone un pulsante che filtri i
    Download e offra solo l'avviatore. Non si puo': una pagina non puo'
    elencare una cartella, e il selettore di file restituisce il
    contenuto del file, non il potere di eseguirlo - scegliere un .bat
    in una pagina vuol dire leggerlo, non lanciarlo.
    Quello che da' la stessa ergonomia: l'elenco dei download conserva
    la voce, quindi si scarica una volta e poi Ctrl+J piu' un click lo
    avviano. Lo SLICER non puo' portarci da se', perche' le pagine non
    aprono indirizzi chrome://. Con meno click, rinunciando al "tutto
    dallo SLICER": una scorciatoia appuntata sulla ba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
2026-11-13 Documento v106: la strada scelta e i quattro pezzi da costruire
    Approvato il giro dall'utente. Da fare: la voce dello strumento in
    sorgenti.js con indirizzo modificabile e spia, il pulsante che
    consegna l'avviatore col percorso ricavato da location.href, una
    riga di Access-Control-Allow-Origin in strumento.py (serve alla spia
    e al prelievo del risultato) e "Apri nello SLICER" nel riquadro dei
    download.
    Con due dettagli operativi: la finestrella di console deve restare
    aperta e conviene partire ridotta a icona; e se la cartella del
    progetto si sposta l'avviatore va riscaricato, perche' il percorso
    dentro e' scritto una volta.
    Claude-Sess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
2026-11-14 La mira del doppio clic: due difetti, non uno
    «Ogni tanto non prendo la forma», detto dall'utente l'11 novembre.
    Sotto c'erano due cose indipendenti che si sommavano.
    1. LA MIRA GUARDAVA NEL FOGLIO SBAGLIATO. quale() confronta il punto
    col rettangolo di ogni livello, che e' in millimetri del SUO foglio,
    mentre il punto arrivava misurato dall'angolo del foglio in uso. Con
    piu' fogli la mira era spostata della distanza fra i due angoli.
    Adesso la funzione prende millimetri del PIANO e sottrae l'angolo di
    ciascun livello: "che cosa c'e' sotto a questo punto" e' una domanda
    sul piano, non su un foglio.
    2. SU UN FOGLIO LIBERO IL DOPPIO CLIC NON ARRIVAVA AFFATTO. Il primo
    clic lo fa diventare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
2026-11-14 Documento v107: la mira corretta, e due mutazioni che guardavano altrove
    Registrati i due difetti in Sintomo/Causa/Fix e le due precisazioni al
    metodo che sono venute dalle mutazioni non viste: il primo clic di un
    doppio clic cambia lo stato e puo' riparare il difetto che si vuole
    misurare (la scena vuole il foglio del disegno MISURATO, se no il
    clic lo rende quello in uso e i due sistemi tornano a coincidere); e
    una mutazione va puntata sul controllo che puo' vederla.
    Step 14 da "da fare" a in corso: fatto il punto b.
    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
2026-11-14 La spunta dice quando la scelta ricomincia
    Seconda meta' del difetto dell'11 novembre: «ogni tanto deseleziona
    quella precedente e ogni tanto le seleziona entrambe». La regola era
    giusta e resta - due livelli di due fogli diversi non hanno un
    rettangolo in comune, quindi spuntarne uno di un altro foglio fa
    ricominciare la scelta - ma era muta, e una regola muta si legge come
    un capriccio.
    Adesso si vede da due parti. PRIMA del clic: il quadratino di un
    livello che sta su un altro foglio ha il filo tratteggiato e un
    suggerimento che lo dice, e il segno compare solo quando c'e'
    davvero una scelta da far ricominciare. DOPO: il registro scrive
    quale livello, su che foglio, e perche'.
    Due con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
2026-11-14 Documento v108: la spunta che parla, e il difetto dell'11 chiuso
    Registrata la seconda meta' del lavoro: non un difetto ma una regola
    muta da far parlare, con la distinzione che conta - la regola non
    cambia, cambia che adesso si vede, prima del clic e dopo. E quello
    che ho lasciato fuori di proposito: allargare il bersaglio della
    spunta, perche' il reclamo era sulla regola muta e allargare quelle
    icone cambia l'altezza di ogni riga.
    Step 14: fatti i punti b e c, restano i riempimenti e il "si vedra'".
    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
2026-11-14 Documento v109: le due precisazioni salgono nella convenzione
    Stavano solo nella voce di storico, cioe' in un posto che si legge
    quando si cerca quel giorno. La regola "un controllo va provato
    rompendo il codice di proposito" ha il suo blocco in cima alla
    Pipeline, con le altre quattro precisazioni: e' li' che si leggono
    prima di scrivere un controllo nuovo.
    Le due di oggi: un gesto composto puo' riparare il difetto mentre lo
    prova (il primo clic cambia lo stato), e una mutazione va puntata sul
    controllo che PUO' vederla, non su quello che parla della stessa
    cosa - quando non si vede, la prima domanda e' se la scena puo'
    manifestare quel difetto.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
2026-11-14 I numeri di fabbrica si dicono: la pagina distingue il profilo del dispositivo
    Aprendo lo SLICER da un iPad o da un PC nuovo non manca niente di visibile:
    `Profile.load()` fonde localStorage sui valori compilati nel file, quindi i
    campi sono pieni di numeri plausibili -- le misure vere del giorno in cui la
    pagina e' stata costruita. Un profilo vuoto si nota, un profilo di fabbrica
    no. Il numero che fa danno in silenzio e' l'alzata della penna: piu' piccola
    del vero, la punta striscia sul foglio durante gli spostamenti.
    Adesso la pagina distingue i due casi con un dato solo (se in memoria c'era
    un profilo di questo dispositivo) e lo dice con UNA frase, provenienza(),
    mostrata in tre posti: l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
2026-11-14 La fascia scrive in italiano: gli accenti veri, non l'apostrofo
    Il testo della fascia e il titolo della × erano gli unici pezzi visibili
    della pagina scritti con «e'» e «perche'» al posto di «è» e «perché».
    Aggiornata di conseguenza la mutazione che li punta.
    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
2026-11-14 Il piano e la tela si guardano col dito: la pinzata
    Il piano e la tela dell'editor si ingrandivano solo con la rotella, e su un
    tablet la rotella non c'e': dall'iPad un disegno di due millimetri si
    guardava da lontano e basta. La pinzata e' l'unico gesto che su quegli
    schermi vuol dire «avvicina», e non ha alternative da tastiera.
    Sta in un modulo solo (js/tocco.js) perche' i disegni da pinzare sono due e
    l'aritmetica dell'ancoraggio, sbagliata, non si vede subito: si vede che il
    disegno scappa mentre si allargano le dita. Il modulo non sa che cosa sta
    guardando -- chi chiama gli dice come si legge la finestra, come si scrive e
    dove cade un punto dello schermo -- quindi il verso della y,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
2026-11-14 Le proporzioni non stanno piu' solo in un tasto, e le maniglie si prendono
    Trovato dall'utente provando dall'iPad: tenere le proporzioni trascinando un
    angolo del riquadro era affidato SOLO a Shift, e su un tablet quel tasto non
    c'e' -- il disegno si poteva soltanto schiacciare. Adesso c'e' una spunta
    accanto ai campi del livello, e Shift la CAPOVOLGE: il predefinito resta
    «deforma» come prima, chi ha la tastiera non perde niente, e una scelta che
    viveva solo in un tasto diventa visibile anche su un PC.
    Trovato dal banco: col dito la maniglia d'angolo da 9 px non si prende.
    Sotto ognuna c'e' adesso una presa trasparente da 30 px con lo stesso nome
    di maniglia; il quadratino visibile resta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
2026-11-14 Gli ultimi due comandi che vivevano solo in un tasto
    Verificato invece che ricordato, dopo la domanda dell'utente: nella tab
    Disegno Ctrl non si usa MAI (le cinque occorrenze stanno tutte in
    editor.js), e nell'editor Ctrl+Z, Y, X, C, V hanno gia' i loro pulsanti. I
    gesti davvero senza strada su un tablet erano due.
    I MAGNETI FRA I FOGLI si sospendevano solo con Alt tenuto premuto: dall'iPad
    due fogli non accostati non si potevano posare. Adesso c'e' una spunta sotto
    l'elenco dei fogli, accesa di serie, e Alt la capovolge. Vale anche su un
    PC: che i magneti si potessero spegnere lo sapeva solo chi l'aveva letto nel
    codice.
    SOMMARE UN TRATTO ALLA SCELTA voleva Ctrl. Adesso c'e' l'interruttor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
2026-11-14 Il motore dei riempimenti: stampino, regioni, tratteggio, guardiano
    Una penna non riempie: copre, passando tante volte vicino a se stessa.
    js/riempi.js fa le due cose che servono prima di qualunque interfaccia.
    LO STAMPINO disegna i tratti visibili del foglio su una tela fuori schermo a
    0,1 mm/px con gli spessori veri delle penne, ed etichetta tutte le regioni
    in una passata sola. Da li' «che regione c'e' sotto il puntatore» e' una
    lettura e non un calcolo: e' quello che permettera' l'anteprima sotto il
    mouse senza far fatica a ogni movimento. A pixel e non con la geometria
    perche' nei file veri non e' quasi mai chiuso niente: capi che si toccano a
    meno di un centesimo, confini fatti da l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
2026-11-14 I riempimenti si comandano: il puntatore anticipa, il clic disegna
    L'interazione e' quella che l'utente aveva disegnato il 9 novembre.
    Pulsante «Riempi» nella barra dell'editor, finestrella coi parametri che
    resta aperta mentre si mira, il puntatore che anticipa la regione sotto di
    se', il clic che la disegna. Il clic dice la cosa che la geometria non puo'
    sapere: QUALE degli spazi chiusi si intende. Sulla A in grassetto il corpo e
    il triangolo sono due clic.
    Nella finestrella ci sono metri, alzate e minuti PRIMA del clic, e la riga
    che dice che cosa vuol dire quel passo per la penna montata: sotto lo
    spessore del tratto non e' un tratteggio piu' fine, e' una macchia.
    Il riempimento nasc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
